balu-lab/cabs-PETFAB-Hammer-Joshua/CAD/README.md

# CAD

The full arm assembly is in [`Main ASM.step`](Main%20ASM.step), a STEP file that opens in most CAD programs (such as SolidWorks, Fusion and FreeCAD).
