balu-lab/cabs-PETFAB-Hammer-Joshua/Videos/README.md

# Videos

Full-length videos of the PETFAB Armadillo. Each one is also in this folder as a 720p MP4 you can download.

## Arm demo

<!-- VIDEO PLAYER: drag arm-demo.mp4 onto the blank line below, then delete everything from "preview start" to "preview end". -->

https://github.com/user-attachments/assets/7bf4e68b-27bd-4faf-a8a3-bc81803d2f6c

## Range of motion

<!-- VIDEO PLAYER: drag range-of-motion.mp4 onto the blank line below, then delete everything from "preview start" to "preview end". -->

https://github.com/user-attachments/assets/34a5c7e6-6257-4383-8806-d1fb65ef79a6

## Gripper prototype

<!-- VIDEO PLAYER: drag gripper-prototype.mp4 onto the blank line below, then delete everything from "preview start" to "preview end". -->

https://github.com/user-attachments/assets/6db6914c-4f08-4c4b-8c50-9afb5e042890

## Early arm prototype

<!-- VIDEO PLAYER: drag early-arm-prototype.mp4 onto the blank line below, then delete everything from "preview start" to "preview end". -->

https://github.com/user-attachments/assets/643ba2e3-5a8b-48b2-80a3-5e27d1cdb63c
