balu-lab/cabs-PETFAB-Hammer-Joshua/Photos/README.md

# Photos

Pictures of the PETFAB Armadillo: the built arm, its CAD model, early prototypes, and what its camera sees.

## The built arm

<p align="center">
  The Armadillo holding a steel tumbler in its gripper
  Moving the arm by hand to full reach
</p>
<p align="center"><em>Holding a tumbler (left) and reaching out, moved by hand (right)</em></p>

## CAD model

<p align="center">
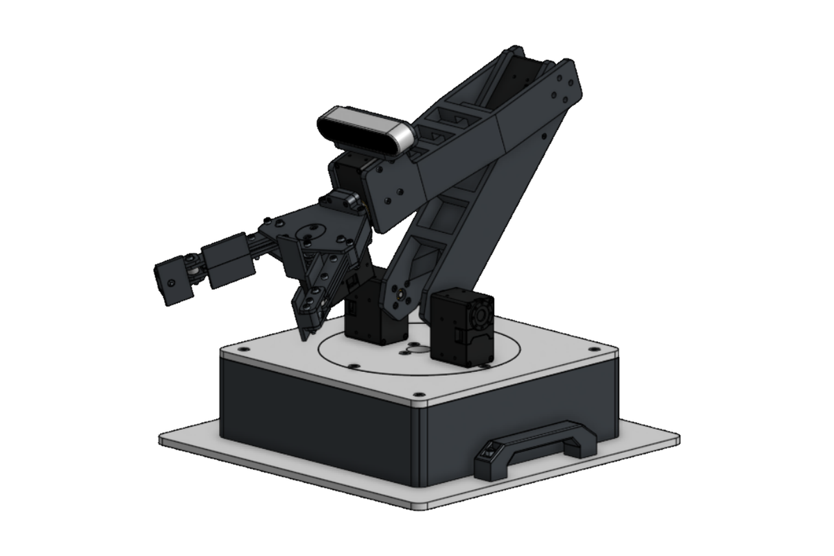
[picture p10: Photos/cad-arm-folded.png]
The complete arm in CAD, folded
  
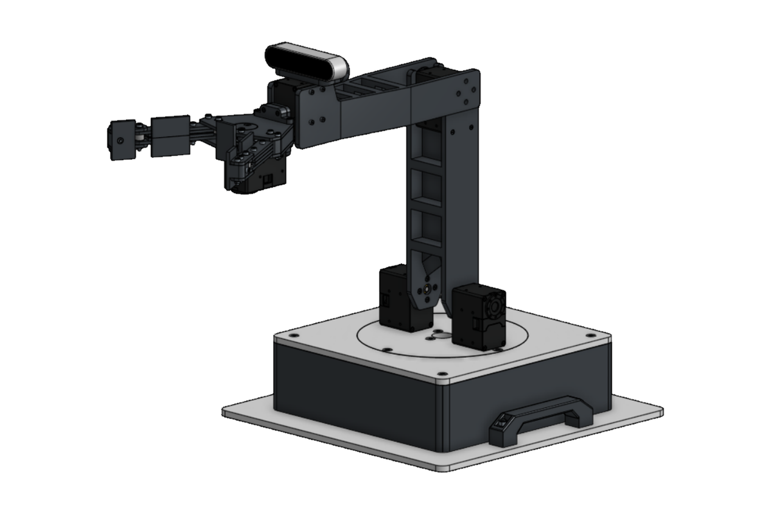
[picture p11: Photos/cad-arm-upright.png]
The complete arm in CAD, upright
  
</p>
<p align="center"><em>The complete arm, folded (left) and upright (right)</em></p>

<p align="center">
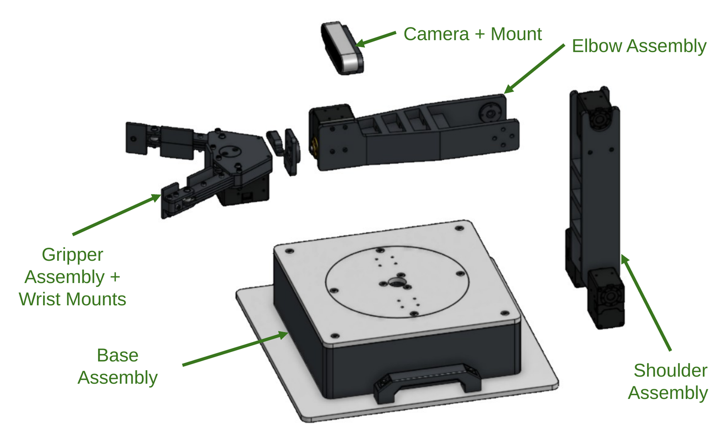
[picture p12: Photos/cad-exploded-view.png]
Exploded view of the arm's main assemblies, labeled
  
</p>
<p align="center"><em>The main assemblies. The <a href="../Assembly%20Instructions/All%20Assembly%20Instructions.pdf">assembly instructions</a> build each one step by step.</em></p>

<p align="center">
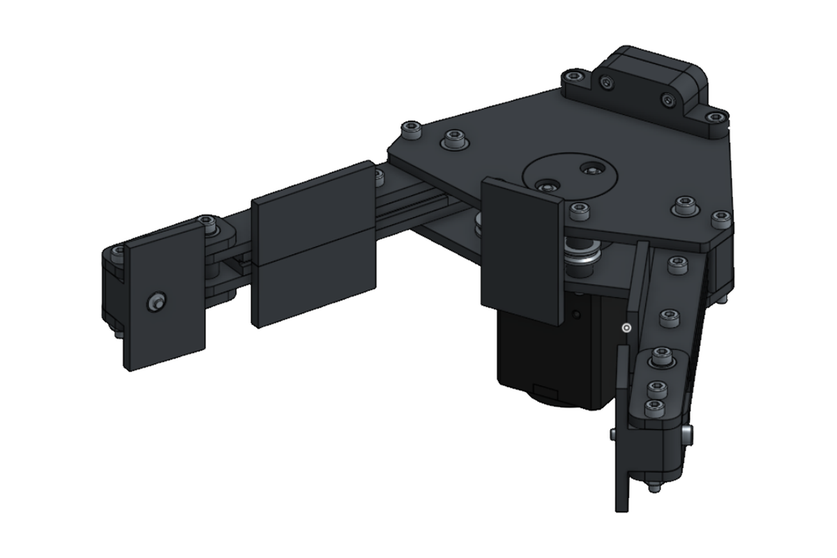
[picture p13: Photos/cad-gripper-view1.png]
The two-finger gripper in CAD, first view
  
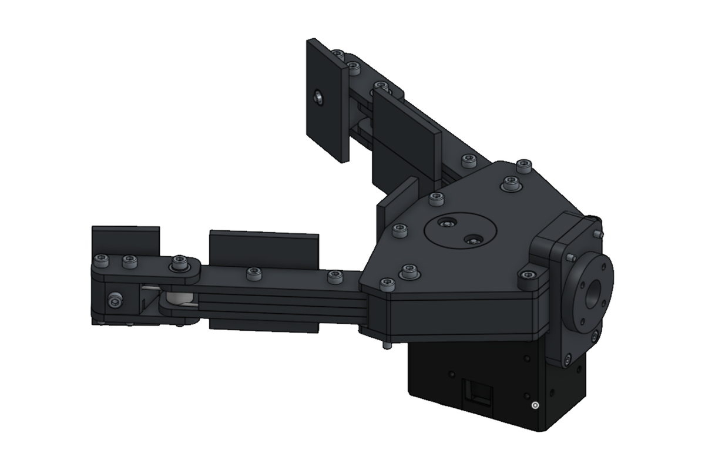
[picture p14: Photos/cad-gripper-view2.png]
The two-finger gripper in CAD, second view
  
</p>
<p align="center"><em>The underactuated two-finger gripper, from two angles</em></p>

## Prototypes

<p align="center">
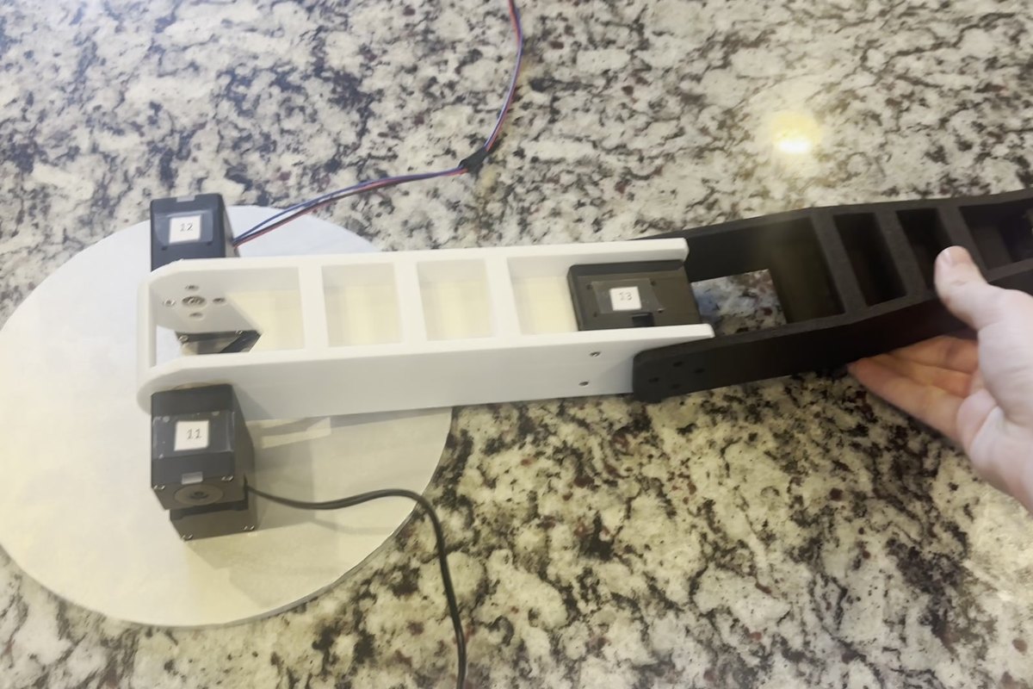
[picture p15: Photos/early-arm-prototype.jpg]
An early version of the arm with white and black printed links
  
  The gripper prototype wrapping around a mug
</p>
<p align="center"><em>An early arm prototype (left) and the gripper prototype grasping a mug (right)</em></p>

## Vision

<p align="center">
  The RealSense camera feed with YOLOv8 detecting a mouse at 0.97 confidence and 0.26 m away
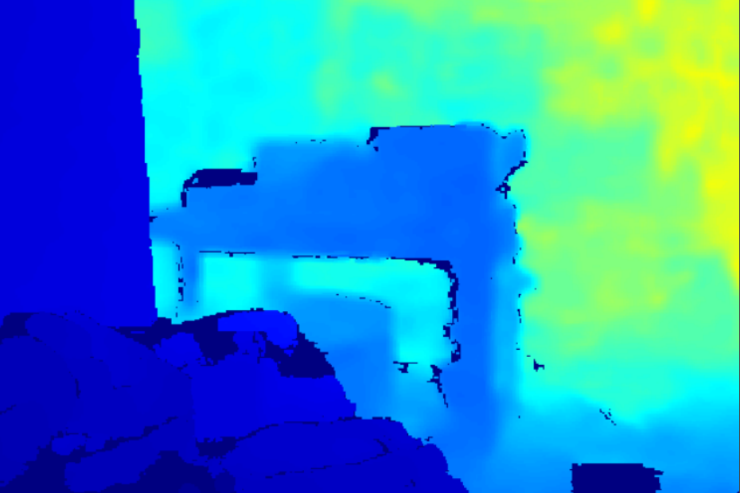
[picture p16: Photos/vision-depth-map.png]
A color-coded depth image from the RealSense camera
  
</p>
<p align="center"><em>YOLOv8 detecting a mouse 0.26 m away (left), from <a href="../Code/vision_object_detection_test.py"><code>vision_object_detection_test.py</code></a>, and a depth image from the same camera, where color shows distance (right)</em></p>
