balu-lab/cabs-PETFAB-Hammer-Joshua/Curriculum/Lesson 1/README.md

# Lesson 1: Introduction to the Robotic Arm

Students learn the parts and vocabulary of a robotic arm, what degrees of freedom are, and how to work safely around the arm. The lesson frames the whole course around three questions: how the arm knows where it is, how it knows where to go, and how it can interact with the world.

**Time:** one class period (about 60 minutes)

## Objectives

By the end of this lesson, students will be able to:

- Identify and describe the core parts of a robotic arm (actuators, links, encoders, grippers, controller, workspace)
- Define degrees of freedom (DOF) and explain why they matter for an arm's range of motion
- Describe the three questions that guide the course
- State the essential safety procedures for operating the arm

## Files

| File | What it is |
|---|---|
| [Lesson Plan 1 - Introduction to the Robotic Arm.docx](Lesson%20Plan%201%20-%20Introduction%20to%20the%20Robotic%20Arm.docx) | Lesson plan with vocabulary, timed procedures and assessment with answers |
| [Intro to Robo Arm.pdf](Intro%20to%20Robo%20Arm.pdf) | Slides (PDF) |
| [Intro to Robo Arm.pptx](Intro%20to%20Robo%20Arm.pptx) | Slides (PowerPoint, editable) |

**Next:** [Lesson 2: Building the Robotic Arm](../Lesson%202/)
