balu-lab/cabs-PETFAB-Hammer-Joshua/Curriculum/Lesson 2/README.md

# Lesson 2: Building the Robotic Arm

Students work in groups to assemble the arm they will use for the rest of the course. They build the links and joints, wire the actuators to the controller, and run a first power-on test to confirm every joint moves. The lesson also covers basic troubleshooting of common assembly mistakes.

**Time:** two class periods (about 60 minutes each)

## Objectives

By the end of this lesson, students will be able to:

- Assemble the arm's mechanical parts (links, joints, mounting hardware) by following a build guide
- Correctly wire the actuators to the controller
- Check that each joint moves correctly with a basic functional test
- Identify and fix common assembly errors (loose connections, reversed wiring, misaligned joints)

## Files

| File | What it is |
|---|---|
| [Lesson Plan 2 - Building the Robotic Arm.pdf](Lesson%20Plan%202%20-%20Building%20the%20Robotic%20Arm.pdf) | Lesson plan with timed procedures for both days and assessment with answers |
| [Lesson Plan 2 - Building the Robotic Arm.docx](Lesson%20Plan%202%20-%20Building%20the%20Robotic%20Arm.docx) | Lesson plan (Word, editable) |
| [All Assembly Instructions.pdf](../../Assembly%20Instructions/All%20Assembly%20Instructions.pdf) | Step-by-step build guide, in the Assembly Instructions folder |
| [Arm BOM.xlsx](../../BOM/Arm%20BOM.xlsx) | Parts each group needs, in the BOM folder |

Before students power on the arm, set up the actuators' IDs and baud rate as described in the main README's [Getting Started](../../README.md#getting-started) section.

**Previous:** [Lesson 1](../Lesson%201/) · **Next:** [Lesson 3: Trigonometric Approach to FK](../Lesson%203/)
