balu-lab/cabs-PETFAB-Hammer-Joshua/PETFAB-Armadillo/CAD/README.md

# CAD

Design source files for the arm will be added here.
