balu-lab/cabs-PETFAB-Hammer-Joshua/PETFAB-Armadillo/Photos/README.md

# Photos

Photos of the assembled arm and demos go here.
