balu-lab/cabs-PETFAB-Hammer-Joshua/Curriculum/Robotic Arm Lessons Overview.docx

# Course Overview: Controlling a 4-Axis Robotic Arm

## Course Description

This course introduces high school students to the mechanical, mathematical, and computational principles behind a 4-DOF robotic arm. Students begin by physically building and understanding the arm, then progress through forward kinematics (FK), inverse kinematics (IK), and computer vision.

The course is structured around three guiding questions, introduced in Lesson 1 and revisited throughout:

1. How does the arm know where it is? (Forward Kinematics)
2. How does the arm know where to go? (Inverse Kinematics)
3. How can the arm interact with the world? (Computer Vision + AI Object Detection)

## Course Structure & Pacing

The course consists of 10 lessons.

| Lesson Title | Short Description
1 | Introduction to the Robotic Arm | Vocabulary, parts, safety, industry context
2 | Building the Robotic Arm | Physical assembly, wiring, functional testing
3 | Trigonometric Approach to FK | Deriving FK for a 4 DOF arm using trig in 2d and 3d
4 | Denavit-Hartenberg Approach to FK | Forward kinematics with vectors: measure joint angles the DH way, write each link as a unit vector, turn arrows to find the forearm, and add the link vectors to find the tip in 2D and 3D.
5 | Code Implementation of FK & Other Methods | Coding forward kinematics in Python one function at a time, checking it against Lesson 3’s method, and mapping the arm’s reach
6 | Trigonometric Approach to IK | Deriving IK using the law of cosines and trigonometry
7 | Gradient Descent Approach to IK | Iterative/numerical IK methods
8 | Code Implementation of IK & Other Methods | Coding IK in Python one function at a time with Lesson 6’s trigonometry and Lesson 7’s gradient descent, checking every answer with FK, and a short preview of the Jacobian
9 | AI Object Detection | Pretrained object detection models, bounding boxes, turning the base toward a target
10 | Stereoscopic Camera | Depth perception via disparity, camera calibration, 3D target points for the arm

## Course-Wide Learning Goals

By the end of the course, students will be able to:

- Explain and apply both trigonometric and systematic (DH) methods for forward kinematics
- Explain and apply both geometric and iterative methods for inverse kinematics
- Implement FK and IK algorithms in code and validate them against hand calculations
- Explain how stereoscopic vision and AI object detection allow a robot to perceive its environment
- Evaluate trade-offs between competing engineering approaches (e.g., DOF, method complexity vs. accessibility, cost vs. precision)

## Standards Alignment (Course-Wide)

This course is primarily an applied engineering/math/CS course. NGSS connections are grouped below by strength Core connections apply clearly across most lessons.

Core NGSS Engineering Design Standards:

- HS-ETS1-1 — Analyze a major global/complex problem by specifying qualitative and quantitative criteria and constraints for successful solutions
- HS-ETS1-2 — Design a solution to a complex real-world problem by breaking it down into smaller, more manageable problems
- HS-ETS1-3 — Evaluate a solution based on prioritized criteria and trade-offs that account for constraints including cost, safety, reliability, and performance
- HS-ETS1-4 — Use a computer simulation/model to model the impact of proposed solutions to a complex real-world problem

Core NGSS Crosscutting Concepts:

- Systems and System Models — the arm treated as an interdependent system throughout (mechanical → mathematical → perceptual)
- Structure and Function — how a component's physical structure (a joint, a link, a gripper's finger geometry) determines what it can do; especially relevant in Lessons 1, 2, and 5
- Patterns — recognizing recurring angle/position relationships in FK/IK (Lessons 3–8) and recurring visual patterns in object detection (Lessons 9–10)

Core NGSS Science & Engineering Practices:

- Developing and Using Models — physical diagrams, mathematical FK/IK models, and code implementations
- Using Mathematics and Computational Thinking — the throughline connecting the trig, DH, and coding lessons
- Constructing Explanations and Designing Solutions — especially prominent in the coding lessons
- Planning and Carrying Out Investigations — the build lesson, calibration steps, and testing/debugging labs throughout
- Analyzing and Interpreting Data — object detection confidence scores, disparity maps, and testing measured vs. predicted arm positions
- Asking Questions and Defining Problems — Lesson 1's framing of the course around three guiding questions
- Engaging in Argument from Evidence — the recurring "compare methods and their trade-offs" discussions (Lessons 4, 5, 7, 8)
- Obtaining, Evaluating, and Communicating Information — the industry survey in Lesson 1

See individual lesson plans for lesson-specific standards citations.

## Materials & Equipment Needed

- One 4-DOF robotic arm kit per group (unassembled, for Lesson 2's build)
- Controller board, servos/actuators, and wiring components
- Computers with Python, numpy, and relevant vision/ML libraries installed
- Stereo camera rig (one per group or shared lab stations)
- Basic tools (screwdrivers/hex keys), measuring tools, calculators
- Target objects for practice

## Assessment Approach

Each lesson includes a short formative assessment (multiple choice, short answer, or exit ticket) tied directly to that lesson's objectives. Lessons involving code (5 and 8) are assessed primarily through working implementations validated against known test cases.

## Course Progression Logic

The course is intentionally sequenced so each new concept has an immediate, concrete anchor:

- Lessons 1–2 ground students physically in the hardware and concepts before any math is introduced
- Lessons 3–5 build FK from simple (trig) to systematic (DH) to implemented (code), with each method validated against the previous
- Lessons 6–8 repeat the same progression in forward kinematics for inverse kinematics
- Lessons 9–10 build the perception pipeline in two pieces (detection → depth)

## Course Prerequisites

- Math 3/Geometry at a high school level (honors level completion recommended)
- Completion of a python course at an intermediate level
