balu-lab/cabs-PETFAB-Hammer-Joshua/Curriculum/Lesson 6/Lesson_6_Trigonometric_Approach_to_IK.pptx

The Trigonometric Approach to Inverse Kinematics

Robotic Arm Course · Lesson 6

Day 1: The flat arm with triangles
Day 2: Adding the base turn (3D)

## Slide 2

Where Lesson 5 left off:

Forward kinematics (FK):
angles in, tip position out.
tip_3d(45, 45, -45)
gives [301.78, 301.78, 176.78]
Today we go the other way.
We know where the tip should go.
We find the angles.

z

(301.78, 301.78, 176.78)

y

x

## Slide 3

Forward vs. inverse kinematics:

Forward kinematics (FK)
angles → tip position
Always exactly one answer.
Lessons 3, 4 and 5.

Inverse kinematics (IK)
tip position → angles
There can be no answer, one or two.
Lessons 6, 7 and 8.

A robot is told a target, like “pick up the cup at (x, y, z)”. Its motors need angles, not positions. IK is the step that turns the target into angles.
Lesson 3 used triangles to go forward. Today we use the same triangles backwards.

## Slide 4

The IK problem (flat arm):

We know:
L1 = L2 = 250 mm
the target (X, Y)
We want:
θS and θE
We solve the flat arm first. On Day 2 we add the base turn.

θE = ?

target (X, Y)

θS = ?

## Slide 5

The law of cosines:

For any triangle with sides a, b and c, where C is the angle opposite side c:
c² = a² + b² − 2ab cos C
Solve it for the angle:
cos C = (a² + b² − c²) ÷ (2ab)
Use it when you know all three sides and want an angle.
If C = 90°, then cos C = 0 and it becomes the Pythagorean theorem: c² = a² + b².

a

c

C

b

## Slide 6

Worked example: the law of cosines

A triangle has a = 250, b = 250 and c = 300.
Find the angle C.
cos C = (250² + 250² − 300²) ÷ (2 × 250 × 250)
= (125,000 − 90,000) ÷ 125,000
= 0.28
C = cos⁻¹(0.28) = 73.74°
cos⁻¹ is the inverse cosine key (also called arccos). Set your calculator to degrees.

250

300

C = ?

250

## Slide 7

Try it yourself #1:

Find the angle C opposite side c. In both triangles a = b = 250.

(a) c = 250

(b) c = 400

c

c

C

C

## Slide 8

Try it yourself #1: solution

Find the angle C opposite side c. In both triangles a = b = 250.

(a) c = 250

(b) c = 400

c

c

C

C

cos C = (125,000 − 62,500) ÷ 125,000
= 0.5
C = cos⁻¹(0.5) = 60°

cos C = (125,000 − 160,000) ÷ 125,000
= −0.28
C = cos⁻¹(−0.28) = 106.26°

A negative cosine means the angle is bigger than 90°.

## Slide 9

The arm makes a triangle:

Draw a straight line D from the shoulder to the target.
The two links and D make a triangle. We know all three sides:
L1 = 250 and L2 = 250
D = √(X² + Y²) (Pythagorean theorem)
So the law of cosines can find the angles of this triangle. They give us the joint angles.

L2

target (X, Y)

L1

D

Y

X

## Slide 10

Step 1: the elbow angle θE

The law of cosines gives γ, the angle inside the triangle at the elbow:
cos γ = (L1² + L2² − D²) ÷ (2 L1 L2)
θE is the bend away from a straight arm, so its size is 180° − γ. Because cos(180° − γ) = −cos γ:
cos θE = (D² − L1² − L2²) ÷ (2 L1 L2)
Check: a straight arm has D = 500, so cos θE = 1 and θE = 0°.
Our forearm bends down (elbow up), so θE is negative.

θE

γ

D

## Slide 11

Worked example: the elbow

Target (X, Y) = (426.78, 176.78), the tip from Lesson 4.
D² = 426.78² + 176.78² = 213,392
(so D = 461.94)
cos θE = (213,392 − 62,500 − 62,500) ÷ 125,000
= 0.7071
cos⁻¹(0.7071) = 45°. Elbow up, so θE = −45°

θE = −45°

D = 461.94

## Slide 12

Step 2: the shoulder angle θS

θS is measured from the floor. It is made of two angles.
φ is the tilt of the line D:
φ = tan⁻¹(Y ÷ X)
δ is the angle between D and the upper arm (the law of cosines again):
cos δ = (L1² + D² − L2²) ÷ (2 L1 D)
Our arm has L1 = L2, so this is just cos δ = D ÷ 500.
Elbow up: the upper arm is above D, so θS = φ + δ

δ

D

φ

## Slide 13

Worked example: the shoulder

Same target (426.78, 176.78), with D = 461.94.
φ = tan⁻¹(176.78 ÷ 426.78) = 22.5°
cos δ = (62,500 + 213,392 − 62,500) ÷ (2 × 250 × 461.94)
= 213,392 ÷ 230,970 = 0.9239
(the same as 461.94 ÷ 500)
δ = cos⁻¹(0.9239) = 22.5°
θS = 22.5° + 22.5° = 45°

δ

φ

## Slide 14

The answer:

IK found θS = 45° and θE = −45°.
These are the angles Lesson 4 started with.
Check with FK (Lesson 5):

Step | Value
D | 461.94
cos θE | 0.7071
θE | −45°
φ | 22.5°
δ | 22.5°
θS | 45°

show(flat_tip(45, -45))

[426.78, 176.78]

FK lands back on the target, so the angles are right.

## Slide 15

Try it yourself #2:

Find θS and θE (elbow up) for the target (341.51, 341.51). L1 = L2 = 250 mm.

## Slide 16

Try it yourself #2: solution

Find θS and θE (elbow up) for the target (341.51, 341.51). L1 = L2 = 250 mm.

D² = 341.51² + 341.51² = 233,258 (D = 482.97)
cos θE = (233,258 − 125,000) ÷ 125,000 = 0.8661
→ θE = −30°
φ = tan⁻¹(341.51 ÷ 341.51) = 45°
cos δ = 482.97 ÷ 500 = 0.9659 → δ = 15°
→ θS = 45° + 15° = 60°

This is Lesson 4’s Try it yourself #2 run backwards. Check: flat_tip(60, -30) gives [341.51, 341.51].

## Slide 17

Try it yourself #3:

Find θS and θE (elbow up) for the target (250, 250). L1 = L2 = 250 mm.

## Slide 18

Try it yourself #3: solution

Find θS and θE (elbow up) for the target (250, 250). L1 = L2 = 250 mm.

D² = 250² + 250² = 125,000 (D = 353.55)
cos θE = (125,000 − 125,000) ÷ 125,000 = 0
→ θE = −90°
φ = tan⁻¹(250 ÷ 250) = 45°
cos δ = 353.55 ÷ 500 = 0.7071 → δ = 45°
→ θS = 45° + 45° = 90°

The upper arm points straight up and the forearm points straight across. Check: flat_tip(90, -90) gives [250.0, 250.0].

## Slide 19

Elbow up or elbow down:

cos⁻¹ only gives a positive angle (here 45°). We choose the sign of θE.
Elbow up: θE = −45° and θS = φ + δ = 45°
Elbow down: θE = +45° and θS = φ − δ = 0°
Both put the tip on (426.78, 176.78).
In this course we use elbow up. Check the real arm’s joint limits before you use elbow down.

elbow up

elbow down

## Slide 20

Can the arm reach it?

A triangle can only close if D ≤ L1 + L2 = 500 mm.
If D is bigger, cos θE comes out bigger than 1, and cos⁻¹ gives an error. No angle has a cosine bigger than 1.
So always check cos θE first:
between −1 and 1: the target is reachable.
anything else: the target is out of reach, and the robot must not move.

500 mm

too far

reachable

## Slide 21

Day 1 recap:

1. Triangle: the two links and the line D, with D = √(X² + Y²).
2. Elbow: cos θE = (D² − L1² − L2²) ÷ (2 L1 L2). Elbow up, so θE is negative.
3. Shoulder: θS = φ + δ, with φ = tan⁻¹(Y ÷ X) and cos δ = (L1² + D² − L2²) ÷ (2 L1 D).
4. Checks: cos θE must be between −1 and 1. Then check the answer with FK.
Tomorrow the base turns too, so we need 3D.

## Slide 22

Day 2: where Day 1 left off

1. What is θE for a straight arm?
2. What is the largest D the arm can reach?
3. What is the sign of θE for elbow up?

D

## Slide 23

Step 1: the base aims the arm

Look from above. The base turns until the arm points at the target’s (x, y) spot.
In Lesson 4: x = R cos θB and y = R sin θB.
Divide: y ÷ x = tan θB, so
θB = tan⁻¹(y ÷ x)
Target (301.78, 301.78, 176.78):
θB = tan⁻¹(301.78 ÷ 301.78) = tan⁻¹(1) = 45°
Careful: plain tan⁻¹ can point the wrong way. See “Why atan2?”.

y

top view

y

R

θB

x

x

## Slide 24

Step 2: flatten 3D into 2D

The arm always stays in one upright plane: the plane the base points at.
Measure the target inside that plane:
how far out: R = √(x² + y²)
how high: z
Then (R, z) plays the role of (X, Y) from Day 1. The elbow and shoulder steps do not change.

z

z

y

x

R

## Slide 25

Why atan2?

Try the spot (x, y) = (−125, 216.51).
tan⁻¹(216.51 ÷ −125) = tan⁻¹(−1.732) = −60°.
That points the wrong way!
y ÷ x is the same for (−125, 216.51) and (125, −216.51), so tan⁻¹ cannot tell them apart.
atan2(y, x) looks at the signs of both y and x, so it picks the right one:
atan2(216.51, −125) = 120°
In Python: math.degrees(math.atan2(y, x))

(−125, 216.51)

y

120°

x

−60° (wrong)

## Slide 26

The full recipe:

1. Aim the base: θB = atan2(y, x)
2. Flatten: R = √(x² + y²), then D² = R² + z²
3. Elbow: cos θE = (D² − L1² − L2²) ÷ (2 L1 L2)
Check that cos θE is between −1 and 1. Elbow up, so θE is negative.
4. Shoulder: φ = tan⁻¹(z ÷ R) and cos δ = (L1² + D² − L2²) ÷ (2 L1 D)
θS = φ + δ
Four steps, a few formulas, and an exact answer. No guessing.

## Slide 27

Worked example:

Find θB, θS and θE for the target (301.78, 301.78, 176.78), the tip from Lesson 4.
1. θB = atan2(301.78, 301.78) = 45°
2. R = √(301.78² + 301.78²) = 426.78
z = 176.78
Now it is the flat arm with target (426.78, 176.78): Day 1’s worked example!
3. θE = −45°
4. θS = 45°

z

θB

z

y

x

R

## Slide 28

Check it with FK:

target
(301.78, 301.78, 176.78)

IK
θB, θS, θE = 45°, 45°, −45°

FK
(301.78, 301.78, 176.78)

Put the IK angles back into FK. If the tip lands on the target, the angles are right.
Three ways to do FK:
1. Lesson 4’s link table, by hand.
2. The Desmos graph from Lesson 4: u = 45, v = 45, w = −45 gives d = (3.0178, 3.0178, 1.7678), so (301.78, 301.78, 176.78) mm.
3. Lesson 5’s code: show(tip_3d(45, 45, -45)) prints [301.78, 301.78, 176.78].
Make it a habit: always check IK with FK.

## Slide 29

Try it yourself #4:

Find θB, θS and θE (elbow up) for the target (295.75, 170.75, 91.51).

Use the four-step recipe. Hint: this tip came from Lesson 4’s Try it yourself #5.

## Slide 30

Try it yourself #4: solution

Find θB, θS and θE (elbow up) for the target (295.75, 170.75, 91.51).

1. θB = atan2(170.75, 295.75) = 30°
2. R = √(295.75² + 170.75²) = 341.50 and z = 91.51
D² = 341.50² + 91.51² ≈ 125,000 (D = 353.55)
3. cos θE = (125,000 − 125,000) ÷ 125,000 = 0 → θE = −90°
4. φ = tan⁻¹(91.51 ÷ 341.50) = 15°, cos δ = 353.55 ÷ 500 = 0.7071 → δ = 45°
→ θS = 15° + 45° = 60°

Lesson 4’s Try it yourself #5 run backwards: (30°, 60°, −90°). Check: show(tip_3d(30, 60, -90)) gives [295.75, 170.75, 91.51].

## Slide 31

Try it yourself #5:

Find θB, θS and θE (elbow up) for the target (−324.76, 187.50, 216.51).

Careful with θB: x is negative.

## Slide 32

Try it yourself #5: solution

Find θB, θS and θE (elbow up) for the target (−324.76, 187.50, 216.51).

1. θB = atan2(187.50, −324.76) = 150° (plain tan⁻¹ says −30°)
2. R = √(324.76² + 187.50²) = 375.00 and z = 216.51
D² = 375.00² + 216.51² = 187,502 (D = 433.01)
3. cos θE = (187,502 − 125,000) ÷ 125,000 = 0.5 → θE = −60°
4. φ = tan⁻¹(216.51 ÷ 375.00) = 30°, cos δ = 433.01 ÷ 500 = 0.8660 → δ = 30°
→ θS = 30° + 30° = 60°

Check: show(tip_3d(150, 60, -60)) gives [-324.76, 187.5, 216.51].

## Slide 33

Try it yourself #6: can the arm reach it?

Find D = √(x² + y² + z²) for each target and compare it with 500 mm.
(a) (200, 200, 200) (b) (400, 300, 200)

## Slide 34

Try it yourself #6: solution

Find D = √(x² + y² + z²) for each target and compare it with 500 mm.
(a) (200, 200, 200) (b) (400, 300, 200)

(a) D = √(40,000 + 40,000 + 40,000) = 346.41 mm. Less than 500: reachable.
(cos θE = −0.04)
(b) D = √(160,000 + 90,000 + 40,000) = 538.52 mm. More than 500: out of reach.
cos θE = 1.32, which is impossible.
For (b) the robot should report an error instead of moving.

## Slide 35

When IK gets tricky:

Case | Answers | Why
D > 500 mm | none | the triangle cannot close
D = 500 mm | one | the arm is fully straight, θE = 0°
D < 500 mm | two | elbow up or elbow down
x = y = 0 | infinitely many | the target is right above the base, so any θB works

FK always gives exactly one answer. IK can give none, one, two or infinitely many.
Near full reach, rounding matters: (433.01, 250.00) is really a straight arm, but the rounded numbers give θE = −0.35°, not 0°. If rounding pushes the cosine just above 1 (like 1.001), treat it as 1. The arm is straight, not out of reach.

## Slide 36

Trigonometry for IK: pros and cons

Pros
+ An exact answer from a few formulas
+ Fast: nothing repeats
+ Easy to check with FK

Cons
− New triangles for every new joint
− Special cases: quadrants, reach, two answers
− Only works if the arm can be drawn as triangles

If the arm had six joints, which method would you use for IK? Why?
Trigonometry is a great fit for our arm. Bigger arms need a method that does not depend on drawing triangles.

## Slide 37

What we learned:

1. IK goes from a target to the joint angles. It can have no answer, one or two.
2. The arm makes a triangle, so the law of cosines gives θE and δ.
3. θB = atan2(y, x), and R = √(x² + y²) flattens 3D into 2D.
4. θS = φ + δ (elbow up). Always check the answer with FK.
Next time (Lesson 7): gradient descent, a method that works for any arm. It guesses, measures the error and improves.
