balu-lab/cabs-PETFAB-Hammer-Joshua/Curriculum/Lesson 4/Updated_Lesson_4_Vector_Approach_to_FK.pptx

The DH Approach to Forward Kinematics

Robotic Arm Course · Lesson 4 of 10

Day 1: The flat arm with vectors
Day 2: Adding the base turn (3D)

## Slide 2

Where Lesson 3 left off:

L1=250mm
L2=250mm
θ1=45°
θ2=45°

In Lesson 3 we used triangles to find the tip of the arm: (X, Y) = (426.78, 176.78).
Today we get the same answer with vectors. We also measure the angles the way engineers do. This is called the DH convention.

tip (X, Y)

(0, 0)

## Slide 3

What is a vector?

A vector is an arrow.
It has a length and a direction.
We write a vector as numbers.
(3, 4) means 3 across and 4 up.

length = √(3² + 4²) = 5

3 across

(3, 4)

4 up

## Slide 4

Adding vectors:

Walk (3, 4).
Then walk (2, −1).
You end up at the sum:
(3, 4) + (2, −1) = (5, 3)
Add the first numbers. Then add the second numbers.
Multiply by a number:
2 × (3, 4) = (6, 8)
Same direction, twice as long.

(2, −1)

(3, 4)

(5, 3)

## Slide 5

Measuring angles the DH way:

Each angle is measured from the link before it.
Up (counterclockwise) is +.
Down (clockwise) is −.
θS: the upper arm, measured from the floor.
θE: the forearm, measured from the line of the upper arm (dashed).
Our arm: θS = 45° and θE = −45°

θE = −45°

θS = 45°

From Lesson 3: θS = 90° − θ1, θE = −θ2, θB = θ3

## Slide 6

An arrow for each link:

A unit vector is an arrow with length 1.
At angle θ from the floor, it is
(cos θ, sin θ)
Multiply it by the link length L to get the link vector.
Upper arm, θS = 45°:
250 × (0.7071, 0.7071)
= (176.78, 176.78)

(cos θ, sin θ)

1

θ

sin θ

cos θ

## Slide 7

Try it yourself #1: find the link vector.

1. L=250mm
θ=30°

2. L=250mm
θ=90°

θ is measured from the floor.

(?, ?)

(?, ?)

θ=90°

θ=30°

1

2

## Slide 8

Try it yourself #1: solution

1. L=250mm
θ=30°

2. L=250mm
θ=90°

(0.00, 250.00)

(216.51, 125.00)

Solution:

1. 250 × (cos 30°, sin 30°)
2. 250 × (cos 90°, sin 90°)

θ=90°

θ=30°

1

2

## Slide 9

Turning an arrow 90°:

To turn an arrow 90° counterclockwise, swap the two numbers. Then change the sign of the first one.
(x, y) → (−y, x)
Example: (3, 4) → (−4, 3)
The upper arm: e = (0.7071, 0.7071)
turns into n = (−0.7071, 0.7071)
e and n are at right angles. Together they are the upper arm’s frame.

(3, 4)

(−4, 3)

## Slide 10

Finding the forearm’s arrow:

y

On the unit circle, an arrow at angle θ is:
cos θ along x, then sin θ along y.
The forearm’s angle θE is measured from the upper arm, not from the floor. So at the elbow, tilt the axes:
e (along the upper arm) is the new x
n (e turned 90°) is the new y
Use the same rule on the tilted axes:
f = cos θE · e + sin θE · n
cos θE along e, then sin θE along n.

The unit circle

cos θ

sin θ

θ

x

n

f

e

θE

At the elbow: tilted with the upper arm

## Slide 11

The forearm turns from the upper arm:

f is the forearm’s arrow.
It is e turned by θE:
f = cos θE · e + sin θE · n
θE = 0°: f = e (no turn)
θE = 90°: f = n (a quarter turn up)
θE = −90°: f = −n (a quarter turn down)
The forearm only needs the upper arm’s frame. That is the DH idea.

n

e

θE = −45°

f

## Slide 12

Worked example: the forearm’s arrow

θS = 45° and θE = −45°
e = (cos 45°, sin 45°) = (0.7071, 0.7071)
n = (−0.7071, 0.7071)
cos(−45°) = 0.7071 and sin(−45°) = −0.7071
f = 0.7071 × (0.7071, 0.7071) + (−0.7071) × (−0.7071, 0.7071)
= (0.5000, 0.5000) + (0.5000, −0.5000)
= (1.0000, 0.0000)
The forearm is flat. Check: 45° + (−45°) = 0° from the floor.

n

e

f

0.7071 along e, then 0.7071 away from n

## Slide 13

Two vectors, one tip:

Upper arm:
a = 250 × e = (176.78, 176.78)
Forearm:
b = 250 × f = (250.00, 0.00)
Put the arrows end to end:
a + b = (426.78, 176.78)
The same answer as Lesson 3.

b

a

a + b

## Slide 14

The link table:

Link | L (mm) | angle | arrow | vector = L × arrow
Upper arm (e) | 250 | θS = 45° | (0.7071, 0.7071) | (176.78, 176.78)
Turned 90° (n) | | | (−0.7071, 0.7071) | —
Forearm (f) | 250 | θE = −45° | (1.0000, 0.0000) | (250.00, 0.00)
Tip (add) | | | | (426.78, 176.78)

e = (cos θS, sin θS) n = (−sin θS, cos θS) f = cos θE · e + sin θE · n
Keep all the digits in your calculator. Round only at the end.

## Slide 15

Try it yourself #2:

L1 = L2 = 250mm θS = 60° θE = −30°

Link | L (mm) | angle | arrow | vector = L × arrow
Upper arm (e) | 250
Turned 90° (n) | | | | —
Forearm (f) | 250
Tip (add)

(X, Y) = (?, ?)

Fill in the table, one row at a time.

In Lesson 3 this arm was θ1 = 30° and θ2 = 30°.

## Slide 16

Try it yourself #2: solution

L1 = L2 = 250mm θS = 60° θE = −30°

Link | L (mm) | angle | arrow | vector = L × arrow
Upper arm (e) | 250 | θS = 60° | (0.5000, 0.8660) | (125.00, 216.51)
Turned 90° (n) | | | (−0.8660, 0.5000) | —
Forearm (f) | 250 | θE = −30° | (0.8660, 0.5000) | (216.51, 125.00)
Tip (add) | | | | (341.51, 341.51)

(X, Y) = (341.51, 341.51)

f = cos(−30°) e + sin(−30°) n
= 0.8660 e − 0.5000 n

In Lesson 3 this arm was θ1 = 30° and θ2 = 30°.

## Slide 17

Try it yourself #3:

L1 = L2 = 250mm θS = 30° θE = 0°

Link | L (mm) | angle | arrow | vector = L × arrow
Upper arm (e) | 250
Turned 90° (n) | | | | —
Forearm (f) | 250
Tip (add)

(X, Y) = (?, ?)

Fill in the table, one row at a time.
Use the rules on the link table slide.

In Lesson 3 this arm was θ1 = 60° and θ2 = 0°.

## Slide 18

Try it yourself #3: solution

L1 = L2 = 250mm θS = 30° θE = 0°

Link | L (mm) | angle | arrow | vector = L × arrow
Upper arm (e) | 250 | θS = 30° | (0.8660, 0.5000) | (216.51, 125.00)
Turned 90° (n) | | | (−0.5000, 0.8660) | —
Forearm (f) | 250 | θE = 0° | (0.8660, 0.5000) | (216.51, 125.00)
Tip (add) | | | | (433.01, 250.00)

(X, Y) = (433.01, 250.00)

θE = 0°, so f = e.
The arm is straight.

In Lesson 3 this arm was θ1 = 60° and θ2 = 0°.

## Slide 19

Day 1 recap:

Each angle is measured from the link before it. Up is +. Down is −.
A link’s arrow: (cos θ, sin θ)
Turn 90°: (x, y) → (−y, x)
The forearm’s arrow: f = cos θE · e + sin θE · n
The tip is the sum of the link vectors.

b

a

## Slide 20

Day 2

On Day 1 the tip was (across, up). For our arm it was (426.78, 176.78).
Today the base turns, so “across” can point any way on the floor. We give the two numbers new names:
the reach, R = 426.78 (along the floor)
the height, z = 176.78 (up)
From now on, up is z, like in Desmos. (Lesson 3 called it Y.)

z

tip

z

R

y

x

## Slide 21

The base turns the whole arm:

The base turns the arm by θB.
The arm’s shadow on the floor is the reach, R.
Split the shadow along x and y:
x = R cos θB
y = R sin θB
The height z does not change.

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
## Slide 22

The upper arm’s arrow in 3D:

Step 1. From the side, e looks like Day 1: length 1, at angle θS.
along the floor: cos θS
up: sin θS
Step 2. From above, the floor part points at angle θB. Split it like R on the last slide:
x = cos θS cos θB
y = cos θS sin θB
Step 3. Turning the base does not change the height:
z = sin θS

So e = (cos θS cos θB, cos θS sin θB, sin θS)
In the Desmos graph, e is (a, b, c).

z

θS

cos θS

e

sin θS

θB

y

x

## Slide 23

The turned arrow in 3D:

Step 1. From the side, turn e by 90° with the Day 1 rule (x, y) → (−y, x):
(cos θS, sin θS) → (−sin θS, cos θS)
So n goes −sin θS along the floor (back toward the base) and cos θS up.
Step 2. From above, split the floor part with θB, the same as for e:
x = −sin θS cos θB
y = −sin θS sin θB
Step 3. The up part stays:
z = cos θS

So n = (−sin θS cos θB, −sin θS sin θB, cos θS)
Check: it is e with θS + 90° in place of θS.

z

n

e

θS

x

y

e, n and the elbow’s axle make the upper arm’s frame.

## Slide 24

The forearm and the tip in 3D:

The same rules as Day 1:
f = cos θE · e + sin θE · n
tip = L1 e + L2 f
The base angle is already inside e and n. So we do not need a new rule.

z

n

e

tip

f

y

x

## Slide 25

Worked example: set up

L1 = L2 = 250mm θB = 45° θS = 45° θE = −45°

Link | L (mm) | angle | arrow (x, y, z) | vector (x, y, z)
Upper arm (e) | 250 | θS = 45° | (0.5000, 0.5000, 0.7071) | (125.00, 125.00, 176.78)
Turned 90° (n) | | | (−0.5000, −0.5000, 0.7071) | —
Forearm (f) | 250 | θE = −45°
Tip (add)

e = (cos 45° cos 45°, cos 45° sin 45°, sin 45°) = (0.5000, 0.5000, 0.7071)
n = (−sin 45° cos 45°, −sin 45° sin 45°, cos 45°) = (−0.5000, −0.5000, 0.7071)
Upper arm vector = 250 × e = (125.00, 125.00, 176.78)

## Slide 26

Worked example: adding up

L1 = L2 = 250mm θB = 45° θS = 45° θE = −45°

Link | L (mm) | angle | arrow (x, y, z) | vector (x, y, z)
Upper arm (e) | 250 | θS = 45° | (0.5000, 0.5000, 0.7071) | (125.00, 125.00, 176.78)
Turned 90° (n) | | | (−0.5000, −0.5000, 0.7071) | —
Forearm (f) | 250 | θE = −45° | (0.7071, 0.7071, 0.0000) | (176.78, 176.78, 0.00)
Tip (add) | | | | (301.78, 301.78, 176.78)

f = cos(−45°) e + sin(−45°) n = 0.7071 e − 0.7071 n
= (0.3536, 0.3536, 0.5000) + (0.3536, 0.3536, −0.5000) = (0.7071, 0.7071, 0.0000)
Forearm vector = 250 × f = (176.78, 176.78, 0.00)
Tip: add the vector column. (301.78, 301.78, 176.78)

## Slide 27

Try it yourself #4:

L1 = L2 = 250mm θB = 30° θS = 30° θE = 0°

Link | L (mm) | angle | arrow (x, y, z) | vector (x, y, z)
Upper arm (e) | 250
Turned 90° (n) | | | | —
Forearm (f) | 250
Tip (add)

(x, y, z) = (?, ?, ?)

Fill in the table, one row at a time.

In Lesson 3 this arm was θ1 = 60°, θ2 = 0°, θ3 = 30°.

## Slide 28

Try it yourself #4: solution

L1 = L2 = 250mm θB = 30° θS = 30° θE = 0°

Link | L (mm) | angle | arrow (x, y, z) | vector (x, y, z)
Upper arm (e) | 250 | θS = 30° | (0.7500, 0.4330, 0.5000) | (187.50, 108.25, 125.00)
Turned 90° (n) | | | (−0.4330, −0.2500, 0.8660) | —
Forearm (f) | 250 | θE = 0° | (0.7500, 0.4330, 0.5000) | (187.50, 108.25, 125.00)
Tip (add) | | | | (375.00, 216.51, 250.00)

(x, y, z) = (375.00, 216.51, 250.00)

θE = 0°, so f = e. The arm is straight.

In Lesson 3 this arm was θ1 = 60°, θ2 = 0°, θ3 = 30°.

## Slide 29

Try it yourself #5:

L1 = L2 = 250mm θB = 30° θS = 60° θE = −90°

Link | L (mm) | angle | arrow (x, y, z) | vector (x, y, z)
Upper arm (e) | 250
Turned 90° (n) | | | | —
Forearm (f) | 250
Tip (add)

(x, y, z) = (?, ?, ?)

Fill in the table, one row at a time.

This is Practice Problem 2 from Lesson 3: θ1 = 30°, θ2 = 90°, θ3 = 30°.

## Slide 30

Try it yourself #5: solution

L1 = L2 = 250mm θB = 30° θS = 60° θE = −90°

Link | L (mm) | angle | arrow (x, y, z) | vector (x, y, z)
Upper arm (e) | 250 | θS = 60° | (0.4330, 0.2500, 0.8660) | (108.25, 62.50, 216.51)
Turned 90° (n) | | | (−0.7500, −0.4330, 0.5000) | —
Forearm (f) | 250 | θE = −90° | (0.7500, 0.4330, −0.5000) | (187.50, 108.25, −125.00)
Tip (add) | | | | (295.75, 170.75, 91.51)

(x, y, z) = (295.75, 170.75, 91.51)

θE = −90°, so f = −n. The forearm points down: 60° − 90° = −30° from the floor.
Lesson 3 wrote the answer as (X, Y, Z) = (295.75, 91.51, 170.75), with Y up.

This is Practice Problem 2 from Lesson 3: θ1 = 30°, θ2 = 90°, θ3 = 30°.

## Slide 31

Check it in Desmos:

1. Open the Desmos graph (link below).
2. Type the angles into u, v and w.
3. Read d, then multiply it by 100 to get mm.
(The graph uses 2.5 for 250mm.)
4. Worked example: d = (3.0178, 3.0178, 1.7678)
→ (301.78, 301.78, 176.78)
5. Check Try it yourself #4 and #5.
6. To see the frames, click the gray circles
in the Vectors folder.

https://www.desmos.com/3d/qq1w1zrs78

u = θB (base)
v = θS (shoulder)
w = θE (elbow)
All in degrees.
v must be less than 90°.

## Slide 32

What the graph does:

In the graph | In our steps
a = cos(v) cos(u), b = cos(v) sin(u), c = sin(v) | (a, b, c) is e, the upper arm’s arrow
(−ac, −bc, a² + b²) ÷ √(1 − c²) | n, the turned arrow
cos(w) (a, b, c) + sin(w) × that arrow | f, the forearm’s arrow
d = 2.5 × (forearm arrow) + 2.5 (a, b, c) | tip = L1 e + L2 f, in hundreds of mm
(b, −a, 0) ÷ √(1 − c²) (hidden) | the elbow’s axle

Each link is one vector, and each joint is measured from the link before it.

## Slide 33

What we learned:

Each joint angle is measured from the link before it.
A link’s arrow is (cos θ, sin θ). In 3D it is (cos θS cos θB, cos θS sin θB, sin θS).
To turn an arrow by θE: cos θE · e + sin θE · n
The tip is the sum of the link vectors: L1 e + L2 f
The Desmos graph does the same steps.
Next lesson: we write these steps as a Python program.
