balu-lab/cabs-PETFAB-Hammer-Joshua/Curriculum/Lesson 3/Trigonometry FK.pptx

## The Trigonometric Approach to Forward Kinematics

By Joseph Ruhan

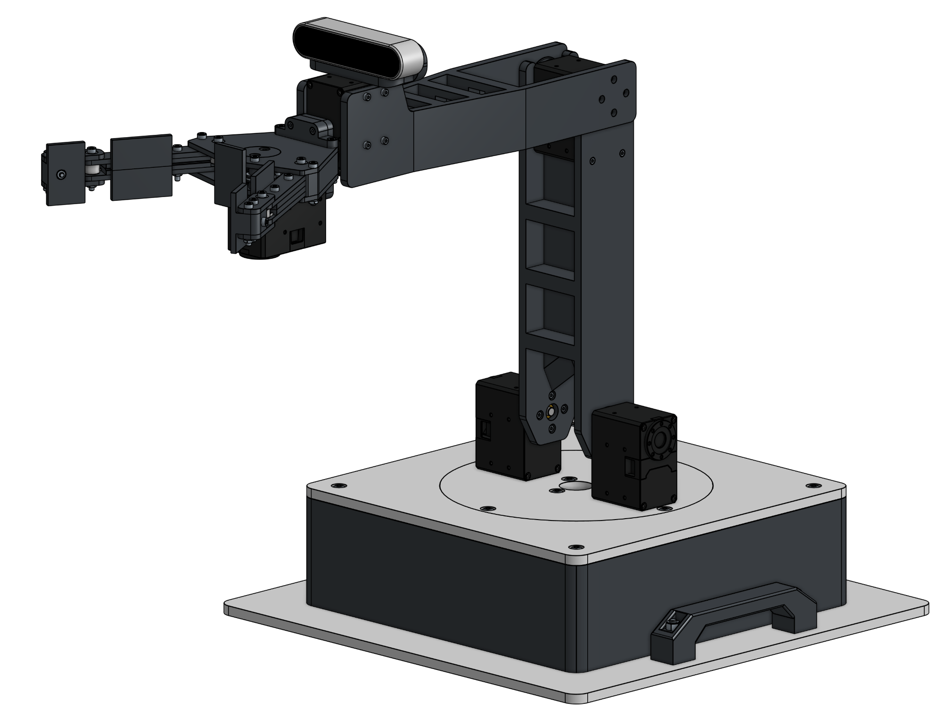
[picture p19: figure]
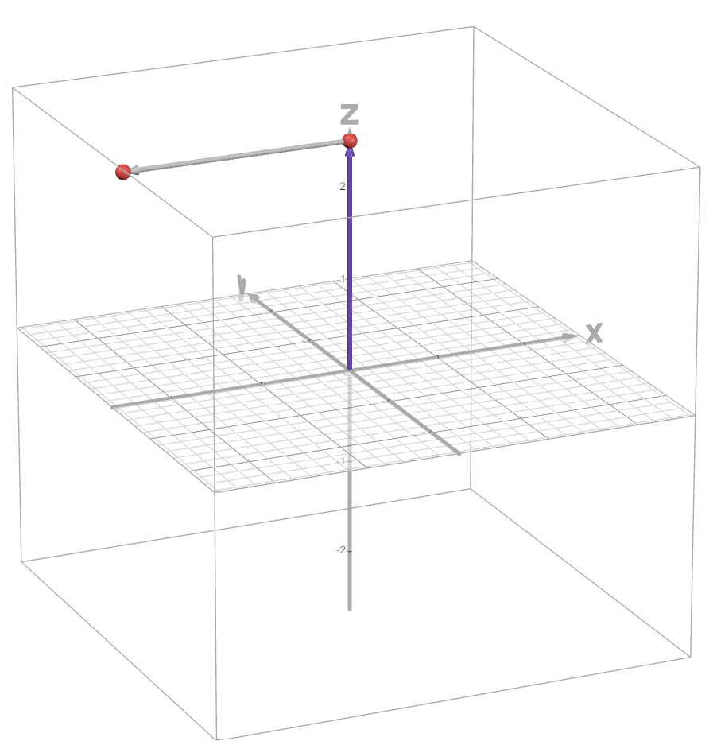
[picture p20: figure]

## Slide 2

The arm can be described mathematically by defining its joints and links

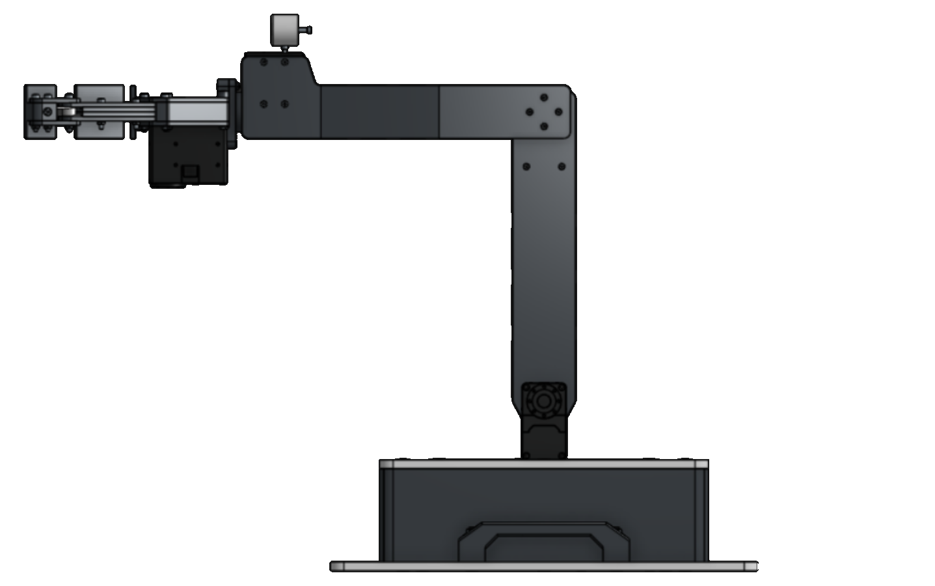
[picture p21: figure]

L2

Where
L1=250mm
L2=250mm

These are always known because they are a constant

L1

## Slide 3

In this example
θ1=45°
θ2=45°
θ1 is measured relative to a vertical projection above the shoulder motors
θ2 is measured relative to the straight-line extension of the upper arm segment

These angles are variable.
However, because the encoder measures the rotation of the actuator, the angles are always known

θ2

θ1

## Slide 4

The arm can therefore be represented as such:

= a joint

θ2

L1=250mm
L2=250mm
θ1=45°
θ2=45°

L2

L1

θ1

## Slide 5

The arm can therefore be represented as such:

= a joint

θ2

L1=250mm
L2=250mm
θ1=45°
θ2=45°

(X, Y)

Y

θ1

The location of the end effector is the unknown variable

(0, 0)

X

## Slide 6

The arm can therefore be represented as such:

= a joint

θ2

L1=250mm
L2=250mm
θ1=45°
θ2=45°

ΔX1

(X, Y)

ΔX2

ΔY1

The position of the end effector will be a sum of the vertical and horizontal displacement of each joint

θ1

## Slide 7

The arm can therefore be represented as such:

= a joint

L1=250mm
L2=250mm
θ1=45°
θ2=45°

θ2

ΔX1

(X, Y)

ΔX2

The displacement can be represented by triangles

θ1

ΔY1

(0, 0)

## Slide 8

Each link has its own triangle

L1 is the hypotenuse of the upper arm triangle (ΔX1, ΔY1)
To use sin and cos, we need the angle between the link and vertical
Upper arm: θ1 is already measured from vertical, so we use θ1

ΔX1

(X, Y)

ΔY1

L1

θ1

## Slide 9

The forearm uses θ1 + θ2

L2 is the hypotenuse of the forearm triangle (ΔX2, ΔY2)
θ2 is measured from the upper arm’s direction, not from vertical
From vertical, the forearm has turned θ1 + θ2
Here: 45° + 45° = 90°, so the forearm is horizontal
Check: if θ2 = 0° the arm is straight, so the angle is just θ1

upper arm’s direction

vertical

θ2

θ1

(X, Y)

L2

θ1

## Slide 10

To calculate the position of the end point:

L1=250mm
L2=250mm
θ1=45°
θ2=45°

In this example, L1 is
the hypotenuse of a
triangle.
Using sin(θ1):
sin(θ1) = ΔX1/L1
L1sin(θ1) = ΔX1
250*(√2/2) = ΔX1
ΔX1 = 176.777mm

θ2

ΔX1

(X, Y)

ΔX2

L1

θ1

ΔY1

(0, 0)

## Slide 11

To calculate the position of the end point:

ΔX1 = 176.777mm

For cos(θ1):
cos(θ1) = ΔY1/L1
L1cos(θ1) = ΔY1
250*(√2/2) = ΔY1
ΔY1 = 176.777mm
The forearm angle is θ1+θ2 = 90°
ΔX2 = L2sin(θ1+θ2)
250*sin(90°) = ΔX2
ΔX2 = 250mm
ΔY2 = L2cos(θ1+θ2)
250*cos(90°) = ΔY2
ΔY2 = 0mm

θ2

ΔX1

(X, Y)

ΔX2

θ1

ΔY1

(0, 0)

## Slide 12

To calculate the position of the end point:

ΔX1 = 176.777mm
ΔY1 = 176.777mm
ΔX2 = 250mm
ΔY2 = 0mm

θ2

ΔX1

(X, Y)

ΔX2

(X,Y) = (ΔX1+ΔX2,ΔY1+ ΔY2)
(X,Y) = (426.777, 176.777)

θ1

ΔY1

(0, 0)

## Slide 13

Completed Variables

θ2

(426.777, 176.777)

θ1

L1=250mm
L2=250mm
θ1=45°
θ2=45°
(X,Y) = (426.777, 176.777)

## Slide 15

Try It Yourself:

L1=250mm
L2=250mm
θ1=30°
θ2=30°
(X,Y) = (?,?)

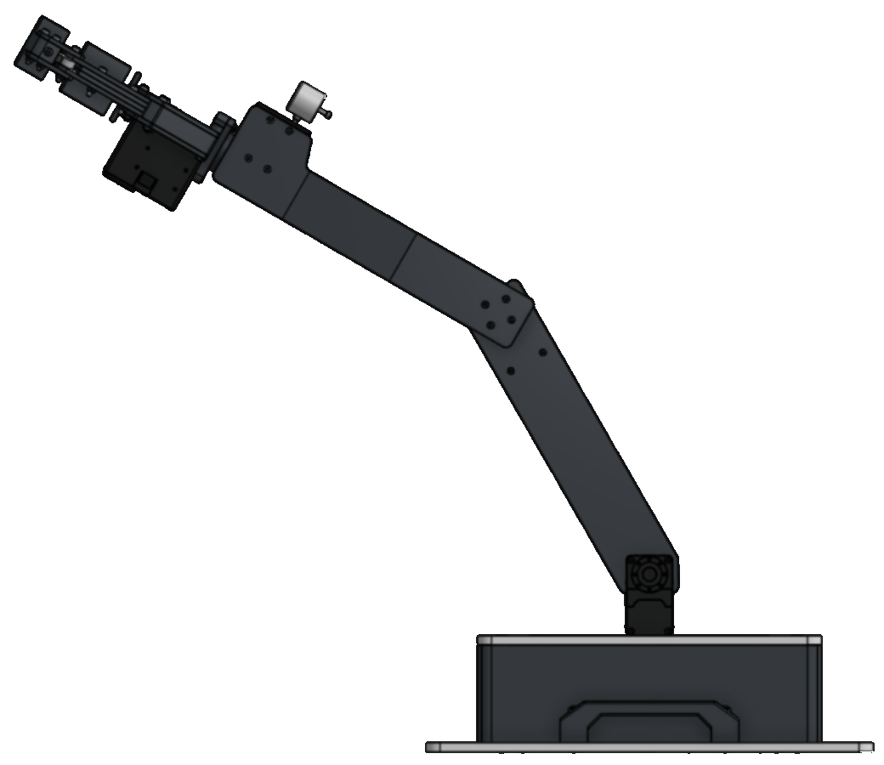
[picture p22: figure]

θ2

(X,Y)

Solution:
(X,Y) = (341.506, 341.506)

θ1

## Slide 17

Try It Yourself 2:

L1=250mm
L2=250mm
θ1=60°
θ2=0°
(X,Y) = (?,?)

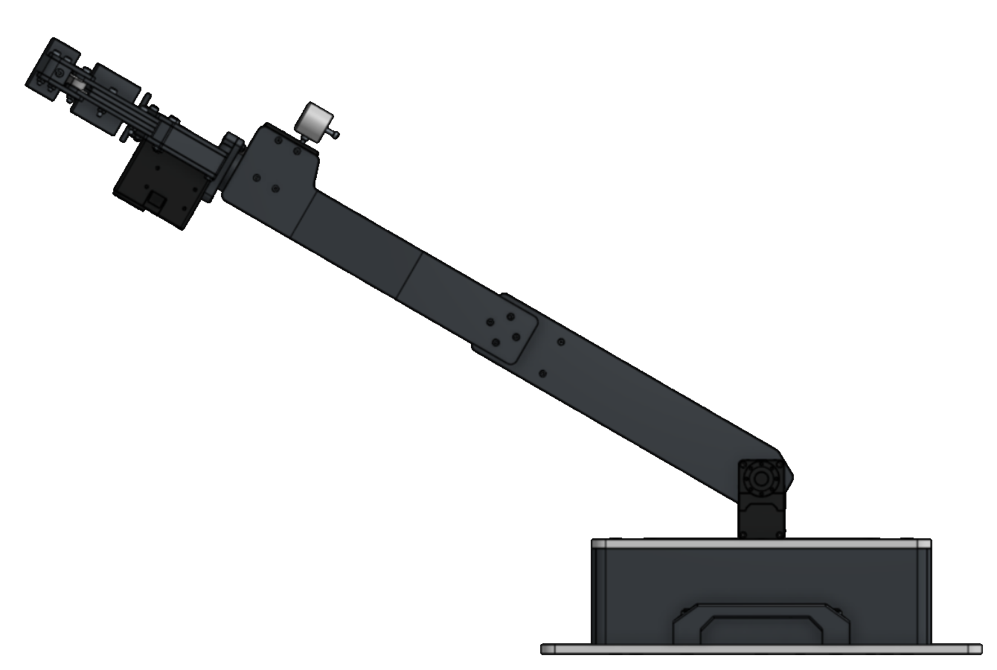
[picture p23: figure]

(X,Y)

Solution:
(X,Y) = (433.013, 250)

θ1

## Slide 18

Forward Kinematics With Base Rotation

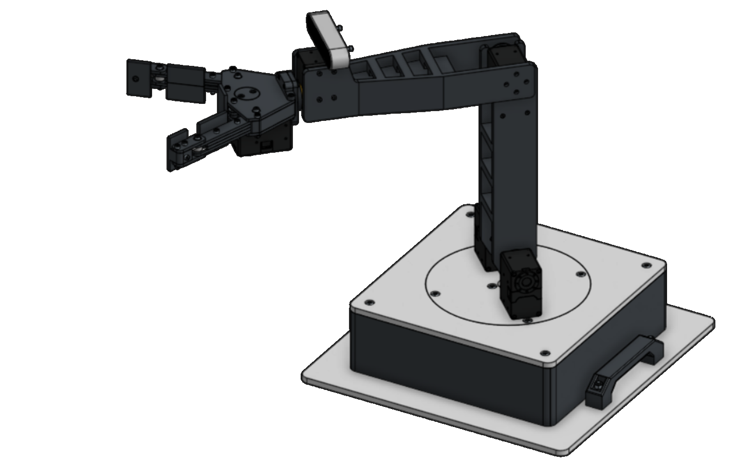
[picture p24: figure]

## Slide 19

The arm’s forward kinematics with base rotation is dependent on rotation around the center point of the base

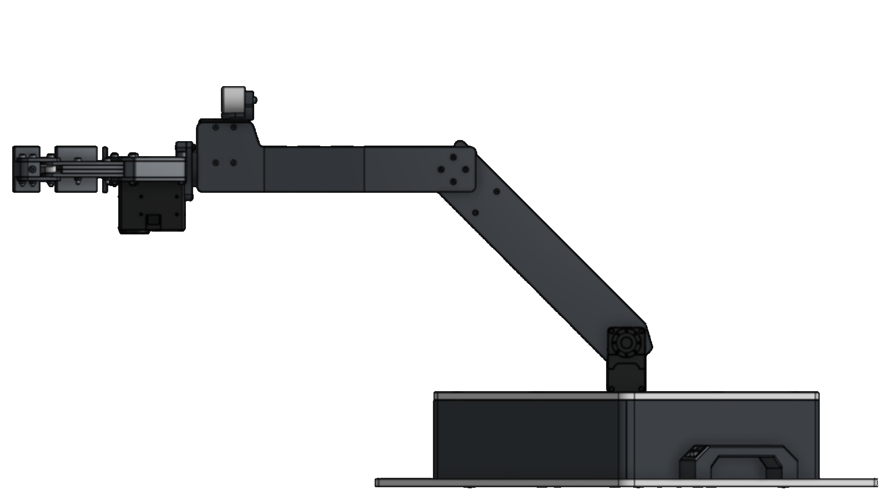
[picture p25: figure]

(X,Y)

R

Where
R = Horizontal distance from end effector to base center point

## Slide 20

R is variable because the end effector can move away or closer to the base center point, horizontally

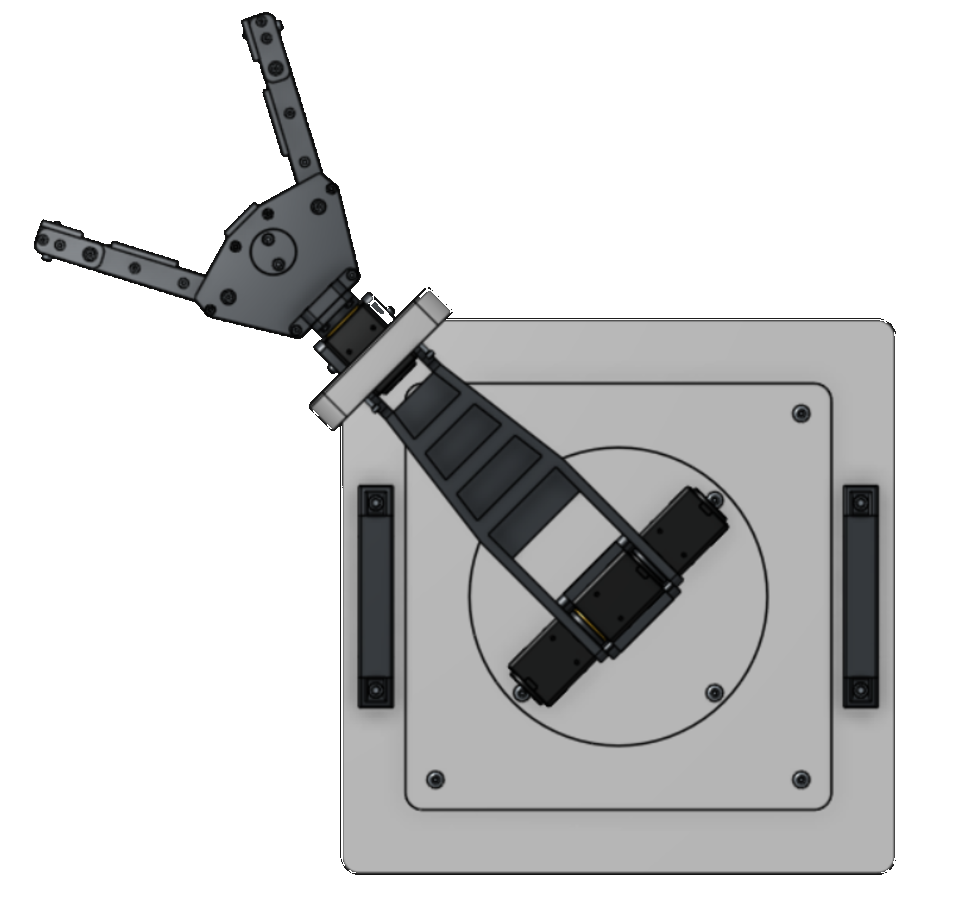
[picture p26: figure]
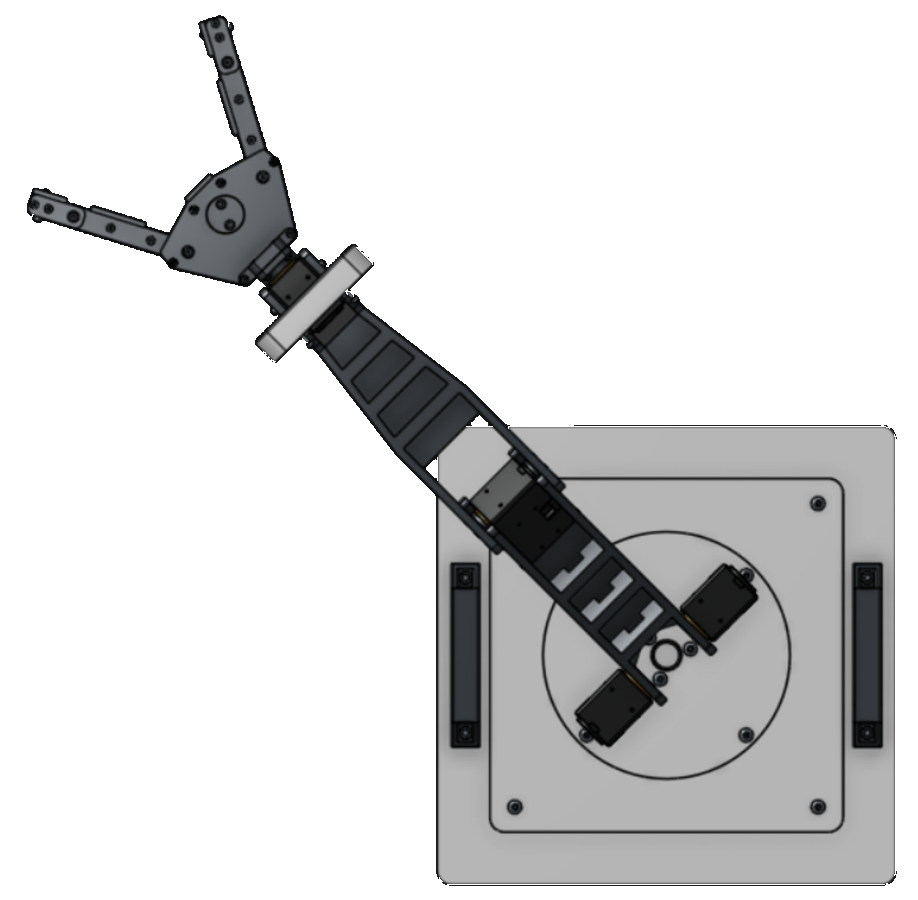
[picture p27: figure]

R2

R1

R1 < R2

## Slide 21

R forms a circle around the center of the base when rotated

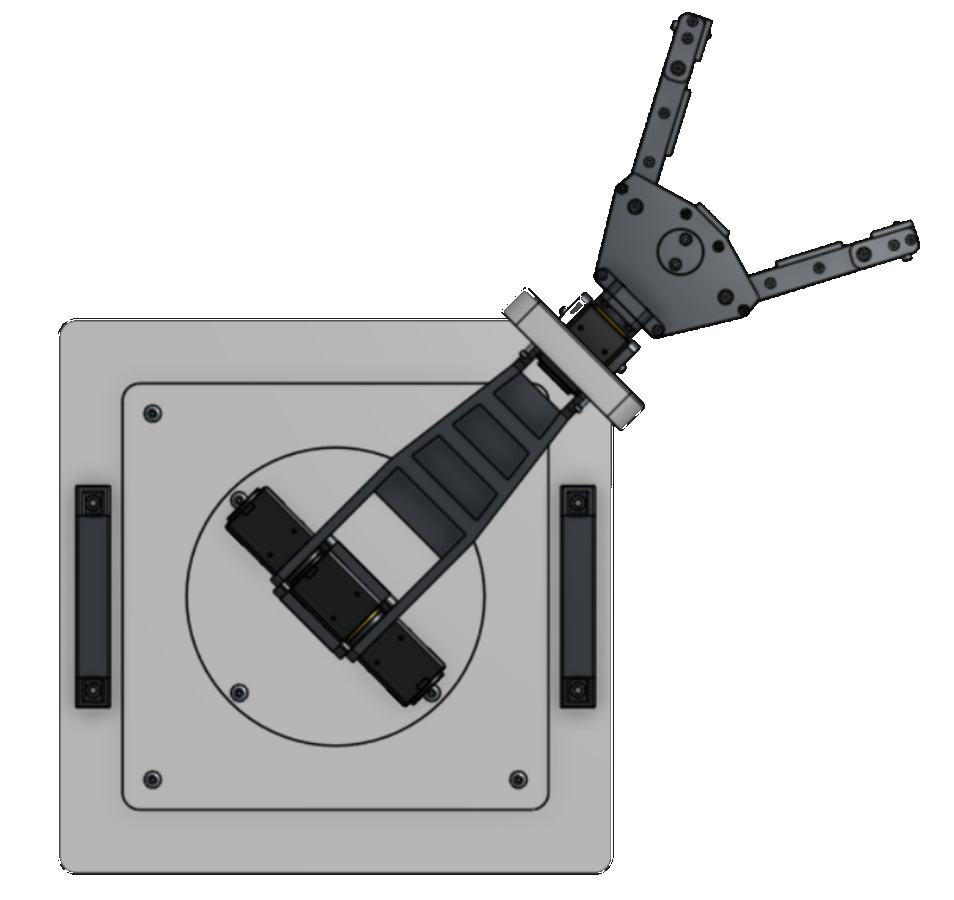
[picture p28: figure]

R

## Slide 22

θ3 is known because we can measure the rotation of the base actuator with its encoder

θ3

R

## Slide 23

So if R is calculated, the position of the end effector in 3D space can be determined

(X,Z)

X

θ3

R

Z

## Slide 24

The problem can be represented as a circle with a radius
To find (X,Z)
1. Find R
2. Calculate the
location of R on the
circle

(X,Z)

X

θ3

R

Z

## Slide 25

Example Problem

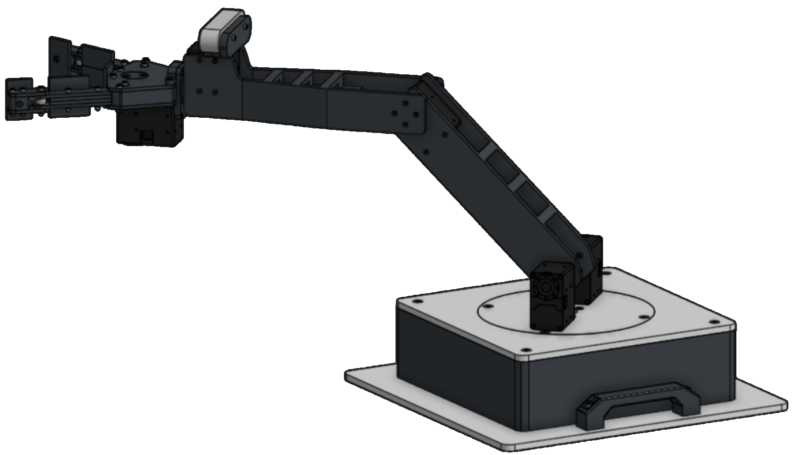
[picture p29: figure]

Y

Z

L1=250mm
L2=250mm
θ1=45°
θ2=45°
θ3=45°
(X,Y,Z) = (?,?,?)

θ3

X

## Slide 26

This problem can be split into two 2D problems
Solving for R:
along the arm's
own XY plane
Solving for X and Z:
Along the XZ plane

## Slide 27

The problem can be solved along these two planes

X

θ2

θ3

R

θ1

Z

R

## Slide 28

R will be equal to the X value we calculated when analyzing this position in 2D

(X, Y)

θ2

For this problem
(L1=250mm, L2=250mm, θ1=45°, θ2=45°)
We solved it already and
determined (X,Y) to equal
(426.777, 176.777)
In this frame, R=x
Therefore, R=426.78mm
and Y=176.78mm

θ1

R

## Slide 29

Along the XZ Plane

R= 426.78mm
θ3= 45°
Z = Rsin(θ3)
X = Rcos(θ3)
Z = 301.78mm
X = 301.78mm

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
## Slide 30

Example Problem: Solution

L1=250mm
L2=250mm
θ1=45°
θ2=45°
θ3=45°

Y

Z

X = 301.78mm
Y=176.78mm
Z = 301.78mm

X

## Slide 31

Practice Problem 1

L1=250mm
L2=250mm
θ1=30°
θ2=30°
θ3=60°
(X,Y,Z) = (?,?,?)

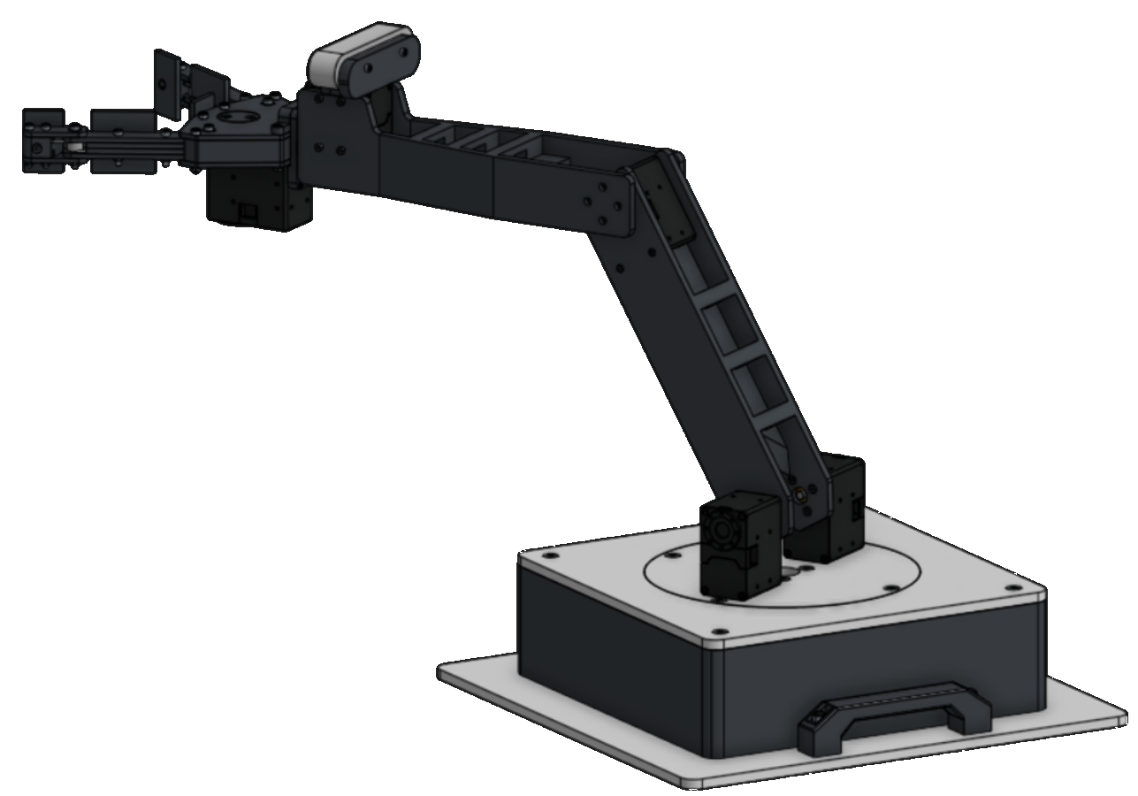
[picture p30: figure]

Y

Z

θ3

X

## Slide 32

Practice Problem 1

L1=250mm
L2=250mm
θ1=30°
θ2=30°
θ3=60°
(X,Y,Z) = (?,?,?)

Solution:
(X,Y,Z) = (170.75,341.51,295.75)

Click To Reveal

Y

Z

θ3

X

## Slide 33

Practice Problem 2

L1=250mm
L2=250mm
θ1=30°
θ2=90°
θ3=30°
(X,Y,Z) = (?,?,?)

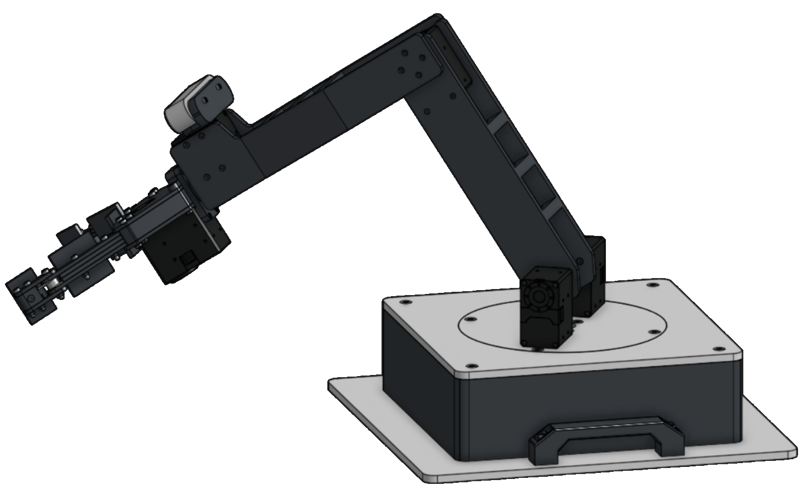
[picture p31: figure]

Y

Z

θ3

X

## Slide 34

Practice Problem 2

L1=250mm
L2=250mm
θ1=30°
θ2=90°
θ3=30°
(X,Y,Z) = (?,?,?)

Y

Z

θ3

Solution:
(X,Y,Z) = (295.75,91.51,170.75)

Click To Reveal

X

## Slide 35

Desmos Calculator

https://www.desmos.com/3d/9bnvqc263x

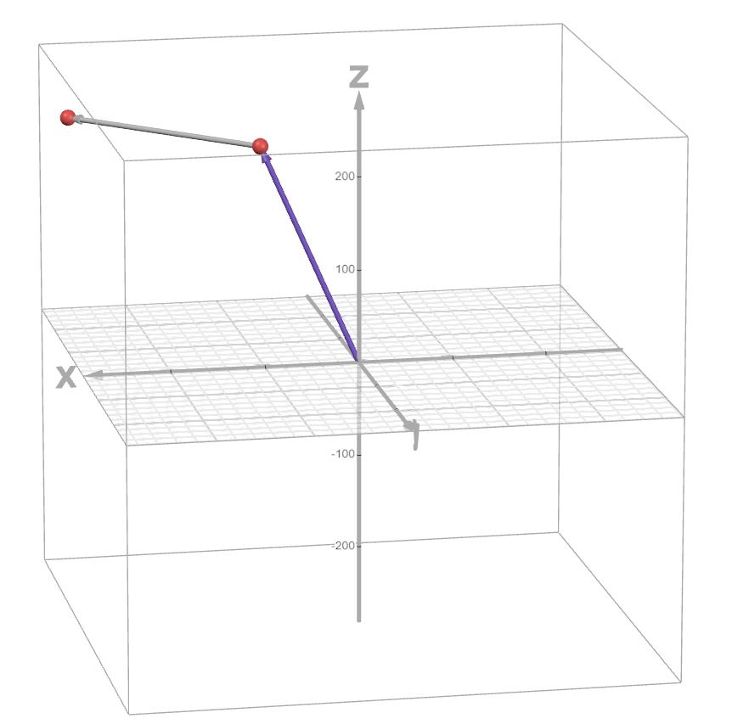
[picture p32: figure]
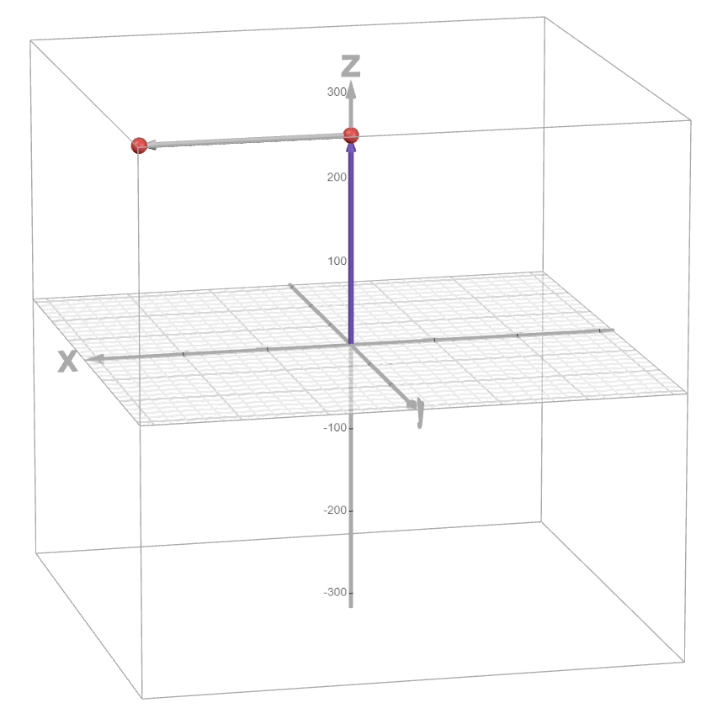
[picture p33: figure]
