balu-lab/cabs-PETFAB-Hammer-Joshua/PETFAB-Armadillo/Curriculum/Lesson 4/Updated_Lesson_4_DH_Approach_to_FK_plain_colours.pptx

## The Denavit-Hartenberg Approach to Forward Kinematics

ROBOTIC ARM COURSE · LESSON 4 OF 12

Turning joint angles into the end effector's position, one matrix per joint

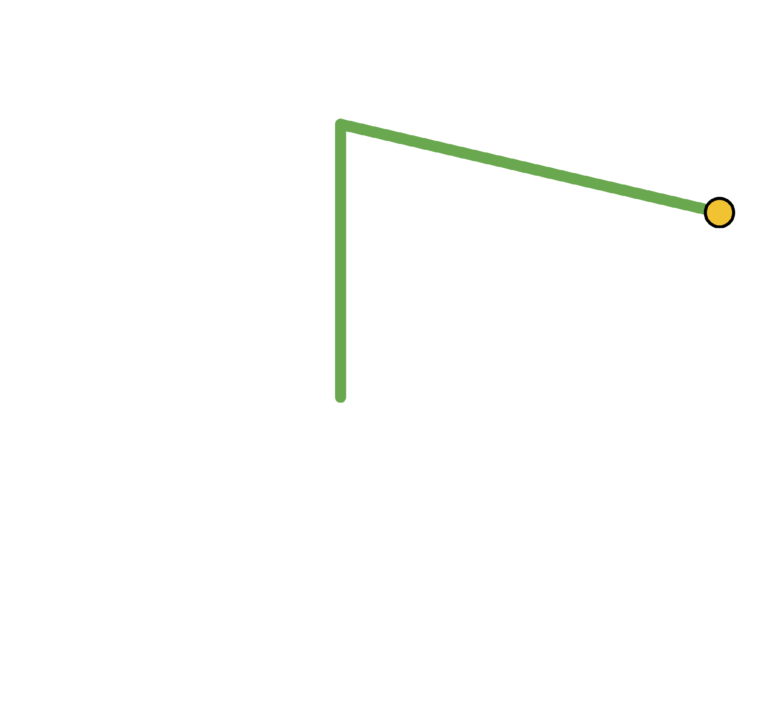
[picture p34: figure]
Three-quarter view of the real arm on its base, with the base, shoulder, elbow and tip marked and the joint angles named
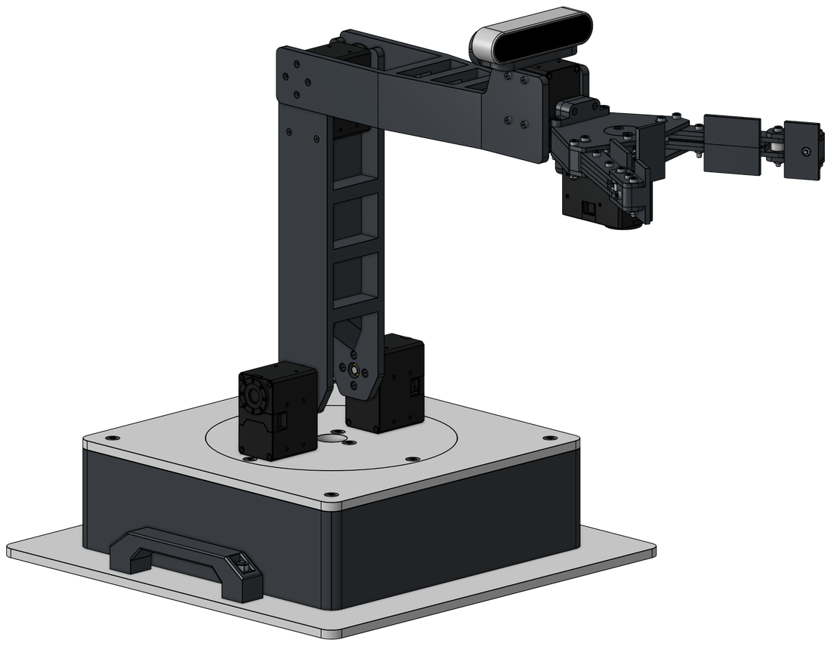
[picture p35: figure]
Three-quarter view of the robotic arm on its base, upper arm vertical and forearm horizontal

θE

3

(X, Y, Z)

1

2

θS

θB

Day 1 · Rotation and movement matrices

Day 2 · Extending to 3D

## Where Lesson 3 Left Off

RECAP · LESSON 3

GIVEN

L₁ = L₂ = 250 mm

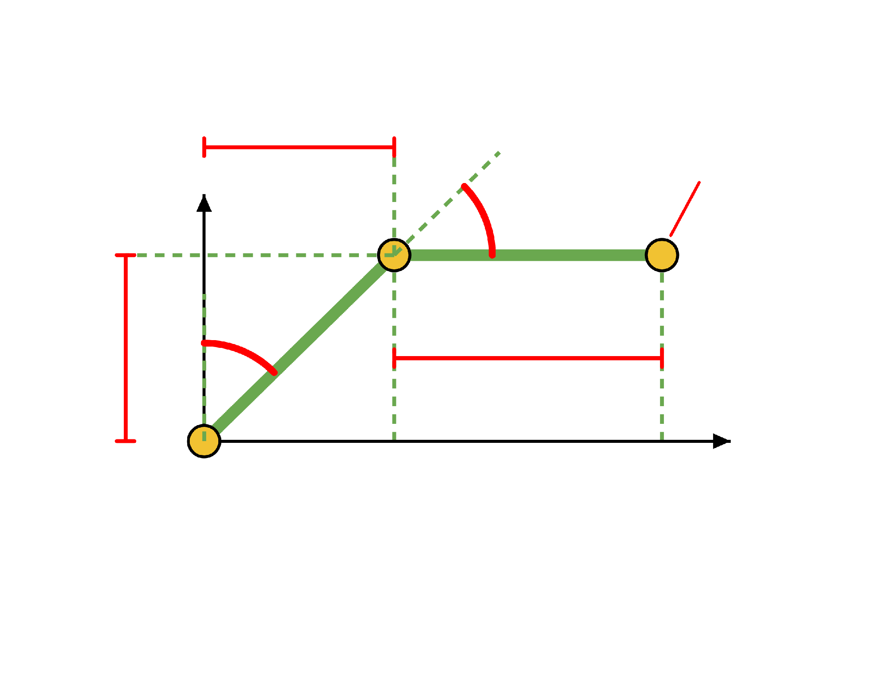
[picture p36: figure]
Side view of the real arm with the shoulder at the origin, the elbow at 176.78, 176.78 and the end effector at 426.78, 176.78, with the shoulder and elbow angles and the horizontal and vertical distances marked

ΔX₁

θS = 45°, θE = 45°

THE TRIANGLES GAVE

ΔX₁ = ΔY₁ = 176.78 mm

Y

θE

(X, Y)

θS

ΔX₂ = 250 mm, ΔY₂ = 0 mm

ΔY₁

ΔX₂

(X, Y) = (426.78, 176.78)

(0, 0)

X

Lesson 3 called the angles θ₁ and θ₂. From
now on: θS for the shoulder, θE for the elbow
and θB for the base.

## One Recipe for Every Joint

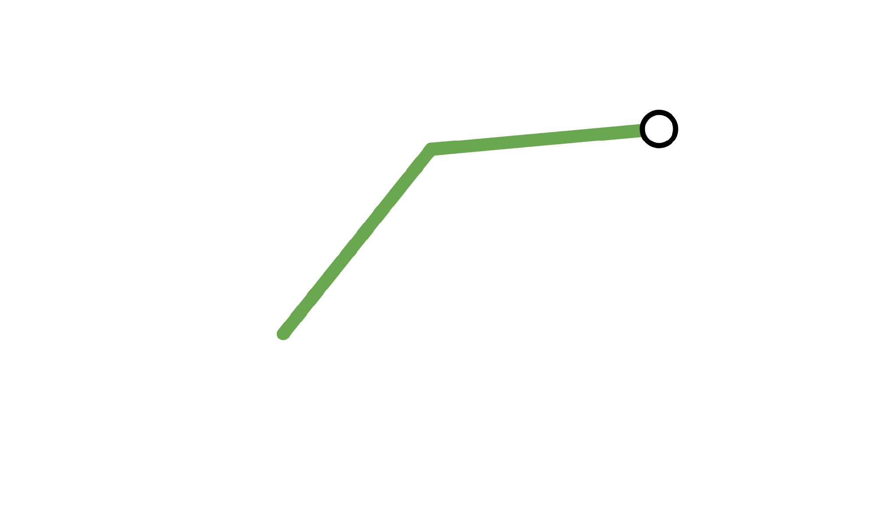
[picture p37: figure]
Three-quarter view of the real arm on its base with the base, shoulder and elbow numbered 1, 2 and 3 and the tip marked T

WHY MATRICES

Lesson 3 used triangles. Every new joint needed new triangles, and the turning base made the problem 3D.

3

T

1

2

1 · BASE

A₁

one matrix

2 · SHOULDER

A₂

one matrix

3 · ELBOW

A₃

one matrix

gives the position

RESULT

T

×

×

=

DAY 1

The flat (2D) arm, using rotation and move matrices

DAY 2

The real (3D) arm, using the Denavit-Hartenberg recipe

## Rotating a Point

DAY 1 · ROTATION

Spin the point P = (250, 0) by 45° around the origin.

Where does it land?

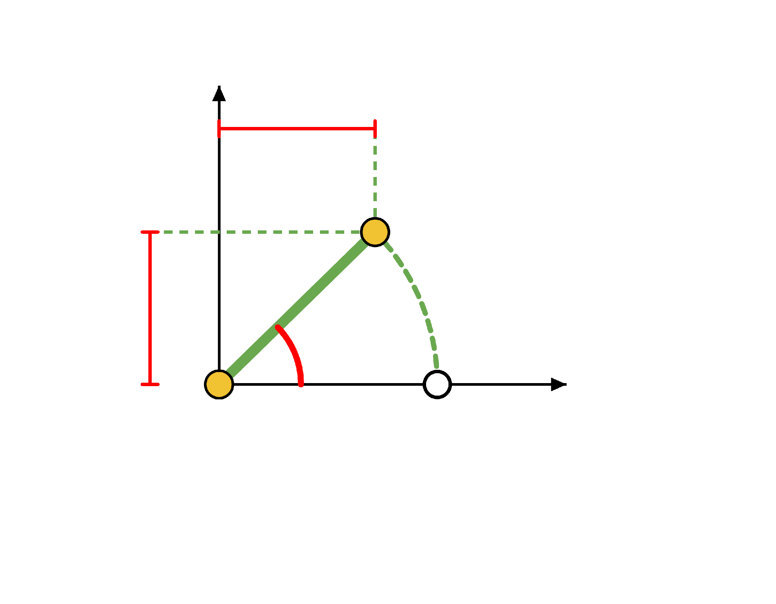
[picture p38: figure]
Side view of the real arm. The shoulder is the origin. The point P at 250, 0 on the x axis turns 45 degrees about the shoulder to P prime at 176.78, 176.78, which is the elbow.

y

x′ = 176.78

x′ = 250 · cos 45° = 176.78

y′ = 250 · sin 45° = 176.78

P′ = (176.78, 176.78)

P′

y′ = 176.78

45°

P = (250, 0)

x

Same numbers as ΔX₁ and ΔY₁ in Lesson 3. The first link is just a point that was rotated.

## The Rotation Matrix

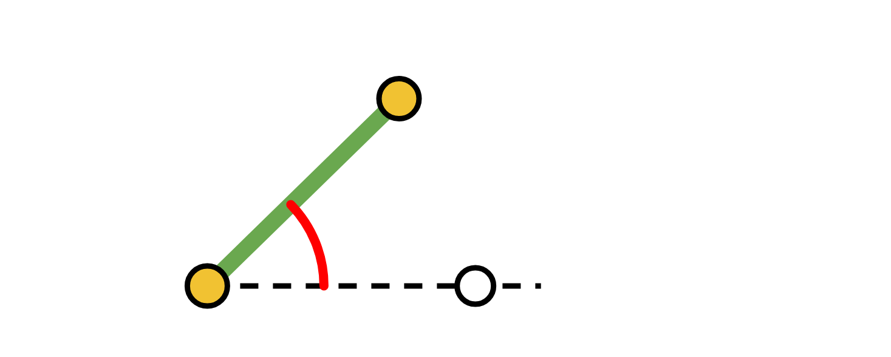
[picture p39: figure]
The real arm with the upper arm turned about the shoulder from the horizontal x axis; the point P turns into P prime at the elbow

P′

DAY 1 · ROTATION

The two formulas for rotating a point (x, y) by θ fit inside one matrix.

θ

P

sin θ

cos θ

cos θ

−sin θ

×

x

y

=

x cos θ − y sin θ

x sin θ + y cos θ

the rotated point P′ = (x′, y′)

rotation matrix R(θ)

the point P

HOW TO MULTIPLY

Take one row of the matrix. Multiply it entry by entry
with the point, then add. Row 1 gives x′. Row 2
gives y′.

WHAT R(θ) DOES

It spins any point by θ, counter-clockwise, around
the origin.

## Worked Example: Rotation

P′

DAY 1 · ROTATION

Rotate P = (250, 0) by 45°. At 45°, cos and sin are both 0.7071.

45°

P

0.7071

0.7071

0.7071

−0.7071

×

0

250

=

176.78

176.78

R(45°)

P

P′

ROW 1 GIVES x′

0.7071 × 250 + (−0.7071) × 0 = 176.78

ROW 2 GIVES y′

0.7071 × 250 + 0.7071 × 0 = 176.78

P′ = (176.78, 176.78), the same answer as the cos and sin formulas.

## Try It Yourself #1

DAY 1 · TRY IT YOURSELF

Rotate P = (250, 0) by each angle. Find P′ = (x′, y′).

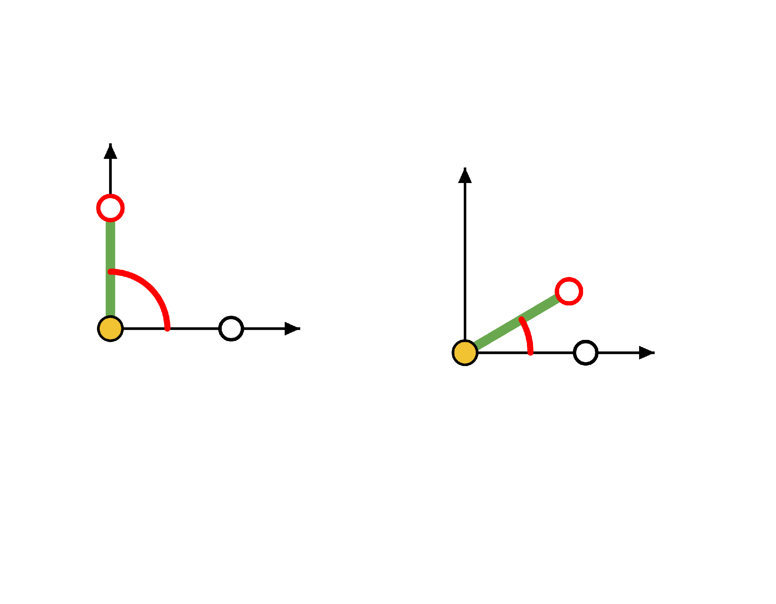
[picture p40: figure]
Two side views of the real arm. In the first the upper arm is rotated 90 degrees from the x axis, in the second 30 degrees. The elbow position of each is the unknown point.

(a) θ = 90°

(b) θ = 30°

(a) θ = 90°

(b) θ = 30°

(?, ?)

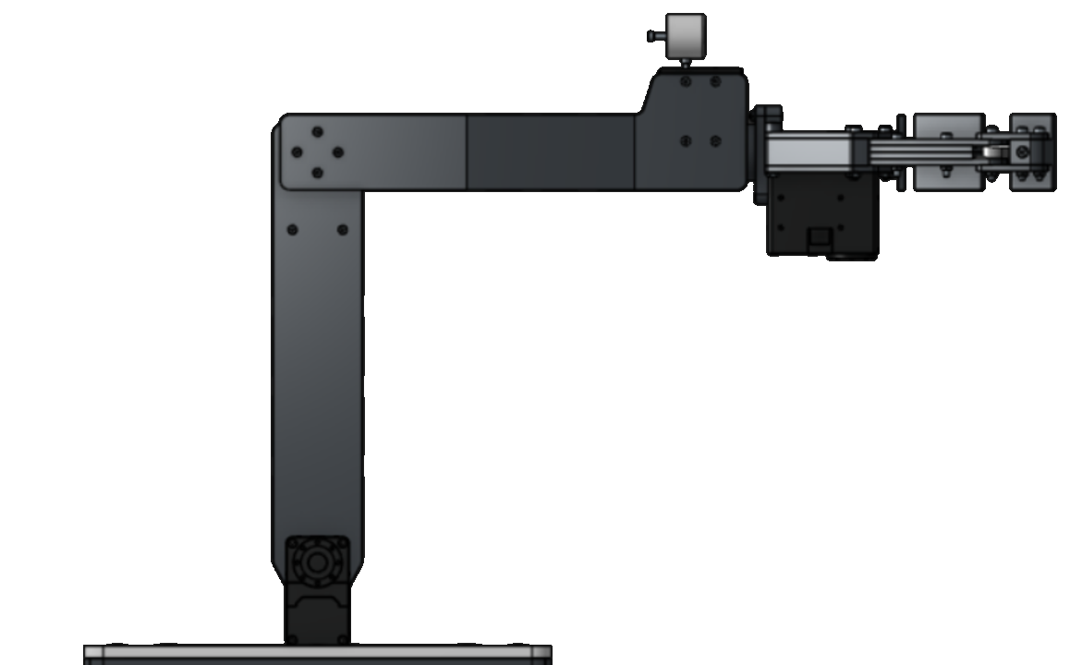
[picture p41: figure]
Side view of the robotic arm: the upper arm is vertical and the forearm is horizontal

SOLUTION

(a) 90°: cos 90° = 0, sin 90° = 1

P′ = (0, 250)

(b) 30°: cos 30° = 0.8660, sin 30° = 0.5

P′ = (216.51, 125.00)

(?, ?)

P

P

## Moving a Point

T(250, 0)

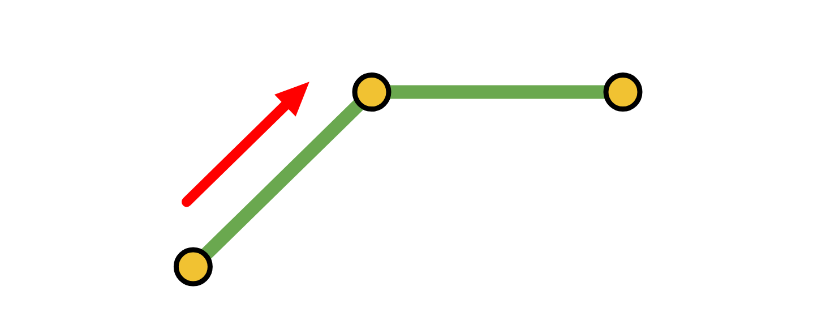
[picture p42: figure]
The real arm with an arrow along a link: travelling along a link is a move by 250 along x

DAY 1 · MOVING A POINT

Slide the point P = (250, 0) to the right by 100.

x′ = x + 100 = 350

y′ = y + 0 = 0

P′ = (350, 0)

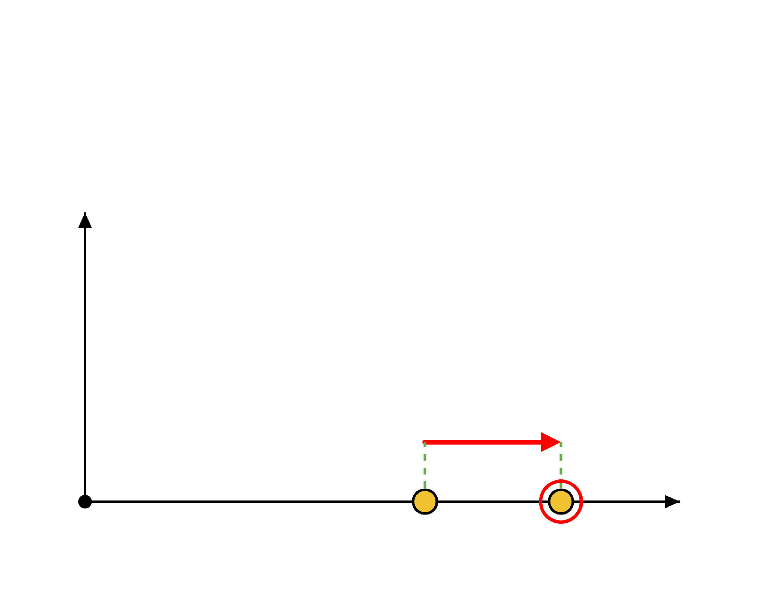
[picture p43: figure]
The point P at 250, 0 moved 100 units to the right to P prime at 350, 0

y

THE PROBLEM

Rotating is multiplying. Moving is adding. Our 2×2 matrix can only multiply, so it cannot move a point.

+100

x

P = (250, 0)

P′ = (350, 0)

## The Extra 1

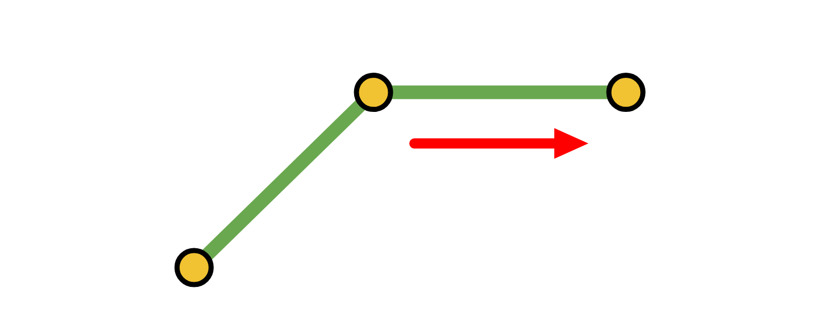
[picture p44: figure]
The real arm with an arrow along a link: travelling along a link is a move by 250 along x

DAY 1 · MOVING A POINT

Write every point with an extra 1: (x, y) becomes (x, y, 1). Now moving is a multiplication too, using a 3×3 matrix.

T(250, 0)

Row 1: 1 · 250 + 0 · 0 + 100 · 1 = 350. The extra 1 is what
picks up the 100.

1

0

100

250

350

sin θ

cos θ

cos θ

−sin θ

0

0

R(θ)

spin by θ

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
T(100, 0)

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
T(dx, dy)

move dx right, dy up

0

0

1

0

dy

1

## The Arm as a Chain of Matrices

DAY 1 · THE 2D ARM

Turn at the shoulder

1

R(θa)

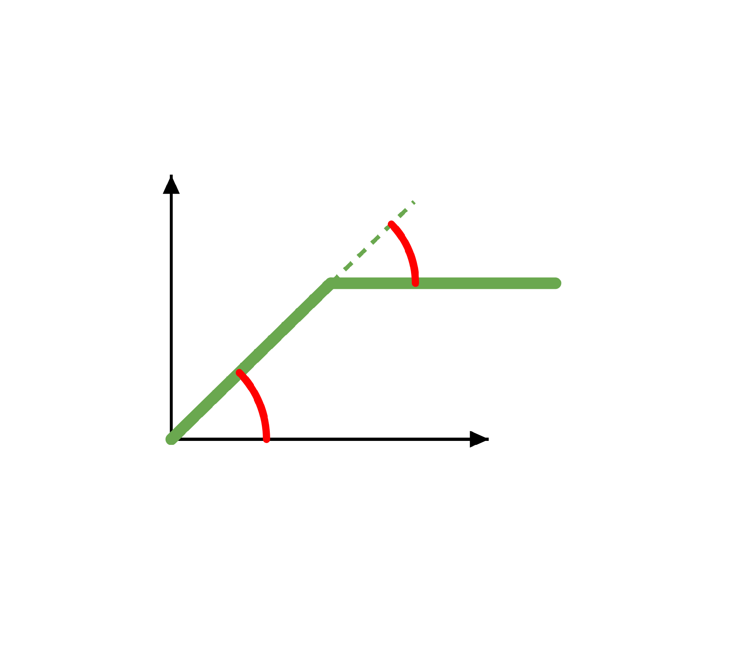
[picture p45: figure]
Side view of the real arm with the four steps of the chain marked: 1 turn at the shoulder, 2 travel along the upper arm, 3 turn at the elbow, 4 travel along the forearm, with the shoulder angle theta a and the elbow angle theta b.

Travel along the upper arm

y

2

T(250, 0)

θb

4

Turn at the elbow

3

R(θb)

3

Travel along the forearm

4

T(250, 0)

2

θa

M = R(θa) · T(250, 0) · R(θb) · T(250, 0)

Read left to right, it is the story of the arm.

1

x

## Converting the Arm's Angles

DAY 1 · THE 2D ARM

SHOULDER

θa = 90° − θS

A matrix counts angles counter-clockwise from the x-axis. θS counts clockwise from the vertical.

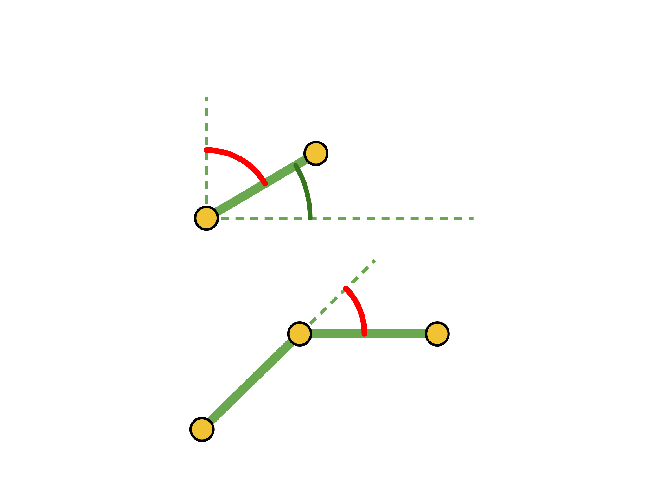
[picture p46: figure]
Two side views of the real arm. Top: the shoulder angle thetaS of 60 degrees from the vertical is thetaA of 30 degrees from the x axis. Bottom: the elbow bends 45 degrees clockwise, so thetaB is minus 45 degrees.

θS = 60°

ELBOW

θb = −θE

The forearm bends clockwise. A matrix counts counter-clockwise, so the sign flips.

θa = 30°

clockwise, so θb = −45°

θE = 45°

θS = 60° gives θa = 30°

θE = 45° gives θb = −45°

## Worked Example: Setup

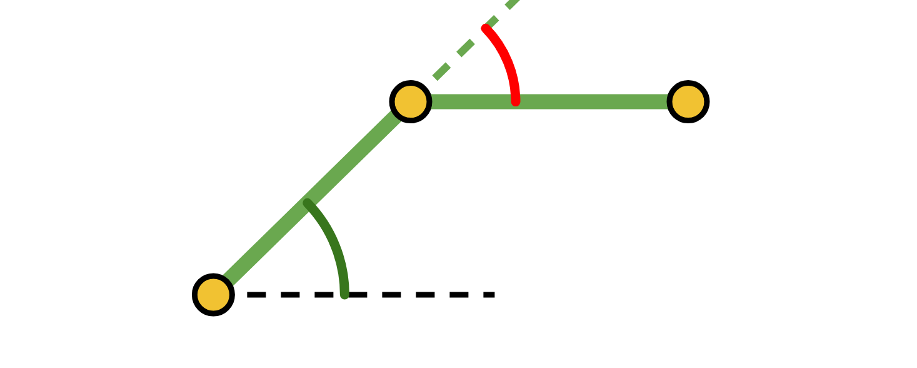
[picture p47: figure]
The real arm with the angle theta a of the upper arm above the x axis and the elbow angle theta b marked

θb = −45°

DAY 1 · THE 2D ARM

Find the end effector for θS = 45° and θE = 45°, with L₁ = L₂ = 250 mm.

θa = 45°

CONVERT THE ANGLES

θa = 90° − 45° = 45°

θb = −45°

THE MOVES

Both links are 250 mm

Both moves are T(250, 0)

THE CHAIN, APPLIED TO THE POINT (0, 0, 1)

The story reads left to right; the arithmetic starts at the right, with the matrix next to the point.

R(45°)

step 4

·

T(250, 0)

·

R(−45°)

·

T(250, 0)

·

(0, 0, 1)

step 3

step 2

step 1

start

## Worked Example: Right to Left

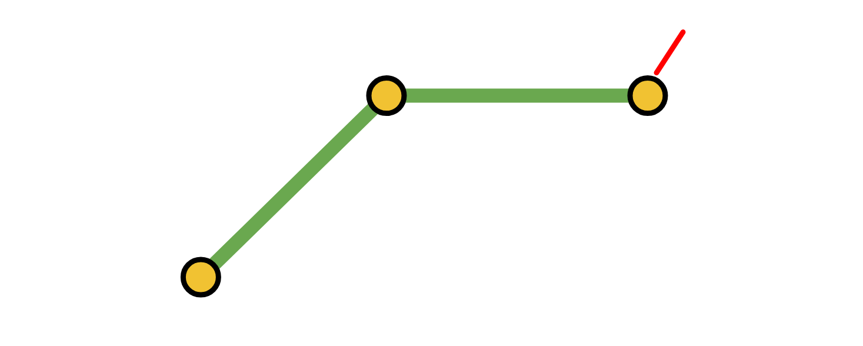
[picture p48: figure]
The real arm in the 45 degree, 45 degree pose with the end effector marked

(X, Y)

DAY 1 · THE 2D ARM

Each step is one matrix times the current point.

STEP 1 · T(250, 0)

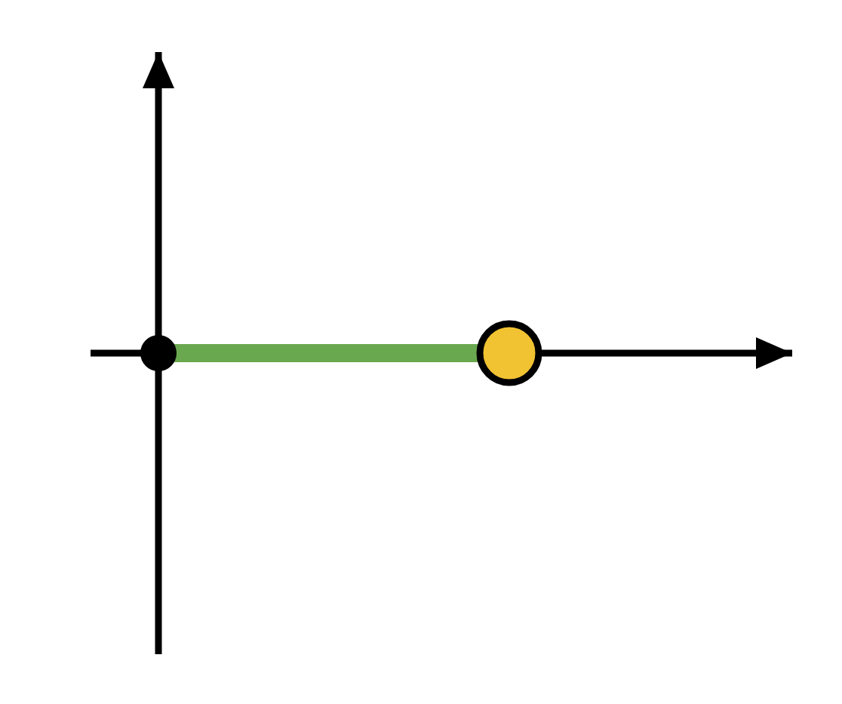
[picture p49: figure]
The start point at the origin moves to 250, 0

Lay the forearm out along x

(250, 0)

STEP 2 · R(−45°)

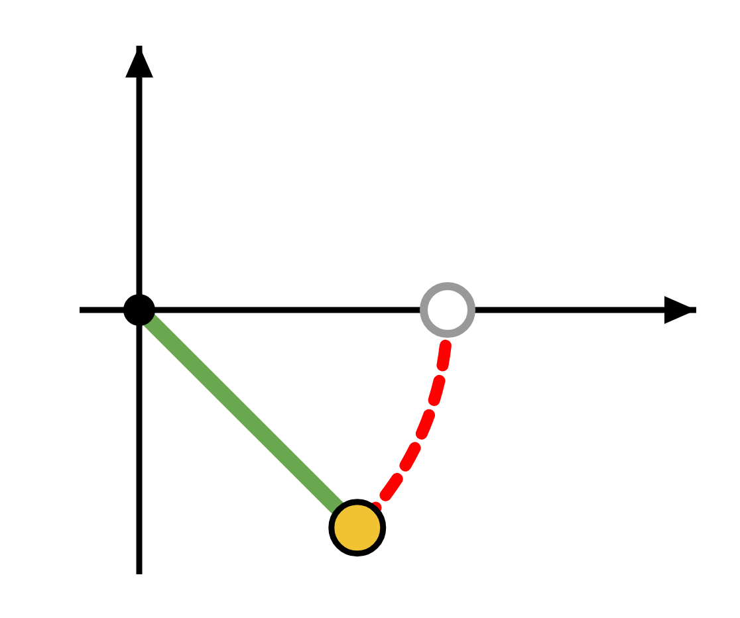
[picture p50: figure]
The point swings clockwise by 45 degrees about the origin to 176.78, minus 176.78

Bend the elbow

(176.78, −176.78)

STEP 3 · T(250, 0)

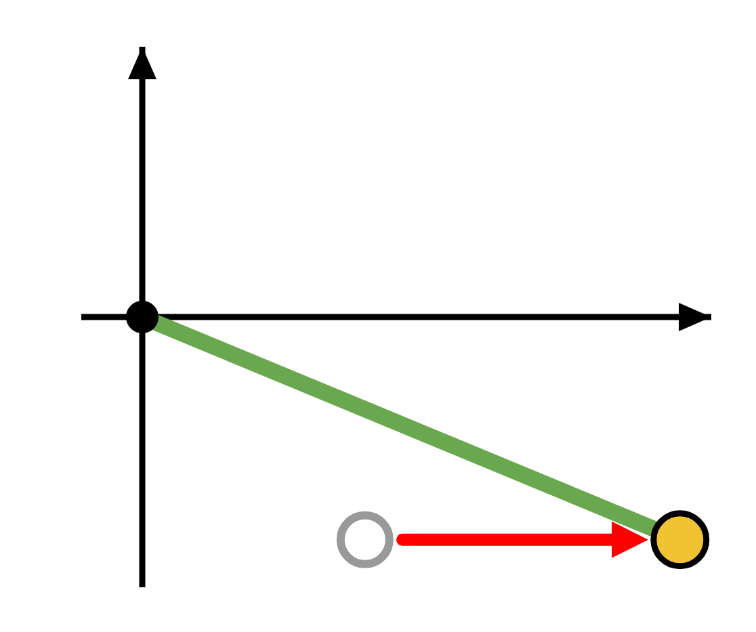
[picture p51: figure]
The point slides 250 to the right to 426.78, minus 176.78

Add the upper arm

(426.78, −176.78)

STEP 4 · R(45°)

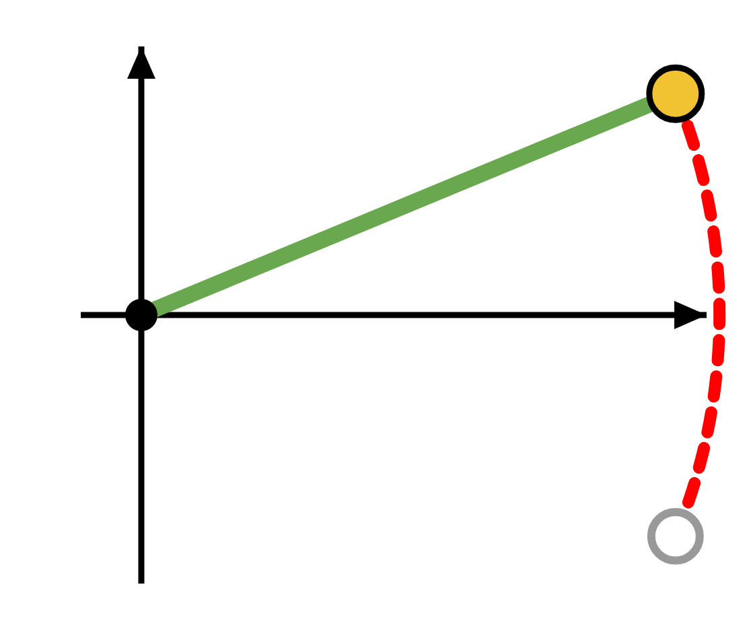
[picture p52: figure]
The whole arm swings counter-clockwise by 45 degrees about the origin, ending at 426.78, 176.78

Swing everything up to the shoulder angle

(426.78, 176.78)

## Completed Variables

DAY 1 · THE 2D ARM

L₁ = 250 mm

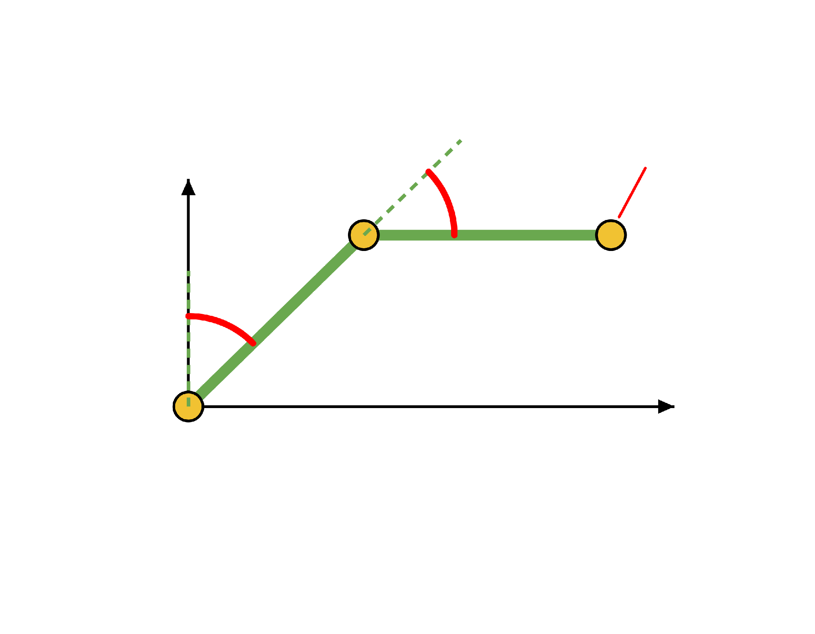
[picture p53: figure]
Side view of the real arm with the shoulder angle 45 degrees, the elbow angle 45 degrees and the end effector at X, Y

L₂ = 250 mm

θS = 45°

θE = 45°

Y

θE

(X, Y)

θa = 45°

θS

θb = −45°

(X, Y) = (426.78, 176.78)

Lesson 3's triangles gave (426.777, 176.777). The matrices agree.

(0, 0)

X

## Try It Yourself #2

DAY 1 · TRY IT YOURSELF

Find the end effector (X, Y).

L₁ = 250 mm

L₂ = 250 mm

θS = 30°

θE = 30°

SOLUTION

θa = 90° − 30° = 60°, θb = −30°

(X, Y) = (341.51, 341.51)

The same answer as Try It Yourself in Lesson 3.

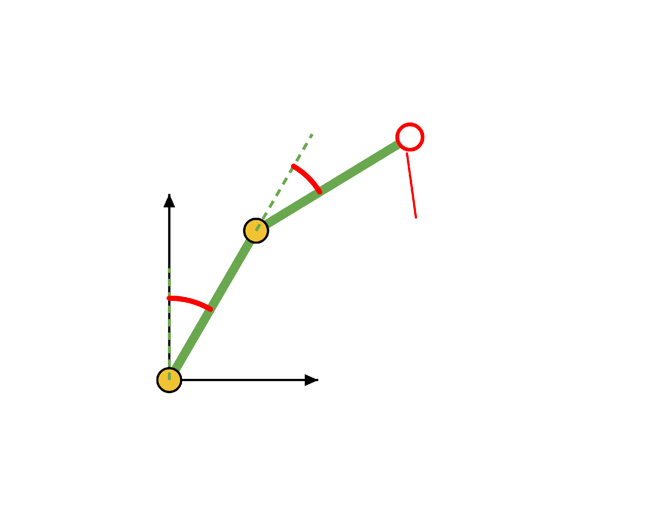
[picture p54: figure]
Side view of the real arm with the shoulder angle 30 degrees from the vertical and the elbow bent 30 degrees; the end effector position is unknown
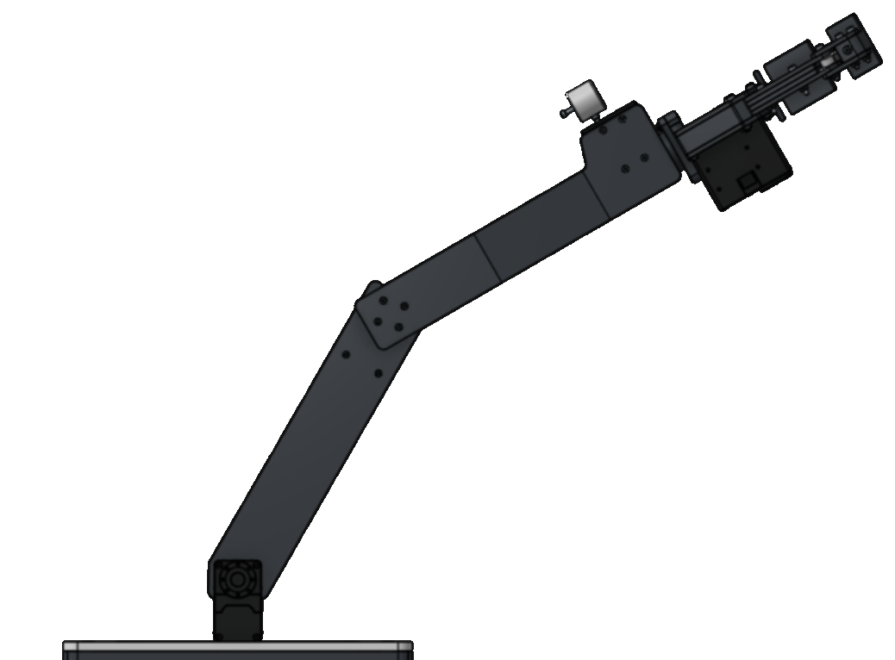
[picture p55: figure]
Side view of the robotic arm: the upper arm leans 30 degrees from vertical and the forearm is bent a further 30 degrees

θE

y

(X, Y) = (?, ?)

θS

x

## Try It Yourself #3

DAY 1 · TRY IT YOURSELF

Find the end effector (X, Y).

L₁ = 250 mm

L₂ = 250 mm

θS = 60°

θE = 0°

SOLUTION

θa = 90° − 60° = 30°, θb = 0°

(X, Y) = (433.01, 250.00)

A 0° turn changes nothing, so the arm is one straight line.

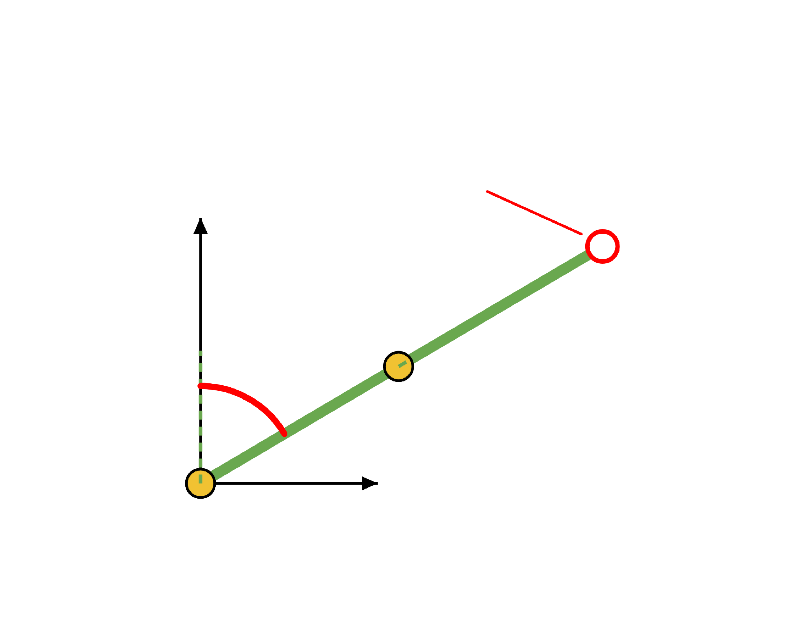
[picture p56: figure]
Side view of the real arm with the shoulder angle 60 degrees from the vertical and the elbow straight; the end effector position is unknown

(X, Y) = (?, ?)

y

θS

x

θE = 0°

## Order Matters

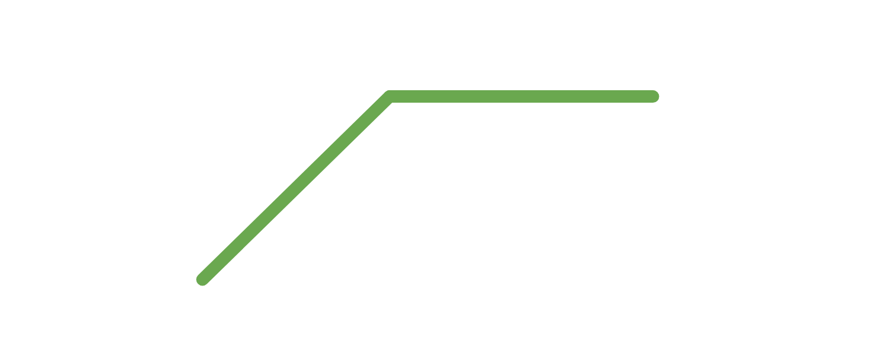
[picture p57: figure]
The real arm with the four steps of the chain marked 1 to 4, from the shoulder to the end of the forearm

3

4

DAY 1 · ORDER MATTERS

1

2

A · ROTATE, THEN MOVE

T(100, 0) · R(90°) · P

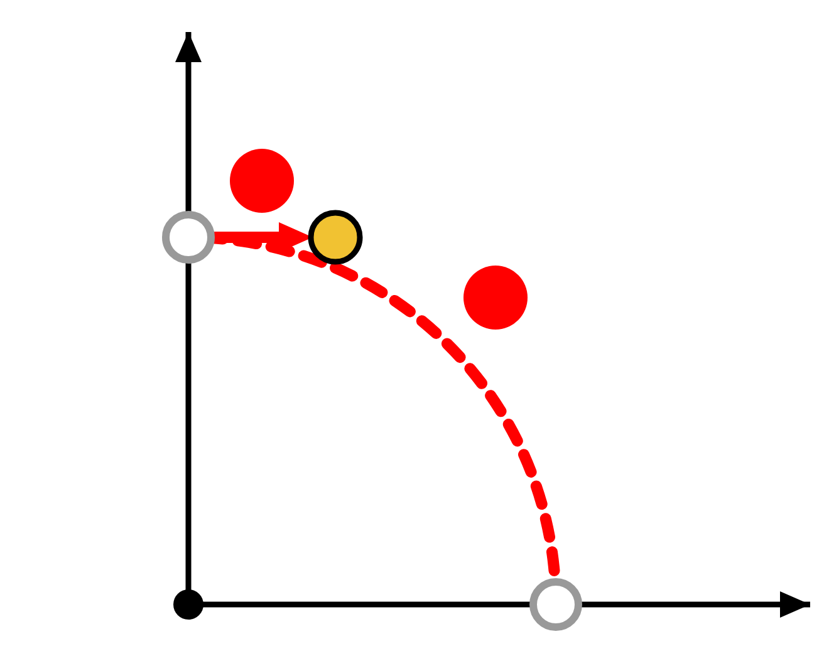
[picture p58: figure]
The point 250, 0 is rotated 90 degrees to 0, 250 and then moved 100 to the right to 100, 250

B · MOVE, THEN ROTATE

R(90°) · T(100, 0) · P

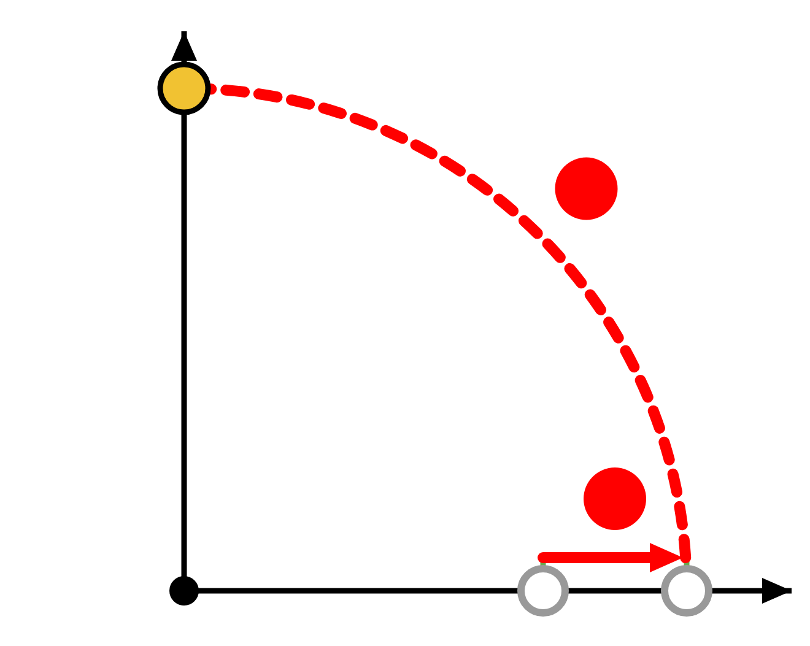
[picture p59: figure]
The point 250, 0 is moved 100 to the right to 350, 0 and then rotated 90 degrees to 0, 350

2

1

1 · Rotate: (0, 250)

2 · Move: (100, 250)

(100, 250)

2

1 · Move: (350, 0)

2 · Rotate: (0, 350)

(0, 350)

1

Same two matrices, different order, different answer. In the arm's chain, the order of the matrices must match the order of the joints.

## Day 1 Recap

(X, Y)

DAY 1 · RECAP

ROTATE

R(θ)

Spins a point by θ around the origin.

MOVE

T(dx, dy)

Moves a point. The extra 1 makes it a matrix.

CHAIN

M = R · T · R · T

One matrix per step. Multiply from the right.

ORDER

R · T is not T · R

Swap two matrices and the answer changes.

Next time: the real arm turns at the base too, so it needs 3D.

## Extending to 3D

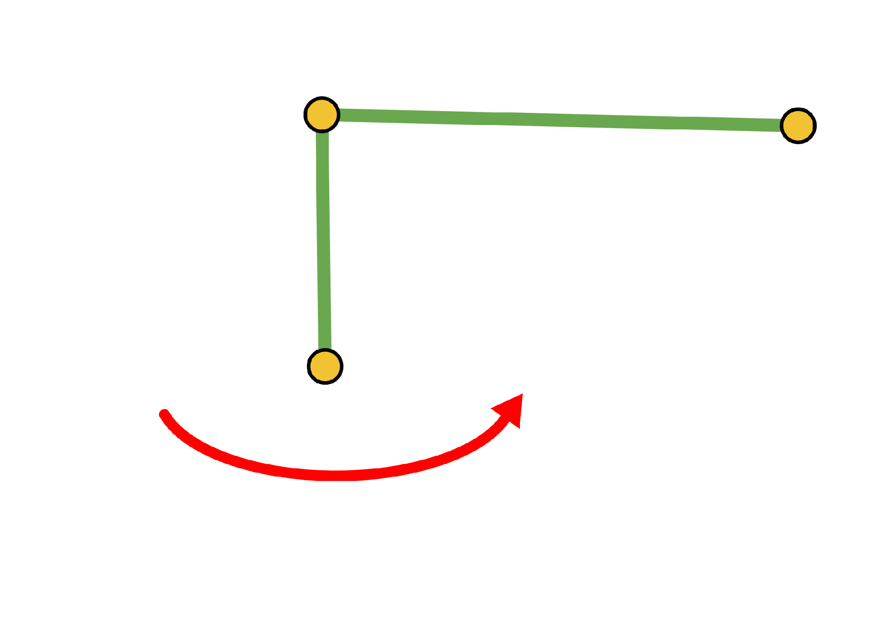
[picture p60: figure]
Three-quarter view of the real arm on its base with an arrow around the base showing that the whole arm turns about the vertical axis
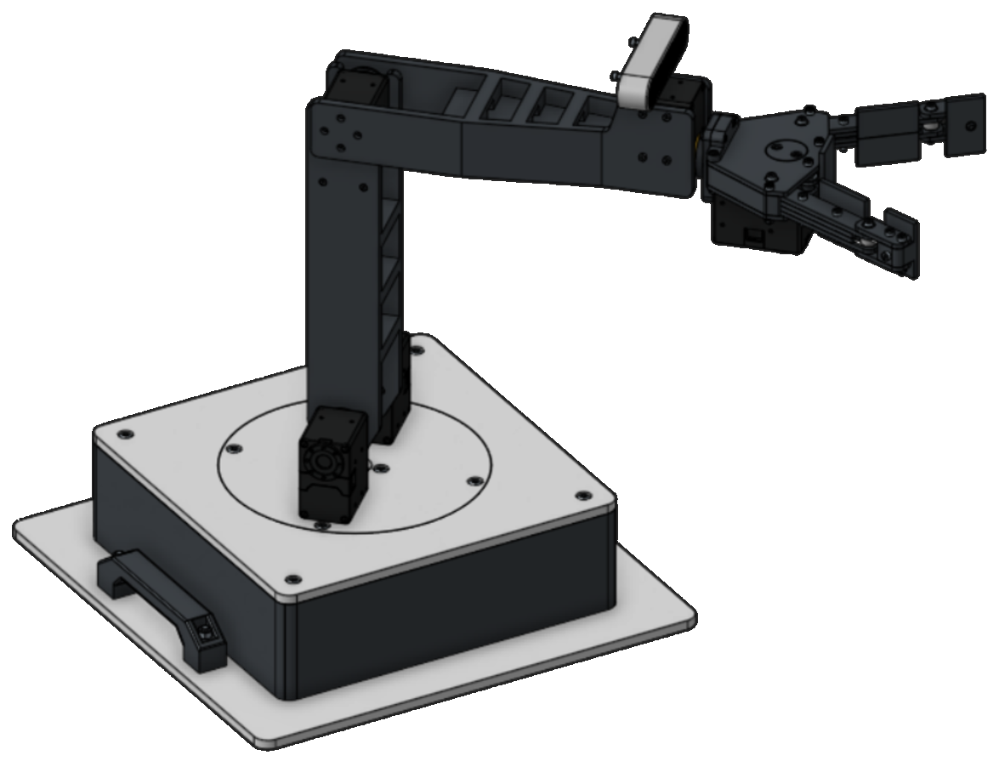
[picture p61: figure]
Three-quarter view of the robotic arm on its base with the gripper open

DAY 2

Day 1 gave us a recipe for a flat arm. Now the base turns, and the same recipe has to work in three dimensions.

θB

DAY 1 IN ONE LINE

M = R(θa) · T(250, 0) · R(θb) · T(250, 0) → (426.78, 176.78)

## The Base Turns the Whole Arm

DAY 2 · THE BASE

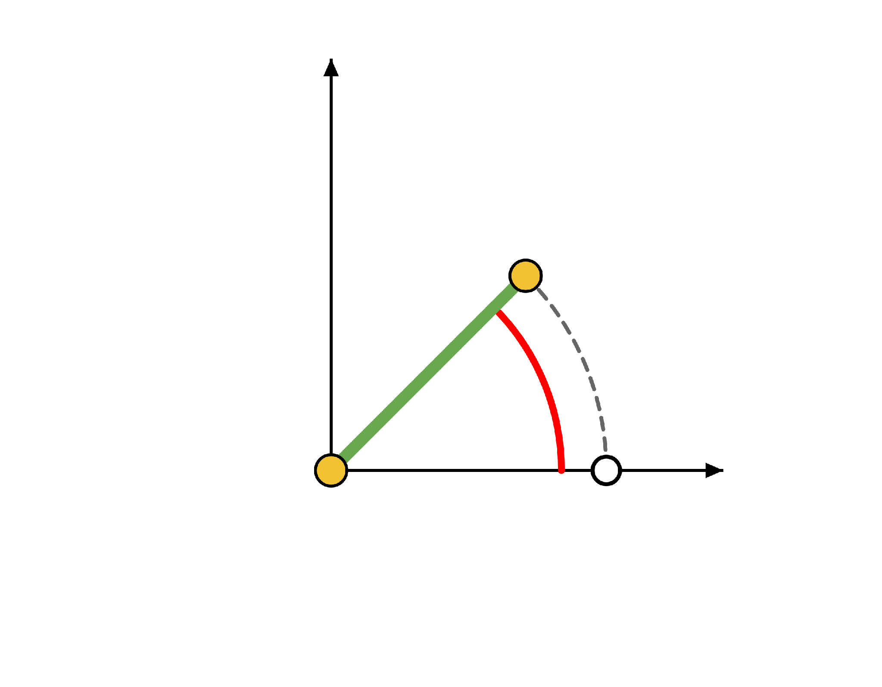
[picture p62: figure]
Top view of the real arm on its base. The base turns the arm's reach line from the x axis to 45 degrees counter-clockwise, and the angle theta B is marked.

y

Day 1's flat arm sits in one vertical plane.

1

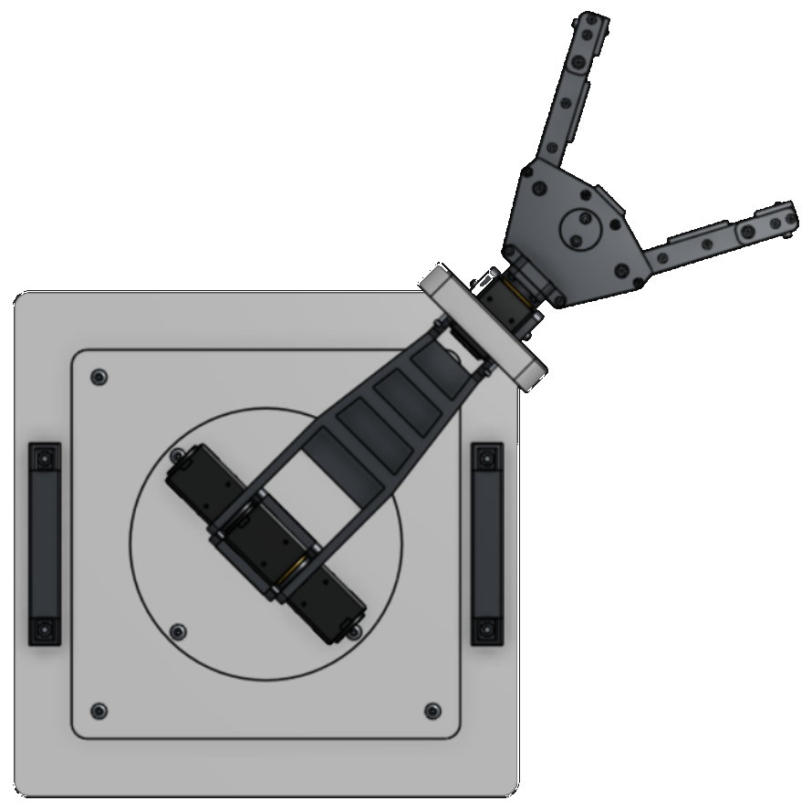
[picture p63: figure]
Top view of the robotic arm on its base, turned 45 degrees from the x axis

The base spins that whole plane around the vertical axis, by θB.

2

So we need 3D: a point is (x, y, z), and each matrix is 4 × 4.

3

θB = 45°

ONE CHANGE OF HABIT

From now on, z points up. Lesson 3 called the
up direction Y.

x

θB = 0°

## Four Numbers Describe Each Joint

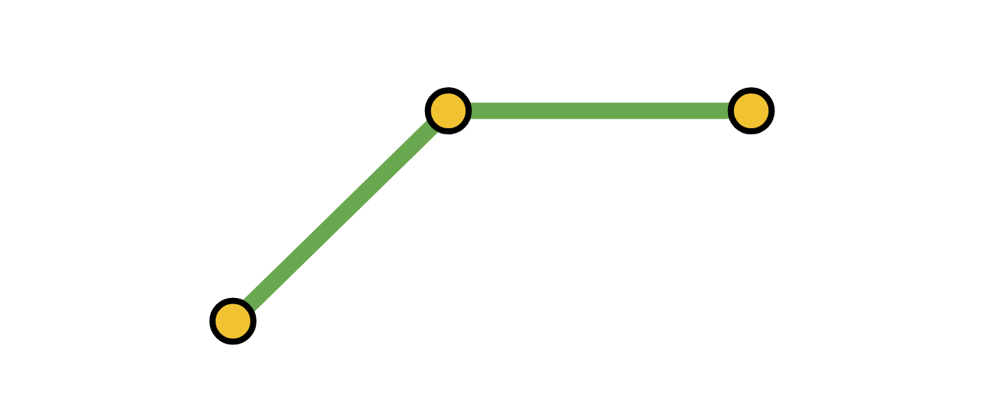
[picture p64: figure]
The real arm with each link marked as 250 millimetres long

DAY 2 · THE FOUR NUMBERS

Each joint is four simple moves, and each move has one number. The values below are for joints 1, 2, 3: base, shoulder, elbow.

a = 250

a = 250

TURN AROUND z

θ

joint angle

How far the joint has turned.

OUR ARM

the only number that changes

SLIDE ALONG z

d

offset

How far the next link is shifted along the joint's axis.

OUR ARM

0 · 0 · 0

SLIDE ALONG x

a

link length

How long the link is.

OUR ARM

0 · 250 · 250 mm

TURN AROUND x

α

link twist

How much the next
joint's axis is tilted.

OUR ARM

90° · 0° · 0°

## One Matrix per Joint

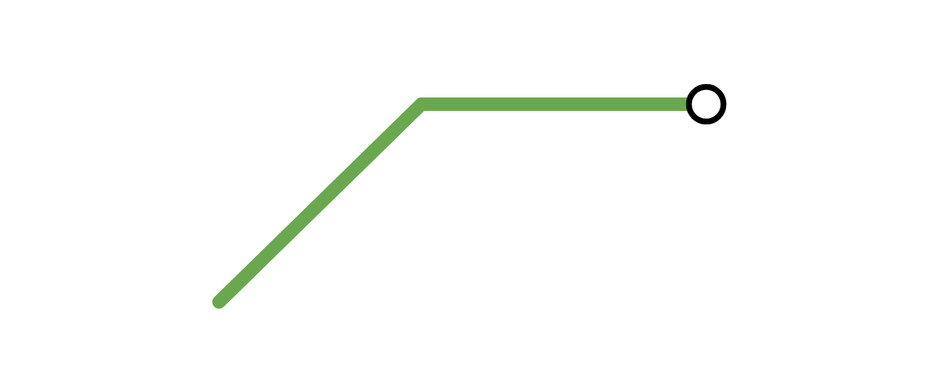
[picture p65: figure]
The real arm with its three joints numbered: 1 base, 2 shoulder, 3 elbow

3

DAY 2 · THE DH MATRIX

2

A = Rz(θ) · Tz(d) · Tx(a) · Rx(α)

turn about z, slide along z, slide along x, turn about x

1

Top-left 3 × 3

how the new frame is turned

sin θ

cos θ

−sin θ cos α

cos θ cos α

sin θ sin α

−cos θ sin α

a sin θ

a cos θ

Last column

where the new frame's origin is

A =

0

sin α

cos α

d

Bottom row

always 0 0 0 1

0

0

0

1

We never expand this by hand.
We plug in one row of the DH
table.

## Placing a Frame on Each Joint

DAY 2 · FRAMES

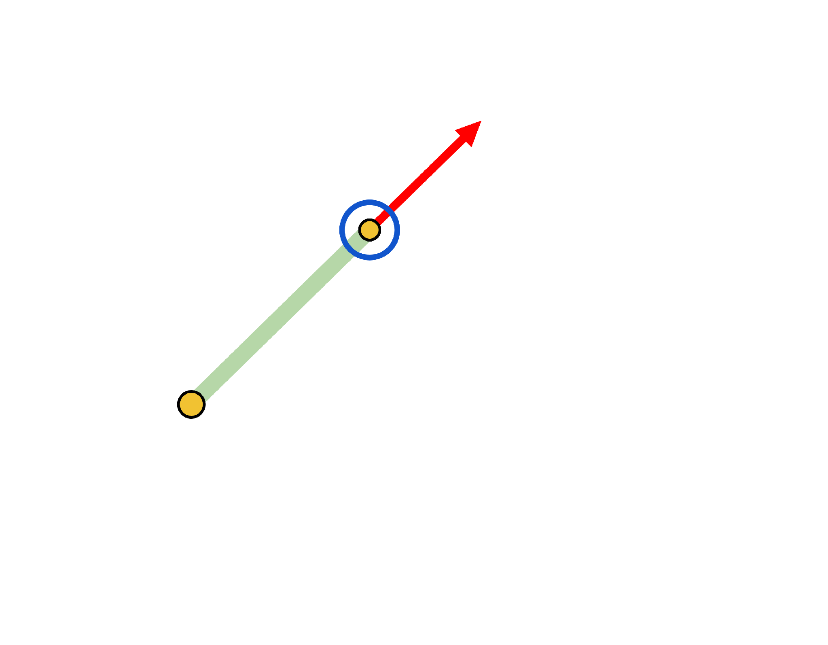
[picture p66: figure]
Side view of the real arm. At the far joint of the upper arm, the elbow, a frame is drawn: the x axis points along the link, away from the previous joint, and the z axis comes out of the page.

z points along the axis the joint turns around.

z

x

x points along the link, away from the previous joint.

z: out of the page

x

link

y is never needed. Once x and z are set, y follows.

previous joint

the frame at this joint

NUMBERING

Frame 0 is fixed on the base. Each later frame sits at the end of a link.

## Frames on Our Arm

DAY 2 · FRAMES

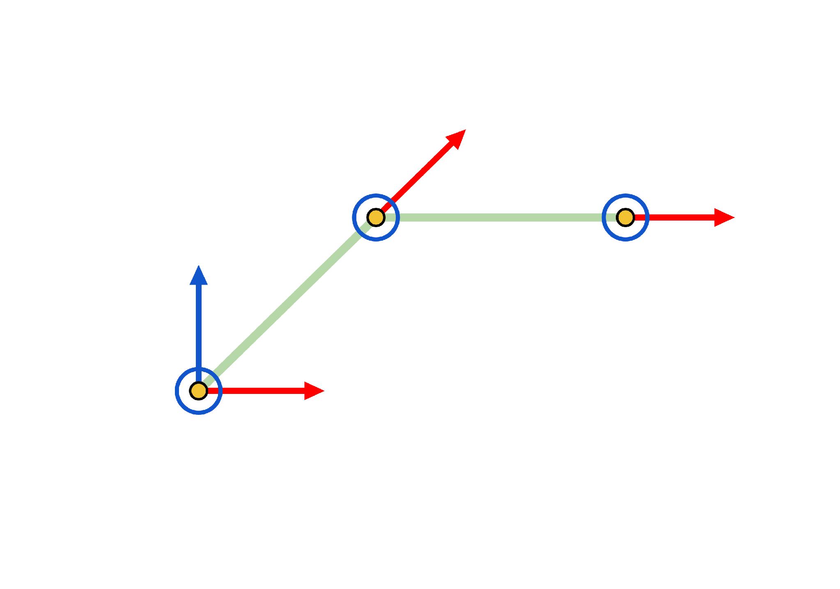
[picture p67: figure]
Side view of the real arm with the shoulder at 45 degrees and the elbow at 45 degrees. Frames 0 and 1 sit at the shoulder, frame 2 at the elbow and frame 3 at the tip. Red arrows are x axes and the blue arrow is the z axis of frame 0; rings with a dot are z axes pointing out of the page.

z₀ points up (the base axis). z₁ comes out of the page (the shoulder axis). Both frames share one origin, since a = 0 and d = 0 for the base.

F₀ F₁

Base and shoulder

x₂

F₂

z₀

x₃

z₂ comes out of the page (the elbow axis).
x₂ runs along the upper arm.

F₂

Elbow

F₃

F₀ F₁

x₀ = x₁

z₃ copies z₂. x₃ runs along the forearm.

F₃

Tip

## Fill In the DH Table

Elbow

3

DAY 2 · THE DH TABLE

Shoulder

Base

2

Joint

θ

d

a

α

ROW i

Row i takes you from frame i − 1 to frame i.

1

1 · Base

?

?

?

?

ASK YOURSELF

θ: what is the joint's angle?

d: does anything slide along z?

a: how long is the link along x?

α: is the next z axis tilted?

2 · Shoulder

?

?

?

?

3 · Elbow

?

?

?

?

## The DH Table for Our Arm

Elbow

3

DAY 2 · THE DH TABLE

Shoulder

Base

2

250

250

Joint

θ

d

a

α

θ column

These change with the pose. The rest are fixed.

1

1 · Base

θB

0

0

90°

Shoulder

θS is measured from vertical, θ from horizontal: θ = 90° − θS.

2 · Shoulder

90° − θS

0

250

0°

Elbow

The elbow bends clockwise, θ counts counter-clockwise: θ = −θE.

3 · Elbow

−θE

0

250

0°

α = 90°

Only the base twists: the shoulder axis
is tilted 90° from the base axis.

## A₁: The Base

DAY 2 · WORKED EXAMPLE

Pose: θB = 45°, θS = 45°, θE = 45°

θ = θB = 45° · d = 0 · a = 0 · α = 90°

HOW TO READ IT

Last column (0, 0, 0): frame 1 sits at the same point as frame 0. Only the direction of its axes changes.

ROW 1

0.7071

0

0.7071

0

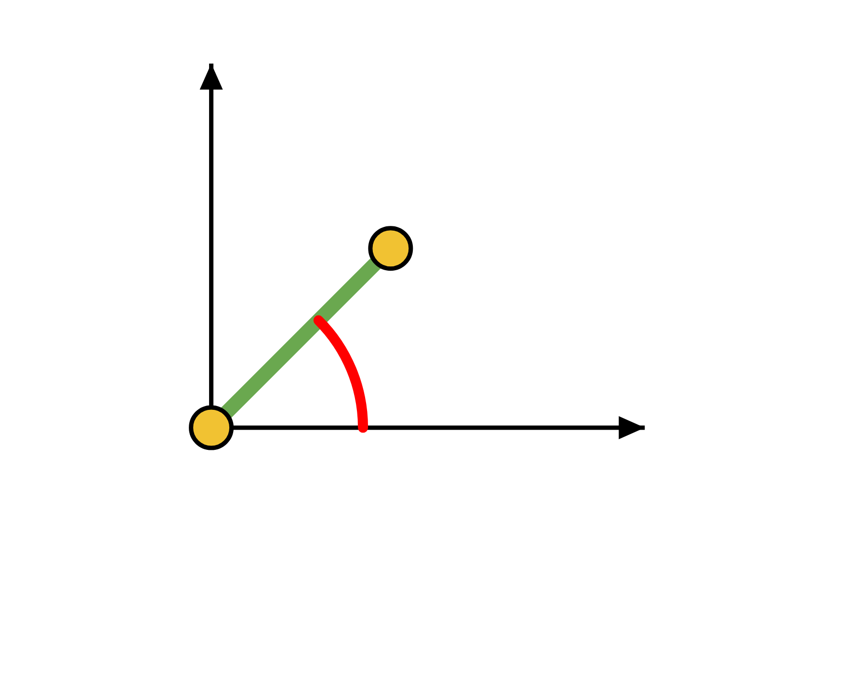
[picture p68: figure]
Top view of the real arm: the base has turned the arm 45 degrees counter-clockwise from the x axis, which is the angle theta in row 1 of the table.

y

A₁ =

0.7071

0

−0.7071

0

0

0

turns the frame

1

0

0

0

where it sits

0

1

θB = 45°

x

F₀ F₁

## A₂: The Shoulder

DAY 2 · WORKED EXAMPLE

Pose: θB = 45°, θS = 45°, θE = 45°

θ = 90° − θS = 45° · d = 0 · a = 250 · α = 0°

HOW TO READ IT

Last column (176.78, 176.78, 0): frame 2 sits 176.78 mm along x₁ and
176.78 mm along y₁, measured in frame 1.

ROW 2

0.7071

−0.7071

0

176.78

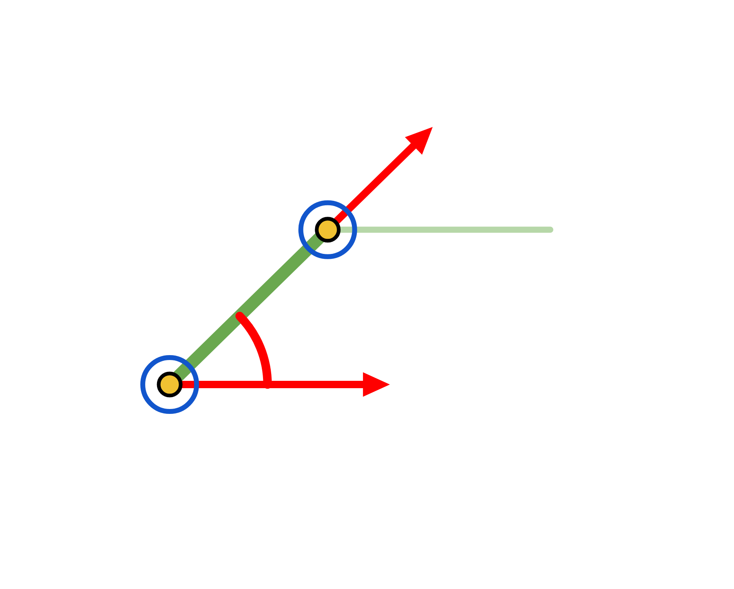
[picture p69: figure]
Side view of the real arm: the upper arm, from frame 1 at the shoulder to frame 2 at the elbow, is 45 degrees above the x axis of frame 1.

A₂ =

0.7071

0.7071

0

176.78

F₂

x₂

0

0

turns the frame

0

0

1

0

0

1

where it sits

F₁

θ = 45°

x₁

## A₃: The Elbow

DAY 2 · WORKED EXAMPLE

Pose: θB = 45°, θS = 45°, θE = 45°

θ = −θE = −45° · d = 0 · a = 250 · α = 0°

HOW TO READ IT

Last column (176.78, −176.78, 0): frame 3 sits 176.78 mm along x₂ and −176.78 mm along y₂, measured in frame 2.

ROW 3

0.7071

0.7071

0

176.78

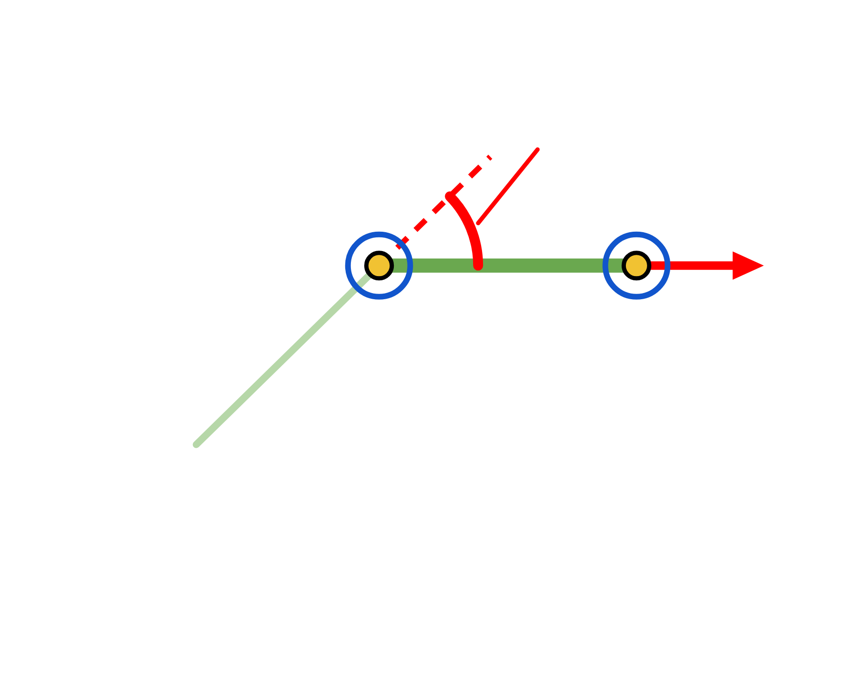
[picture p70: figure]
Side view of the real arm: the forearm, from frame 2 at the elbow to frame 3 at the tip, is bent 45 degrees clockwise from the x axis of frame 2.

A₃ =

−0.7071

0.7071

0

−176.78

F₂

x₂

−45°

0

0

turns the frame

0

0

1

0

0

1

x₃

where it sits

F₃

## Step 1: Multiply A₂ · A₃

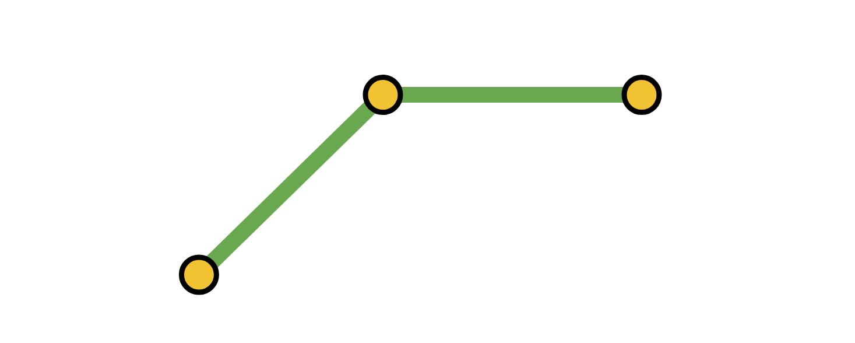
[picture p71: figure]
The real arm with the upper arm marked A2 and the forearm marked A3, together making the flat arm of Day 1

DAY 2 · WORKED EXAMPLE

A₂ and A₃ have parallel z axes, so together they are the flat arm of Day 1.

A₂

A₃

0.7071

−0.7071

0

176.78

0.7071

0.7071

0

176.78

1

0

0

426.78

0

0.7071

0.7071

0

0

1

0

176.78

×

0

−0.7071

0

0.7071

0

1

0

−176.78

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
176.78

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
A₂ · A₃

TOP-LEFT BLOCK

It is the identity matrix. The turns cancel: +45° and −45° make 0°, so frame 3 points the same way as frame 1.

LAST COLUMN

(426.78, 176.78, 0) is Day 1's answer: the tip is
426.78 mm out and 176.78 mm up, in the plane of
the arm.

## Step 2: Multiply A₁ · (A₂ · A₃)

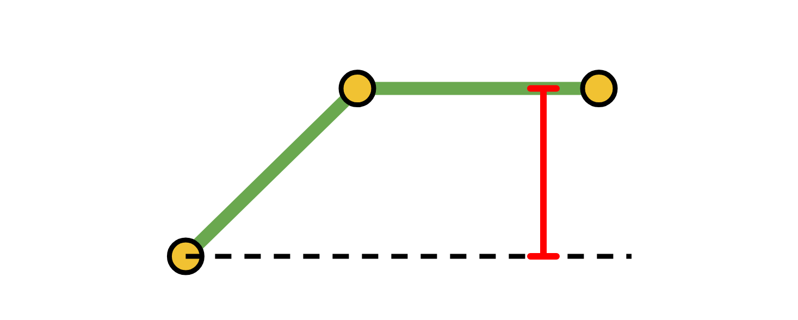
[picture p72: figure]
The real arm with the height of the end effector above the shoulder marked 176.78 millimetres

DAY 2 · WORKED EXAMPLE

Now add the base turn. The last column is the answer.

z = 176.78

THE TIP POSITION

(x, y, z) = (301.78, 301.78, 176.78) mm

Day 1 gave a reach of 426.78 mm. The base turn of 45° splits it: 426.78 × cos 45° = 301.78 for x, and 426.78 × sin 45° = 301.78 for y. The height z = 176.78 does not change.

0.7071

0

0.7071

0

1

0

0

426.78

0.7071

0

0.7071

301.78

0

0.7071

0

1

0

−0.7071

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
176.78

=

0

0.7071

0

1

0

−0.7071

301.78

176.78

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
T = A₁ · A₂ · A₃

1

A₁

A₂ · A₃

y = 301.78

TOP VIEW

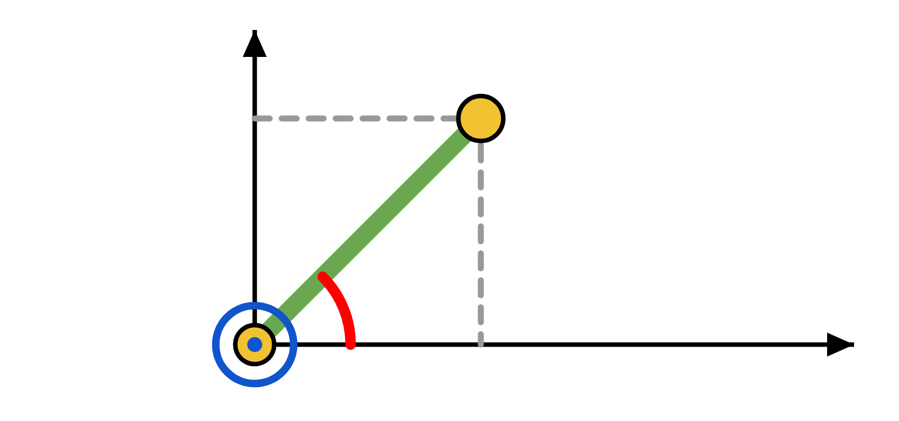
[picture p73: figure]
Top view: the tip is at x equals 301.78 and y equals 301.78, because the 426.78 millimetre reach points 45 degrees from the x axis.

y

426.78

x = 301.78

x

## Same Answer as Lesson 3

DAY 2 · CHECK

z = 176.78

LESSON 3 · TRIGONOMETRY

Triangles give a reach R and a height h.

LESSON 4 · DH MATRICES

The last column of T = A₁ · A₂ · A₃.

X

= 301.78

=

x

= 301.78

Y

Z

= 176.78

= 301.78

up

y

z

= 301.78

= 176.78

up

SAME NUMBERS, DIFFERENT LETTERS

Lesson 3 put up on Y. Lesson 4 puts up on z. So Lesson 3's Y is z here, and its Z is y.

WHY THEY MATCH

Both methods describe the same arm in the same pose, so they land on the same point.

## Try It Yourself #4

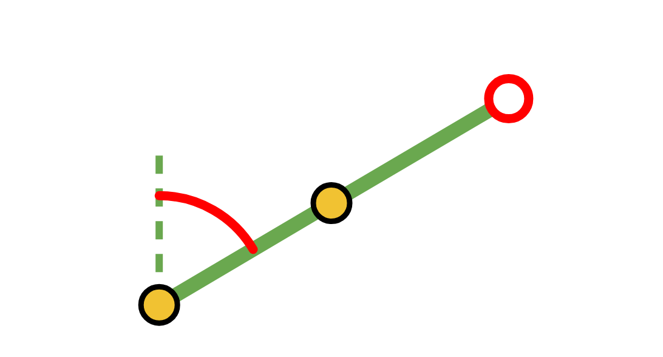
[picture p74: figure]
The real arm in the pose of the practice problem; the tip position is the unknown

DAY 2 · TRY IT YOURSELF

θS = 60°

Find the tip position (x, y, z).

L₁ = L₂ = 250 mm

θB = 30°

θS = 60°

θE = 0°

(x, y, z) = (?, ?, ?)

Joint

θ

d

a

θE = 0°

α

1 · Base

?

0

0

90°

2 · Shoulder

?

0

250

0°

3 · Elbow

?

0

250

0°

TIP POSITION (x, y, z) IN MM

(375.00, 216.51, 250.00)

The same arm shape as Try It Yourself #3, with the base turned 30°.

SOLUTION

θ column: 30°, 90° − 60° = 30°, 0°

θ = 90° − θS for the shoulder and θ = −θE for the elbow.

## Try It Yourself #5

θE = 90°

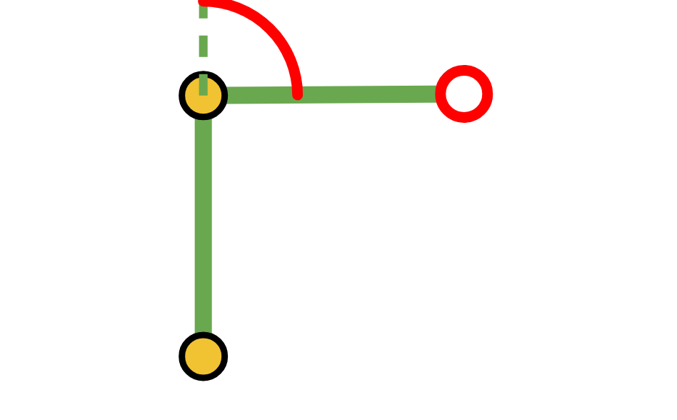
[picture p75: figure]
The real arm in the pose of the practice problem; the tip position is the unknown

DAY 2 · TRY IT YOURSELF

θS = 0°

Find the tip position (x, y, z).

L₁ = L₂ = 250 mm

θB = 120°

θS = 0°

θE = 90°

(x, y, z) = (?, ?, ?)

Joint

θ

d

a

α

1 · Base

?

0

0

90°

2 · Shoulder

?

0

250

0°

3 · Elbow

?

0

250

0°

TIP POSITION (x, y, z) IN MM

(−125.00, 216.51, 250.00)

z = 250: the upper arm stands straight up and the forearm lies flat.

SOLUTION

θ column: 120°, 90° − 0° = 90°, −90°

θB = 120° turns the arm past the y axis, so x is negative.

## Check It with Code

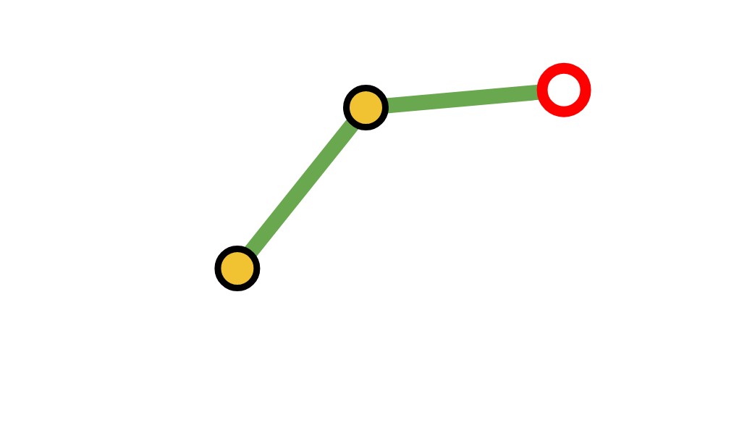
[picture p76: figure]
Three-quarter view of the real arm on its base with its joints marked

(x, y, z)

DAY 2 · CHECK WITH CODE

PYTHON

from dh_helper import dh_matrix, position

thetaB, thetaS, thetaE = 45, 45, 45

A1 = dh_matrix(thetaB, 0, 0, 90)

A2 = dh_matrix(90 - thetaS, 0, 250, 0)

A3 = dh_matrix(-thetaE, 0, 250, 0)

T = A1 @ A2 @ A3

print(position(T))

OUTPUT

[301.78, 301.78, 176.78]

The same as the hand calculation.

CHECK YOUR ANSWERS

Change the three angles in line 2 to the values from Try It Yourself #4 and #5.

WHAT EACH PART DOES

dh_matrix builds one matrix from one row of the table. @ multiplies matrices. position reads the last column.

## Trigonometry vs. DH Matrices

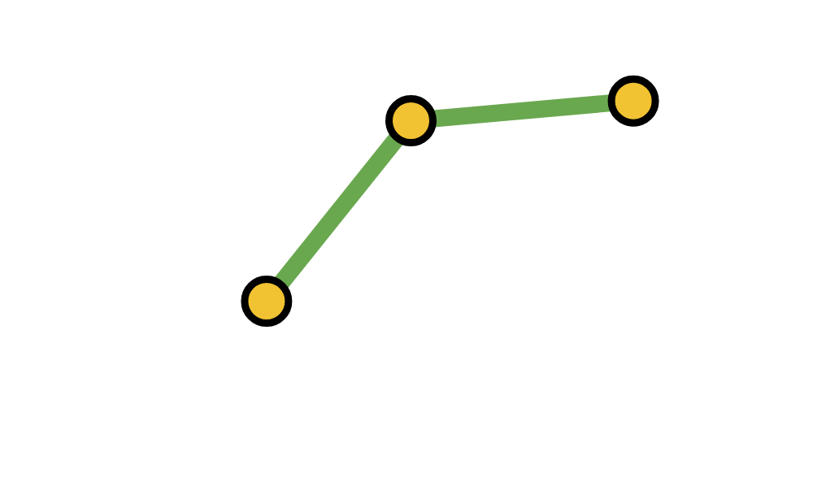
[picture p77: figure]
Three-quarter view of the real arm on its base with its joints marked

DAY 2 · COMPARISON

LESSON 3 · TRIGONOMETRY

Quick for one or two joints

Easy to picture with triangles

New triangles for every new joint

Gets messy when the arm tilts in 3D

LESSON 4 · DH MATRICES

The same recipe for every joint

A computer can do the multiplying

A standard way to describe robot arms

More setup: frames and a table

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
Both methods give the same answer. DH keeps working as the arm gets bigger.

## What We Learned

DAY 2 · WRAP-UP

Every joint becomes one matrix, built from four numbers: θ, d, a, α.

NEXT TIME · LESSON 5

Code Implementation of FK & Other Methods

We turn forward kinematics into code, then take a short look at screw theory, another way to describe the same arm.

1

Frames: z is the joint axis, x is the link.

2

Multiply the matrices in joint order: T = A₁ · A₂ · A₃.

3

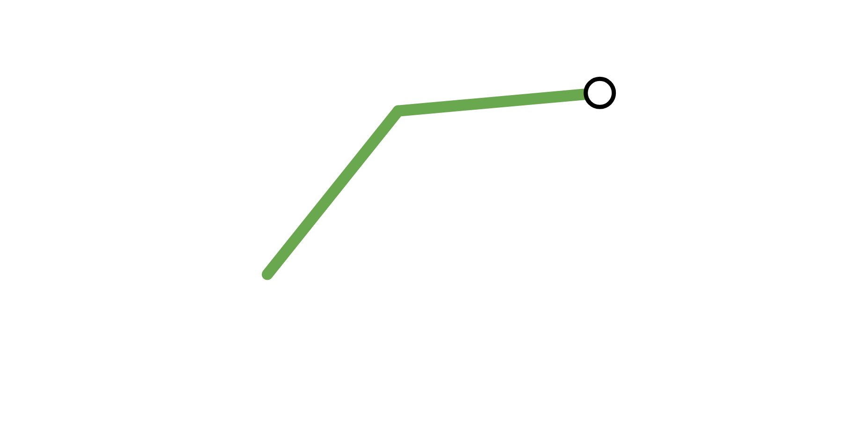
[picture p78: figure]
Three-quarter view of the real arm on its base with the base, shoulder and elbow numbered 1, 2 and 3 and the tip marked T

The last column of T is the tip position (x, y, z).

4

3

T

2

1
