balu-lab/cabs-PETFAB-Hammer-Joshua/PETFAB-Armadillo/Curriculum/Lesson 1/Intro to Robo Arm.pptx

## Introduction to the Robotic Arm

By Joseph Ruhan

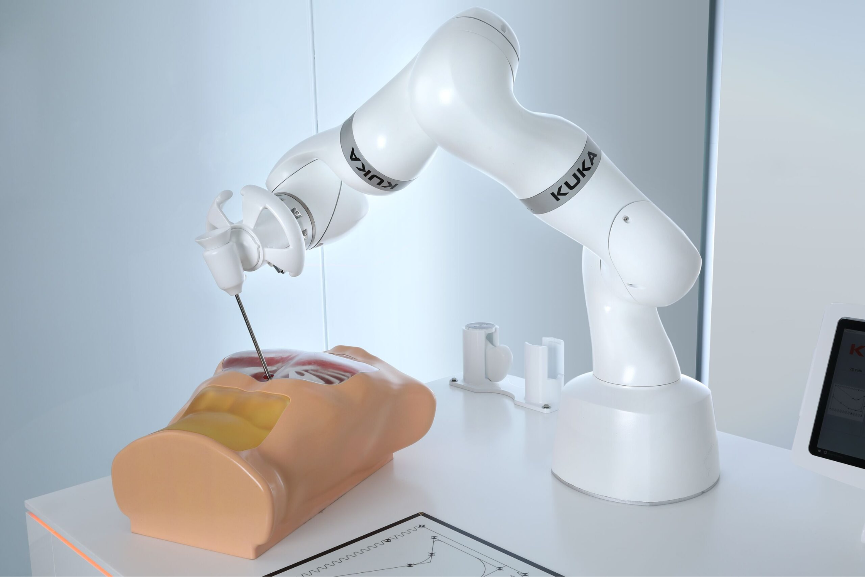
[picture p79: figure]
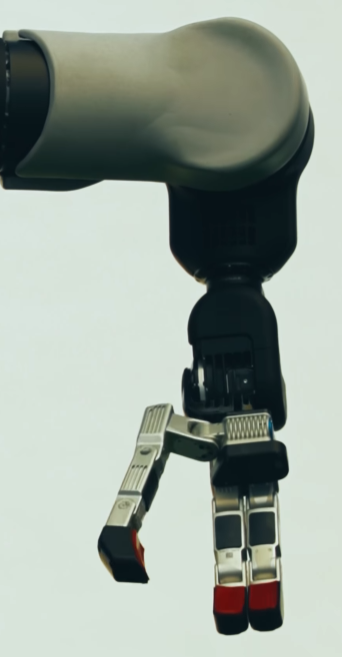
[picture p80: figure]
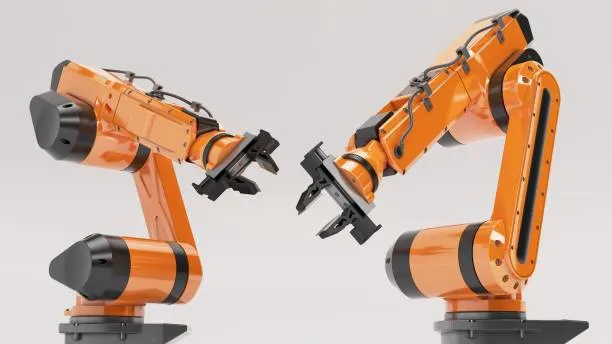
[picture p81: figure]
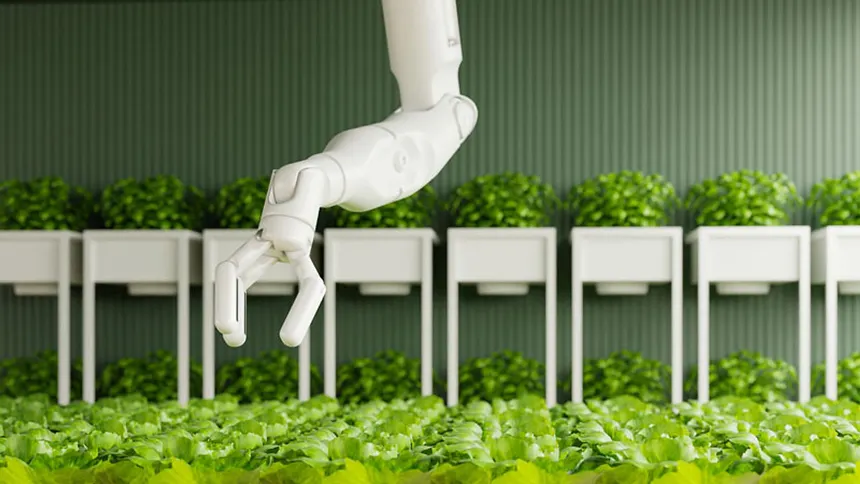
[picture p82: figure]

## What Defines a Robotic Arm?

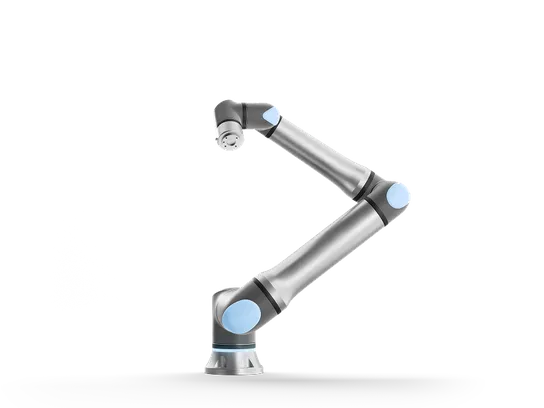
[picture p83: figure]

Image Credit: Universal Robots (https://www.universal-robots.com/products/ur-series/)

End Effector

Rigid Links

Joints

## Joints

Joints are the rotating connections between segments of the arm. Joints are powered by actuators.

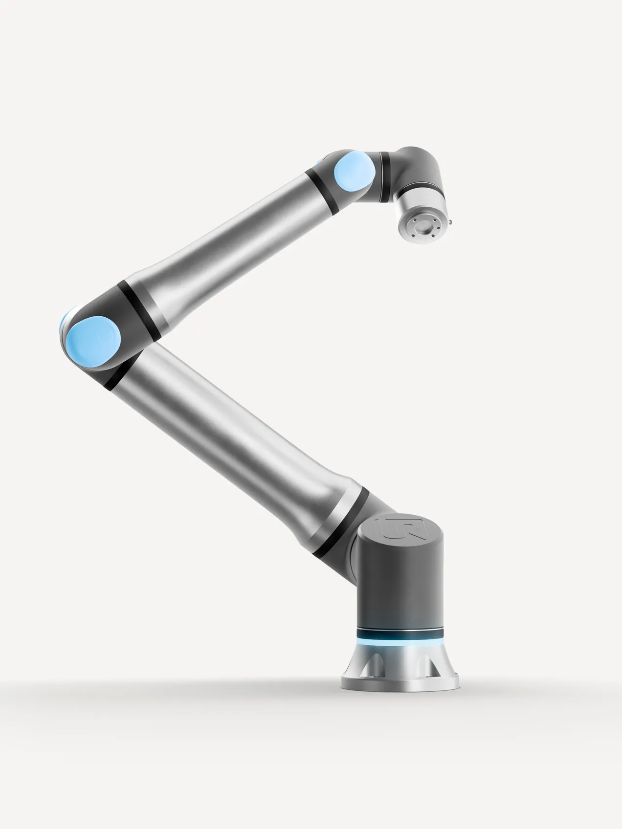
[picture p84: figure]
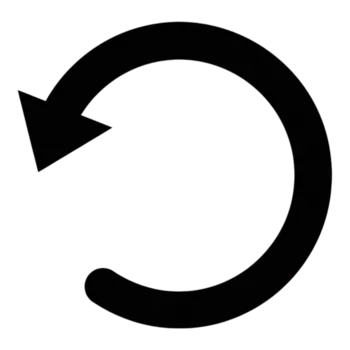
[picture p85: figure]

Joints

Image Credit: Universal Robots (https://www.universal-robots.com/products/ur-series/)

## Actuators

Actuators are the components that drive rotation of joints.
They are most often composed of a motor and a gearbox.

Gearboxes are sets of gears that reduce speed in exchange for increasing torque.

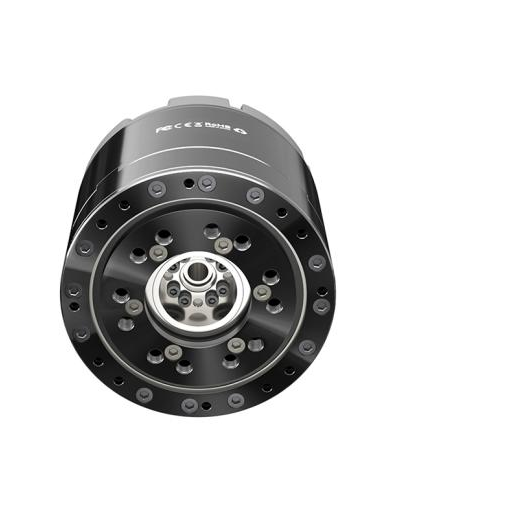
[picture p86: figure]

Image Credit: CubeMars (https://www.cubemars.com/product/akh70-48-v-1-0-kv41-hollow-shaft-planetary-actuator.html)

## Encoders

Encoders measure the rotation of an actuator.

They measure rotation by measuring the strength of a magnetic field of a magnet attached to the actuator’s rotation.

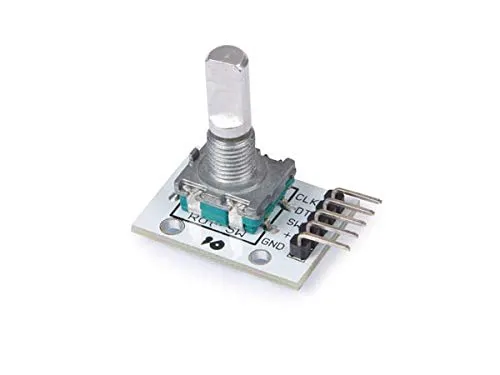
[picture p87: figure]

## Rigid Links

Rigid Links are the solid connections between joints.
They can take many forms, such as solid tubes or flat plates.

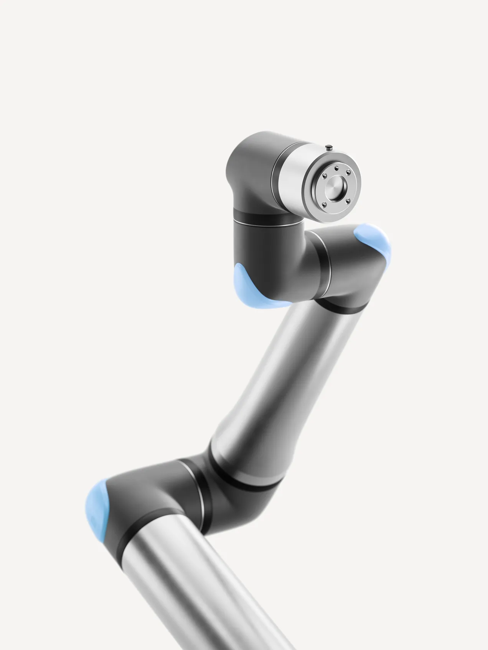
[picture p88: figure]

Rigid Links

Image Credit: Universal Robots (https://www.universal-robots.com/products/ur-series/)

## End Effectors

End effectors are the tool at the end of the robotic arm.
End effectors are the part that allows a robotic arm to achieve a specific task. They have multiple forms as hands, sensors, scissors, and many other tools.

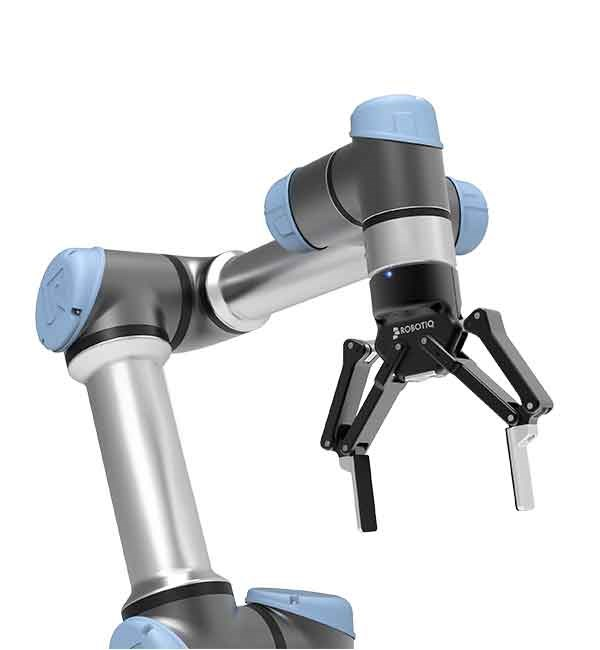
[picture p89: figure]

Image Credit: Universal Robots (https://www.universal-robots.com/products/ur-series/)

End Effector

## Gripper

One of the most common types of end effectors are grippers. They are used to hold or manipulate objects.

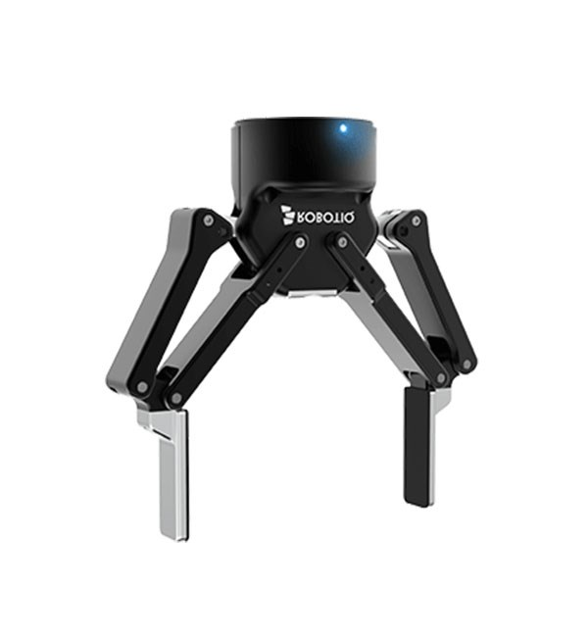
[picture p90: figure]

Gripper

Image Credit: Universal Robots (https://www.universal-robots.com/products/ur-series/)

## Degrees of Freedom

Degrees of Freedom (DOF) refer to the number of axes of rotation that determine the position of the end effector.

More degrees of freedom enables more positions for the robotic arm to use.

Robotic arms typically do not exceed 6 DOF because 6 DOF robotic arms are able to reach most useful positions.

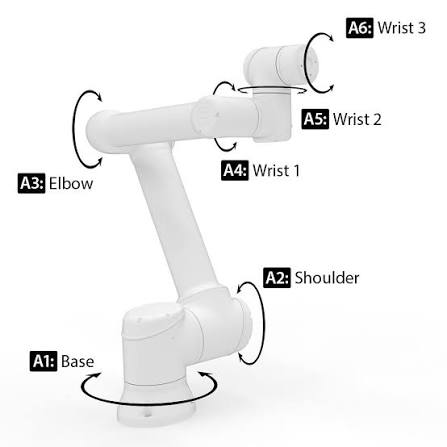
[picture p91: figure]

Image Credit: Universal Robots (https://www.universal-robots.com/products/ur-series/)

## In This Course

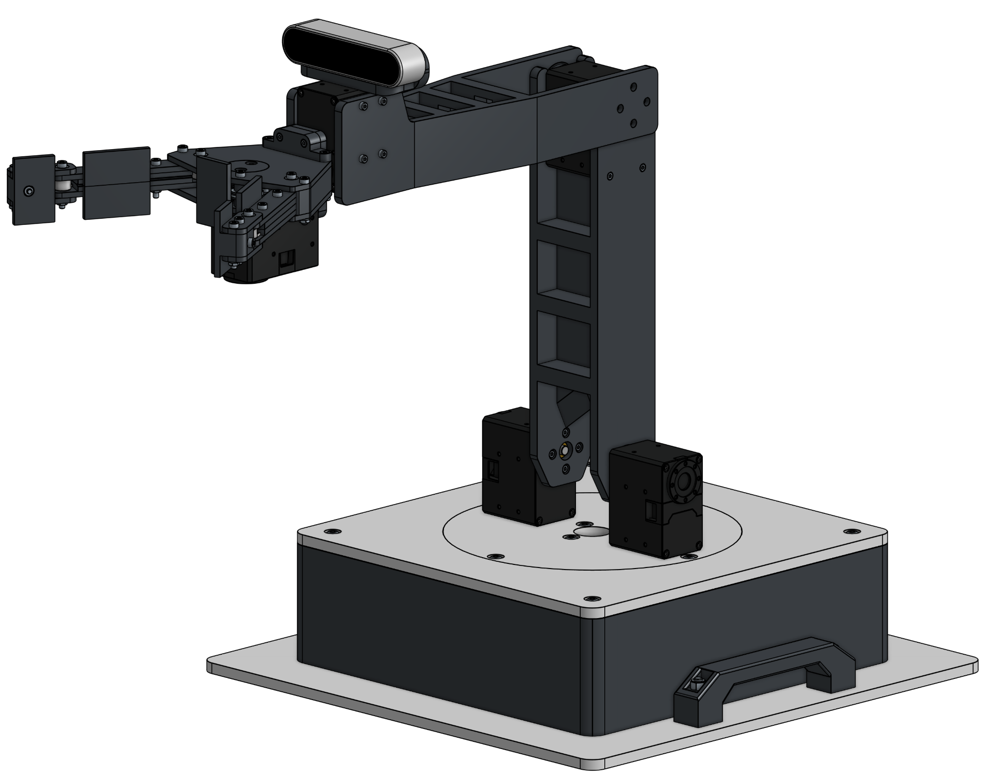
[picture p92: figure]

4 DOF

Rigid Links

Gripper

Joints

## In This Course: Joints & Degrees of Freedom

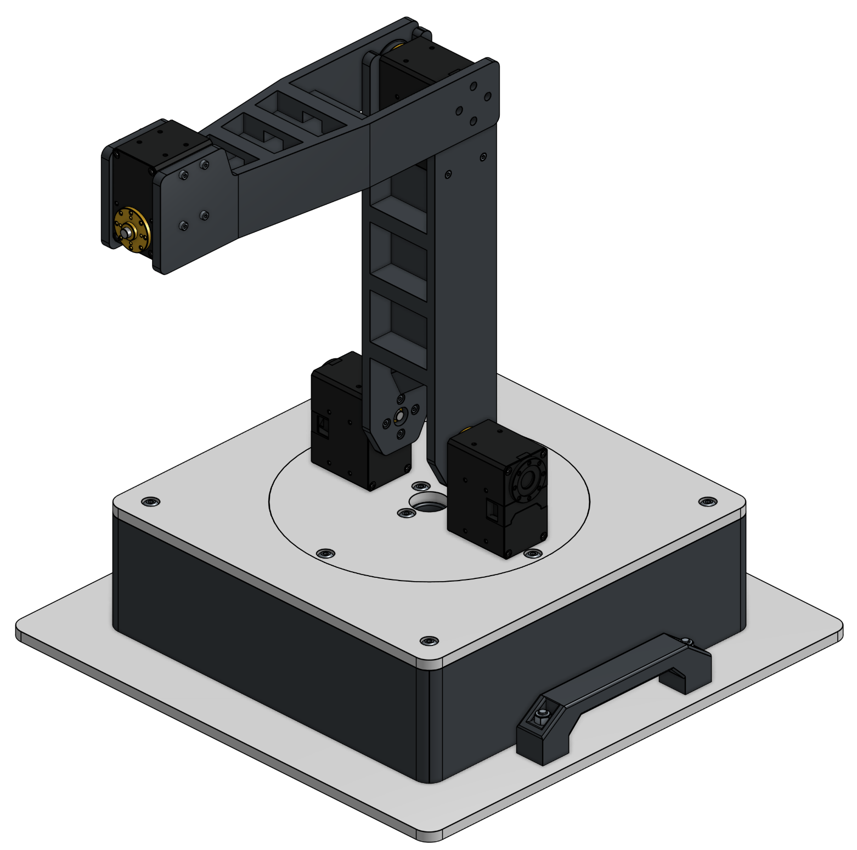
[picture p93: figure]

Each joint in this arm corresponds to a DOF.
This course will use a 4 DOF robotic arm.
A 4 DOF robotic arm is able to provide valuable experience in control while not being as complex as a 6 DOF arm.

3.

4.

2.

1.

1. Base
2. Shoulder
3. Elbow
4. Wrist

## In This Course: Actuators

This arm uses Robotis Dynamixel XM54-W270-T actuators.

They contain a motor, gearbox, encoder, among other components necessary for actuator control.

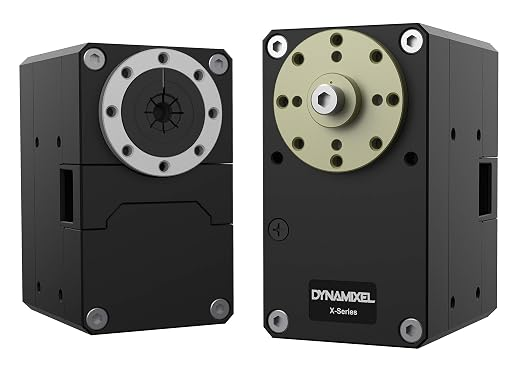
[picture p94: figure]

## In This Course: Rigid Links

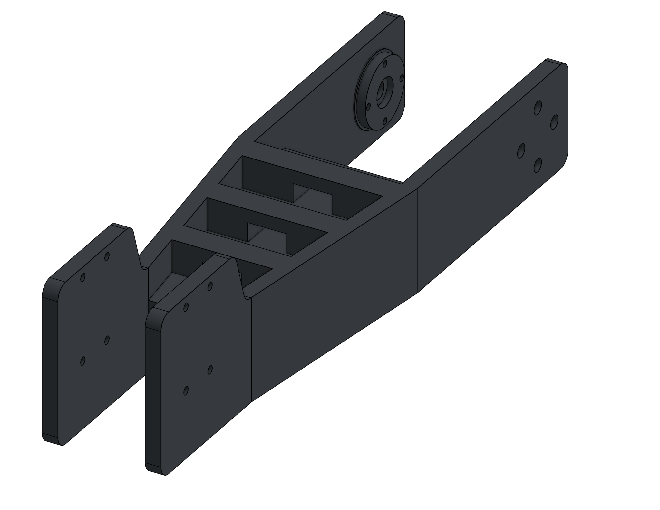
[picture p95: figure]

Lower Arm

This arm uses 3D printed segments to join the actuators together.
These are named corresponding to a portion of a human arm relative to the position of the shoulder (the bottom joint)

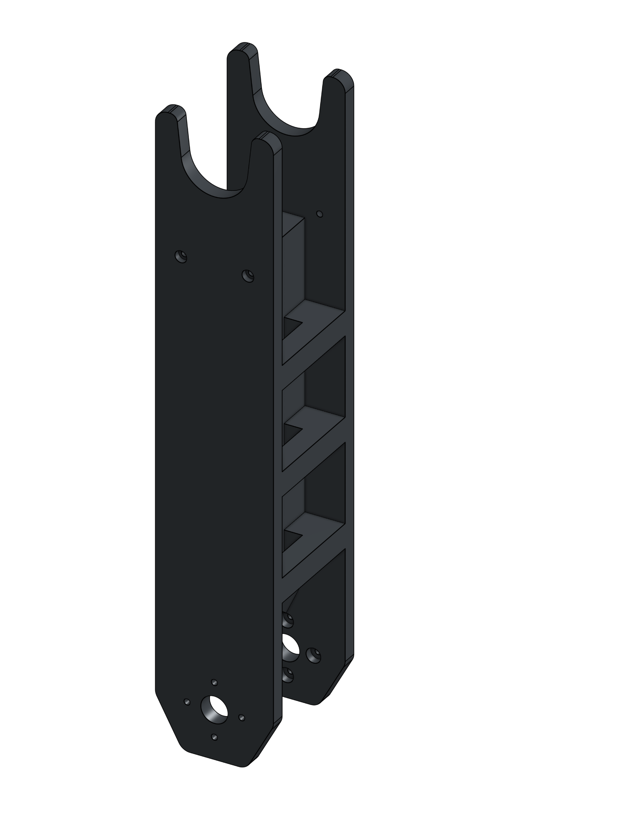
[picture p96: figure]

Upper Arm

## In This Course: End Effectors

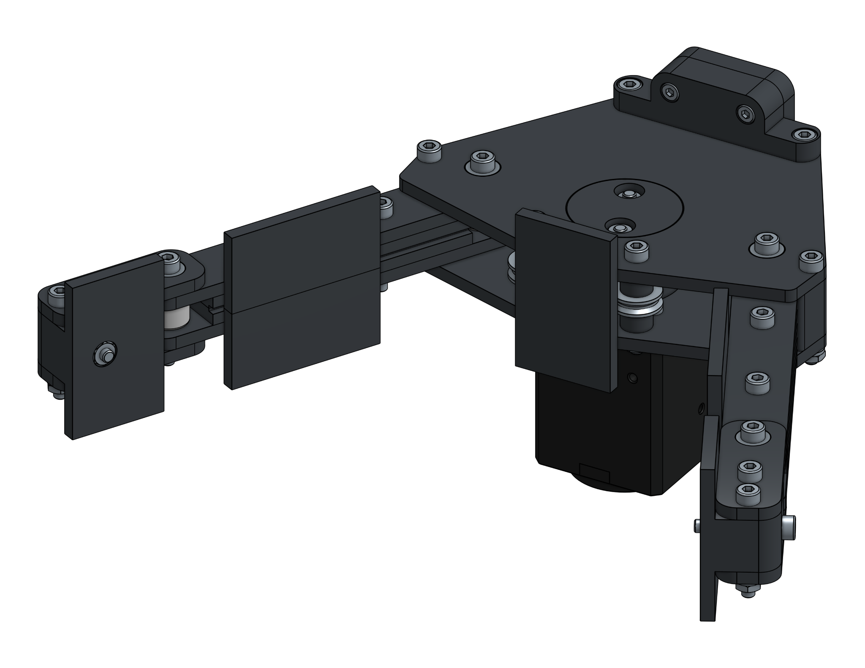
[picture p97: figure]

This arm uses a gripper design.
This arm’s gripper uses two fingers to hold objects.

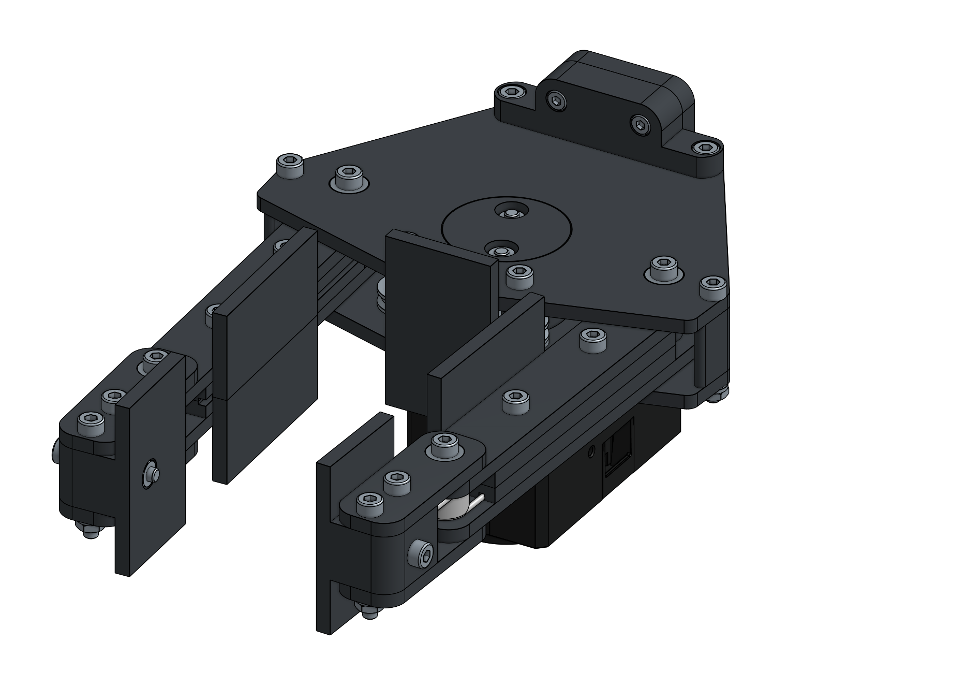
[picture p98: figure]

## In This Course: Workspace

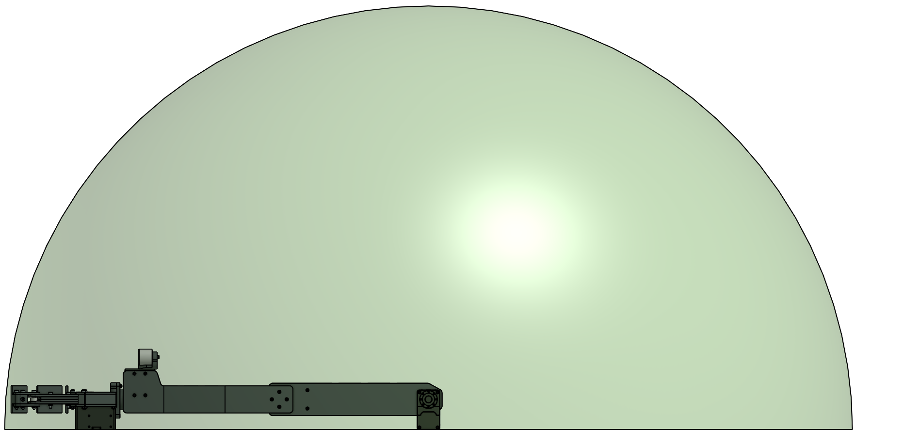
[picture p99: figure]

Workspace refers to the volume in which the arm can reach. It is best represented in this case by a hemisphere with the radius of the reach of the arm.

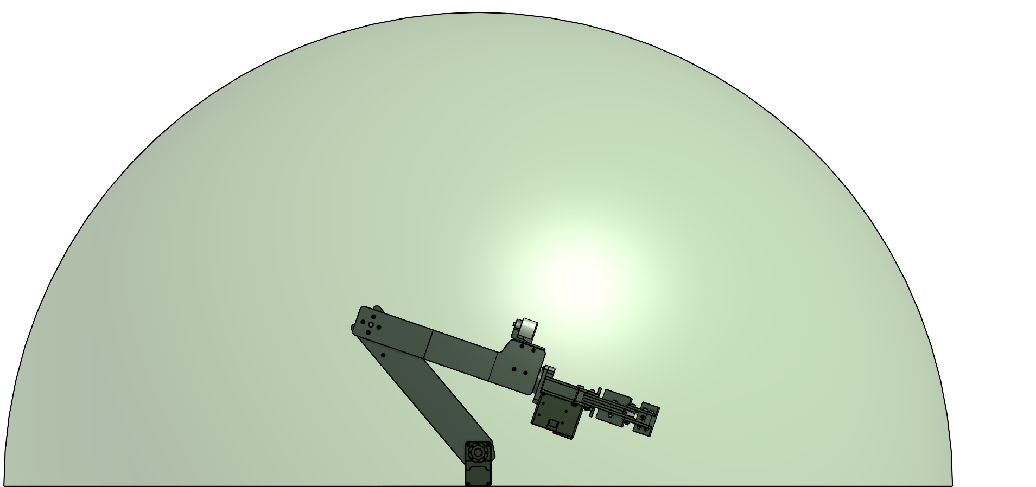
[picture p100: figure]

## In This Course: Forward Kinematics

Workspace refers to the mathematical approaches to determine the position of the arm using known joint angles.

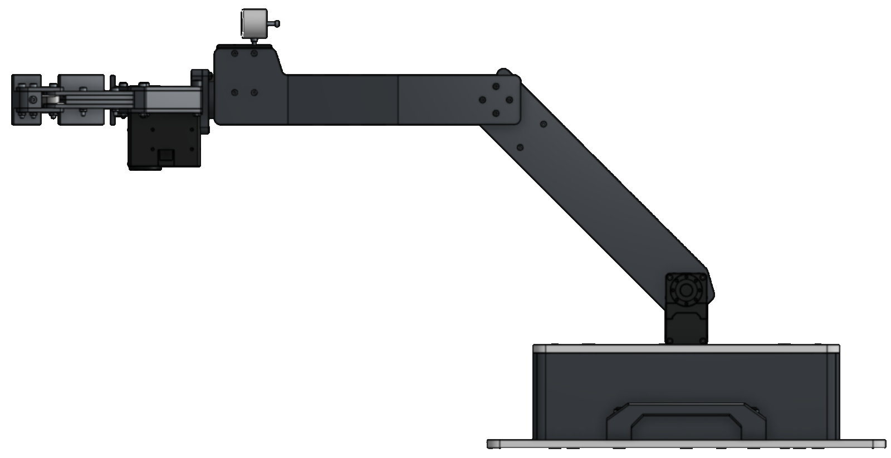
[picture p101: figure]

θ2

θ1

## In This Course: Forward Kinematics

Workspace refers to the mathematical approaches to determine the joint angles of the arm given a desired end position.

(X,Y)

## Why Robotic Arms? - Industry

Robotic arms provide versatility in movement.
This allows them to complete tasks other machines would not be able to accomplish.
Stretch (top video) uses the movement of a robotic arm to reach inside boxes and place them in any location

The welding robot uses the robotic arm to follow complex and varied paths to most effectively weld.

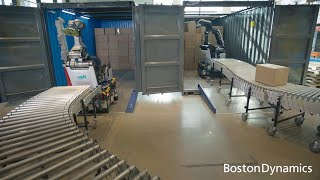
[picture p102: figure]
Meet Stretch, a prototype of our new robot designed to automate box moving tasks in warehouses and distribution centers. Stretch’s mobile base allows it to go to where repetitive box lifting is required - unloading trucks, building pallets of boxes and order building. Stretch makes warehouse opera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
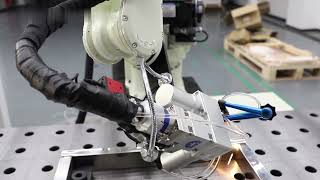
[picture p103: figure]
Automatic robotic welding for precision and efficiency. Experience the power of robotic arm welding automation with XT LASER: ✅ Strong and precise welding seams ✅ High-speed, stable performance ✅ Reduced labor costs & improved efficiency Ideal for automotive manufacturing, aerospace, construction,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

## Why Robotic Arms? - Agriculture & Healthcare

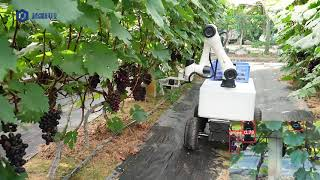
[picture p104: figure]
Dobot CR cobot

The grape picking robot uses the versatility of a robotic arm to adapt to unpredictable locations of grapes. The robotic arm allows the robot to pick grapes at many positions.
The da Vinci Surgical System (bottom image) utilizes four robotic arms to enhance a doctor’s precision. The use of robotic arms enables the system to be versatile and perform complex tasks.

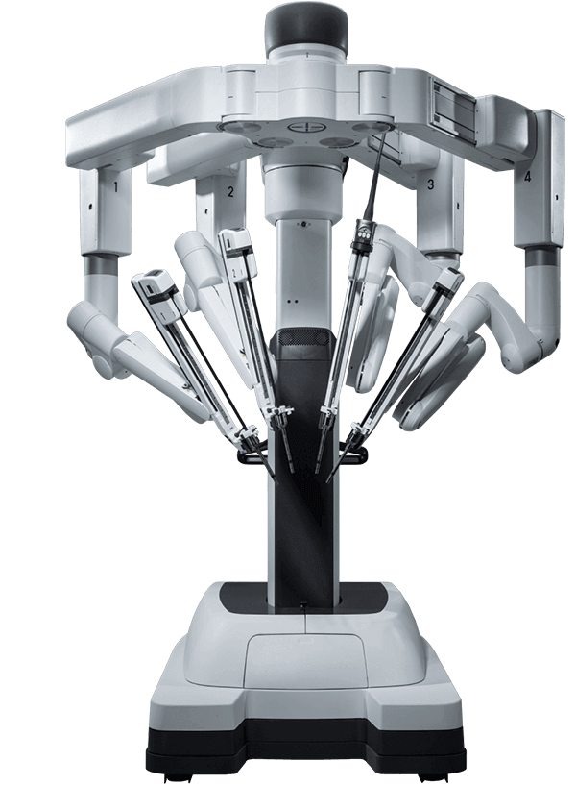
[picture p105: figure]

## Why Robotic Arms? - Service

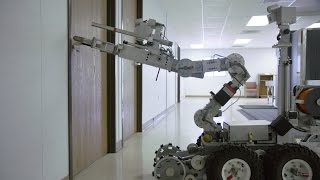
[picture p106: figure]
Northrop Grumman Remotec, a division of one of the largest military contractors in the country, outfits militaries and over 400 US civilian bomb squads with their Andros robot - a machine capable of assessing suspicious packages and diffusing bombs. Video by Ali Withers, David Nicholson ----------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

Bomb defusal robots use robotic arms to interact with dangerous payloads. Robotic arms allow one robot to access many locations and interact with many items.
Humanoid robots use robotic arms as we do. Robotic arms are the most general solution to interaction with the world. Robotic arms allow for the widest variety of movement and greatest versatility.

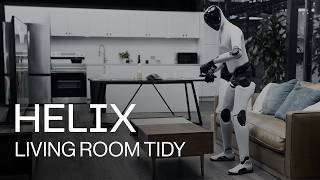
[picture p107: figure]
A little over a month ago we released Helix 02, a single neural system that controls the full body directly from pixels, enabling dexterous, long horizon autonomy across an entire room. After cleaning up a kitchen, Helix 02 is now taking on another everyday task: tidying up a living room.

## Robotic Arm Safety

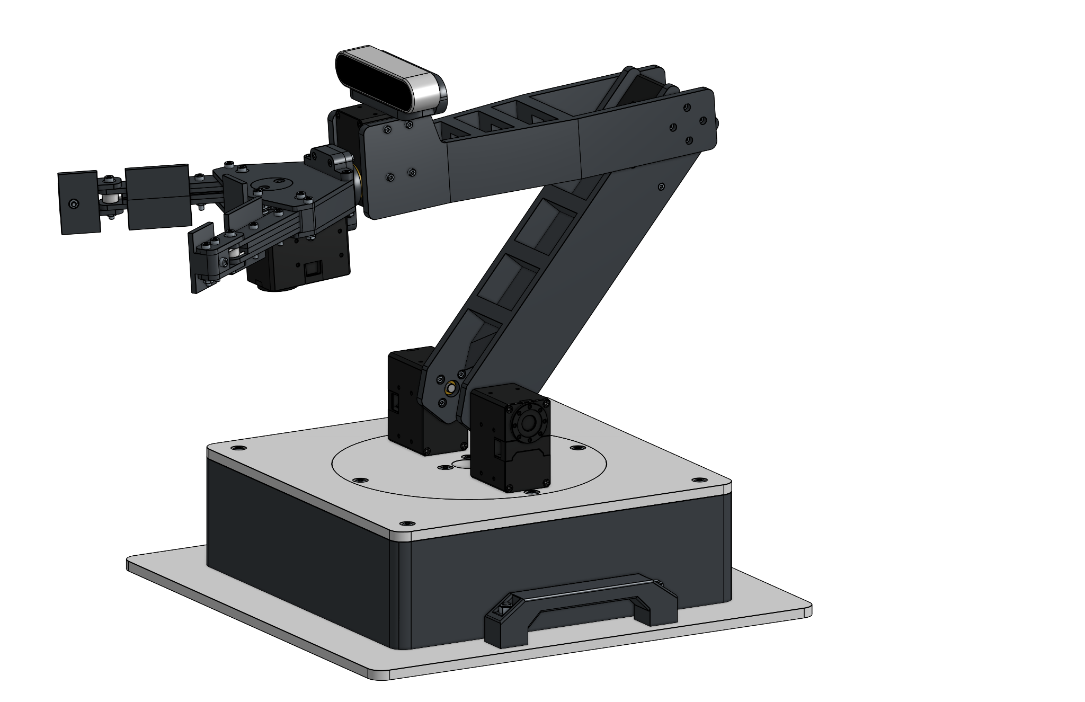
[picture p108: figure]

Do not put your fingers in between the upper and lower arm segments. You can get pinched by the sharp walls.

## Robotic Arm Safety

While the arm is powered on, do not get too close to it.

If the arm acts in an unexpected way, turn the power off immediately.

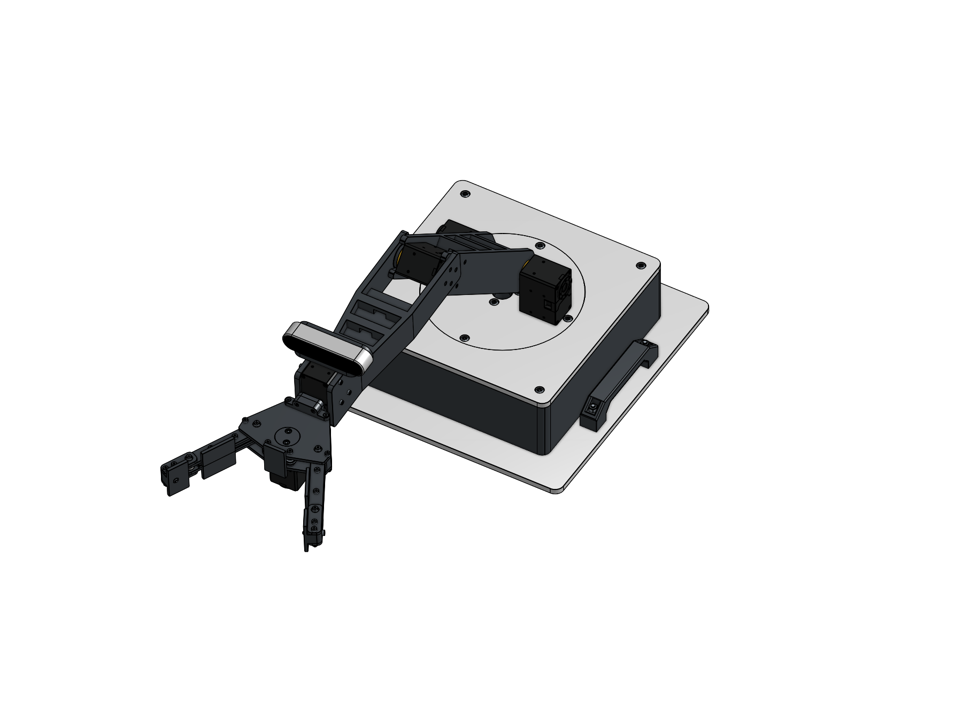
[picture p109: figure]
