balu-lab/cabs-PETFAB-Hammer-Joshua/PETFAB-Armadillo/Curriculum/Lesson 1/Lesson Plan 1 - Introduction to the Robotic Arm.docx

# Introduction to the Robotic Arm

## Summary:

This lesson introduces students to the fundamental structure and vocabulary of a robotic arm, including its core components and the concept of degrees of freedom. It establishes the purpose of the course by framing it around the central questions the arm must answer to operate, and situates the classroom arm within the broader landscape of real-world robotic applications. The lesson also covers essential safety procedures for operating the arm.

## Objective:

By the end of this lesson, students will be able to:

● Identify and describe the core components of a robotic arm (actuators, links, encoders, grippers, controller, workspace)

● Define degrees of freedom (DOF) and explain its significance for an arm's range of motion

● Describe the central questions that guide the course: how the arm knows where it is, how it knows where to go, and how it can interact with the world

● State the essential safety procedures for operating the arm

## Standards:

NGSS

## Vocabulary:

Robotic Arm: A series of rigid links connected by actuated joints.

Rigid Link: A non-deforming structure that connects joints.

Joint: A connection between rigid links that permits controlled motion (rotational or linear).

Degree of Freedom: The number of independent movements a robot can make to position itself. In the case of a robotic arm, the number of independent movements to position the end effector.

Actuator: A device that creates controlled motion within the joints of a robot. Most often a motor with a gearbox to reduce speed. Can be a motor alone.

End Effector: The tool at the end of the arm that allows for the arm to manipulate or interact with its environment.

Gripper: A type of end effector. Used to grab, hold, or manipulate objects.

Forward Kinematics: Calculating the position of the end effector using known joint angles.

Inverse Kinematics: Calculating the angle of joints using a known position of the end effector

## Resources & Materials:

Video of a waypoint demo

Video of a pick & place demo

Computer/projector for running demo programs and displaying industry example images/videos

Slide deck covering: definition of a robotic arm, DOF, parts list, industry examples, safety rules (https://docs.google.com/presentation/d/1tk0CLdnR20ETJf8j_mfatMoN6TqX8hh1UDz98cCuoDI/edit?usp=sharing)

## Procedures:

Opening demo (5 min) — Run the demo video of a waypoint program running the arm.

Ask students questions about the video shown.

You may choose questions from the following suggestions:

- How do you think the location they arm goes to is chosen?

- How do you think the arm knows what location it is at?

- How does the arm figure out where it is going?

- Why does the arm need to go to specific locations?

What is a robotic arm? (8 min) — Define a robotic arm as a series of rigid links connected by actuated joints, providing motion similar to a human arm, typically ending in an end effector.

The arm this course uses (10 min) — Introduce the classroom arm's 4 DOF (define degrees of freedom) and its underactuated gripper; run live demo of the arm grabbing a cup.

Course purpose (7 min) — Frame the course around the three guiding questions: how does the arm know where it is, how does it know where to go, and how can it interact with the world.

Parts of a robotic arm (15 min) — Cover actuators, links, encoders, grippers (underactuated vs. fully actuated), controller, and workspace; students label the blank arm diagram handout.

Why? (Examples of other arms) (7 min) — Survey industrial and specialized arms (Mars rover, car factories, bomb disposal, surgery robots, agriculture, logistics, film, humanoids), discussing how DOF and design vary by purpose.

Safety (5 min) — Review core safety procedures (e-stop location/use, pinch points, workspace boundaries)

Closing demo (3 min) — Play the demo video where the arm moves and picks up a red cube, reinforcing what students just learned.

## Assessment:

1. What does DOF stand for?

(Degree of Freedom)

2. Match the term to the definition
a. Actuator ___ ( h )
b. Link ___ ( f )
c. Joint ___ ( g )
d. End Effector ___ ( i )
e. Gripper ___ ( j )
f. The rigid segment connecting two joints on the arm
g. The point where two links meet, allowing rotation
h. The motor or device that creates rotational motion at a joint
i. The tool attached at the tip of the arm that interacts with objects
j. A type of end effector specifically designed to grasp objects
3. True or False: A robotic arm with more degrees of freedom can always reach more positions and orientations than one with fewer degrees of freedom.

(True)

4. Name an industry (other than education) where robotic arms could be used. State at least one difference it would have compared to the one in the classroom.

(States an industry other than education and states a plausible difference)

5. What safety precaution should you take if the arm acts unexpectedly?

(Press the E-Stop)
