balu-lab/cabs-PETFAB-Hammer-Joshua/PETFAB-Armadillo/Curriculum/Lesson_4_DH_Approach_to_FK_plain_colours.pdf

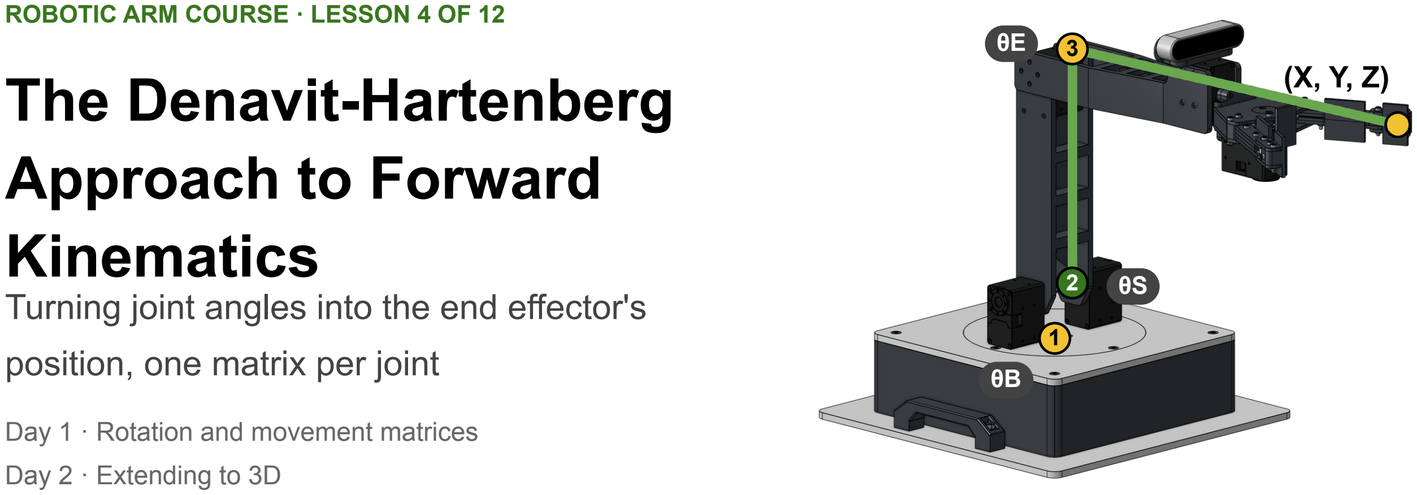
[picture p110: figure]
ROBOTIC ARM COURSE · LESSON 4 OF 12 The Denavit-Hartenberg Approach to Forward Kinematics; position, one matrix per joint; Day 1 · Rotation and movement matrices; Day 2 · Extending to 3D

## Turning joint angles into the end effector's

# Where Lesson 3 Left Off

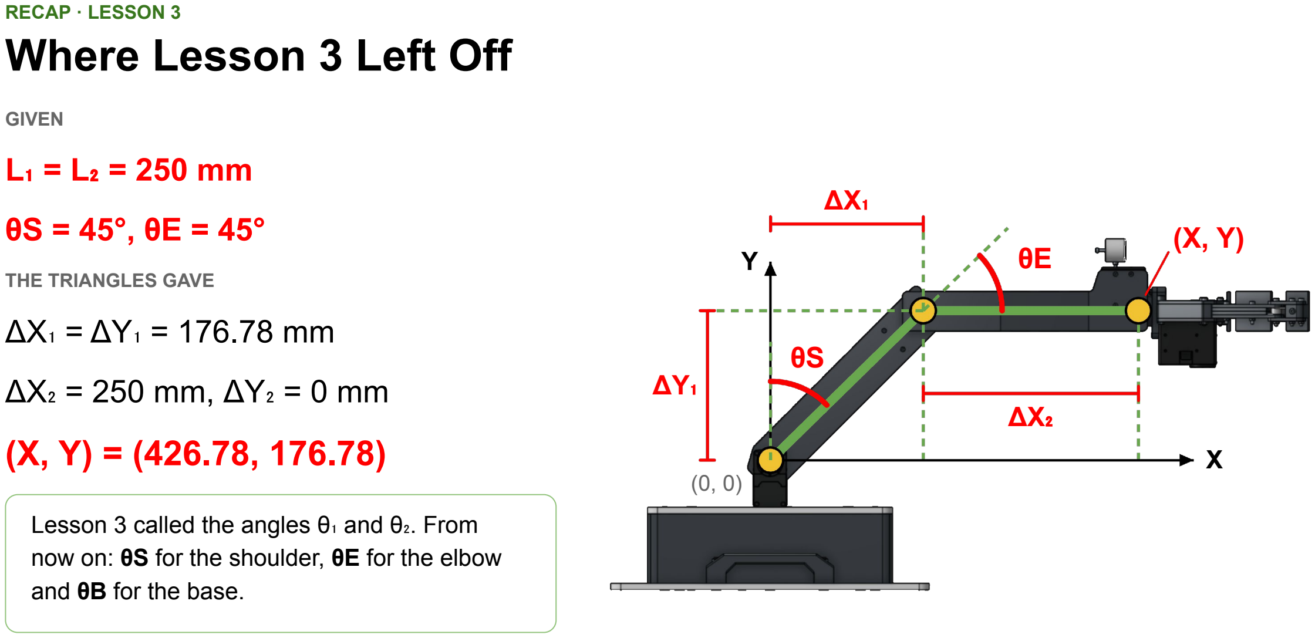
[picture p111: page 2]

RECAP · LESSON 3

GIVEN

## L₁ = L₂ = 250 mm

## θS = 45°, θE = 45°

THE TRIANGLES GAVE

## ΔX₁ = ΔY₁ = 176.78 mm

## ΔX₂ = 250 mm, ΔY₂ = 0 mm

(X, Y) = (426.78, 176.78)

Lesson 3 called the angles θ₁ and θ₂. From now on: θS for the shoulder, θE for the elbow and θB for the base.

θS

θE

### ΔX₁

### ΔX₂

### ΔY₁

(X, Y)

X

Y

(0, 0)

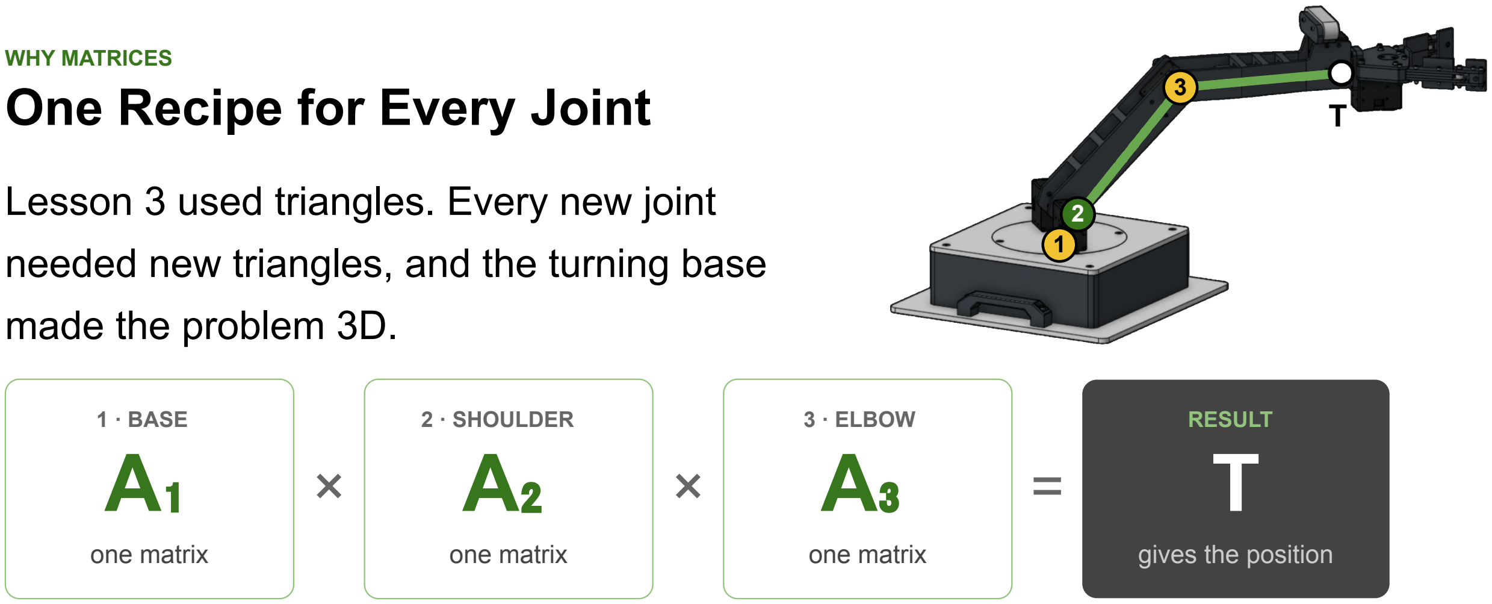
[picture p112: figure]
WHY MATRICES; One Recipe for Every Joint; made the problem 3D.; 1 · BASE A₁; one matrix; 2 · SHOULDER A₂; 3 · ELBOW A₃; RESULT T; gives the position

## Lesson 3 used triangles. Every new joint

## needed new triangles, and the turning base

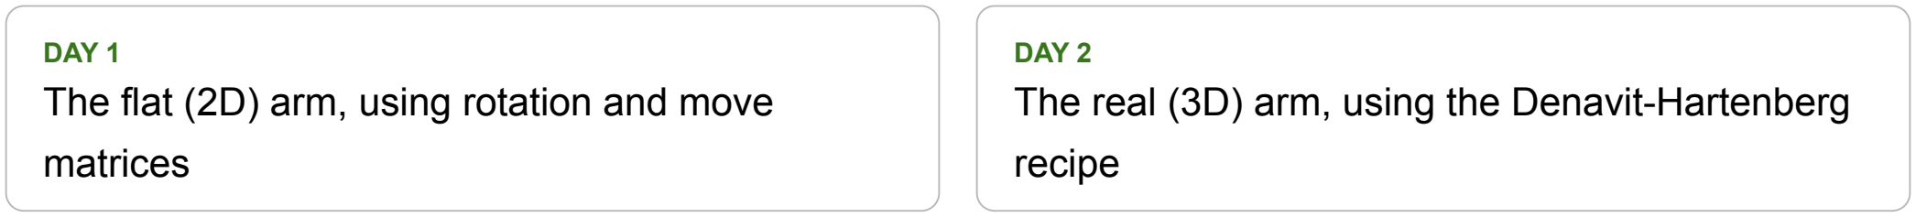
[picture p113: figure]
DAY 1; matrices; DAY 2; recipe

### The flat (2D) arm, using rotation and move

### The real (3D) arm, using the Denavit-Hartenberg

# Rotating a Point

## Spin the point P = (250, 0) by 45°

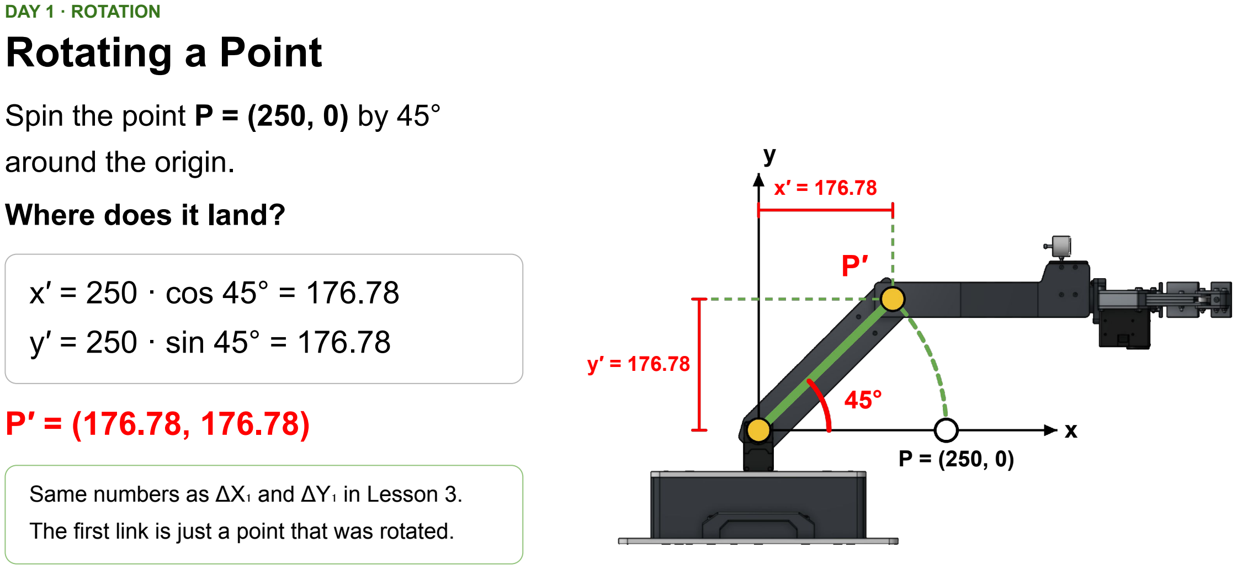
[picture p114: page 4]

DAY 1 · ROTATION

around the origin.

## Where does it land?

## x′ = 250 · cos 45° = 176.78

## y′ = 250 · sin 45° = 176.78

P′ = (176.78, 176.78)

Same numbers as ΔX₁ and ΔY₁ in Lesson 3.

The first link is just a point that was rotated.

45°

x′ = 176.78

y′ = 176.78

P′

P = (250, 0)

y

x

DAY 1 · ROTATION

# The Rotation Matrix

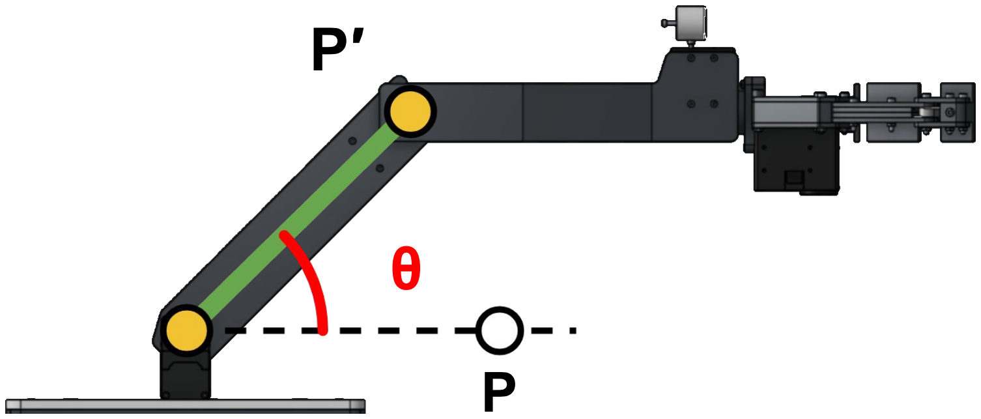
[picture p115: figure]

The two formulas for rotating a point (x, y) by θ fit inside one matrix.

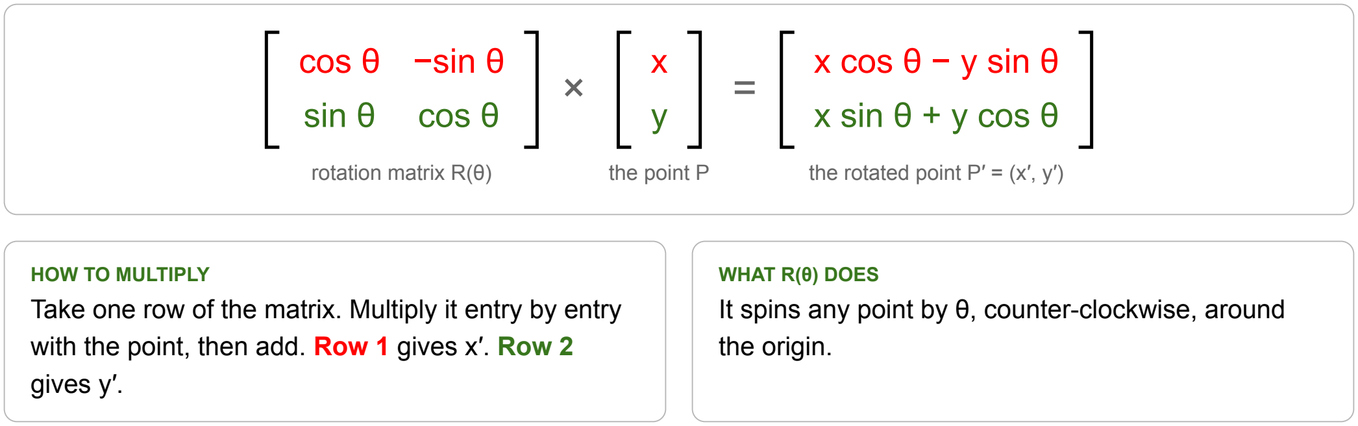
[picture p116: figure]
cos θ −sin θ; sin θ; cos θ; rotation matrix R(θ); the point P; x cos θ − y sin θ; x sin θ + y cos θ; the rotated point P′ = (x′, y′); HOW TO MULTIPLY; gives y′.; WHAT R(θ) DOES; the origin.

Take one row of the matrix. Multiply it entry by entry with the point, then add. Row 1 gives x′. Row 2

It spins any point by θ, counter-clockwise, around

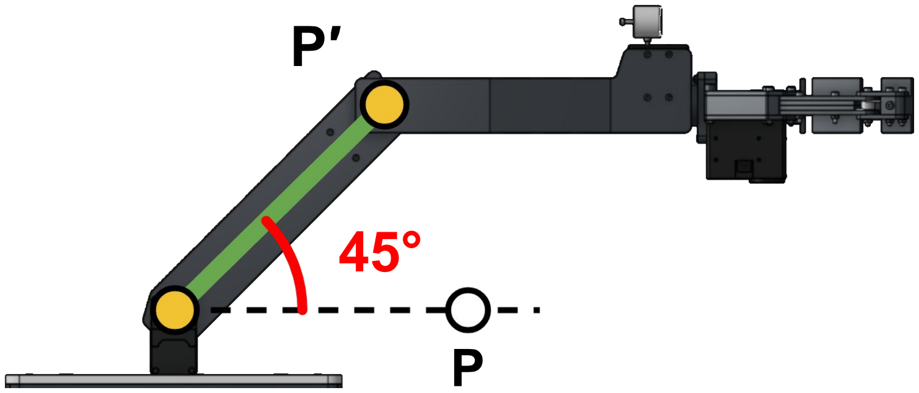
[picture p117: figure]

DAY 1 · ROTATION

# Worked Example: Rotation

Rotate P = (250, 0) by 45°. At 45°, cos and sin are both 0.7071.

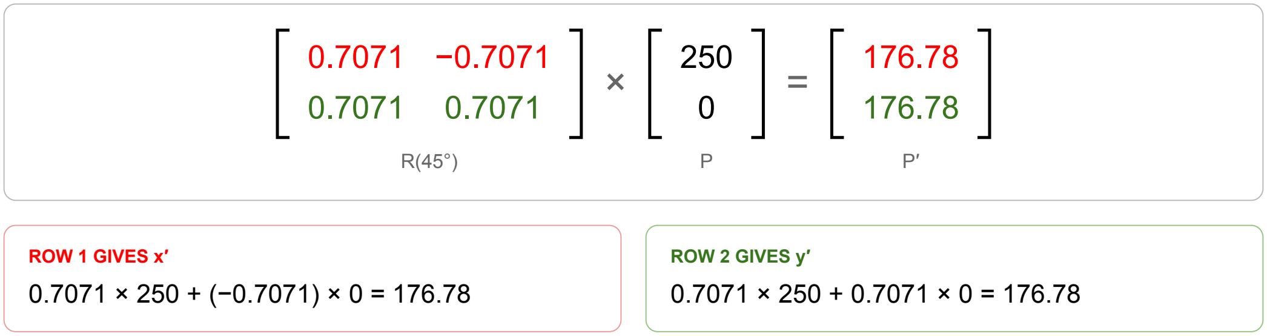
[picture p118: figure]
ROW 1 GIVES x′ 0.7071 × 250 + (−0.7071) × 0 = 176.78; ROW 2 GIVES y′ 0.7071 × 250 + 0.7071 × 0 = 176.78

P′ = (176.78, 176.78), the same answer as the cos and sin formulas.

# Try It Yourself #1

## Rotate P = (250, 0) by each angle. Find

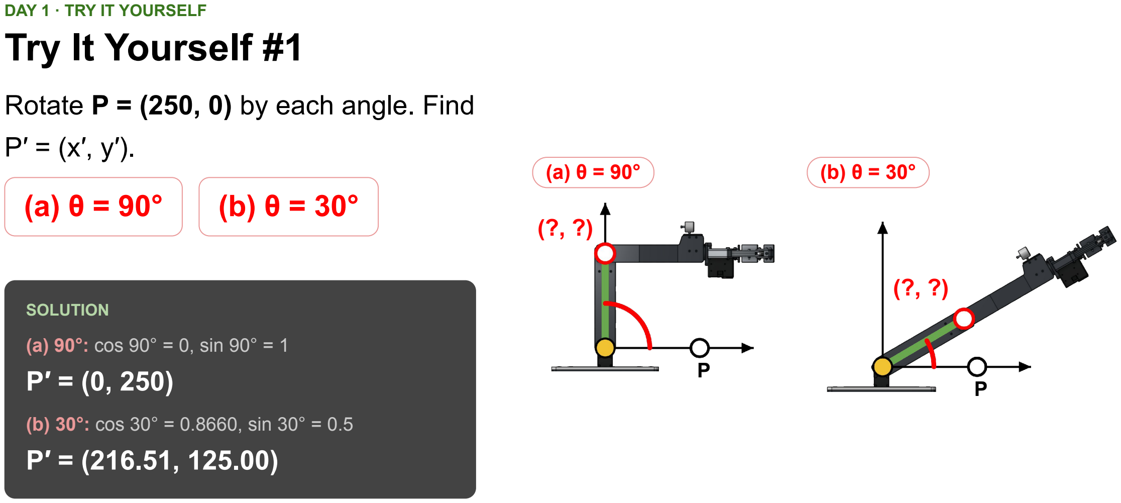
[picture p119: page 7]

DAY 1 · TRY IT YOURSELF

P′ = (x′, y′).

## (a) θ = 90° (b) θ = 30°

P

(?, ?)

(a) θ = 90°

P

(?, ?)

(b) θ = 30°

SOLUTION

(a) 90°: cos 90° = 0, sin 90° = 1
P′ = (0, 250)
(b) 30°: cos 30° = 0.8660, sin 30° = 0.5
P′ = (216.51, 125.00)

# Moving a Point

## Slide the point P = (250, 0) to the right

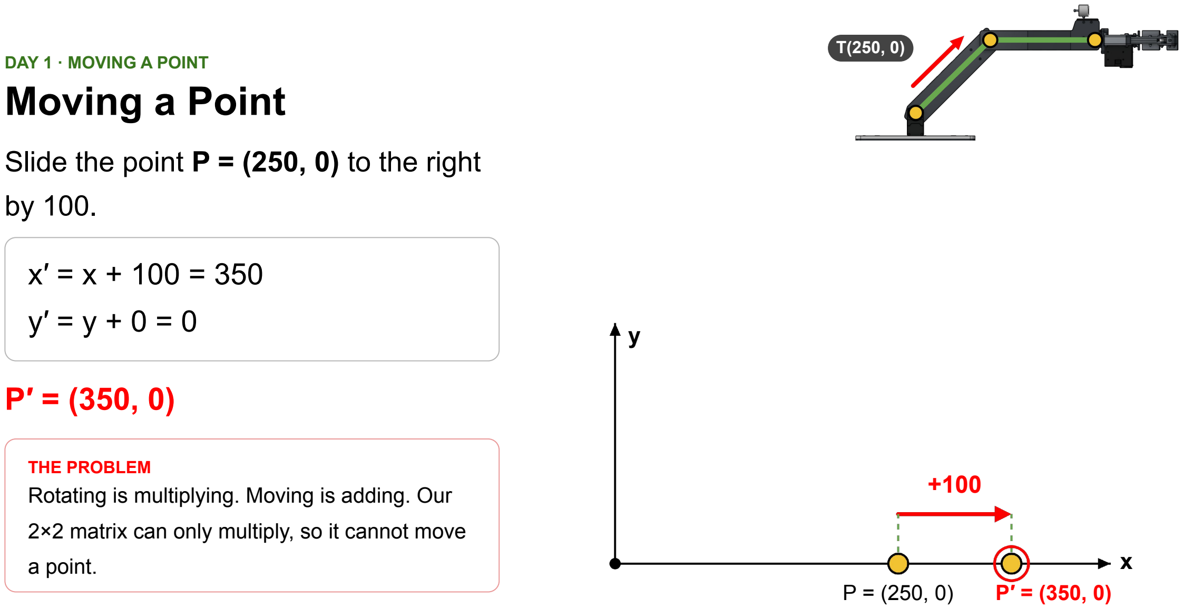
[picture p120: page 8]

DAY 1 · MOVING A POINT

by 100.

x′ = x + 100 = 350
y′ = y + 0 = 0

P′ = (350, 0)

THE PROBLEM
Rotating is multiplying. Moving is adding. Our

2×2 matrix can only multiply, so it cannot move
a point. | x

y

+100

P = (250, 0) P′ = (350, 0)

T(250, 0)

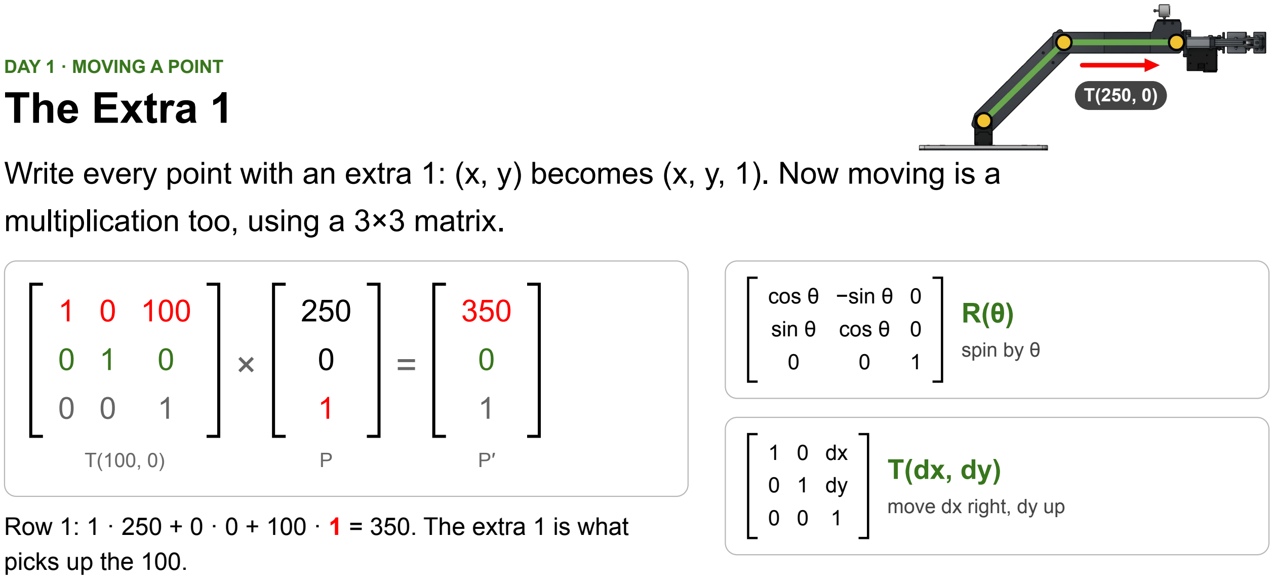
[picture p121: figure]
DAY 1 · MOVING A POINT The Extra 1; multiplication too, using a 3×3 matrix.; picks up the 100.; cos θ −sin θ 0; sin θ cos θ 0; spin by θ; move dx right, dy up

## Write every point with an extra 1: (x, y) becomes (x, y, 1). Now moving is a

Row 1: 1 · 250 + 0 · 0 + 100 · 1 = 350. The extra 1 is what

# The Arm as a Chain of Matrices

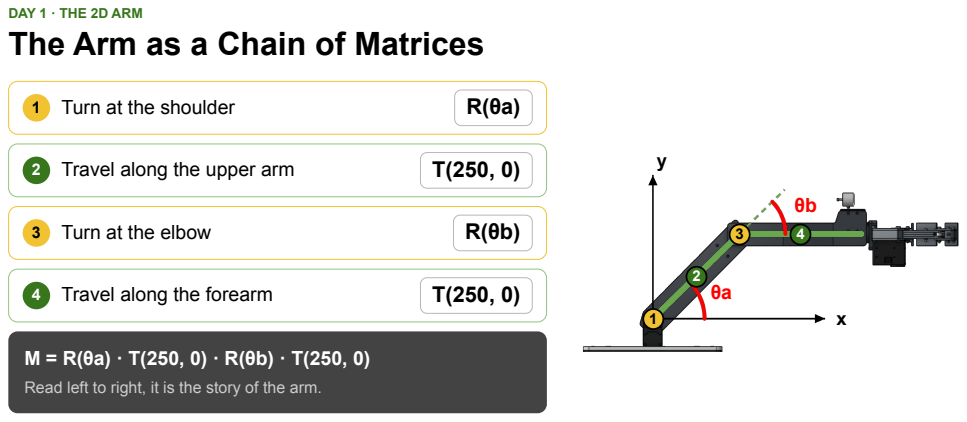
[picture p122: page 10]
Turn at the shoulder; Travel along the upper arm; Turn at the elbow; Travel along the forearm

DAY 1 · THE 2D ARM

Read left to right, it is the story of the arm.

DAY 1 · THE 2D ARM

# Converting the Arm's Angles

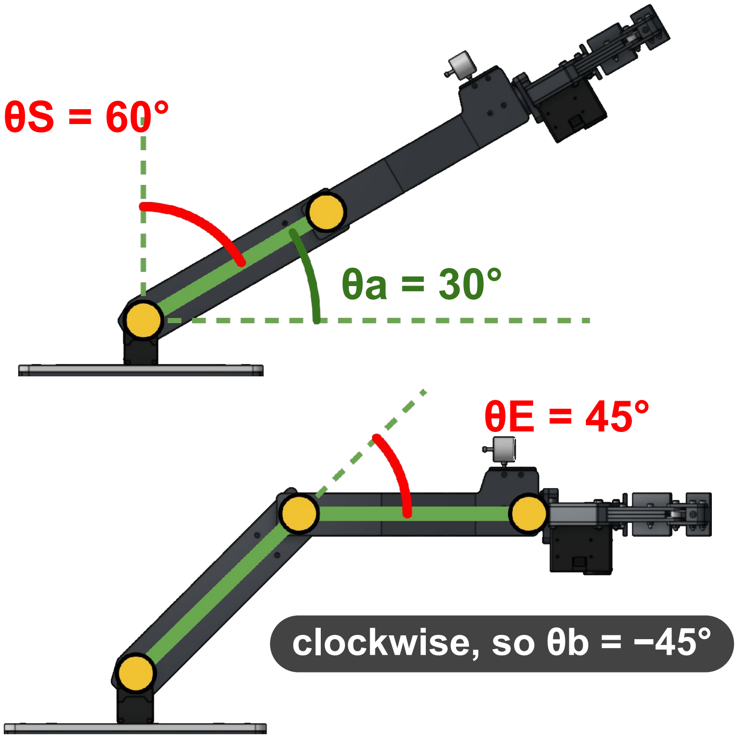
[picture p123: figure]
clockwise, so θb = −45°

SHOULDER

# θa = 90° − θS

A matrix counts angles counter-clockwise from the x-axis.

θS counts clockwise from the vertical.

ELBOW

# θb = −θE

The forearm bends clockwise. A matrix counts

counter-clockwise, so the sign flips.

θS = 60° gives θa = 30°
θE = 45° gives θb = −45°

DAY 1 · THE 2D ARM

# Worked Example: Setup

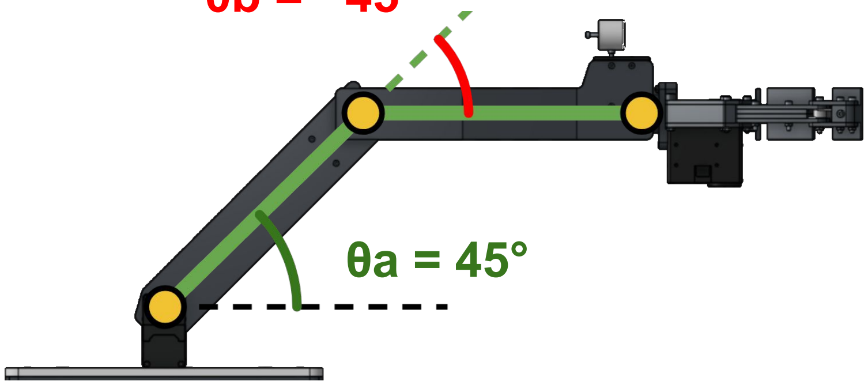
[picture p124: figure]

Find the end effector for θS = 45° and θE = 45°, with L₁ = L₂ = 250 mm.

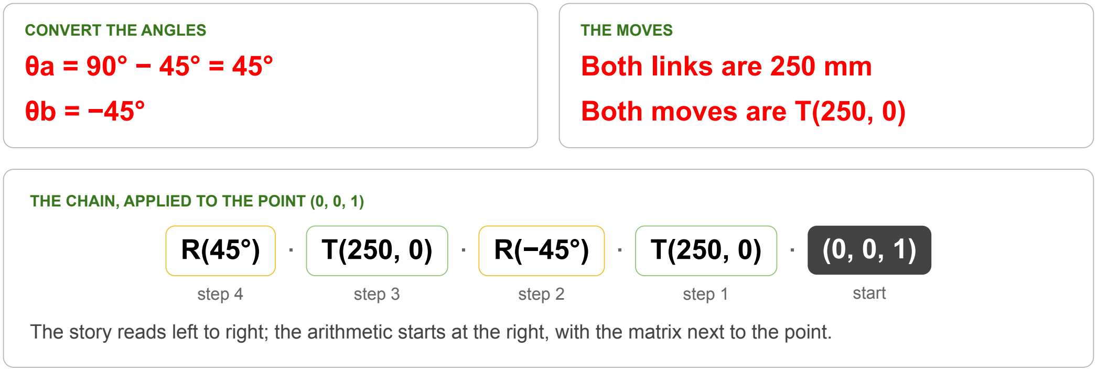
[picture p125: figure]
CONVERT THE ANGLES θa = 90° − 45° = 45°; THE MOVES Both links are 250 mm; Both moves are T(250, 0); step 4; step 3; step 2; step 1; start

THE CHAIN, APPLIED TO THE POINT (0, 0, 1)

The story reads left to right; the arithmetic starts at the right, with the matrix next to the point.

θb = −45°

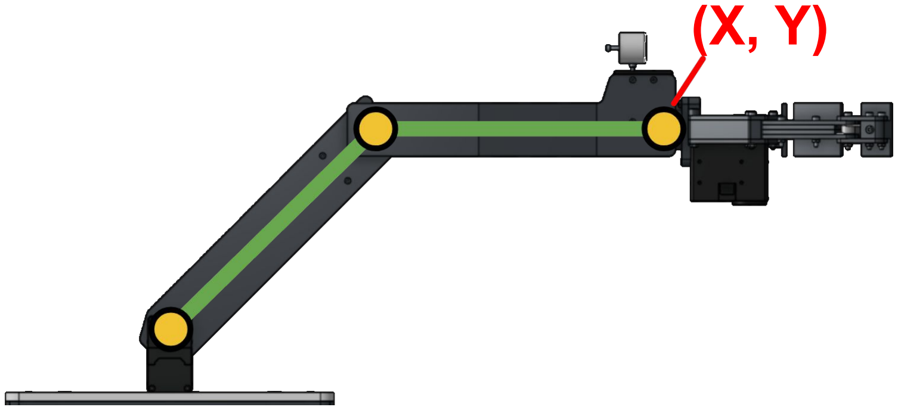
[picture p126: figure]

DAY 1 · THE 2D ARM

# Worked Example: Right to Left

Each step is one matrix times the current point.

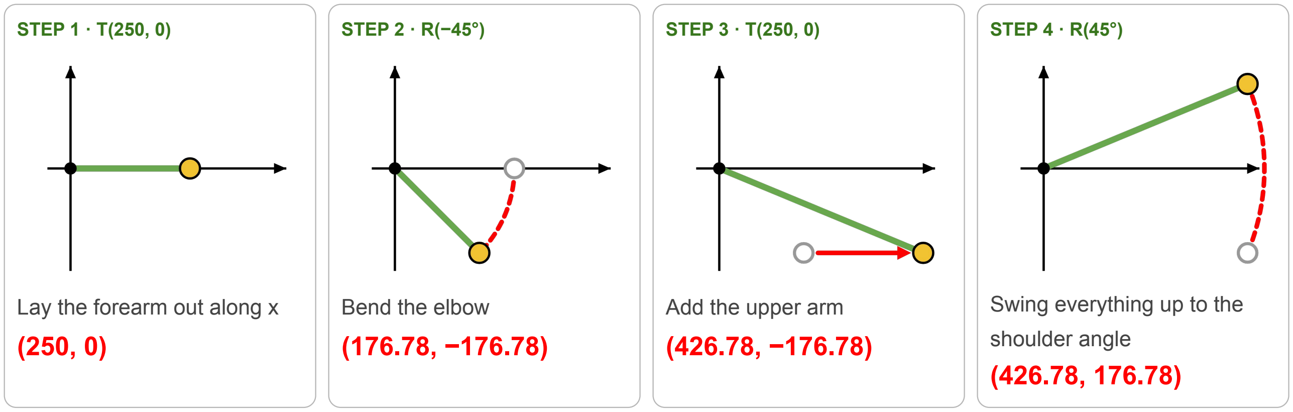
[picture p127: figure]
STEP 1 · T(250, 0); Lay the forearm out along x; STEP 2 · R(−45°); Bend the elbow (176.78, −176.78); STEP 3 · T(250, 0); Add the upper arm (426.78, −176.78); STEP 4 · R(45°); Swing everything up to the; shoulder angle (426.78, 176.78)

# Completed Variables L₁ = 250 mm L₂ = 250 mm

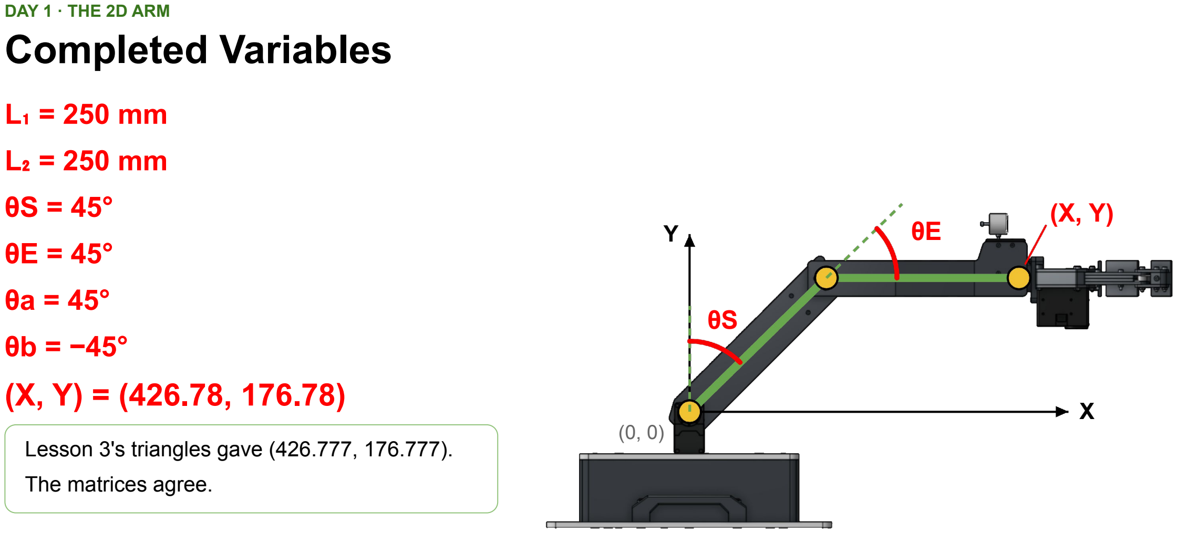
[picture p128: page 14]

DAY 1 · THE 2D ARM

θS = 45°
θE = 45°
θa = 45°
θb = −45°
(X, Y) = (426.78, 176.78)

Lesson 3's triangles gave (426.777, 176.777).

The matrices agree.

θS

θE

# (X, Y) X

Y

(0, 0)

# Try It Yourself #2

Find the end effector (X, Y).

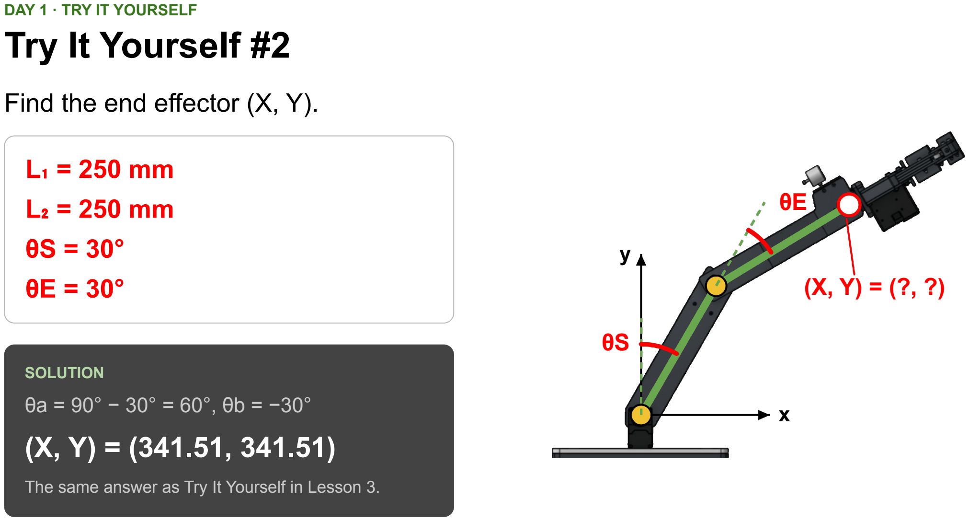
[picture p129: page 15]

DAY 1 · TRY IT YOURSELF

## L₁ = 250 mm

## L₂ = 250 mm

θS = 30°
θE = 30°

θS

θE

(X, Y) = (?, ?)

x

y

SOLUTION
θa = 90° − 30° = 60°, θb = −30°
(X, Y) = (341.51, 341.51)

The same answer as Try It Yourself in Lesson 3.

# Try It Yourself #3

Find the end effector (X, Y).

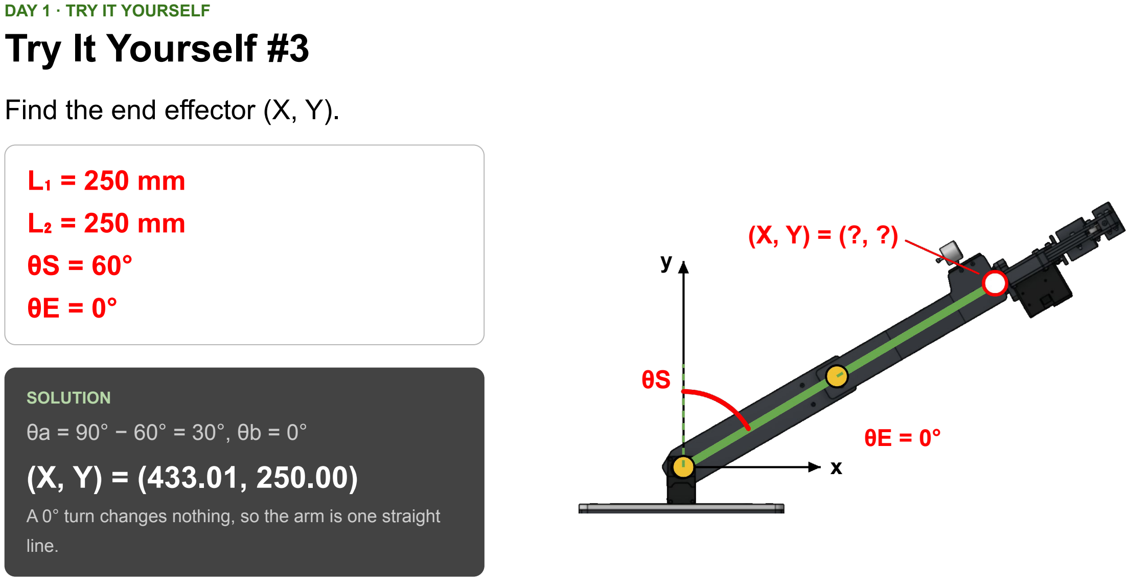
[picture p130: page 16]

DAY 1 · TRY IT YOURSELF

## L₁ = 250 mm

## L₂ = 250 mm

θS = 60°
θE = 0°

θS

(X, Y) = (?, ?)

θE = 0°
x

y

SOLUTION
θa = 90° − 60° = 30°, θb = 0°
(X, Y) = (433.01, 250.00)

A 0° turn changes nothing, so the arm is one straight

line.

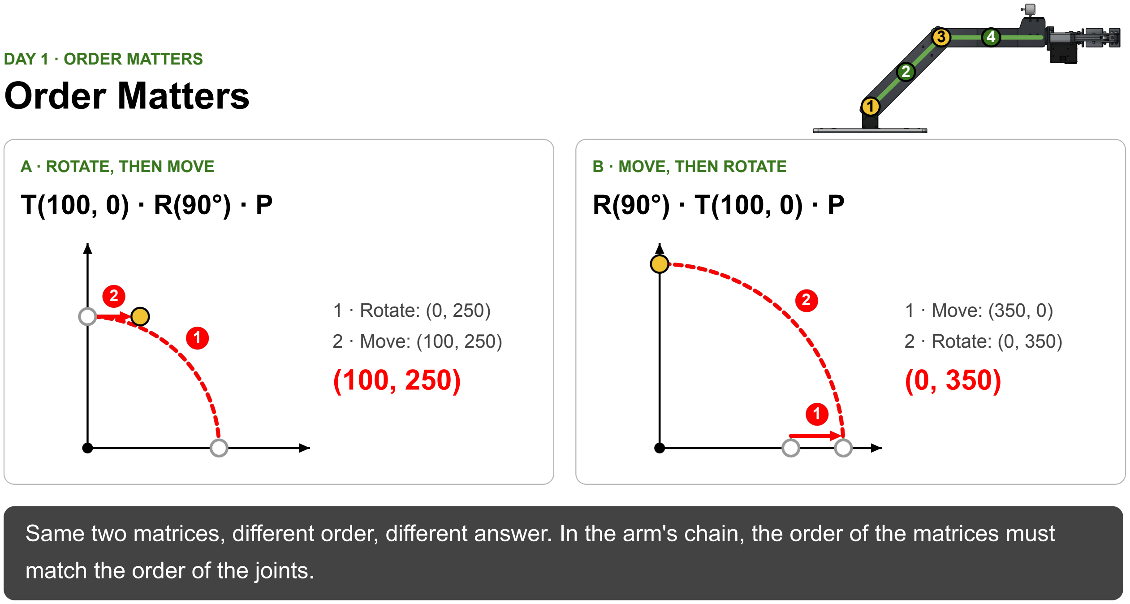
[picture p131: figure]
DAY 1 · ORDER MATTERS; Order Matters; A · ROTATE, THEN MOVE T(100, 0) · R(90°) · P; 1 · Rotate: (0, 250); 2 · Move: (100, 250) (100, 250); B · MOVE, THEN ROTATE R(90°) · T(100, 0) · P; 1 · Move: (350, 0); 2 · Rotate: (0, 350) (0, 350); match the order of the joints.

Same two matrices, different order, different answer. In the arm's chain, the order of the matrices must

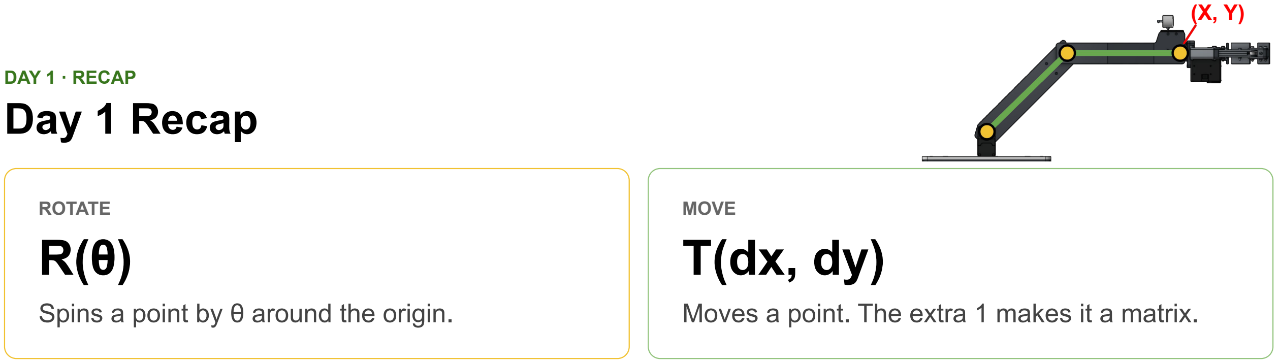
[picture p132: figure]
DAY 1 · RECAP Day 1 Recap; ROTATE R(θ); Spins a point by θ around the origin.; MOVE T(dx, dy)

Moves a point. The extra 1 makes it a matrix.

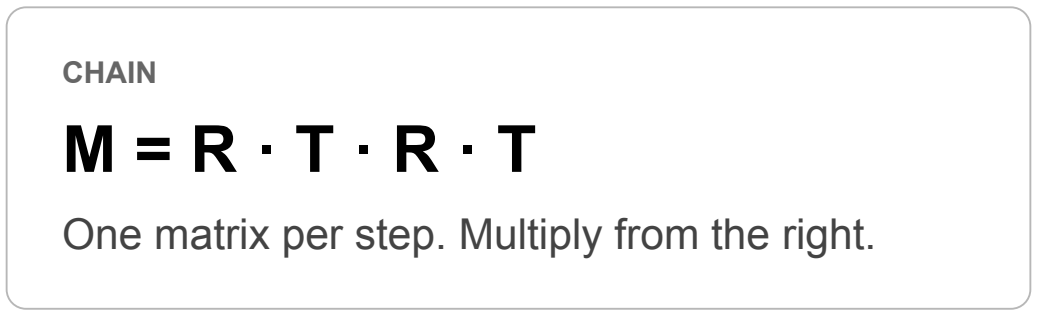
[picture p133: figure]
CHAIN M = R · T · R · T

One matrix per step. Multiply from the right.

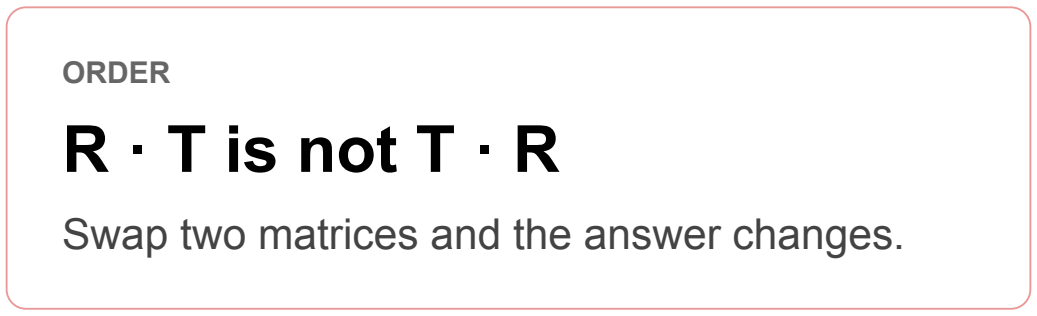
[picture p134: figure]
ORDER R · T is not T · R

Swap two matrices and the answer changes.

Next time: the real arm turns at the base too, so it needs 3D.

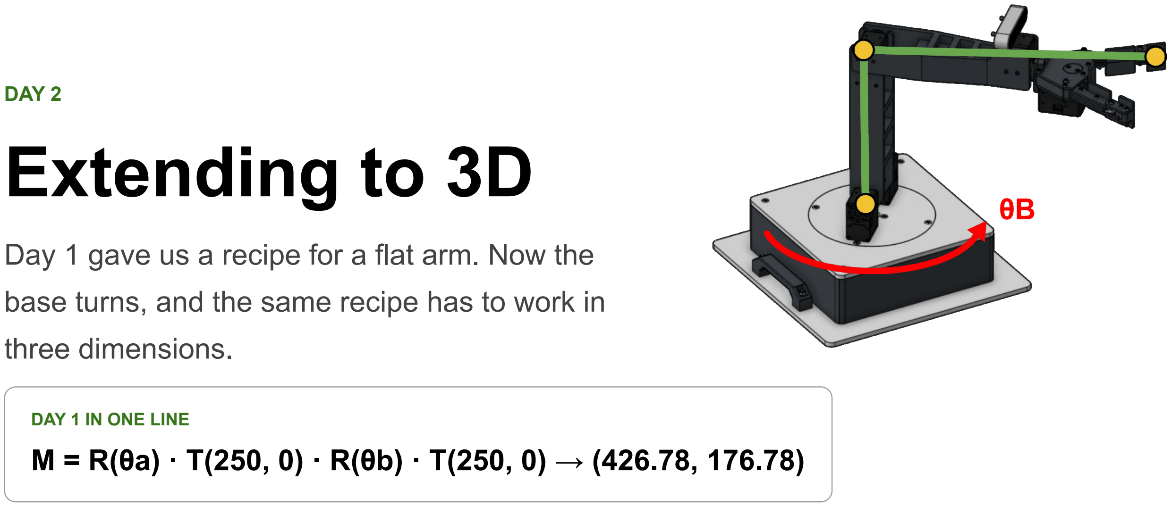
[picture p135: figure]
DAY 2 Extending to 3D; three dimensions.; DAY 1 IN ONE LINE

## Day 1 gave us a recipe for a flat arm. Now the

## base turns, and the same recipe has to work in

## M = R(θa) · T(250, 0) · R(θb) · T(250, 0) → (426.78, 176.78)

# The Base Turns the Whole Arm

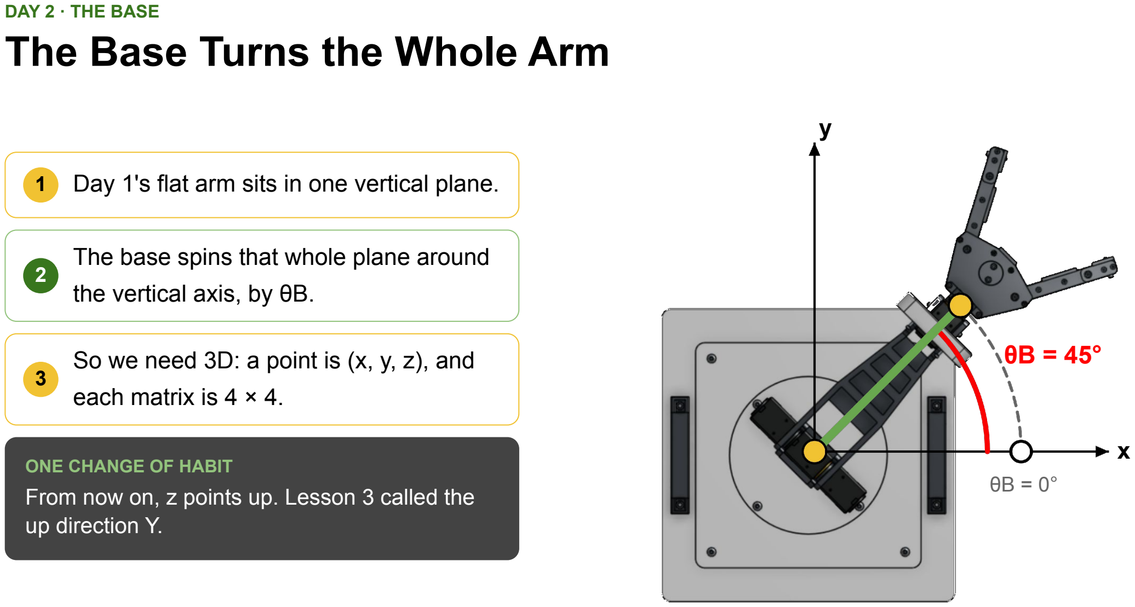
[picture p136: page 20]

DAY 2 · THE BASE

1 Day 1's flat arm sits in one vertical plane.

2

The base spins that whole plane around the vertical axis, by θB.

3

So we need 3D: a point is (x, y, z), and each matrix is 4 × 4.

ONE CHANGE OF HABIT
From now on, z points up. Lesson 3 called the up direction Y.

θB = 45°

θB = 0°

x

y

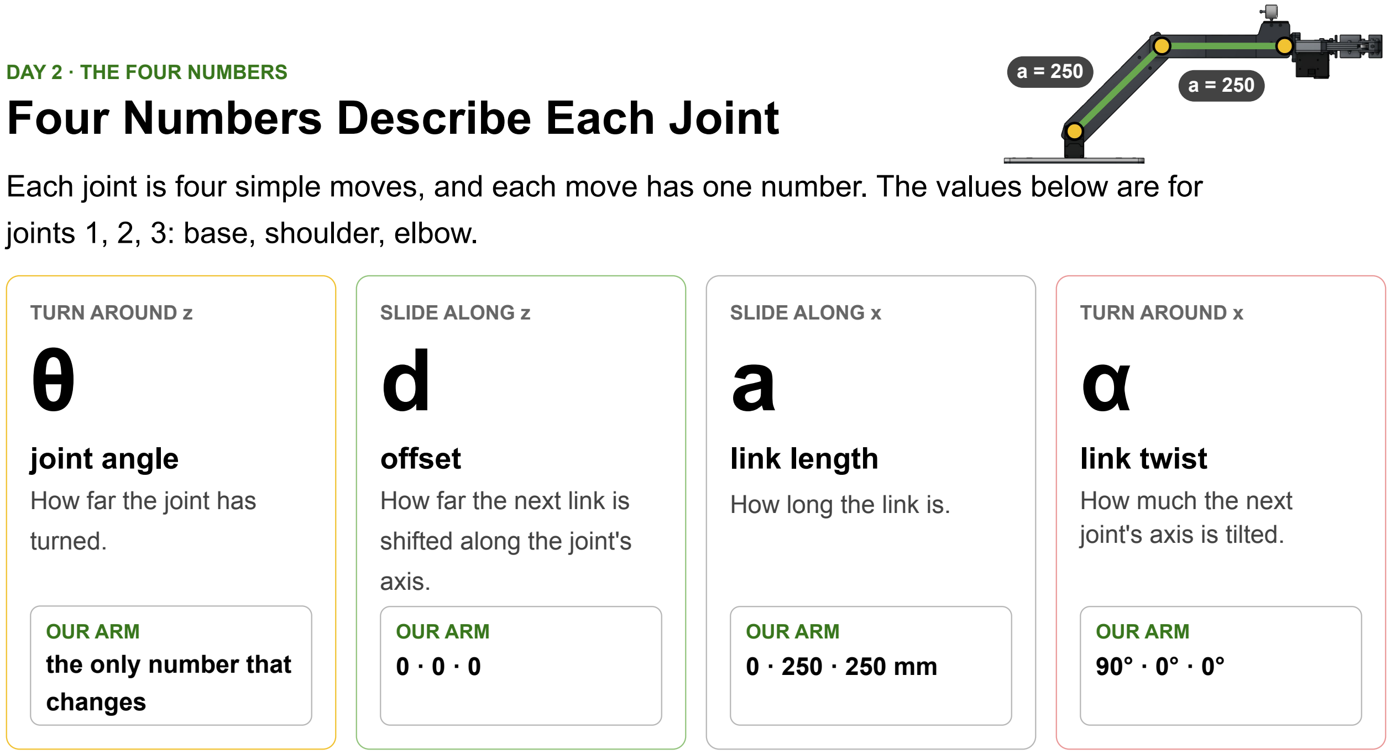
[picture p137: figure]
DAY 2 · THE FOUR NUMBERS Four Numbers Describe Each Joint; joints 1, 2, 3: base, shoulder, elbow.; TURN AROUND z θ; joint angle; How far the joint has; turned.; OUR ARM the only number that; changes; SLIDE ALONG z d; offset; How far the next link is; shifted along the joint's; axis.; OUR ARM 0 · 0 · 0; SLIDE ALONG x a; link length; How long the link is.; OUR ARM 0 · 250 · 250 mm; TURN AROUND x α; link twist; How much the next joint's axis is tilted.; OUR ARM 90° · 0° · 0°

## Each joint is four simple moves, and each move has one number. The values below are for

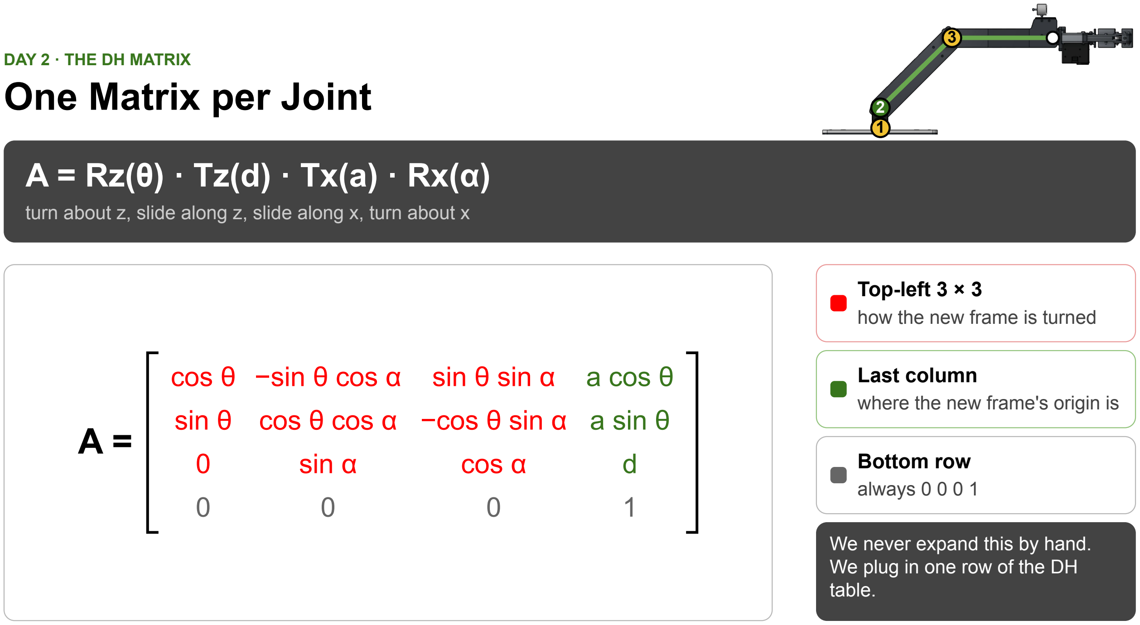
[picture p138: figure]
DAY 2 · THE DH MATRIX One Matrix per Joint; cos θ; −sin θ cos α; sin θ sin α; a cos θ; sin θ; cos θ cos α; −cos θ sin α; a sin θ; sin α; cos α; Top-left 3 × 3; how the new frame is turned; Last column; where the new frame's origin is; Bottom row; always 0 0 0 1; We never expand this by hand. We plug in one row of the DH table.

turn about z, slide along z, slide along x, turn about x

# Placing a Frame on Each Joint

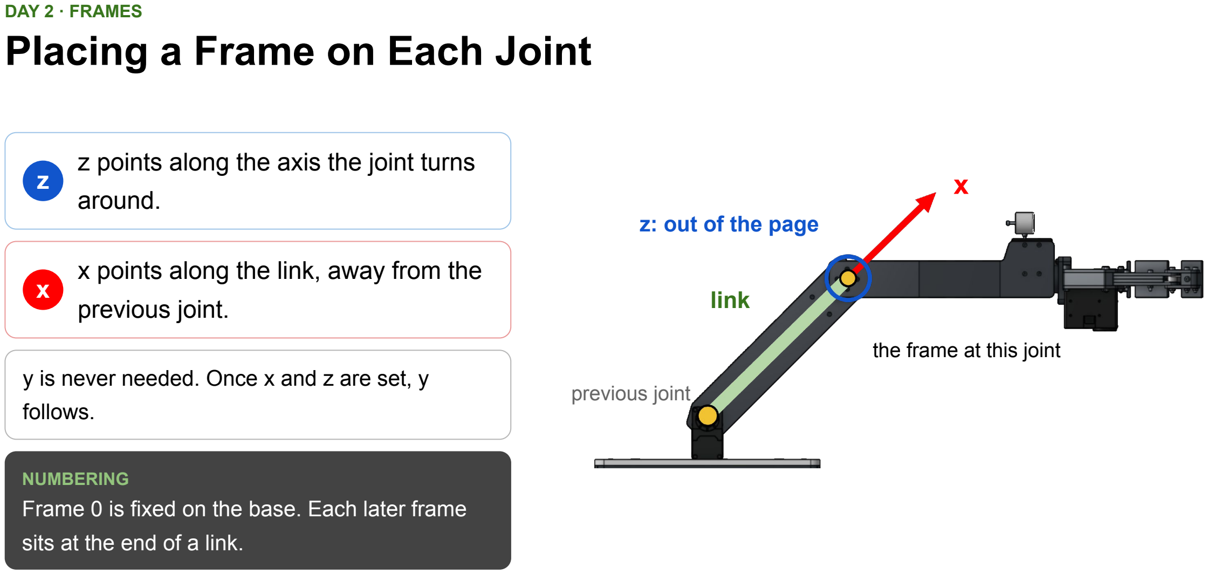
[picture p139: page 23]

DAY 2 · FRAMES

z

### z points along the axis the joint turns

around.

x

### x points along the link, away from the

previous joint.

y is never needed. Once x and z are set, y follows.

NUMBERING
Frame 0 is fixed on the base. Each later frame sits at the end of a link.

x

z: out of the page

link

previous joint

the frame at this joint

# Frames on Our Arm

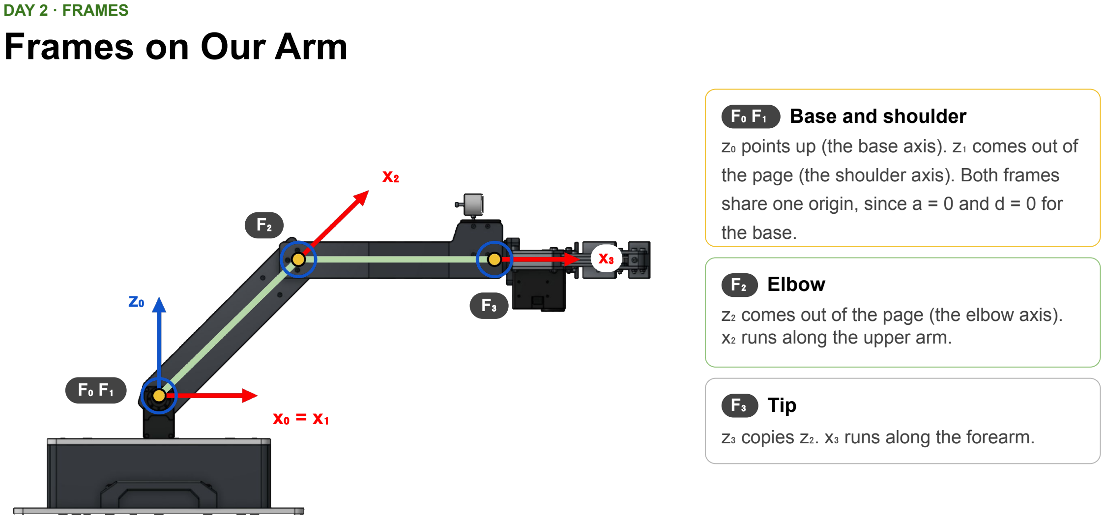
[picture p140: page 24]

DAY 2 · FRAMES

F₀ F₁ Base and shoulder
z₀ points up (the base axis). z₁ comes out of

the page (the shoulder axis). Both frames share one origin, since a = 0 and d = 0 for the base.

F₂ Elbow
z₂ comes out of the page (the elbow axis). x₂ runs along the upper arm.

F₃ Tip

z₃ copies z₂. x₃ runs along the forearm.

x₀ = x₁

z₀

x₂

x₃

F₀ F₁

F₂

F₃

Fill In the DH Table | Shoulder
Joint | θ | d | a | α

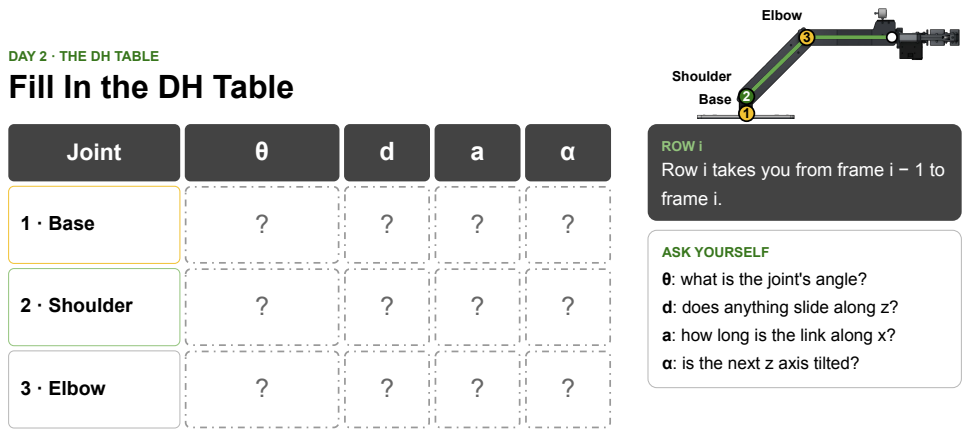
[picture p141: page 25]
1 · Base; 2 · Shoulder; 3 · Elbow; Base; Elbow

DAY 2 · THE DH TABLE

ROW i
Row i takes you from frame i − 1 to
frame i.

ASK YOURSELF
θ: what is the joint's angle?
d: does anything slide along z?
a: how long is the link along x?
α: is the next z axis tilted?

The DH Table for Our Arm | Shoulder | 250
Joint | θ | d | a | α

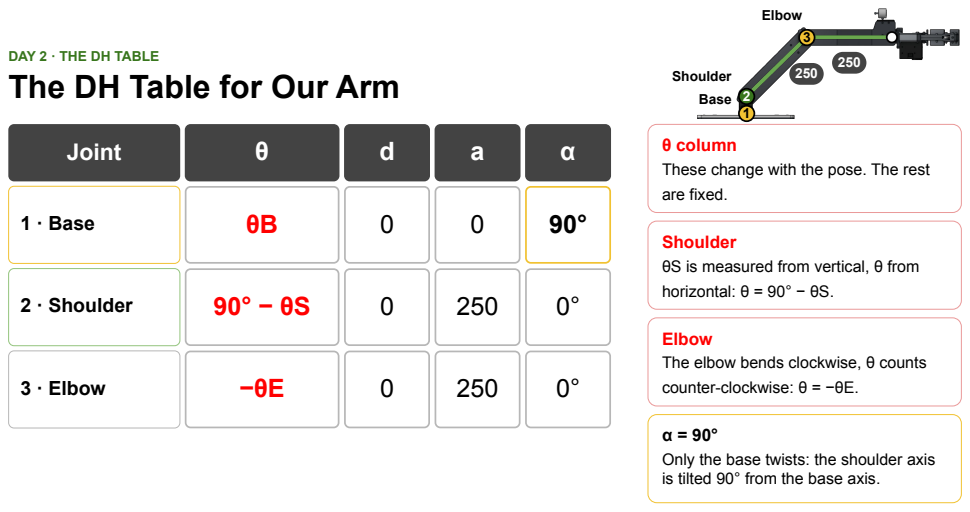
[picture p142: page 26]
1 · Base; 2 · Shoulder; 3 · Elbow; Base; Elbow

DAY 2 · THE DH TABLE

θ column
These change with the pose. The rest
are fixed.

Shoulder
θS is measured from vertical, θ from
horizontal: θ = 90° − θS.

Elbow
The elbow bends clockwise, θ counts
counter-clockwise: θ = −θE.

Only the base twists: the shoulder axis
is tilted 90° from the base axis.

DAY 2 · WORKED EXAMPLE

# A₁: The Base

Pose: θB = 45°, θS = 45°, θE = 45°

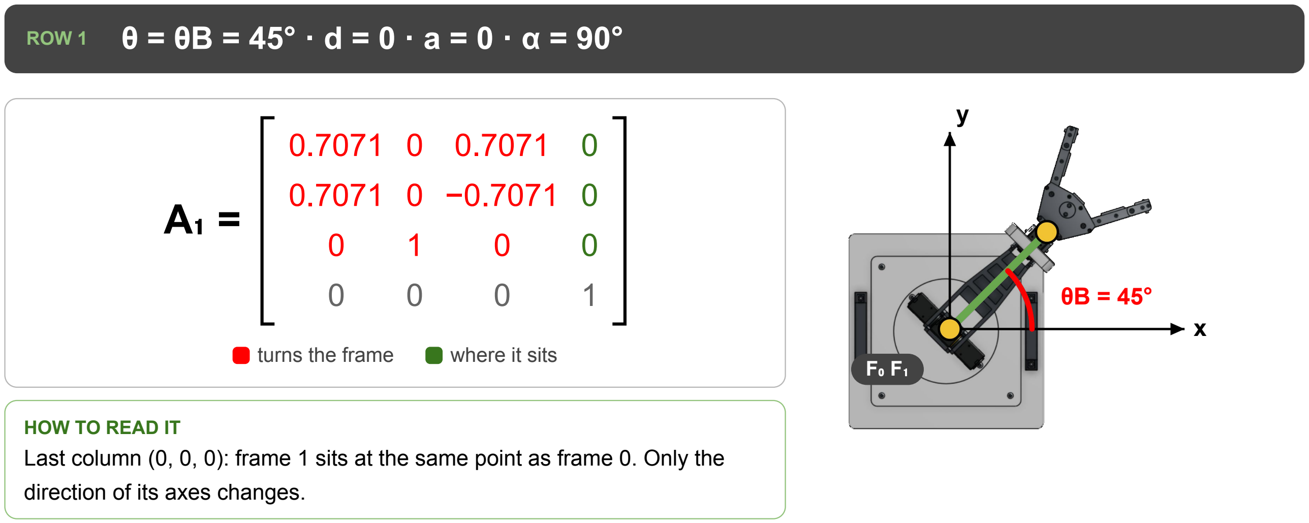
[picture p143: figure]
turns the frame; where it sits; HOW TO READ IT; direction of its axes changes.

## ROW 1 θ = θB = 45° · d = 0 · a = 0 · α = 90°

Last column (0, 0, 0): frame 1 sits at the same point as frame 0. Only the

DAY 2 · WORKED EXAMPLE

# A₂: The Shoulder

Pose: θB = 45°, θS = 45°, θE = 45°

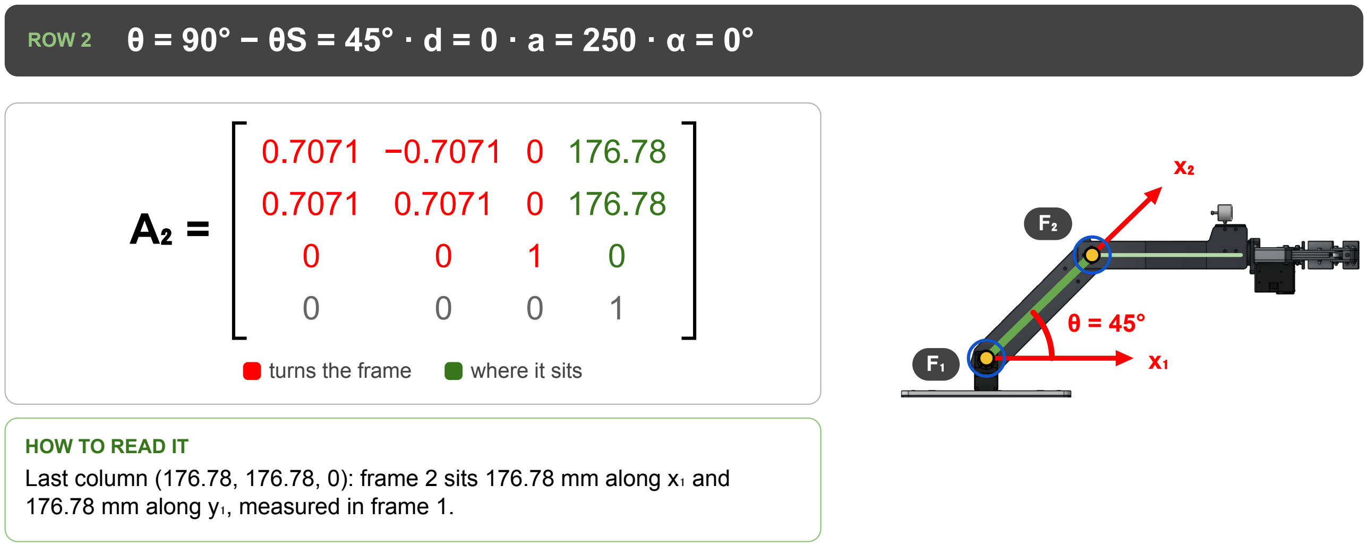
[picture p144: figure]
turns the frame; where it sits; HOW TO READ IT

## ROW 2 θ = 90° − θS = 45° · d = 0 · a = 250 · α = 0°

Last column (176.78, 176.78, 0): frame 2 sits 176.78 mm along x₁ and 176.78 mm along y₁, measured in frame 1.

DAY 2 · WORKED EXAMPLE

# A₃: The Elbow

Pose: θB = 45°, θS = 45°, θE = 45°

## ROW 3 θ = −θE = −45° · d = 0 · a = 250 · α = 0°

A₃ =

0.7071 | 0.7071 | 0 | 176.78
−0.7071 | 0.7071 | 0 | −176.78
0 | 0 | 1 | 0
0 | 0 | 0 | 1
turns the frame | where it sits

HOW TO READ IT
Last column (176.78, −176.78, 0): frame 3 sits 176.78 mm along x₂ and −176.78 mm along y₂, measured in frame 2.

x₂ −45°

x₃

F₂

F₃

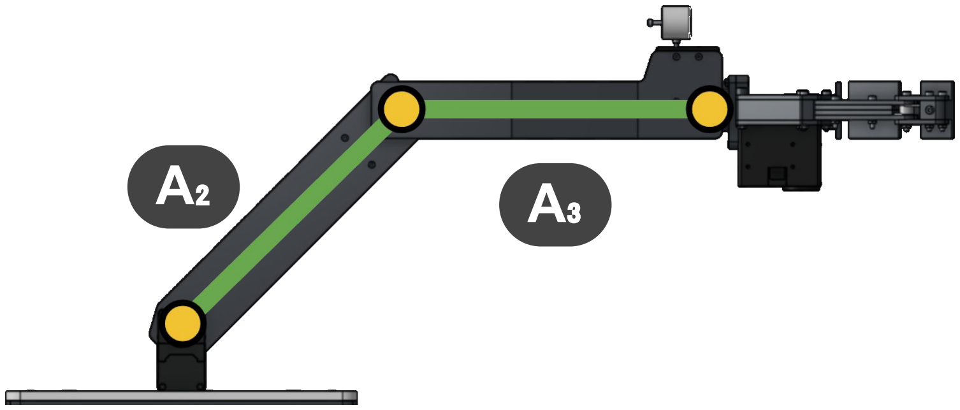
[picture p145: figure]

DAY 2 · WORKED EXAMPLE

# Step 1: Multiply A₂ · A₃

A₂ and A₃ have parallel z axes, so together they are the flat arm of Day 1.

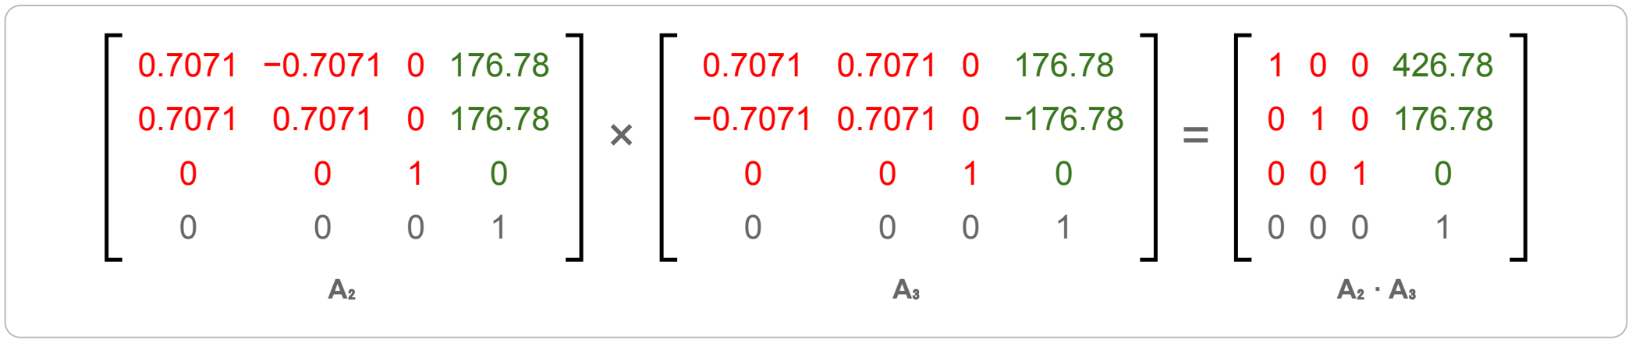
[picture p146: figure]
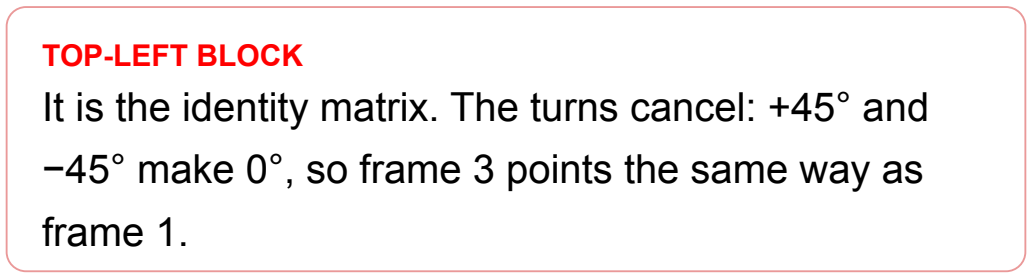
[picture p147: figure]
TOP-LEFT BLOCK; frame 1.

It is the identity matrix. The turns cancel: +45° and −45° make 0°, so frame 3 points the same way as

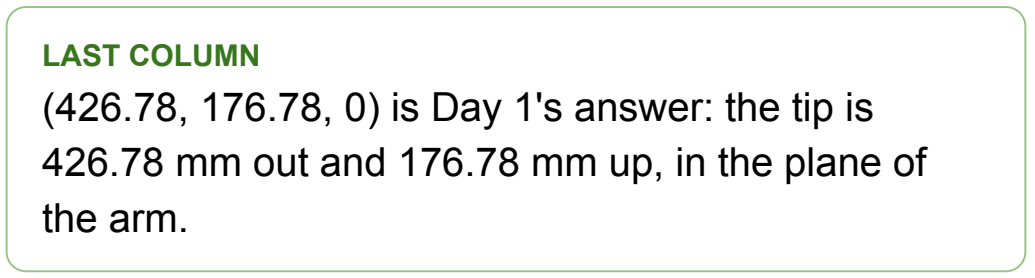
[picture p148: figure]
LAST COLUMN; the arm.

(426.78, 176.78, 0) is Day 1's answer: the tip is 426.78 mm out and 176.78 mm up, in the plane of

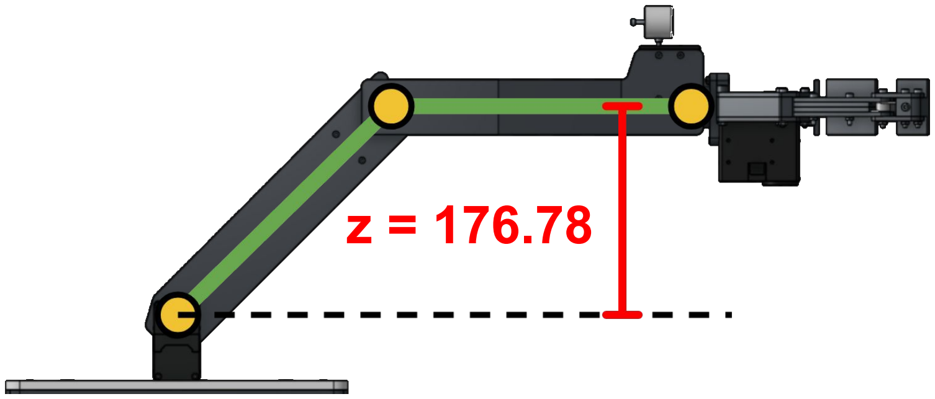
[picture p149: figure]

DAY 2 · WORKED EXAMPLE

# Step 2: Multiply A₁ · (A₂ · A₃)

Now add the base turn. The last column is the answer.

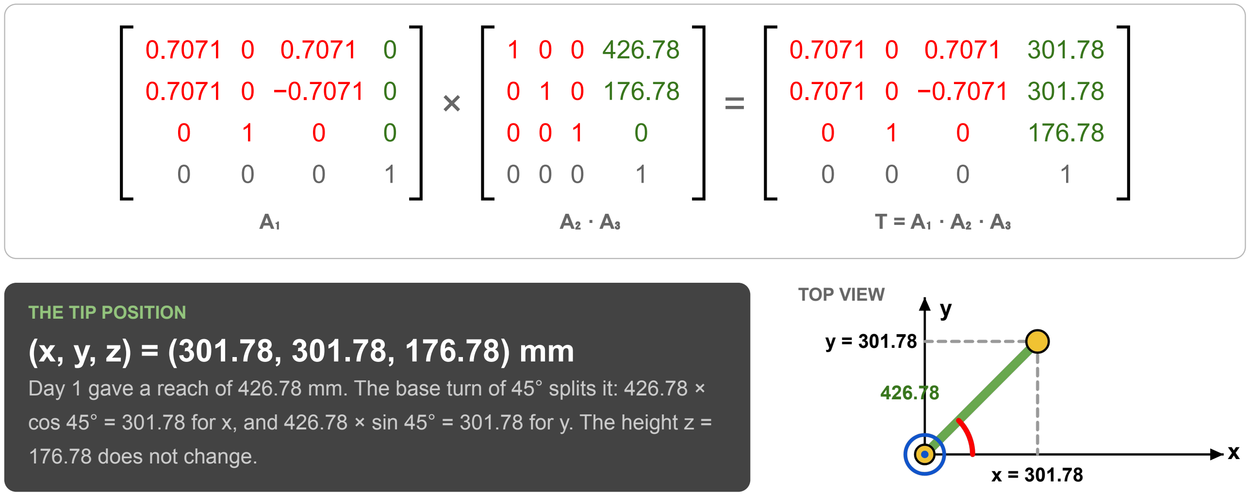
[picture p150: figure]
THE TIP POSITION (x, y, z) = (301.78, 301.78, 176.78) mm; 176.78 does not change.; TOP VIEW

Day 1 gave a reach of 426.78 mm. The base turn of 45° splits it: 426.78 × cos 45° = 301.78 for x, and 426.78 × sin 45° = 301.78 for y. The height z =

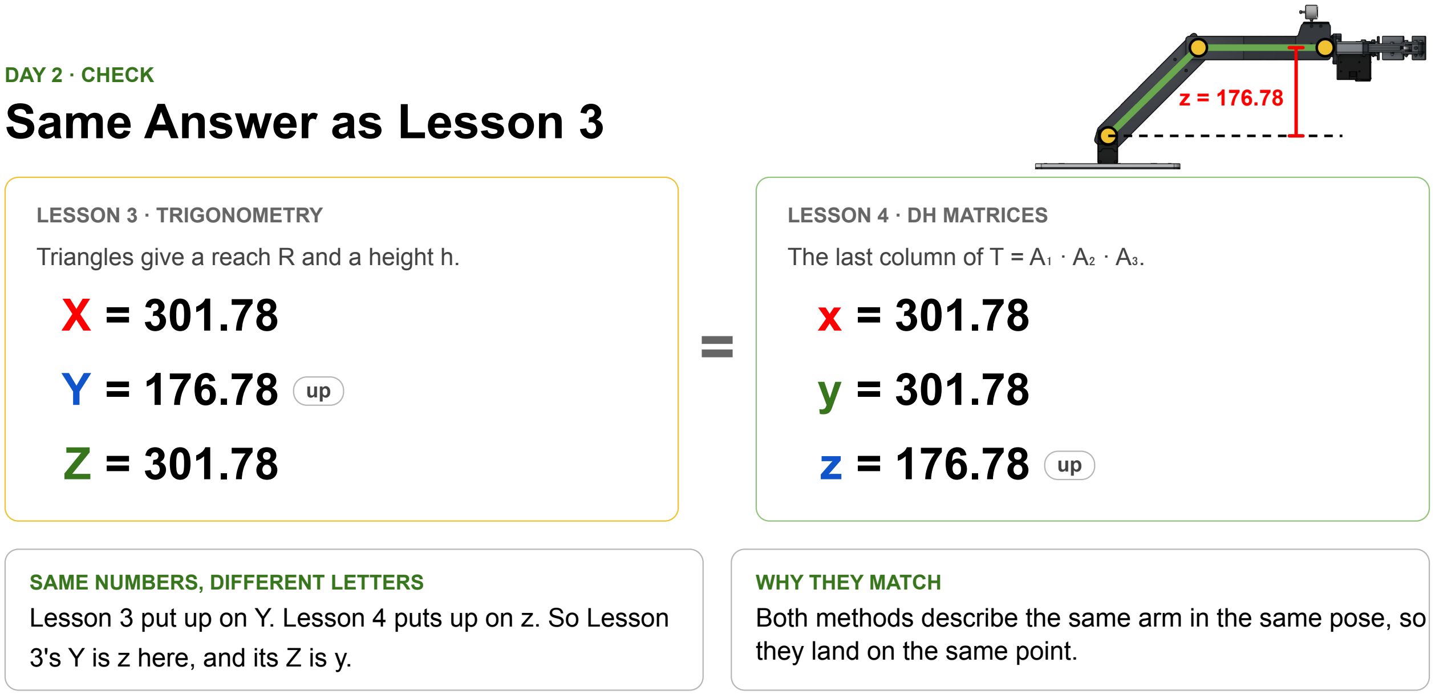
[picture p151: figure]
DAY 2 · CHECK; Same Answer as Lesson 3; LESSON 3 · TRIGONOMETRY; LESSON 4 · DH MATRICES; The last column of T = A₁ · A₂ · A₃.; SAME NUMBERS, DIFFERENT LETTERS; 3's Y is z here, and its Z is y.; WHY THEY MATCH; they land on the same point.

Triangles give a reach R and a height h.

Lesson 3 put up on Y. Lesson 4 puts up on z. So Lesson Both methods describe the same arm in the same pose, so

# Try It Yourself #4

Find the tip position (x, y, z).

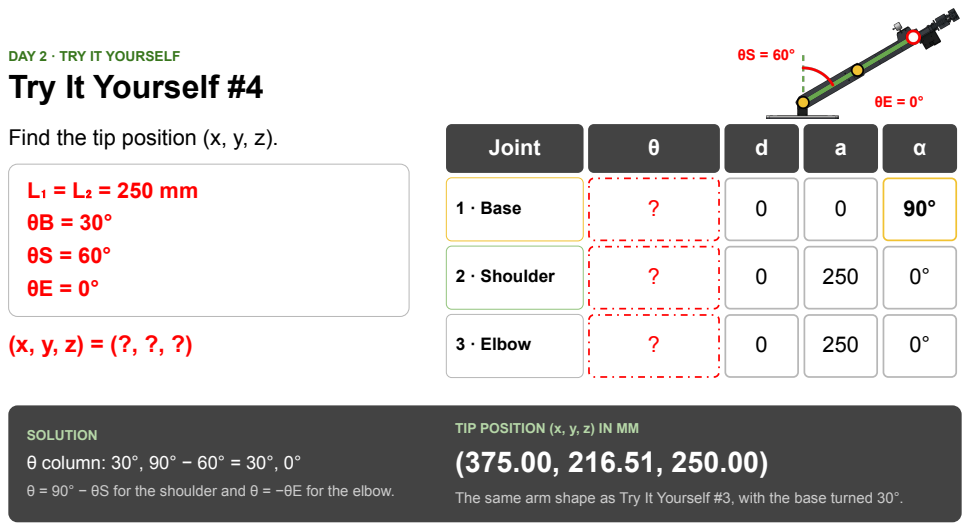
[picture p152: page 33]
Joint; 1 · Base; 2 · Shoulder; 3 · Elbow; SOLUTION; θ column: 30°, 90° − 60° = 30°, 0°

DAY 2 · TRY IT YOURSELF | θS = 60°

TIP POSITION (x, y, z) IN MM

θ = 90° − θS for the shoulder and θ = −θE for the elbow.

The same arm shape as Try It Yourself #3, with the base turned 30°.

# Try It Yourself #5

Find the tip position (x, y, z).

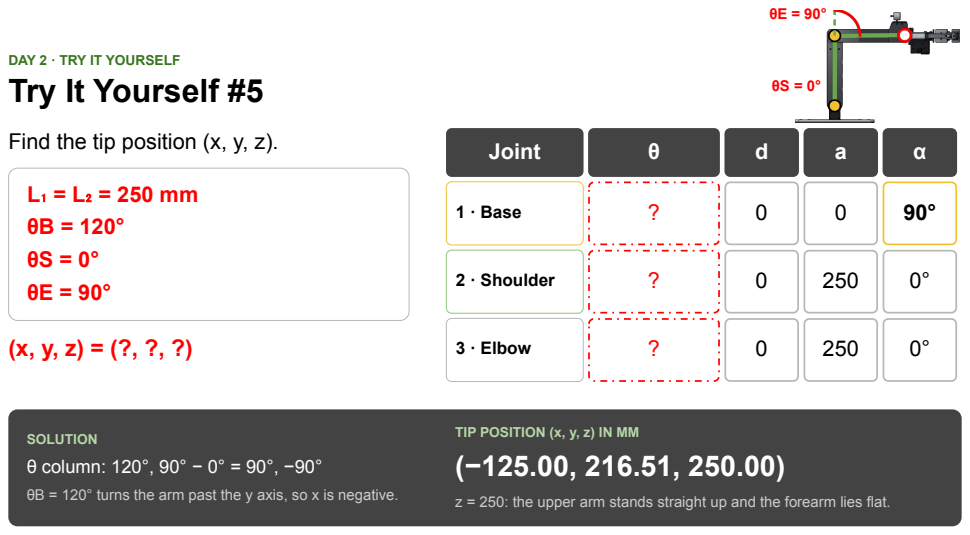
[picture p153: page 34]
Joint; 1 · Base; 2 · Shoulder; 3 · Elbow; SOLUTION; θ column: 120°, 90° − 0° = 90°, −90°

DAY 2 · TRY IT YOURSELF

TIP POSITION (x, y, z) IN MM

θB = 120° turns the arm past the y axis, so x is negative.

z = 250: the upper arm stands straight up and the forearm lies flat.

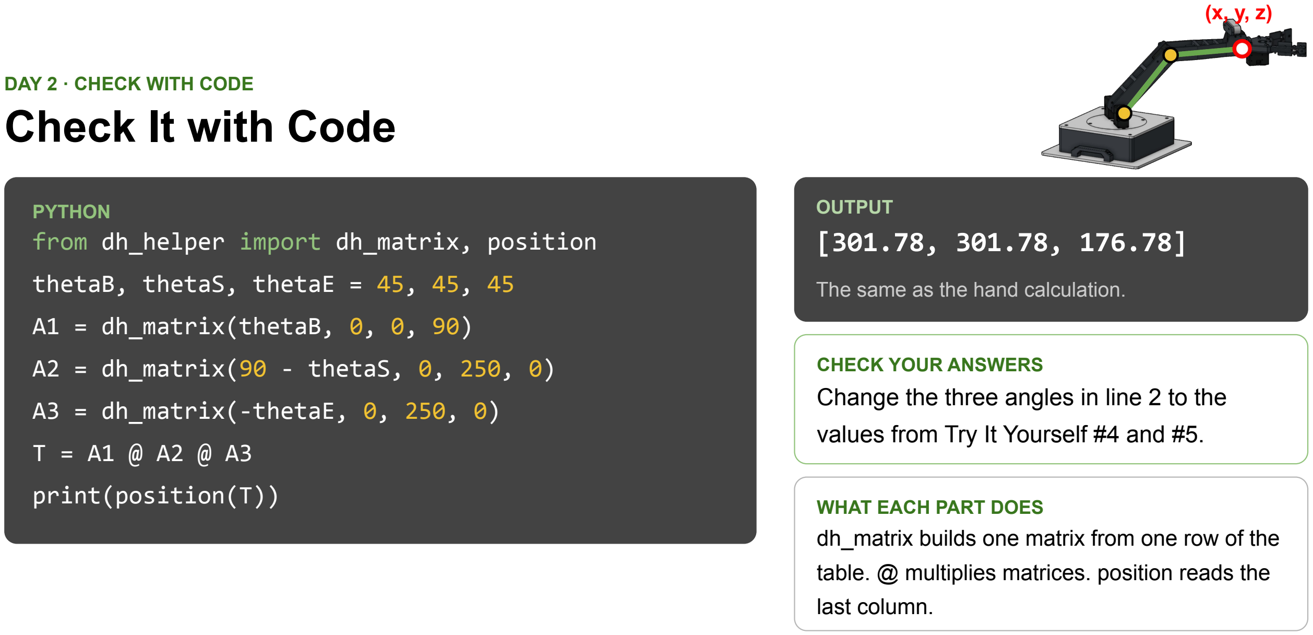
[picture p154: figure]
DAY 2 · CHECK WITH CODE Check It with Code; PYTHON from dh_helper import dh_matrix, position; thetaB, thetaS, thetaE = 45, 45, 45; A1 = dh_matrix(thetaB, 0, 0, 90); A2 = dh_matrix(90 - thetaS, 0, 250, 0); A3 = dh_matrix(-thetaE, 0, 250, 0); print(position(T)); OUTPUT [301.78, 301.78, 176.78]; The same as the hand calculation.; CHECK YOUR ANSWERS; values from Try It Yourself #4 and #5.; WHAT EACH PART DOES; last column.

Change the three angles in line 2 to the

dh_matrix builds one matrix from one row of the table. @ multiplies matrices. position reads the

DAY 2 · COMPARISON

# Trigonometry vs. DH Matrices

LESSON 3 · TRIGONOMETRY

+ | Quick for one or two joints
+ | Easy to picture with triangles
− | New triangles for every new joint
− | Gets messy when the arm tilts in 3D

LESSON 4 · DH MATRICES

+ | The same recipe for every joint
+ | A computer can do the multiplying
+ | A standard way to describe robot arms
− | More setup: frames and a table

Both methods give the same answer. DH keeps working as the arm gets bigger.

DAY 2 · WRAP-UP

# What We Learned

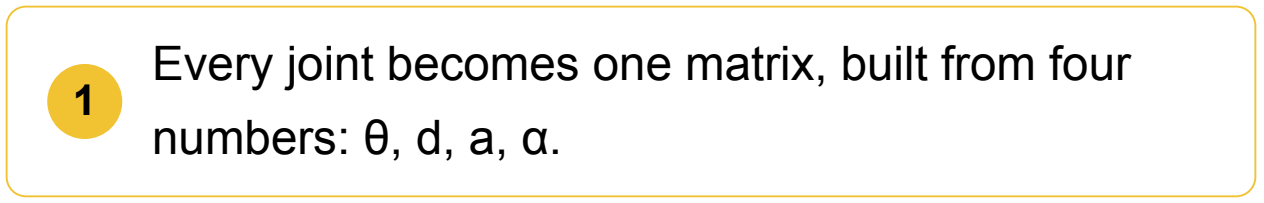
[picture p155: figure]
numbers: θ, d, a, α.
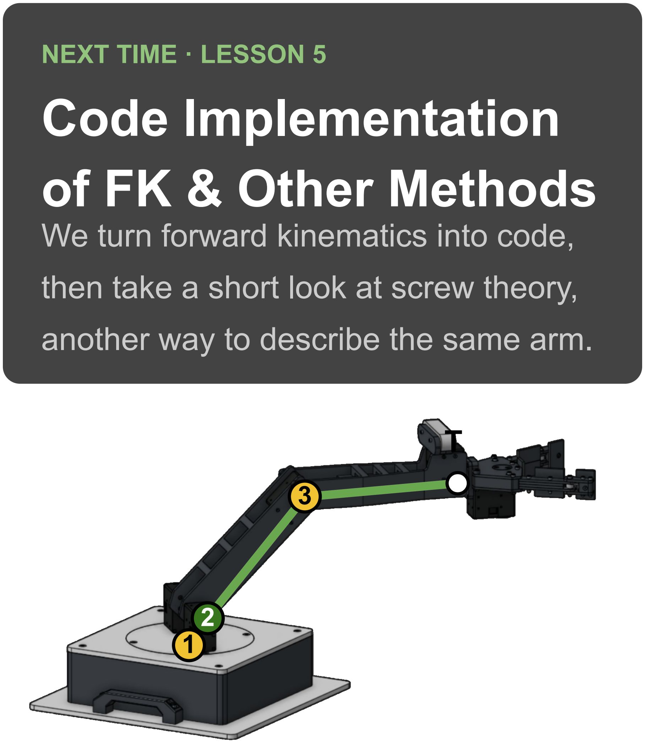
[picture p156: figure]
NEXT TIME · LESSON 5 Code Implementation of FK & Other Methods; We turn forward kinematics into code,; then take a short look at screw theory,; another way to describe the same arm.

## Every joint becomes one matrix, built from four

2 Frames: z is the joint axis, x is the link.

3 Multiply the matrices in joint order: T = A₁ · A₂ · A₃.

4 The last column of T is the tip position (x, y, z).
