balu-lab/cabs-PETFAB-Hammer-Joshua/PETFAB-Armadillo/Curriculum/Lesson 3/Updated_Trigonometry FK.pdf

## The Trigonometric Approach to Forward Kinematics

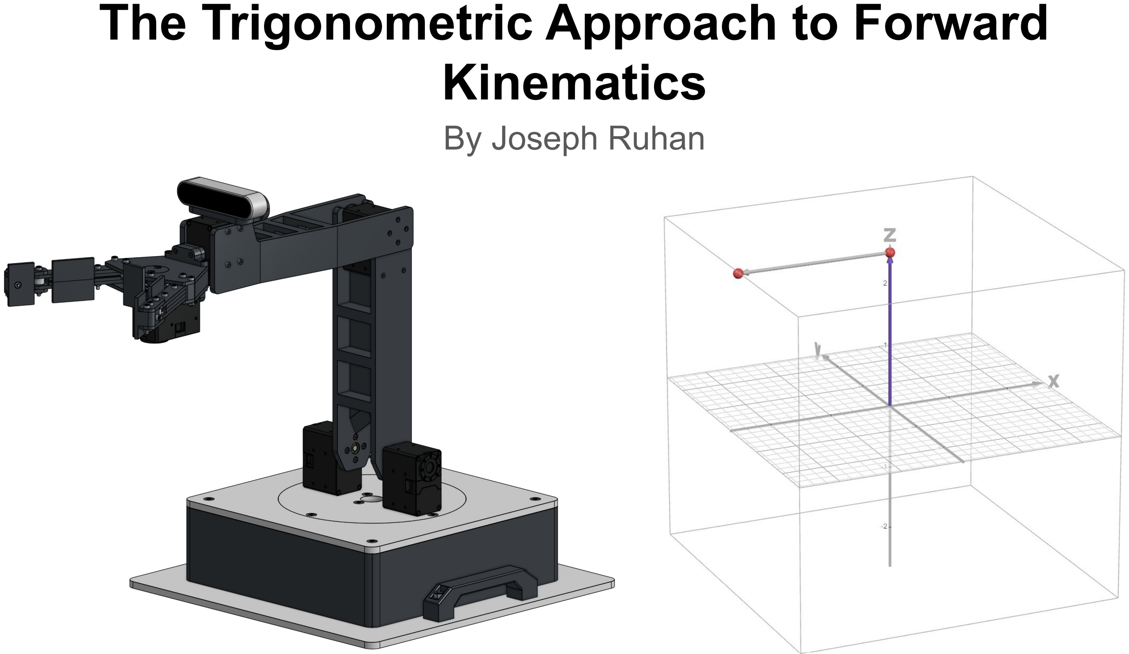
[picture p157: page 1]

By Joseph Ruhan

## Where

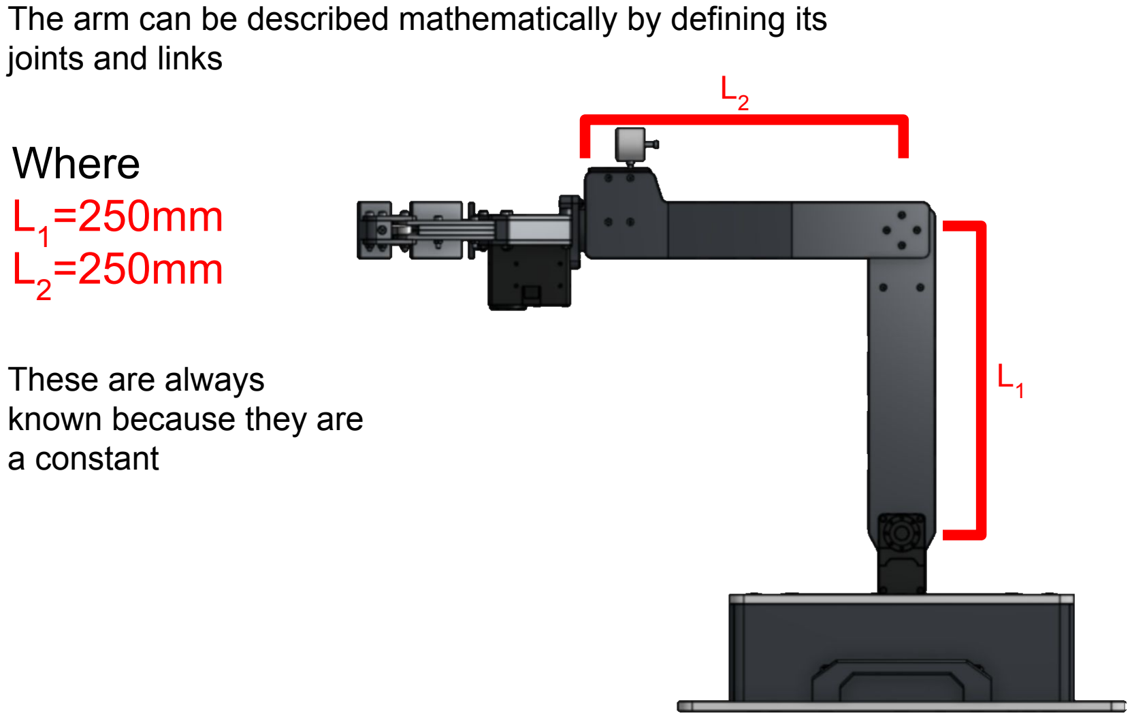
[picture p158: page 2]

The arm can be described mathematically by defining its joints and links
L2

L1

## L1=250mm L2=250mm

These are always
known because they are
a constant

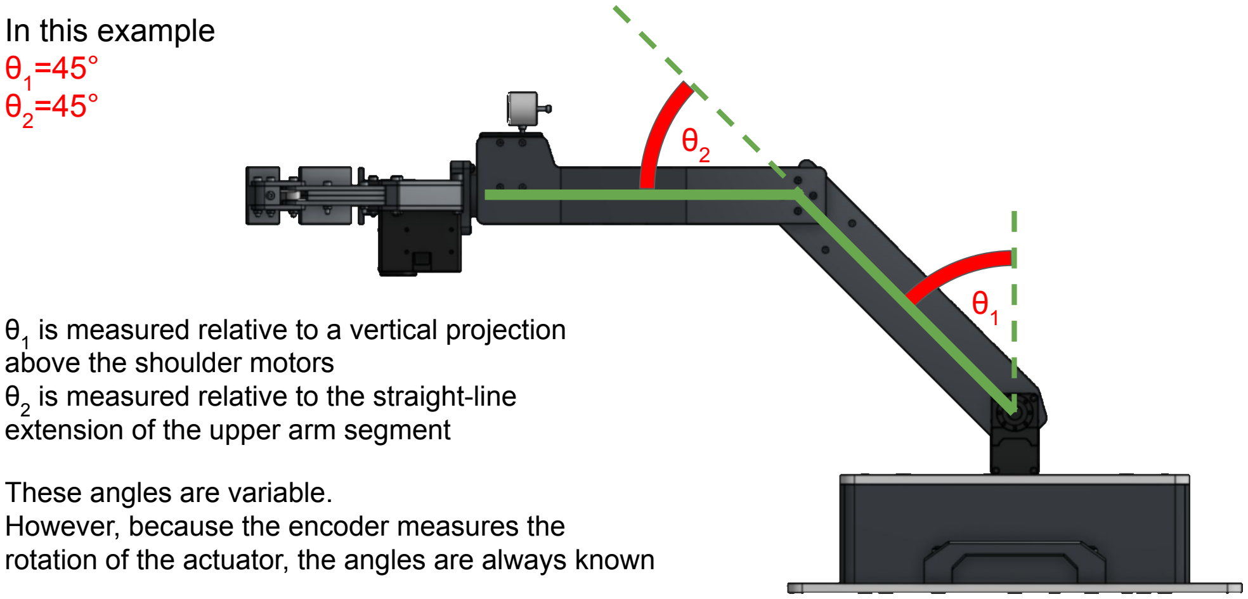
[picture p159: page 3]

In this example
θ1=45°
θ2=45°

θ1
is measured relative to a vertical projection above the shoulder motors
θ2
is measured relative to the straight-line extension of the upper arm segment

These angles are variable.
However, because the encoder measures the rotation of the actuator, the angles are always known

θ1

θ2

The arm can therefore be represented as such:

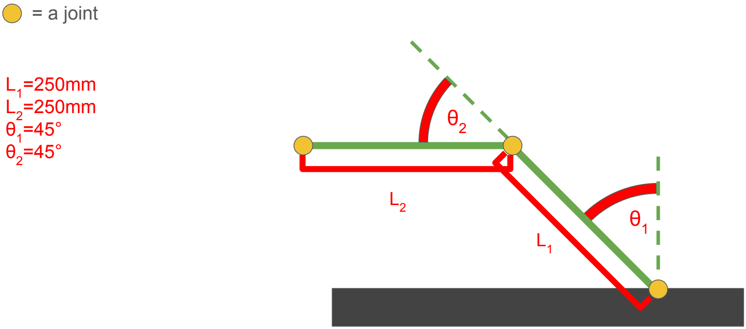
[picture p160: figure]
= a joint
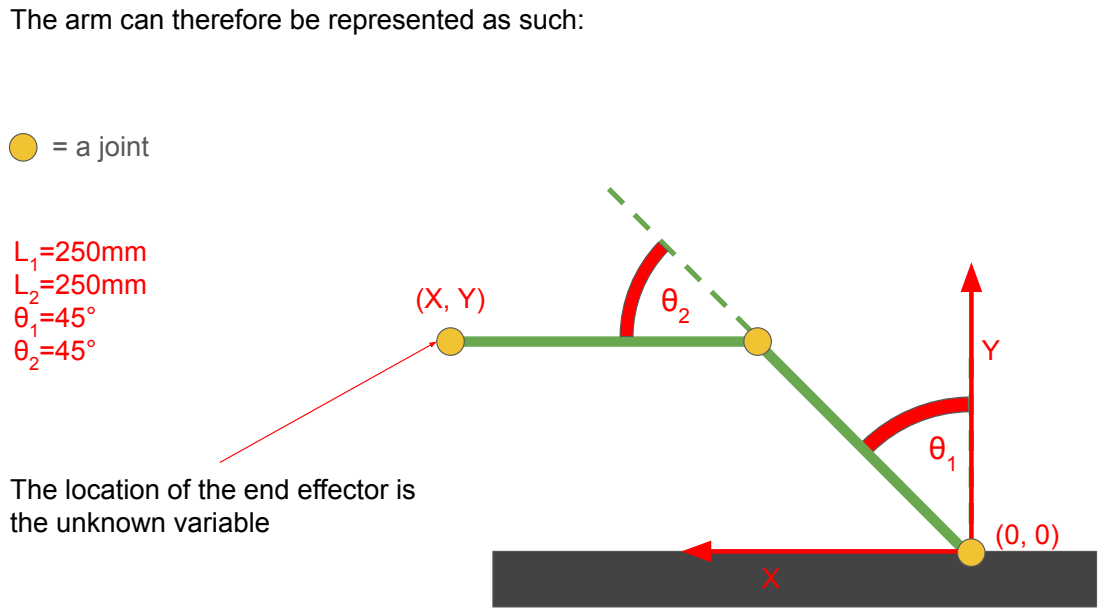
[picture p161: page 5]
= a joint

The arm can therefore be represented as such:

The location of the end effector is
the unknown variable

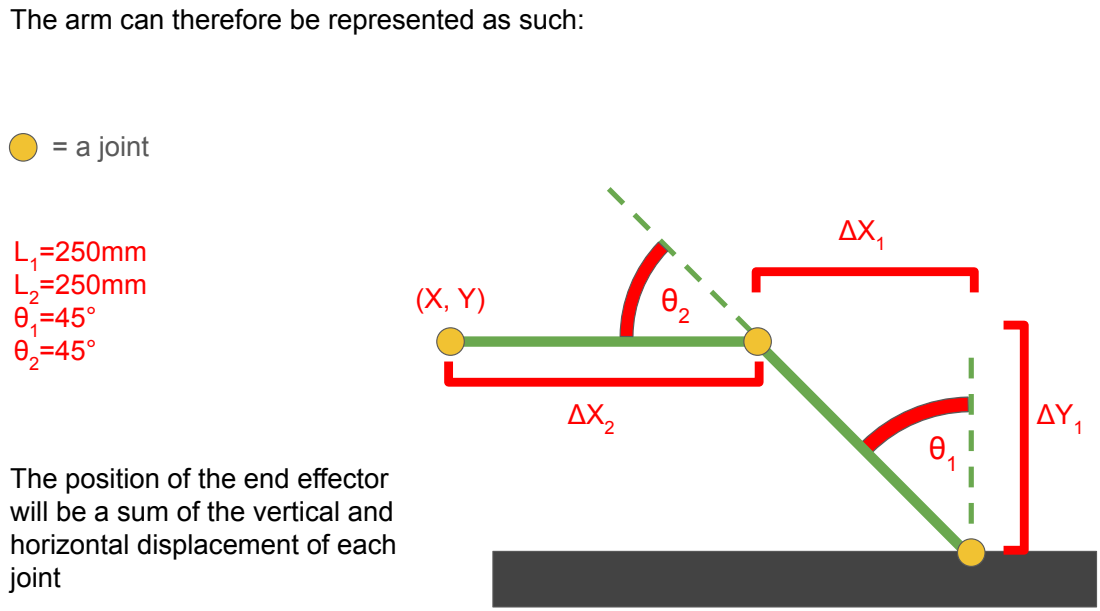
[picture p162: page 6]
= a joint

The arm can therefore be represented as such:

The position of the end effector
will be a sum of the vertical and
horizontal displacement of each
joint

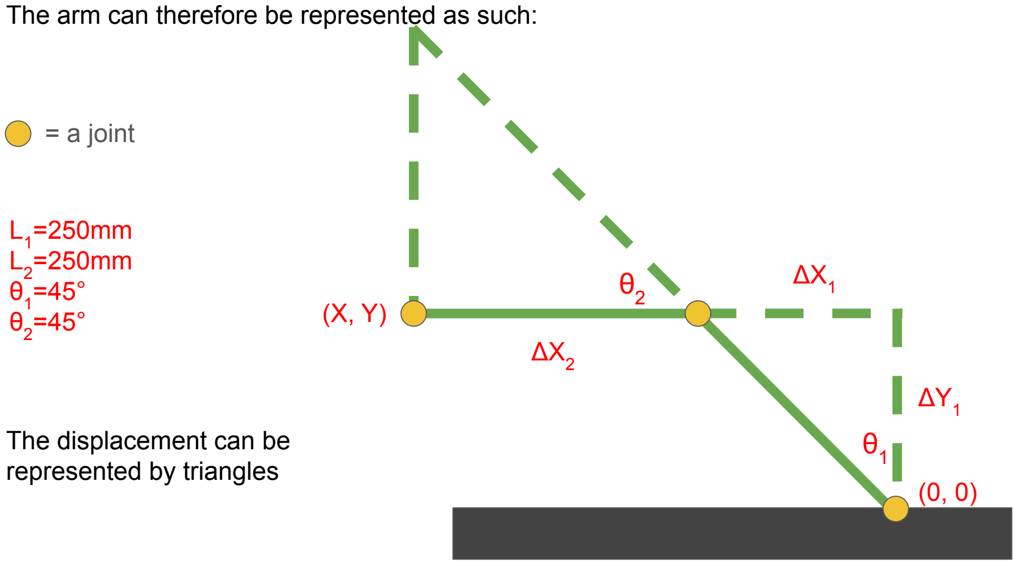
[picture p163: figure]
= a joint; The displacement can be represented by triangles

The arm can therefore be represented as such:

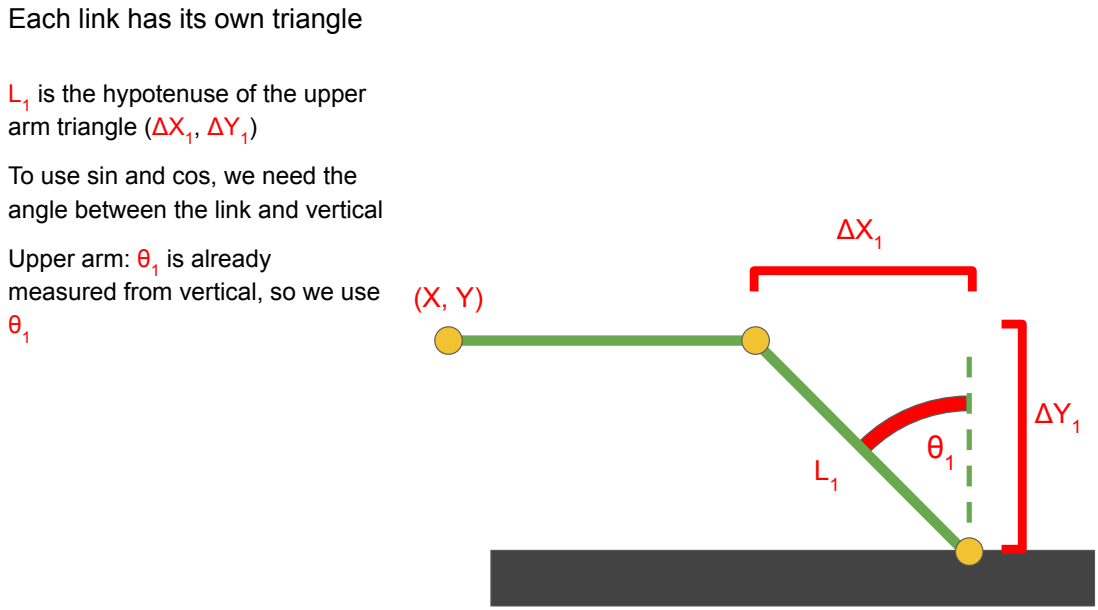
[picture p164: page 8]
is already

Each link has its own triangle

is the hypotenuse of the upper
arm triangle (ΔX

To use sin and cos, we need the
angle between the link and vertical

Upper arm:
measured from vertical, so we use θ1

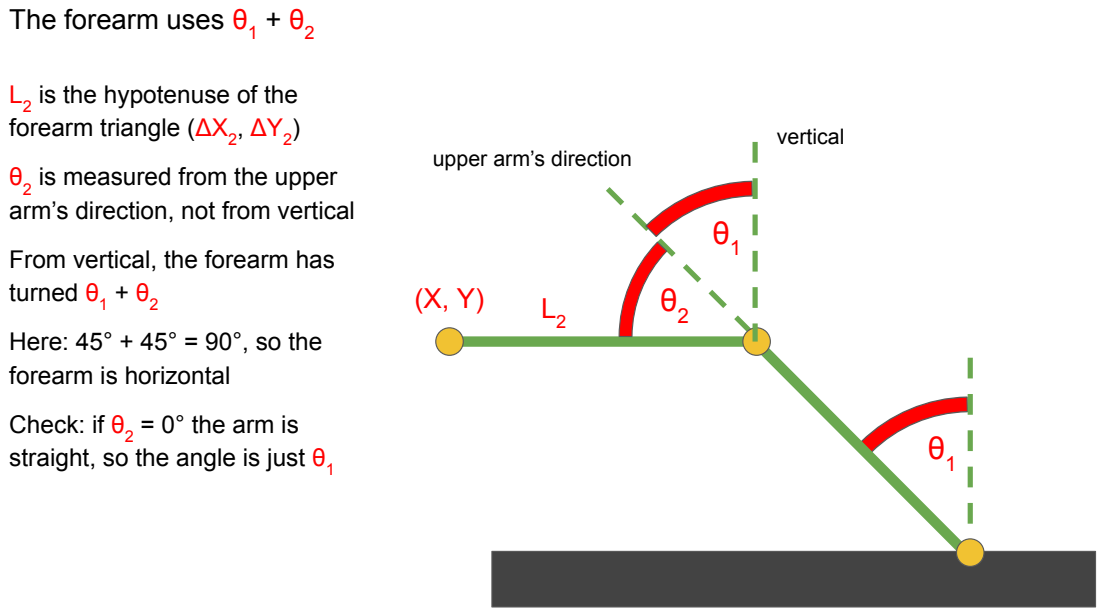
[picture p165: page 9]
vertical

The forearm uses

is the hypotenuse of the
forearm triangle (ΔX

upper arm’s direction

arm’s direction, not from vertical

is measured from the upper

From vertical, the forearm has
turned

Here: 45° + 45° = 90°, so the
forearm is horizontal

Check: if
straight, so the angle is just

= 0° the arm is

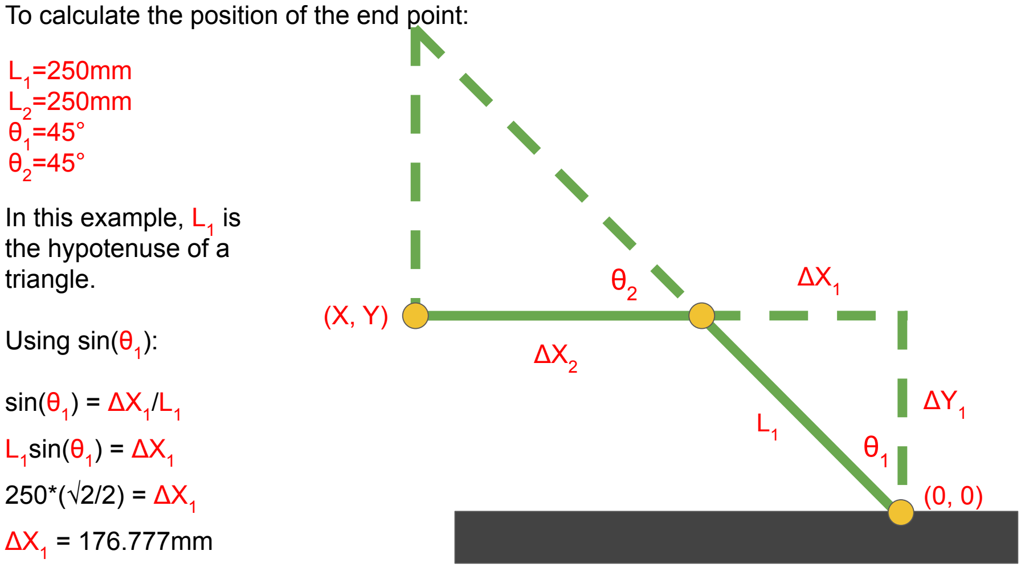
[picture p166: figure]
In this example,; is the hypotenuse of a triangle.; Using sin(; sin(

To calculate the position of the end point:

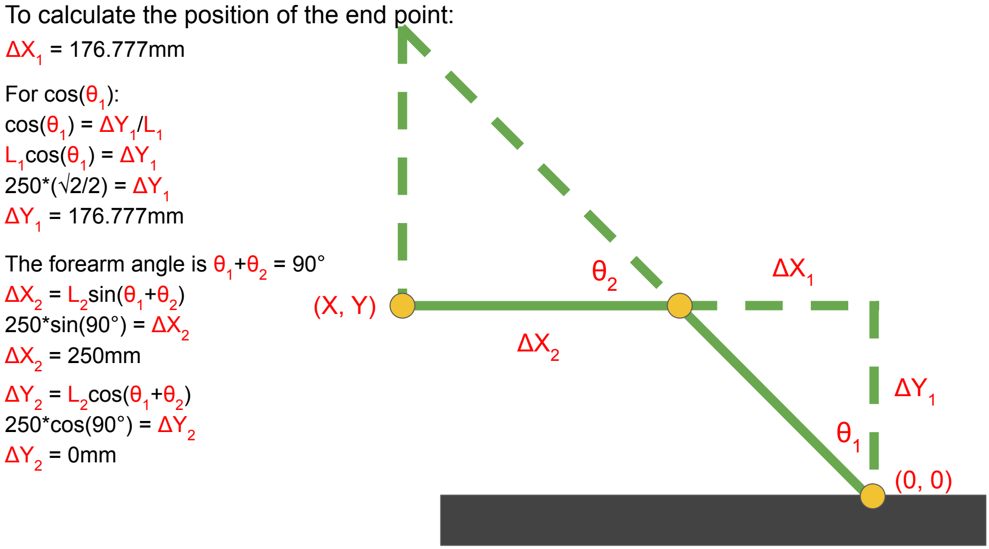
[picture p167: figure]
For cos(; cos(; The forearm angle is; sin(; ) 250*sin(90°) = ΔX; ) 250*cos(90°) = ΔY

To calculate the position of the end point:

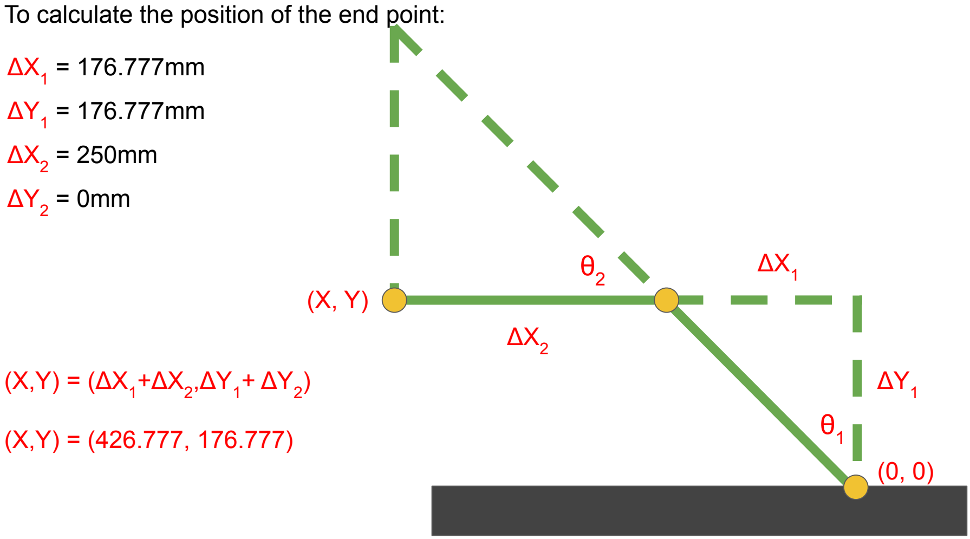
[picture p168: figure]

To calculate the position of the end point:

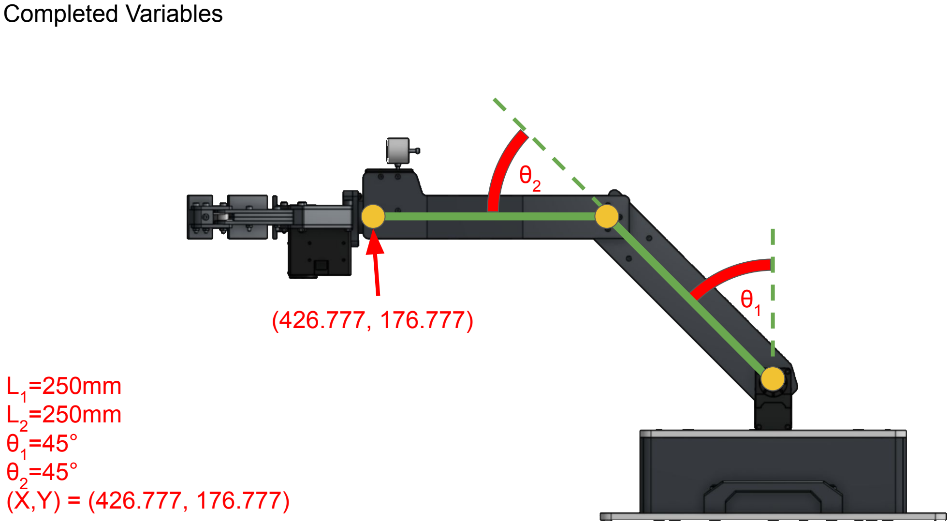
[picture p169: page 13]

Completed Variables

L1=250mm
L2=250mm
θ1=45°
θ2=45°
(X,Y) = (426.777, 176.777)

(426.777, 176.777)

θ1

θ2

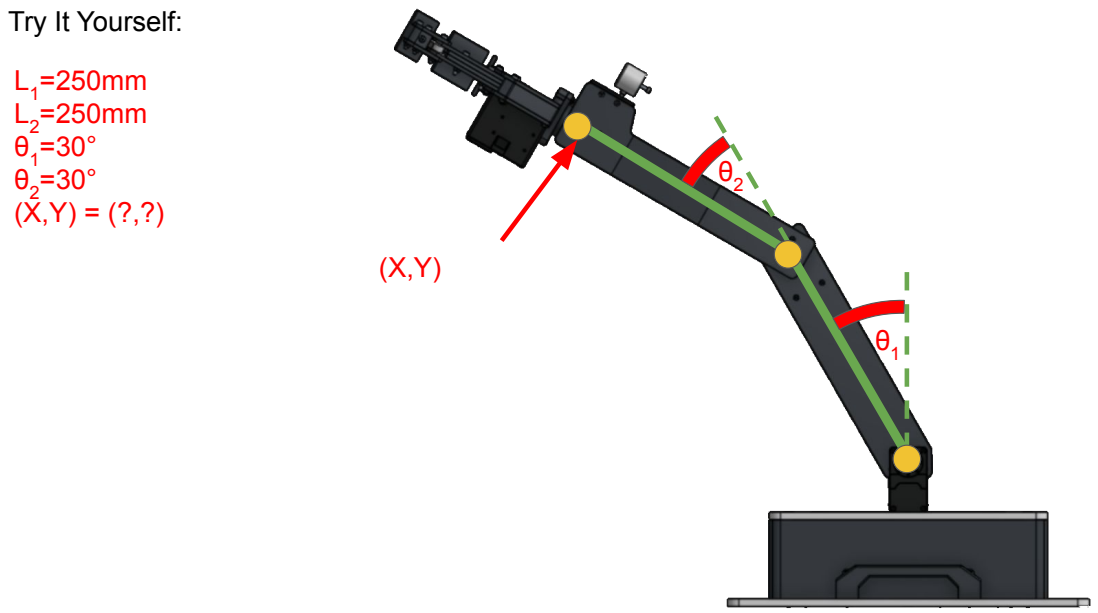
[picture p170: page 14]

Try It Yourself: L1=250mm L2=250mm θ1=30° θ2=30°

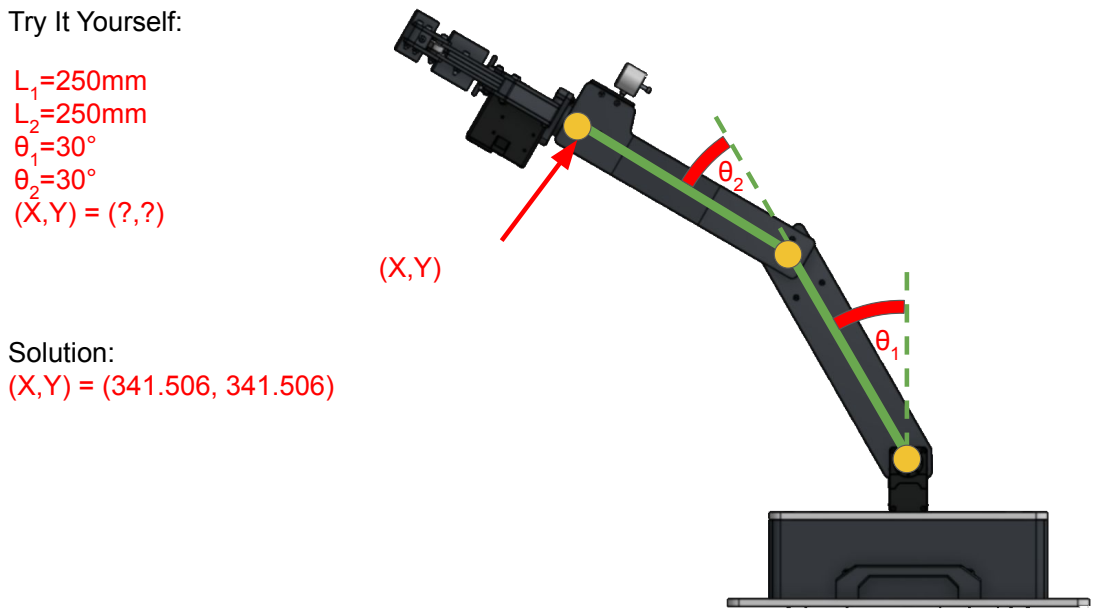
[picture p171: page 15]
Solution: (X,Y) = (341.506, 341.506)

Try It Yourself: L1=250mm L2=250mm θ1=30° θ2=30°

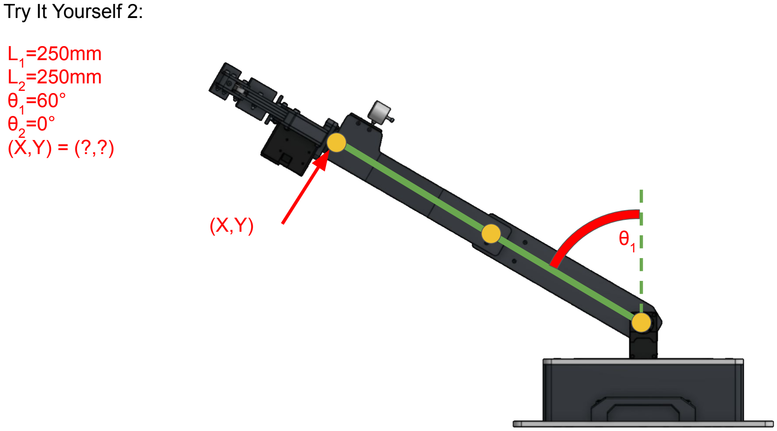
[picture p172: page 16]

Try It Yourself 2: L1=250mm L2=250mm θ1=60° θ2=0°

(X,Y) = (?,?)

(X,Y)
θ
1

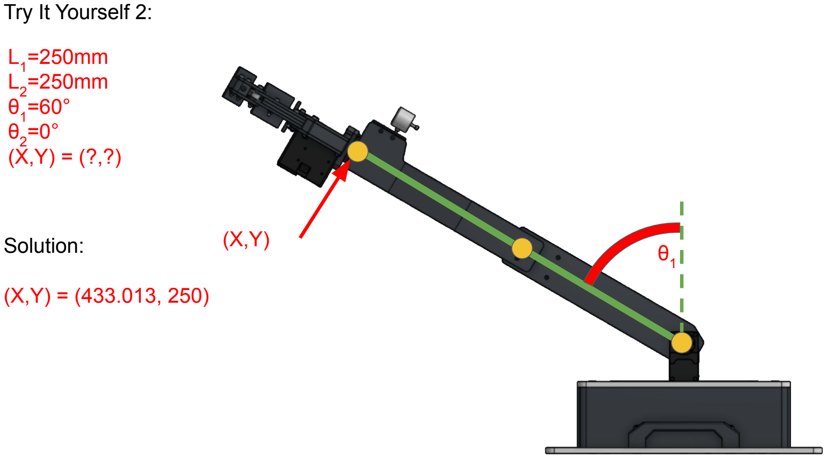
[picture p173: page 17]

Try It Yourself 2: L1=250mm L2=250mm θ1=60° θ2=0°

(X,Y) = (?,?)

(X,Y)
θ
1

Solution:

(X,Y) = (433.013, 250)

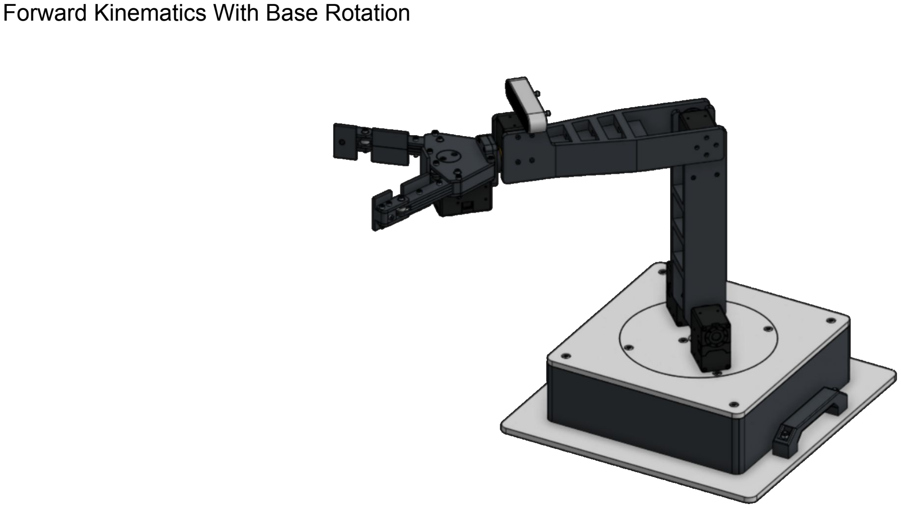
[picture p174: page 18]

Forward Kinematics With Base Rotation

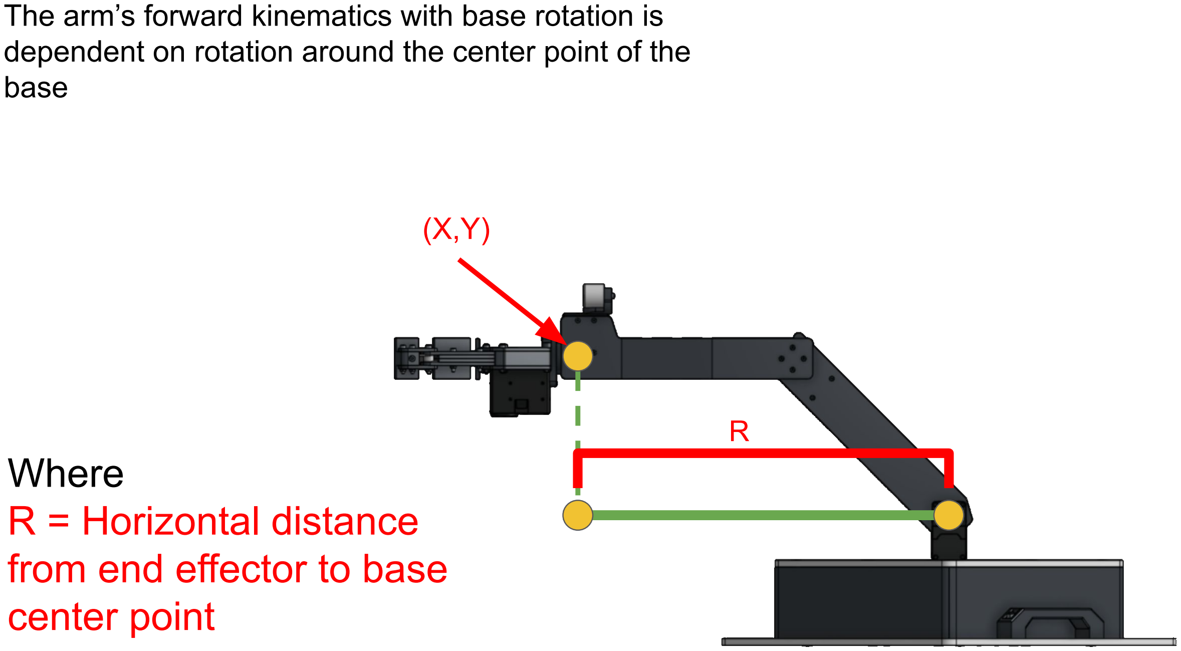
[picture p175: page 19]

The arm’s forward kinematics with base rotation is dependent on rotation around the center point of the base

## Where R = Horizontal distance from end effector to base center point

(X,Y)

R

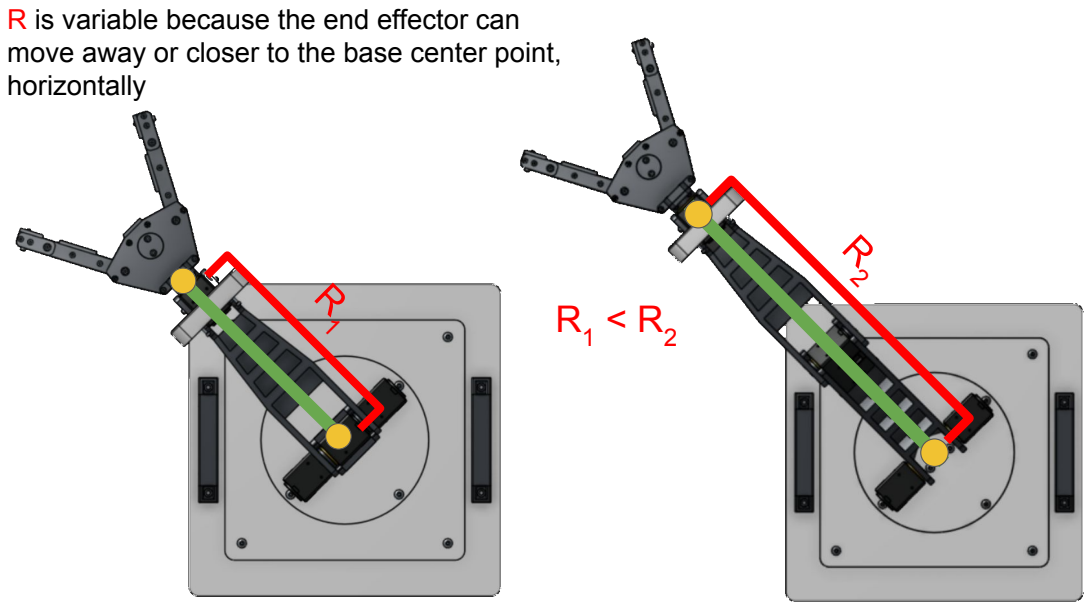
[picture p176: page 20]

R is variable because the end effector can
move away or closer to the base center point,
horizontally

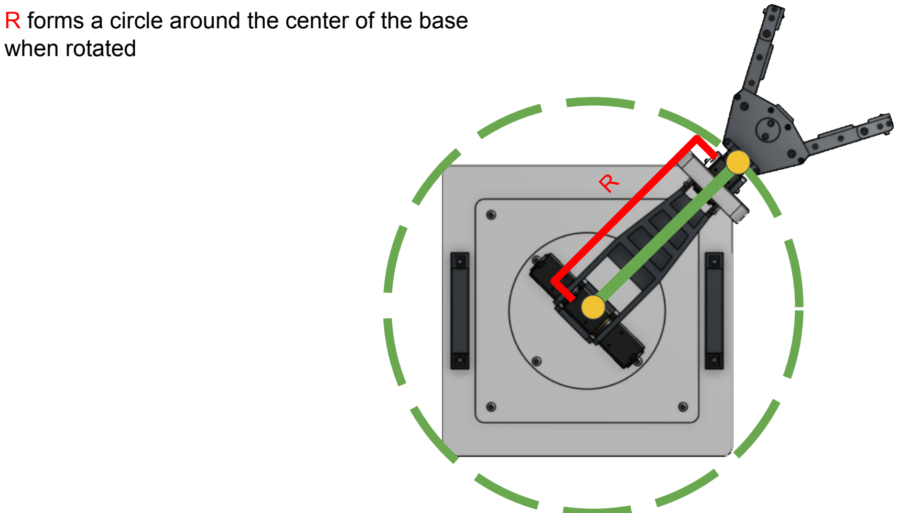
[picture p177: page 21]

R forms a circle around the center of the base when rotated

R

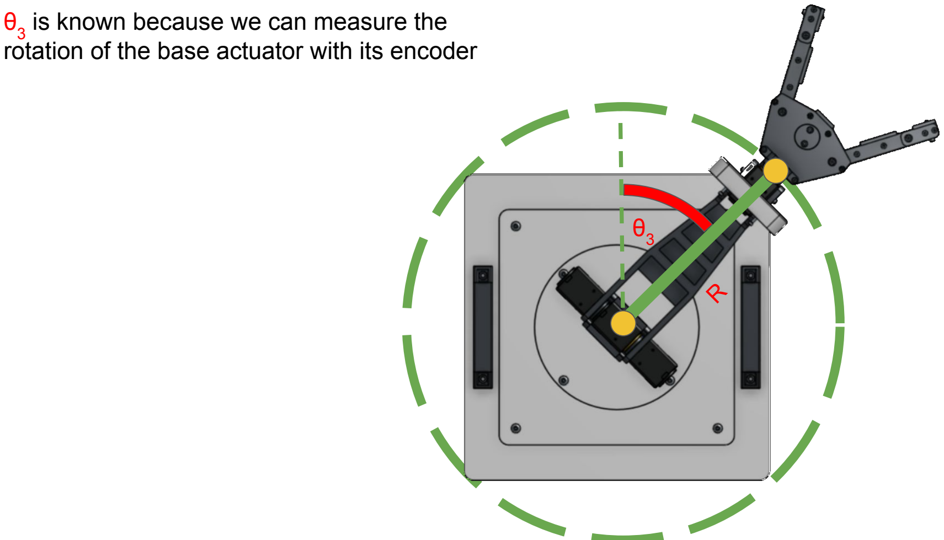
[picture p178: page 22]

θ3
is known because we can measure the rotation of the base actuator with its encoder

θ3

R

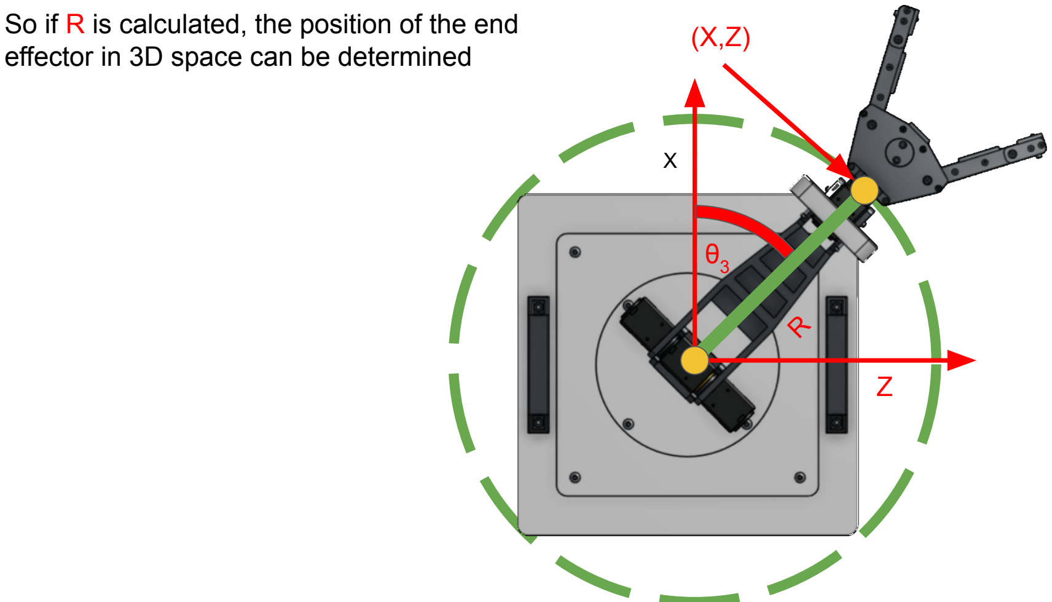
[picture p179: page 23]

So if R is calculated, the position of the end effector in 3D space can be determined

θ3

R

(X,Z)

X

Z

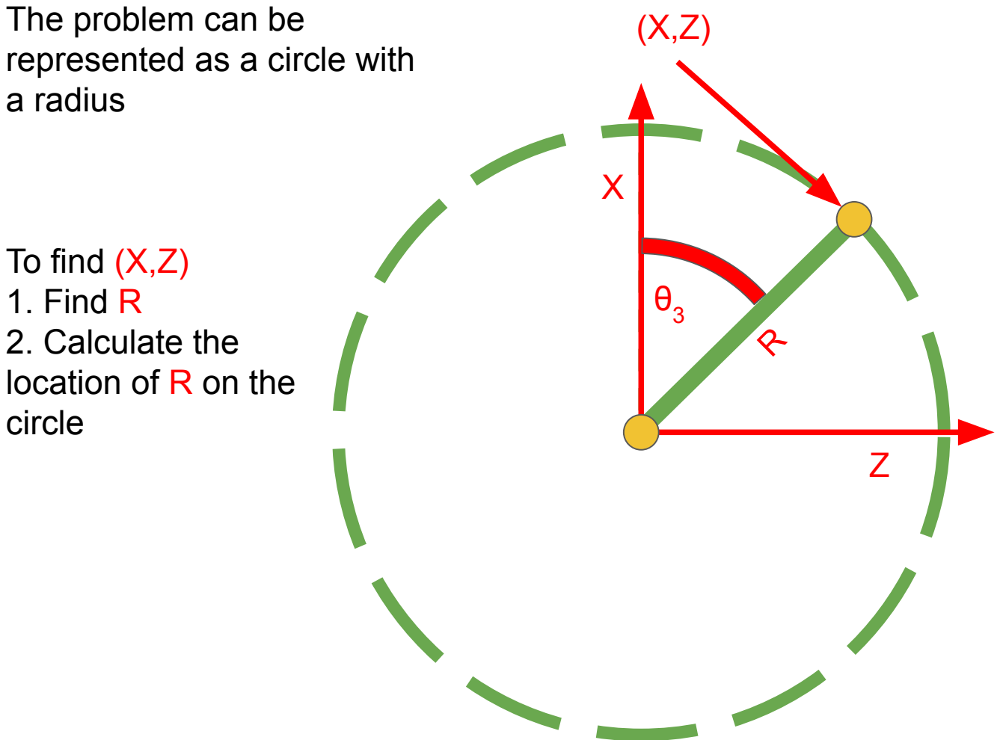
[picture p180: figure]
The problem can be represented as a circle with a radius; To find (X,Z) 1. Find; R 2. Calculate the location of; R on the; circle
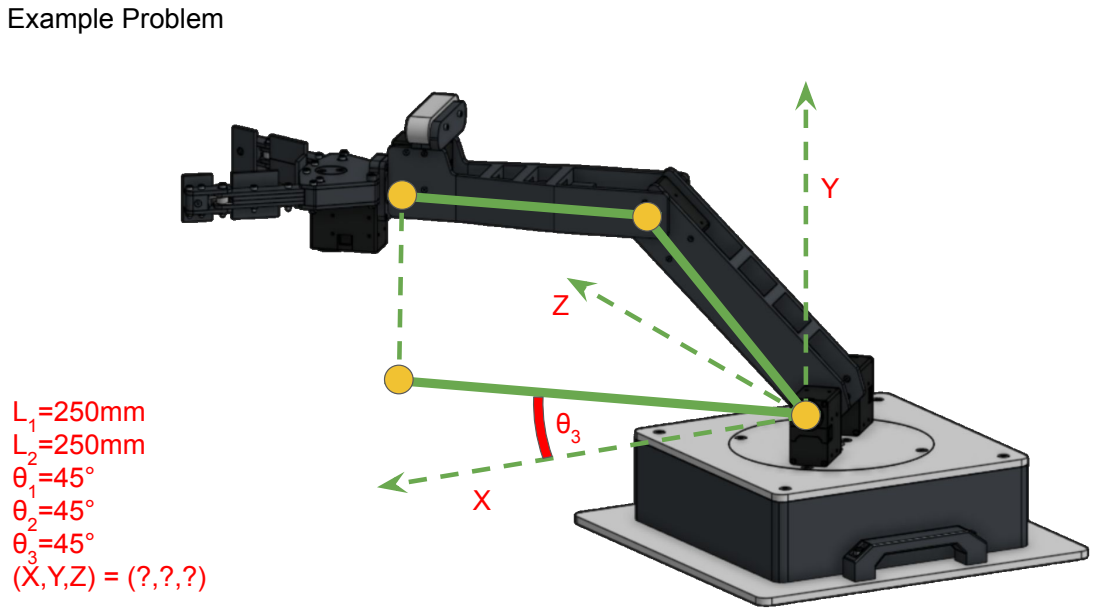
[picture p181: page 25]
Example Problem

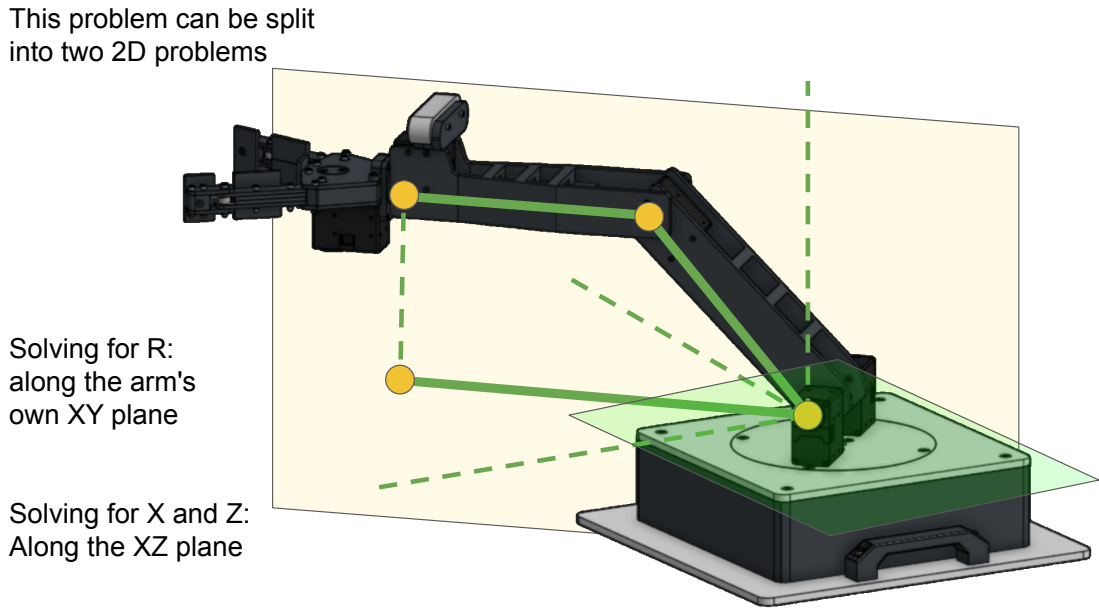
[picture p182: page 26]

This problem can be split
into two 2D problems

Solving for R:
along the arm's
own XY plane

Solving for X and Z:
Along the XZ plane

The problem can be solved
along these two planes

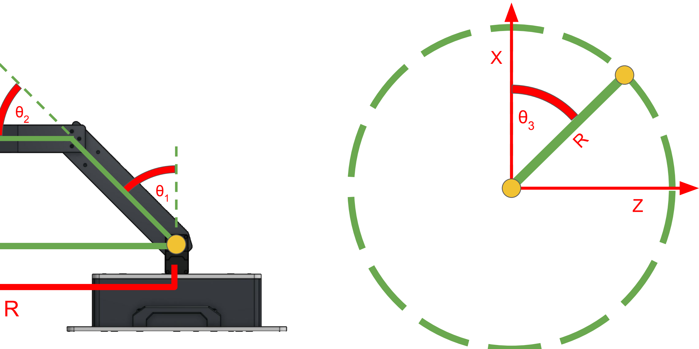
[picture p183: figure]
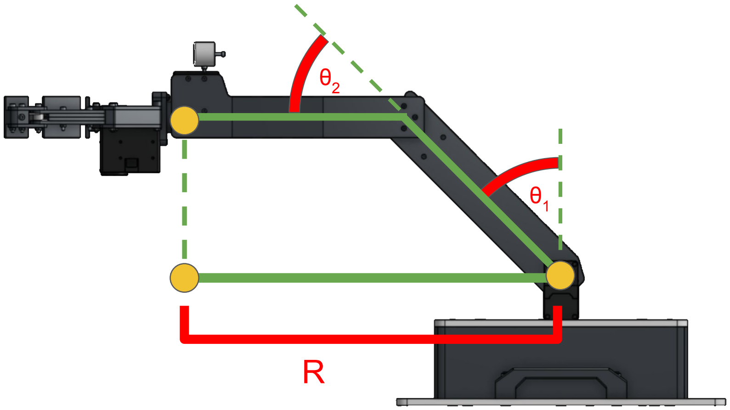
[picture p184: figure]
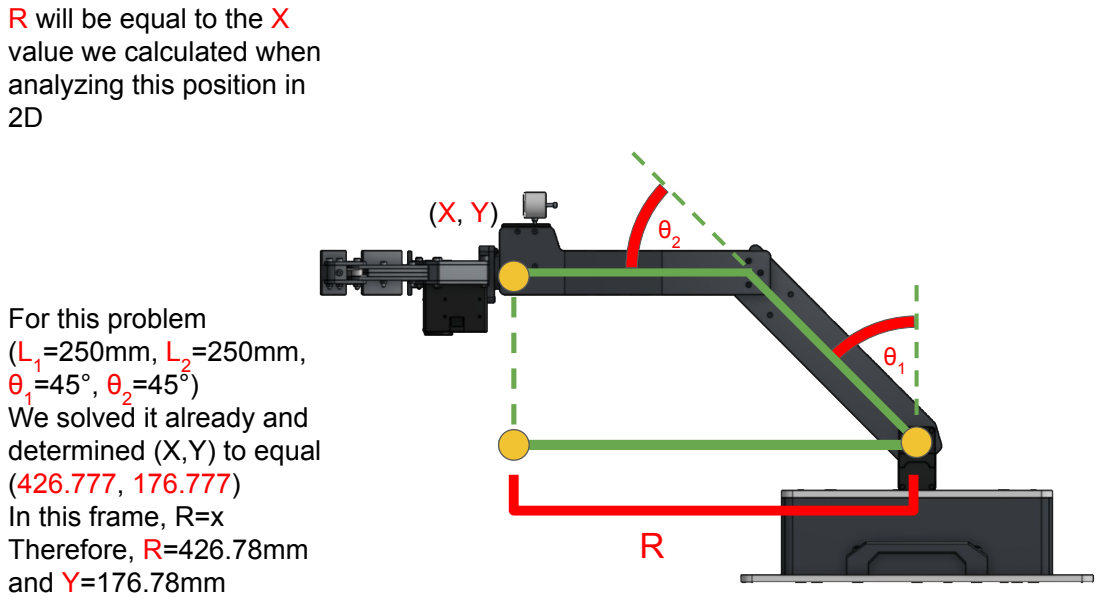
[picture p185: page 28]
In this frame, R=x Therefore,; and

R will be equal to the
value we calculated when
analyzing this position in

For this problem (L1=250mm, L2=250mm, θ1=45°, θ2=45°)

We solved it already and
determined (X,Y) to equal (426.777, 176.777)

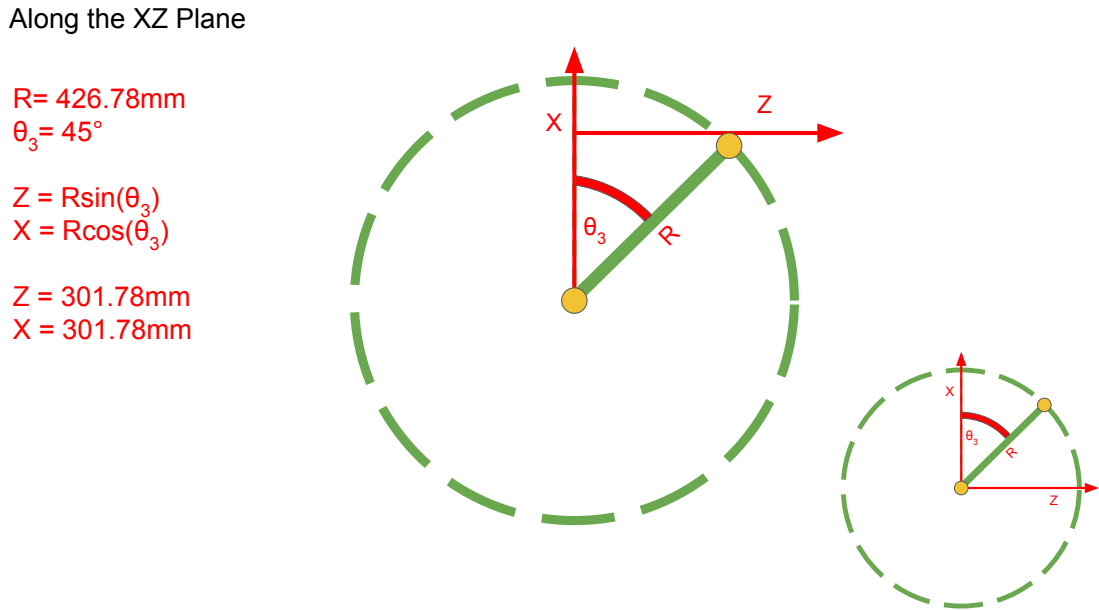
[picture p186: page 29]
Z = Rsin(θ; X = Rcos(θ

Along the XZ Plane

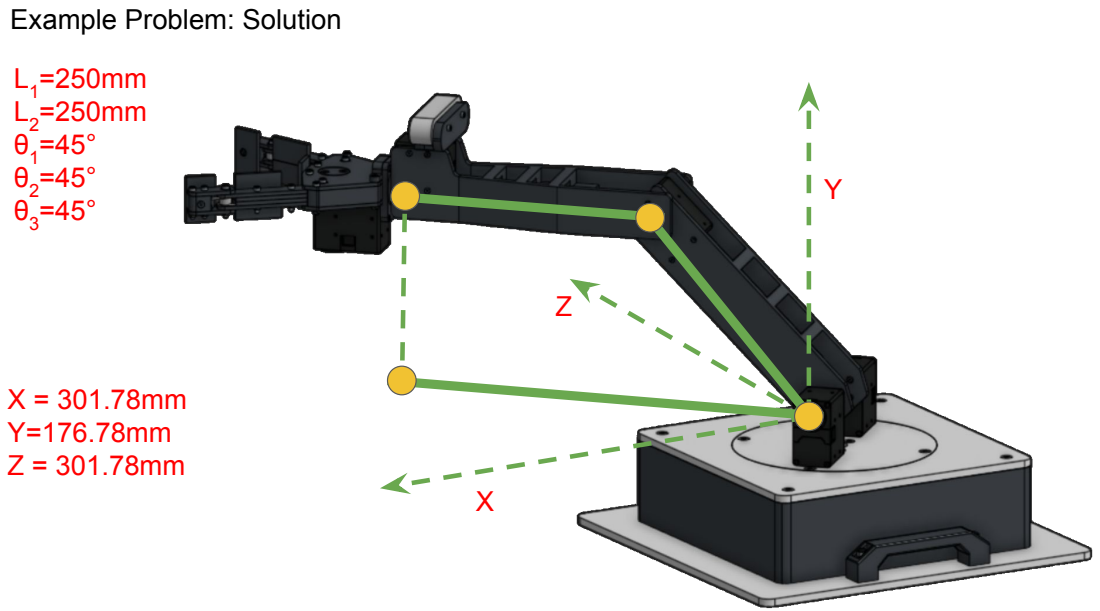
[picture p187: page 30]

Example Problem: Solution L1=250mm L2=250mm θ1=45° θ2=45° θ3=45°

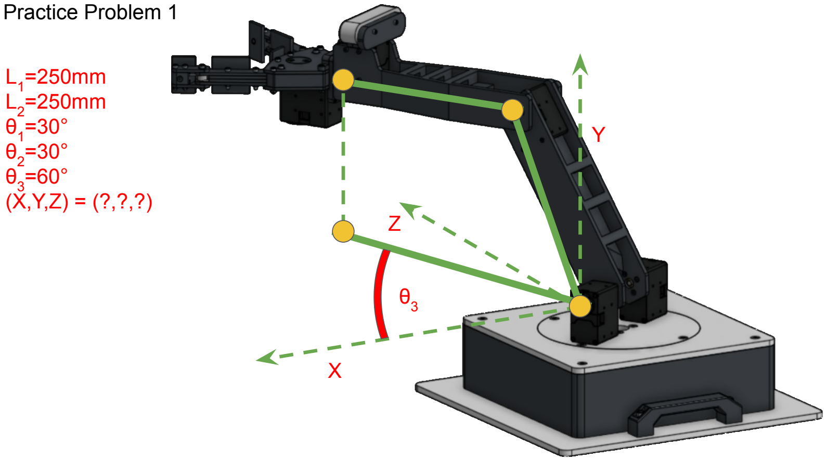
[picture p188: page 31]

Practice Problem 1

θ
3

L

1=250mm
L

2=250mm
θ

1=30°
θ

2=30°
θ

3=60°
(X,Y,Z) = (?,?,?)

X

Y

Z

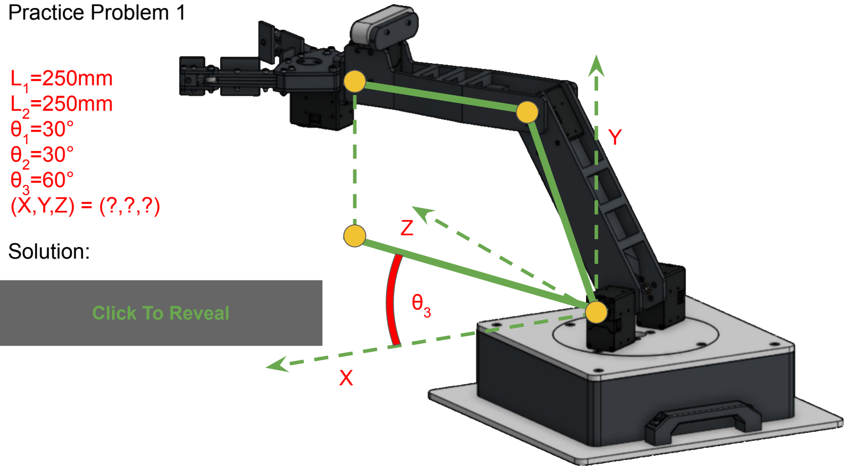
[picture p189: page 32]

Practice Problem 1

θ3

L1=250mm
L2=250mm
θ1=30°
θ2=30°
θ3=60°
(X,Y,Z) = (?,?,?)

X

Y

Z
Solution:

(X,Y,Z) = (170.75,341.51,295.75) Click To Reveal

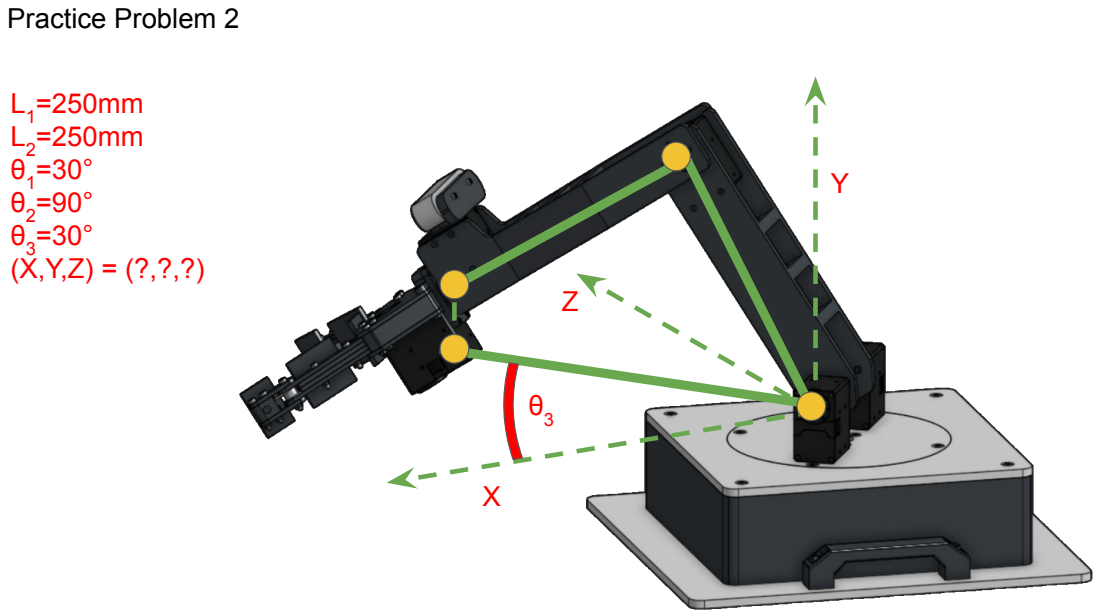
[picture p190: page 33]
Practice Problem 2

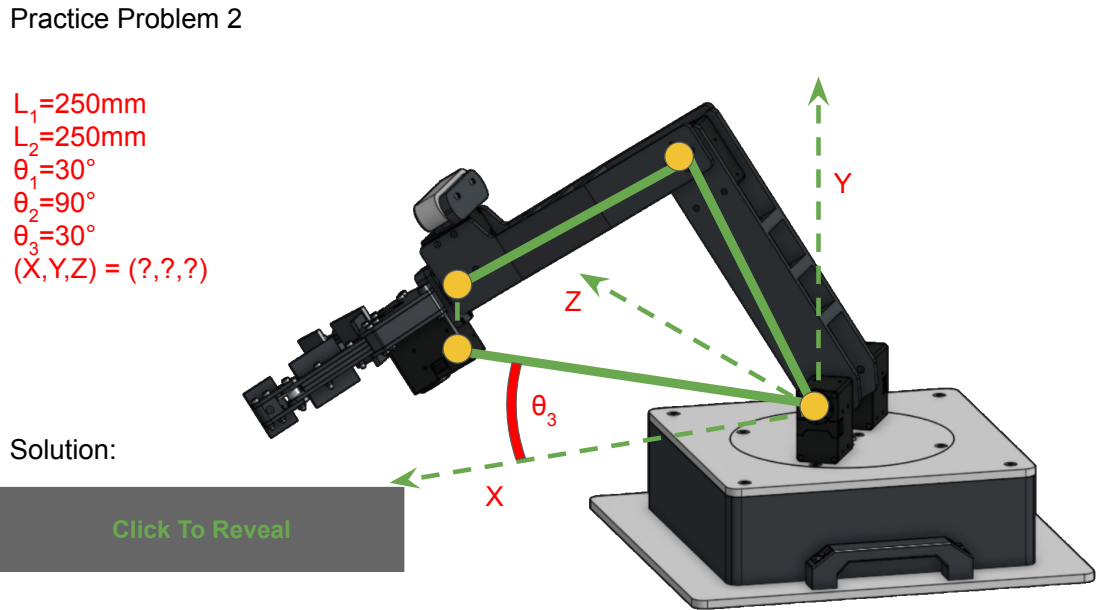
[picture p191: page 34]
Practice Problem 2 L1=250mm L2=250mm θ1=30° θ2=90° θ3=30°

Solution:

(X,Y,Z) = (295.75,91.51,170.75) Click To Reveal

Desmos Calculator

https://www.desmos.com/3d/9bnvqc263x

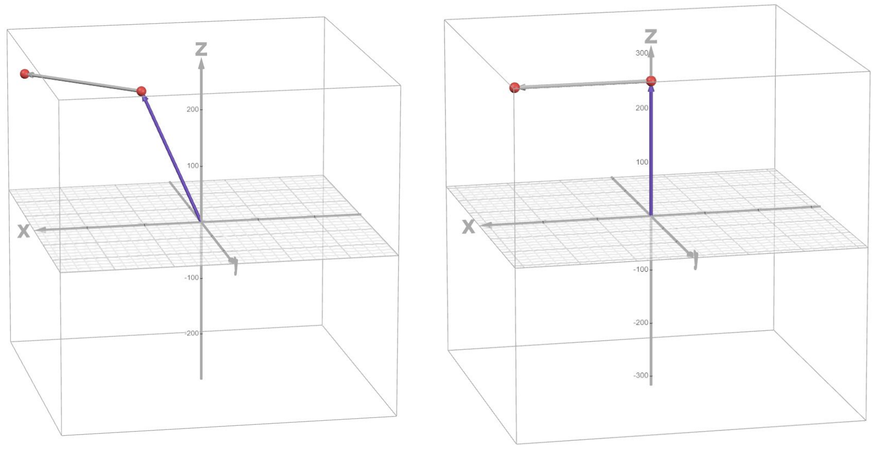
[picture p192: figure]
