balu-lab/cabs-PETFAB-Hammer-Joshua/Photos/armadillo-cad.png

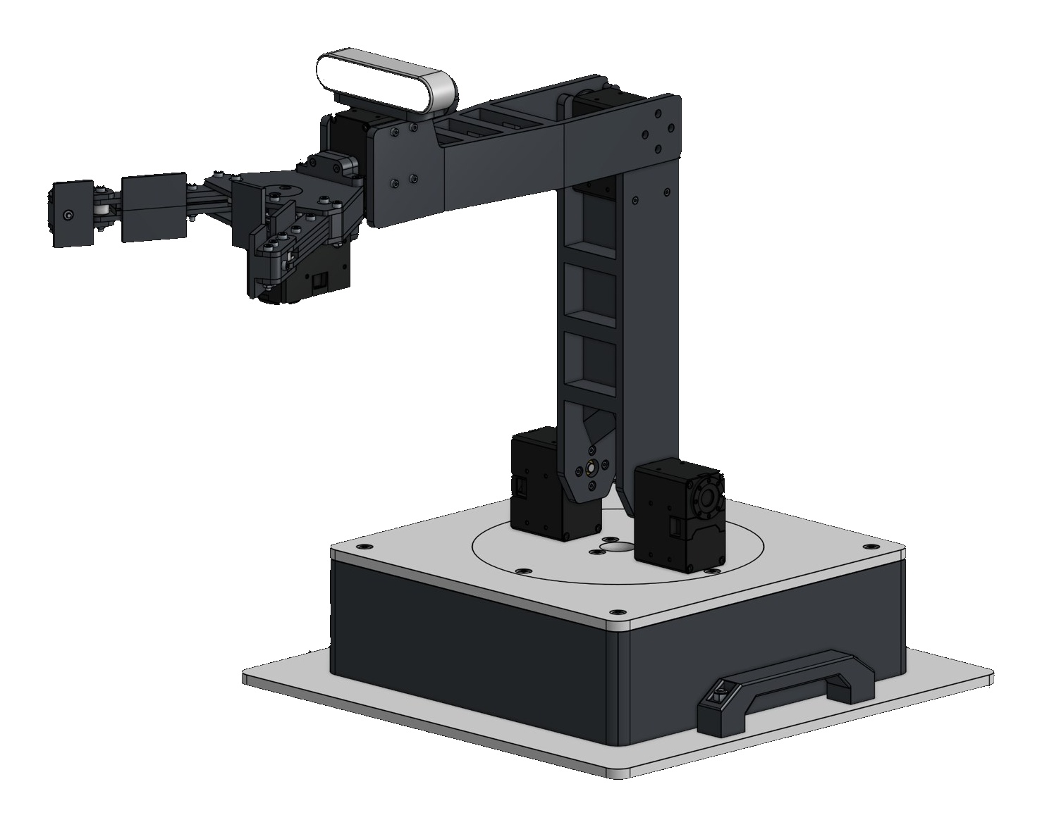
Photos/armadillo-cad.png
