balu-lab/cabs-PETFAB-Hammer-Joshua/Photos/cad-full-arm.png

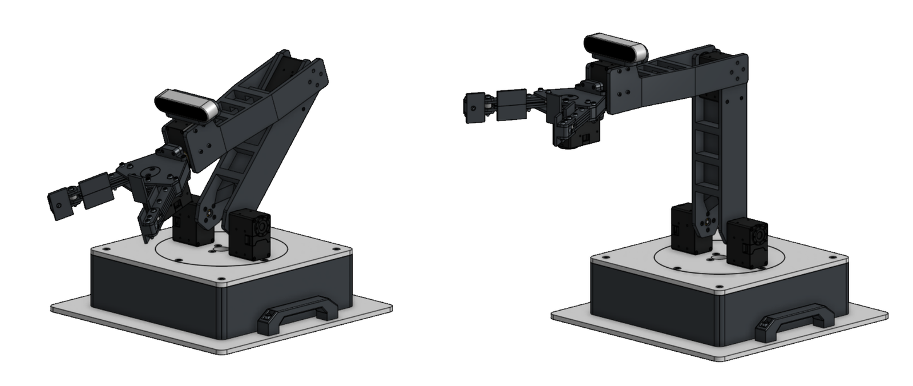
Photos/cad-full-arm.png
