balu-lab/cabs-PETFAB-Hammer-Joshua/Photos/cad-gripper.png

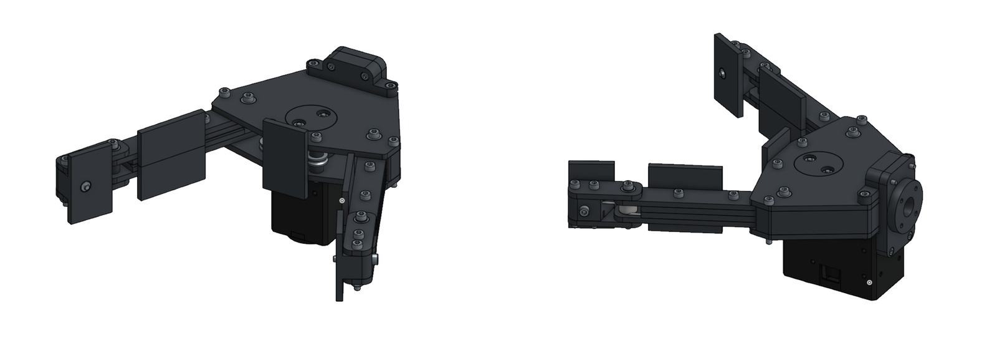
Photos/cad-gripper.png
