balu-lab/cabs-PETFAB-Hammer-Joshua/BOM/README.md

# Bill of Materials

Everything needed to build one PETFAB Armadillo.

| File | What it is |
|---|---|
| [Arm BOM.xlsx](Arm%20BOM.xlsx) | Full parts list (Excel) |
| [Arm BOM - Sheet1.pdf](Arm%20BOM%20-%20Sheet1.pdf) | The same list as a PDF, for viewing in the browser |

Each row gives the quantity, the part name, where to get it, and any notes.

- **Custom parts** are marked "Custom" in the Source column. Most are 3D printed in PETG, the shoulder and elbow pieces are printed in PLA, and the base plates are machined from 6061 aluminum on a CNC mill. The full arm assembly is in the [CAD folder](../CAD/) as a STEP file.
- **Purchased parts**, such as the actuators, camera, bearings, springs, fasteners and wiring, include a purchase link in the Source column. Several fasteners come from one bolt assortment, as noted in the Notes column.
