balu-lab/cabs-PETFAB-Hammer-Joshua/PETFAB-Armadillo/BOM/Arm BOM - Sheet1.pdf

Quantity of Part Name | Source | Note(s)
1 | Wire Holder | Custom | 3D Printed using Elegoo PETG
1 | Top Wrist Mount | Custom | 3D Printed using Elegoo PETG
1 | Spur Gear 3.25M 36T | Custom | 3D Printed using Elegoo PETG
1 | Spur Gear 3.25M 12T | Custom | 3D Printed using Elegoo PETG
4 | Spring Spacer | Custom | 3D Printed using Elegoo PETG
8 | Socket button head screw M5x0.8 x 60 | https://www.amazon.com/dp/B0FY5XGQ6R
16 | Socket button head screw M5x0.8 x 30 | https://www.amazon.com/dp/B07VNRMM7J
11 | Socket button head screw M5x0.8 x 14 | https://www.amazon.com/dp/B0FPG1KXDN
6 | Robotis XM540-T Actuators | https://robotis.us/products/dynamixel-xm540-w270-t?dxl1=XM540-W270-T&dxl2=XM430-W210-R
12 | Robotis XM540 Spacers | https://robotis.us/products/dynamixel-xm540-w270-t?dxl1=XM540-W270-T&dxl2=XM430-W210-R | Included in the purchase of XM540 Actuators
1 | Robotis Idler Horn Kit | https://robotis.us/products/hn13-i101-set
1 | RealSense D435i Camera | https://store.realsenseai.com/buy-realsense-depth-camera-d435i.html
4 | Pulley Spacer | Custom | 3D Printed using Elegoo PETG
1 | NVIDIA Jetson Nano | https://www.amazon.com/dp/B0BZJTQ5YP
4 | Modular Base Wall | Custom | 3D Printed using Elegoo PETG
4 | M5*8*25mm Threaded Aluminum Spacer | https://www.amazon.com/dp/B0CXHH9BRF
8 | M5*10mm*40mm Aluminum Spacer | https://www.amazon.com/dp/B0D2L4WW3F
4 | M5*10*10mm Aluminum Spacer | https://www.amazon.com/dp/B0D2L39PZQ
4 | M5*10*5mm Aluminum Spacer | https://www.amazon.com/dp/B0CQ2NSH2V
27 | M5 Nylock Nut | https://www.amazon.com/dp/B0CPJCTLRP
4 | M3 Washer | https://www.amazon.com/dp/B0D1XJ766V | Part of a bolt assortment
26 | M3 Nut | https://www.amazon.com/dp/B0D1XJ766V | Part of a bolt assortment
22 | M3 Lock Washer | https://www.amazon.com/dp/B0D1XJ766V | Part of a bolt assortment
20 | Hex socket head cap screw M3x0.50 x 25 | https://www.amazon.com/dp/B0D1XJ766V | Part of a bolt assortment
6 | Hex socket head cap screw M3x0.50 x 20 | https://www.amazon.com/dp/B0D1XJ766V | Part of a bolt assortment
2 | Hex socket head cap screw M3x0.50 x 14 | https://www.amazon.com/dp/B0D1XJ766V | Part of a bolt assortment
2 | Hex socket head cap screw M3x0.50 x 10 | https://www.amazon.com/dp/B0D1XJ766V | Part of a bolt assortment
10 | Hex socket head cap screw M2.5x0.45 x 8 | https://www.amazon.com/dp/B0C7ZRTH3Q | Part of a bolt assortment
16 | Hex socket head cap screw M2.5x0.45 x 6 | https://www.amazon.com/dp/B0C7ZRTH3Q | Part of a bolt assortment
8 | Hex socket head cap screw M2.5x0.45 x 5 | https://www.amazon.com/dp/B0C7ZRTH3Q | Part of a bolt assortment
8 | Hex socket head cap screw M2.5x0.45 x 25 | https://www.amazon.com/dp/B0C7ZRTH3Q | Part of a bolt assortment
4 | Hex socket head cap screw M2.5x0.45 x 16 | https://www.amazon.com/dp/B0D1XJ766V | Part of a bolt assortment
2 | Hex socket head cap screw M2.5x0.45 x 14 | https://www.amazon.com/dp/B0C7ZRTH3Q | Part of a bolt assortment
4 | Hex socket head cap screw M2.5x0.45 x 12 | https://www.amazon.com/dp/B0C7ZRTH3Q | Part of a bolt assortment
1 | Gripper Hand Base Top | Custom | 3D Printed using Elegoo PETG
1 | Gripper Hand Base Plate | Custom | 3D Printed using Elegoo PETG
2 | Gripper Base Side Wall | Custom | 3D Printed using Elegoo PETG
1 | Gripper Base Front | Custom | 3D Printed using Elegoo PETG
1 | Gear Spacer | Custom | 3D Printed using Elegoo PETG
4 | Front Finger Plate | Custom | 3D Printed using Elegoo PETG
2 | Front Finger Pad | Custom | 3D Printed using Elegoo PETG
4 | Finger Center Plate | Custom | 3D Printed using Elegoo PETG
2 | Finger Center Pad Top | Custom | 3D Printed using Elegoo PETG
2 | Finger Center Pad Bottom | Custom | 3D Printed using Elegoo PETG
1 | Coiler Top | Custom | 3D Printed using Elegoo PETG
1 | Coiler Bottom | Custom | 3D Printed using Elegoo PETG
1 | Center Wrist Mount | Custom | 3D Printed using Elegoo PETG
1 | Camera Mount | Custom | 3D Printed using Elegoo PETG
1 | Base Top Plate | Custom | Made of 6061 aluminum machined with a CNC mill
1 | Base Structure Plate | Custom | Made of 6061 aluminum machined with a CNC mill
1 | Base Plate | Custom | Made of 6061 aluminum machined with a CNC mill
2 | Base Handles | Custom | 3D Printed using Elegoo PETG
1 | Arm Shoulder Piece | Custom | 3D Printed using Elegoo PLA
1 | Arm Elbow Piece | Custom | 3D Printed using Elegoo PLA
1 | Arm Base Plate | Custom | Made of 6061 aluminum machined with a CNC mill
16 | 5*16*5mm Bearing | https://www.amazon.com/dp/B0CJFRSK7D
8 | 5*11*5mm Bearing | https://www.amazon.com/dp/B07FW26QBV
4 | 3x12x4mm Groove Pulley | https://www.amazon.com/dp/B0D4LVJMPZ
8 | 3*8*4 MM Bearing | https://www.amazon.com/693ZZ-Double-Shielded-Groove-Bearings/dp/B0DY12SPC4
4 | 180 degree 35mm Length 1.2mm Wire Diameter Torsion Spring | https://www.amazon.com/dp/B0F9PLNYYF | Part of a spring assortment

Quantity of Part | Name | Source | Note(s) 1 | Silicone Non Slip Padding | https://www.amazon.com/dp/B0FFH43VVY 1 | Steel Cable | https://www.amazon.com/dp/B0DGTBH3JT 1 | DYNAMIXEL Starter Set | https://robotis.us/products/dynamixel-starter-set-us 1 | 22 Guage 3P Wire | https://www.amazon.com/BNTECHGO-Silicone-Ribbon-Flexible-Strand/dp/B087RCBF53 5 | JST EHR-3 | https://www.digikey.com/en/products/detail/jst-sales-america-inc/EHR-3/527225 6 | SEH-001T-P0.6 | https://www.digikey.com/en/products/detail/jst-sales-america-inc/SEH-001T-P0-6/26213194
