balu-lab/cabs-PETFAB-Hammer-Joshua/CAD/Main ASM.step

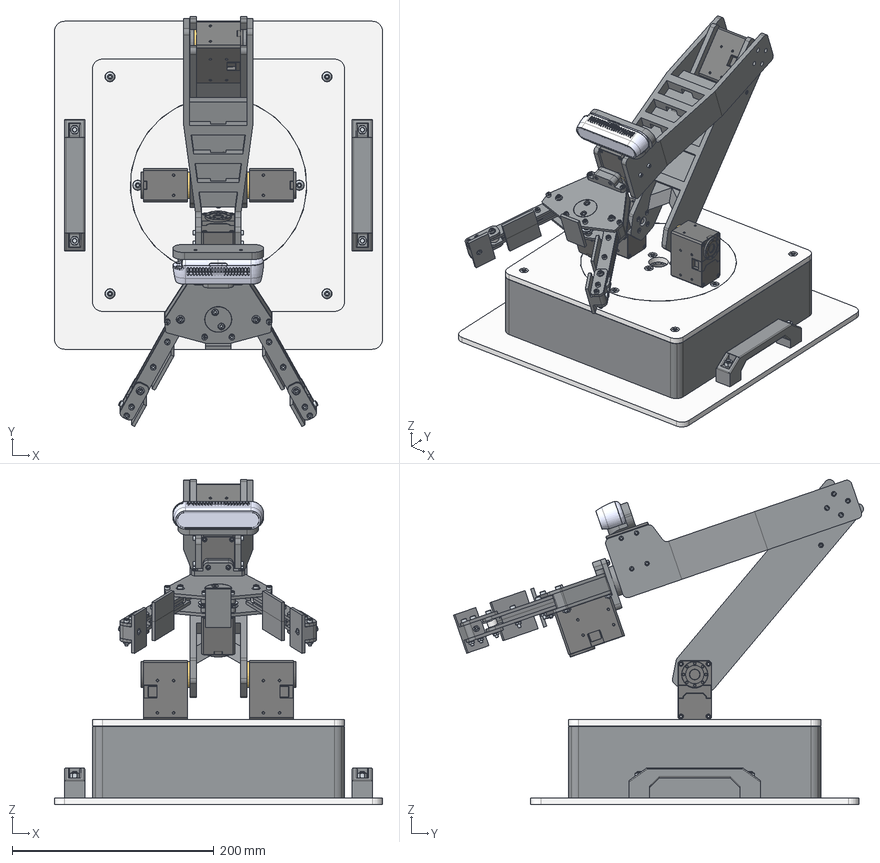
[picture p196: CAD file, 2026-10-29]
CAD/Main ASM.step
325.0 x 406.2 x 322.0 mm
Camera Mount
RealSense D435i Camera
Hex socket head cap screw M2.5x0.45 x 8 x 10
Hex socket head cap screw M2.5x0.45 x 6 x 16
Arm Elbow Piece
DC12_A01_SPACER_RING_1 x 40
WBH_M2_5X17_3 x 48
DC13_X540_DUMMY x 6
DC13_A01_CVR_CABLE_1 x 6
Hex nut grade A & B M5x0.8 x 27
5*16*5mm Bearing x 16
5*11*5mm Bearing x 8
V3 Base Structure Plate
M5*10*15mm Aluminum Spacer x 4
V3 Arm Base Plate
Socket button head screw M5x0.8 x 14 x 11
V3 Base Top Plate
M5*10mm*40mm Aluminum Spacer x 8
Hex socket head cap screw M5x0.80 x 30 x 8
Spur 3.25M 12T
Hex socket head cap screw M2.5x0.45 x 25 x 8
V3 Base Plate
M5*8*25mm Aluminum Spacer Threaded x 4
Hex socket head cap screw M2.5x0.45 x 12 x 4
Socket button head screw M5x0.8 x 30 x 8
Socket button head screw M5x0.8 x 60 x 8
Modular Base Wall x 4
Gear Spacer
Spur 3.25M 36T
Wire Holder
Base Handles x 2
Hex socket head cap screw M2.5x0.45 x 14 x 2
Hex socket head cap screw M3x0.50 x 25 x 20
Clevis pin plain washer M3 x 22
Center Wrist Mount
Hex thin nut grade A & B M3 x 24
Hex thin nut grade A & B M2.5 x 2
Top Wrist Mount
Front Finger Plate x 4
V5 Finger Center Plate x 4
V5 Finger Center Pad Top-Mirrored
Front Finger Pad x 2
3*8*4 MM Bearing x 8
V5 Finger Center Pad Bottom-Mirrored
Spring Spacer x 4
180 degree 35mm Length 1.2mm Wire Diameter Torsion Spring-Mirrored x 2
Chamfered plain washer normal M3 x 4
Hex socket head cap screw M3x0.50 x 20 x 6
180 degree 35mm Length 1.2mm Wire Diameter Torsion Spring x 2
V5 Finger Center Pad Bottom
V5 Finger Center Pad Top
Hex socket head cap screw M2.5x0.45 x 16 x 4
Pulley Spacer x 4
V5 Gripper Hand Base Plate
3x12x4mm Groove Pulley x 4
Gripper Base Side Wall x 2
Hex socket head cap screw M3x0.50 x 10 x 2
Gripper Base Front
V5 Gripper Hand Base Top
Hex socket head cap screw M3x0.50 x 14 x 2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
