balu-lab/cabs-PETFAB-Hammer-Joshua/(list of files, cad)

Other CAD files:
CAD/Main ASM.stl
