balu-lab/cabs-PETFAB-Hammer-Joshua/3D Printing Files/README.md

# 3D Printing Files

STL/STEP files for the printed links, plates, and gripper parts will be added here.
