balu-lab/cabs-PETFAB-Hammer-Joshua/PETFAB-Armadillo/Assembly Instructions/All Assembly Instructions.pptx

Arm Base Plate Assembly Instructions

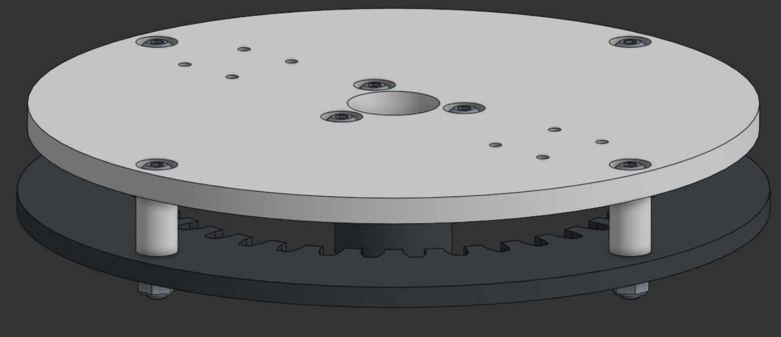
[picture p333: figure]
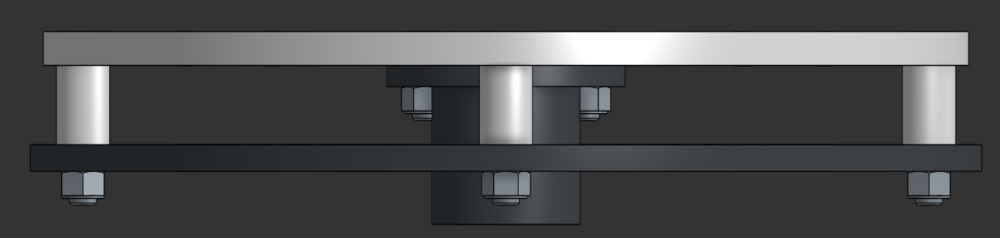
[picture p334: figure]

## Slide 2

Parts

Major Components:
Arm Base Plate
Wire Holder
36T Ring Gear
4x M5x10x20mm Spacer

Minor Components:
4x M5x30mm Button Head Bolt
3x M5x14mm Button Head Bolt
7x M5 Nylock Nuts

## Slide 3

Major Components

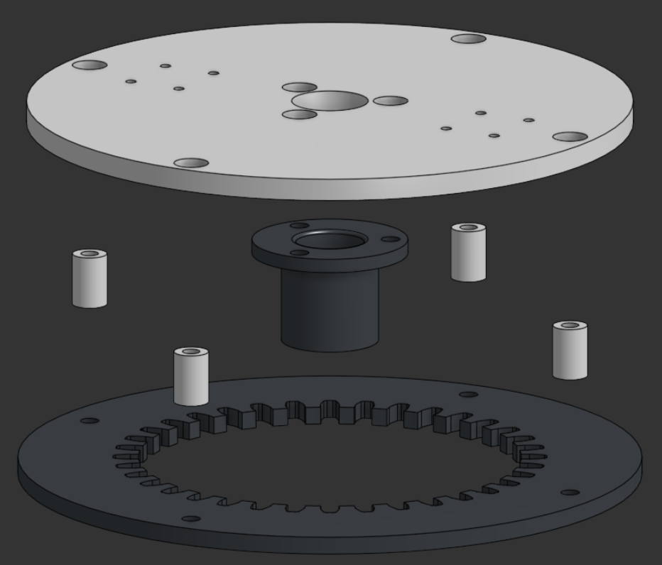
[picture p335: figure]

Arm Base Plate

Wire Holder

14mm Spacers

36 Tooth Ring Gear

## Slide 4

Step 1

Bolt the Wire Holder through the center of the Arm Base Plate

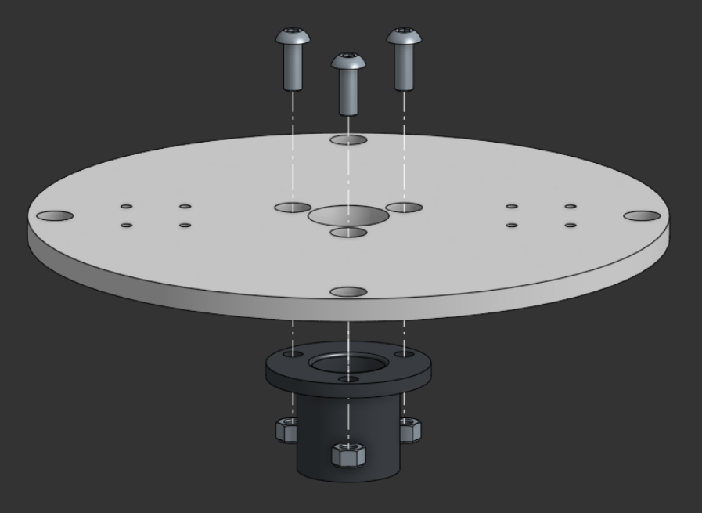
[picture p336: figure]

Parts
-Arm Base Plate
-Wire Holder
-3x M5x14mm Button Head Bolts

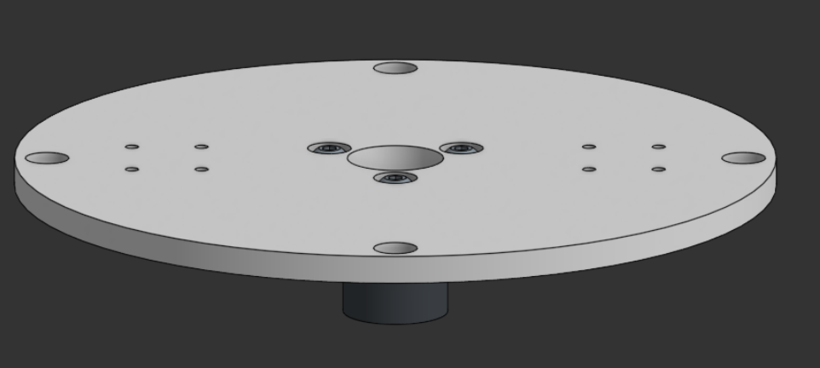
[picture p337: figure]

-3x M5 Nylock Nuts

## Slide 5

Step 2

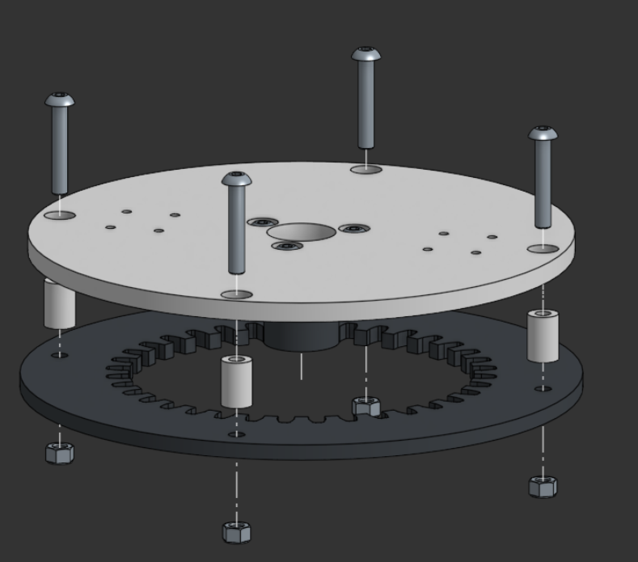
[picture p338: figure]

Parts
-Previous step
-4x M5x10x20mm Spacer
-4x M5x30mm Button Head Bolts

Bolt the Arm Base Plate to the 36T Ring Gear with 20mm spacers in between

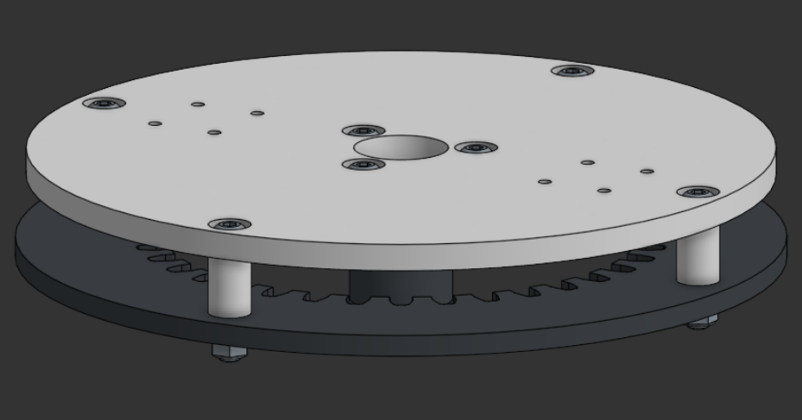
[picture p339: figure]

-4x M5 Nylock Nuts
-36T Ring Gear

## Slide 6

Arm Base Assembly Instructions

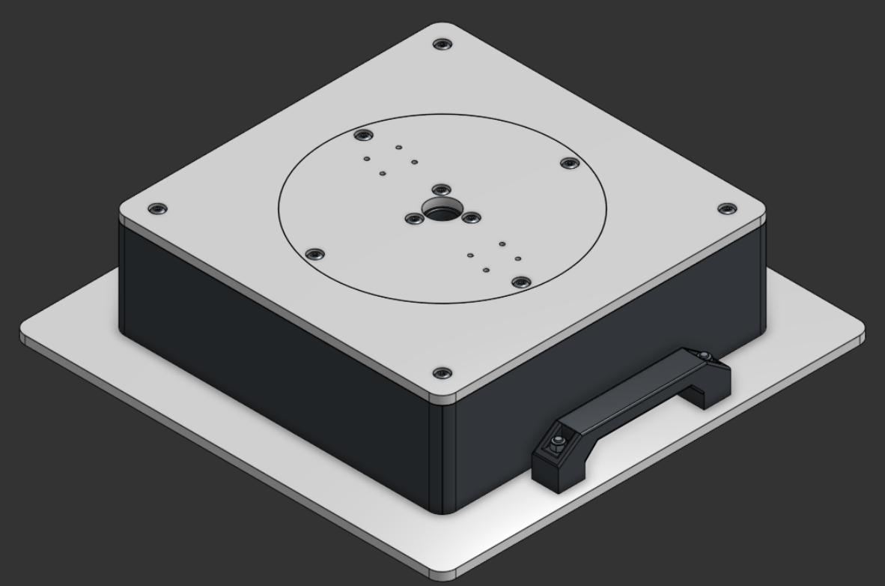
[picture p340: figure]

## Slide 7

Parts

Major Components:
Arm Base Plate Assembly
Base Plate
Structure Plate
Base Top Plate
4x Base Wall
2x Base Handle
12T Ring Gear
Robotis XM540-W270-T Actuator

## Slide 8

Parts Continued

Minor Components:
20x Nylock Nut
8x M5x14mm Button Head Bolt
4x M5x30mm Button Head Bolt
8x M5x30mm Socket Head Bolt
8x M5x60mm Button Head Bolt
4x M2.5x12mm Socket Head Bolt
4x M2.5x25mm Socket Head Bolt
8x 5x11x5mm Bearing
16x 5x16x5mm Bearing
4x 5x8x25mm M5 Threaded Spacers

8x 5x10x40mm M5 Threaded Spacers
4x Robotis Spacers

## Slide 9

Major Components

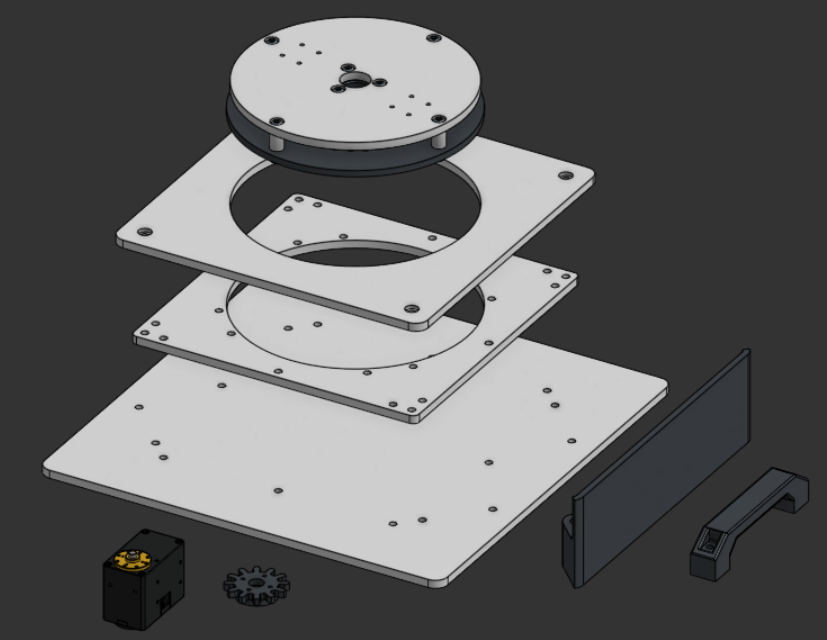
[picture p341: figure]

Base Top Plate

Arm Base Plate
Assembly

Base Structure Plate

Base Wall

Base Plate

Base Handle

Robotis XM540-W270-T Actuator

12T gear + Gear Spacer

## Slide 10

Step 1

Bolt the Base Handle to the edge of the Base Plate

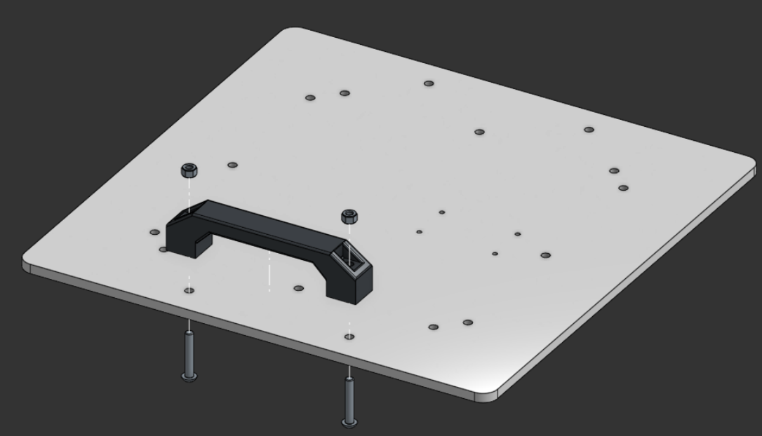
[picture p342: figure]

Parts
-Base Plate
-Base Handle
-2x M5x30mm Button Head Bolt

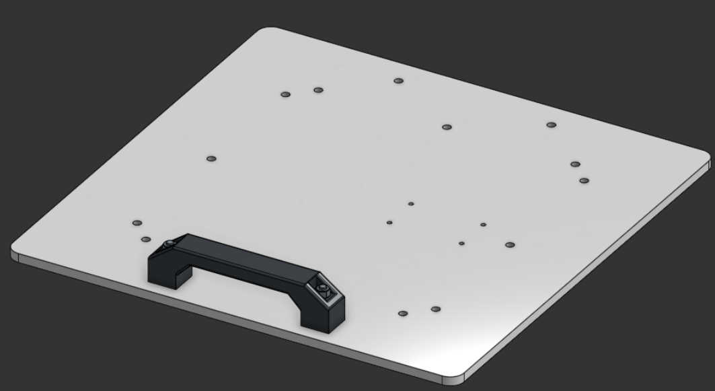
[picture p343: figure]

-2x Nylock Nuts

## Slide 11

Step 2

Repeat for the other side

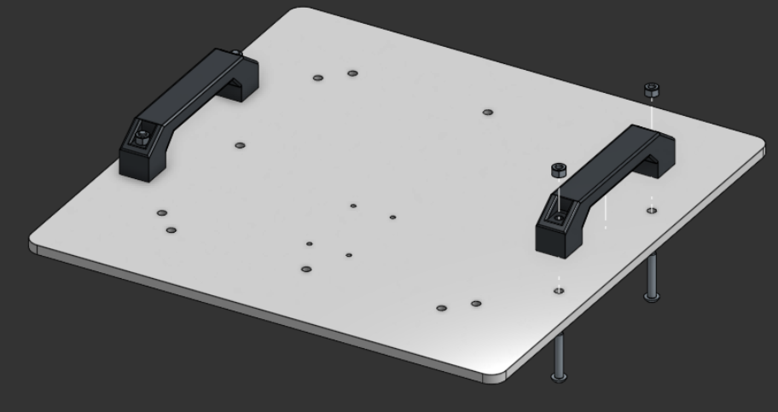
[picture p344: figure]

Parts
-Previous step
-Base Handle
-2x M5x30mm Button Head Bolt

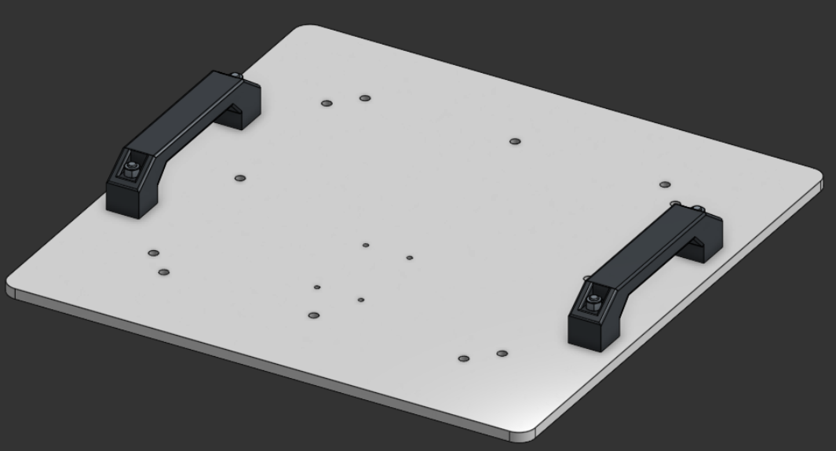
[picture p345: figure]

-2x Nylock Nuts

## Slide 12

Step 3

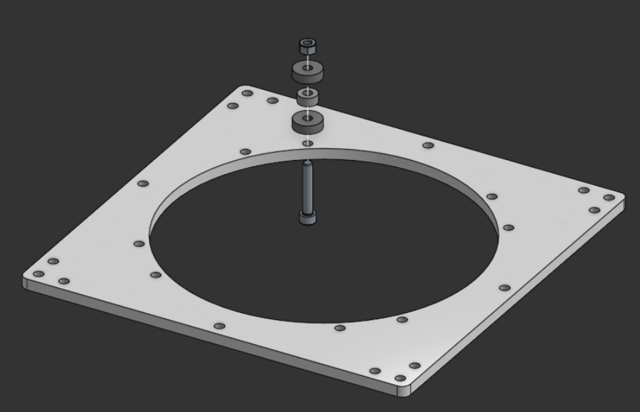
[picture p346: figure]

Parts
-Structure Plate
-2x 5x16x5mm Bearing
-5x11x5mm Bearing

Bolt a bearing stack (in the order of wide, thin, wide) around the center of the structure plate

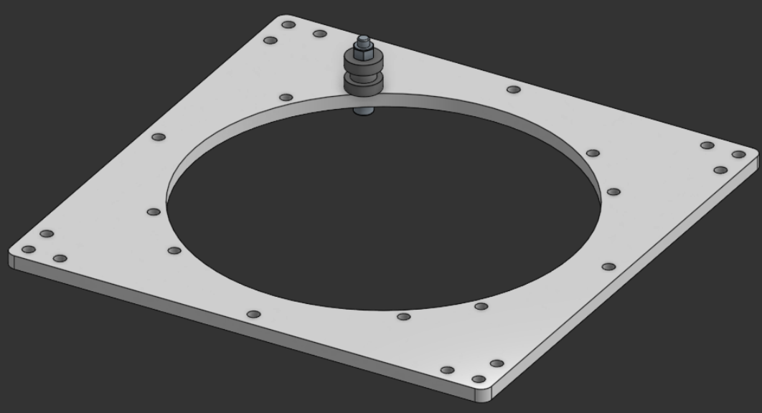
[picture p347: figure]

-M5x30mm Hex Socket Head Bolt
-Nylock Nut

## Slide 13

Step 4

Bolt 3 more bearing stacks around one half of the center of the structure plate

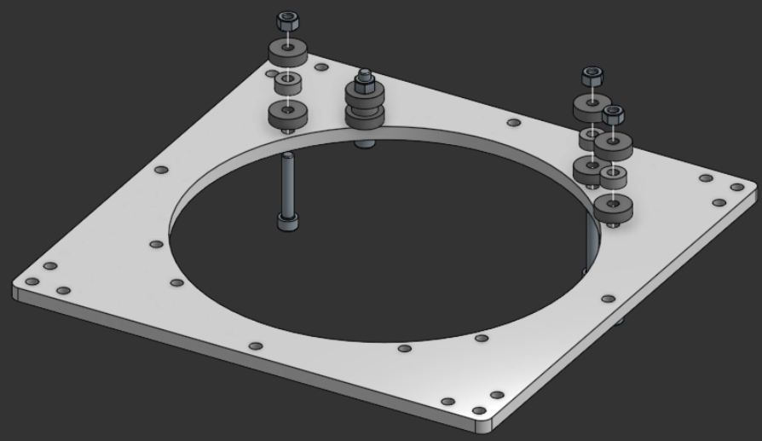
[picture p348: figure]

Parts
-Previous step
-6x 5x16x5mm Bearing
-3x 5x11x5mm Bearing

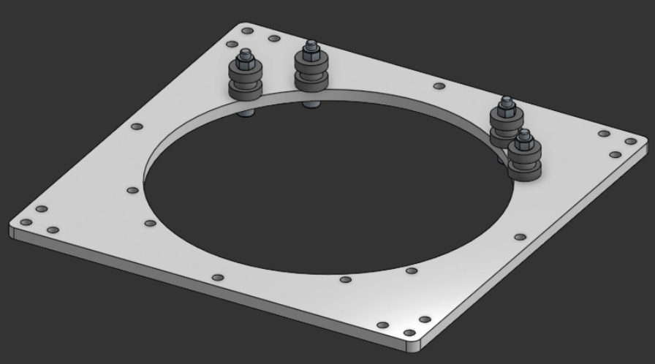
[picture p349: figure]

-3x M5x30mm Hex Socket Head Bolt
-3x Nylock Nut

## Slide 14

Step 5

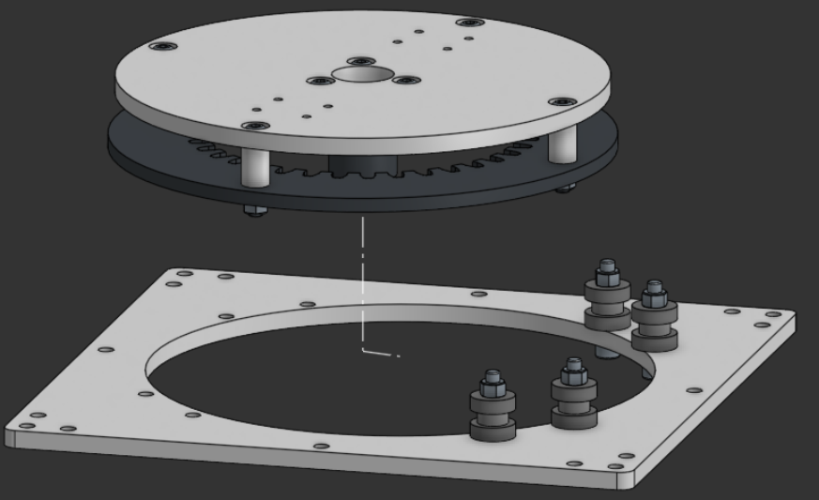
[picture p350: figure]

Insert the Arm Base Assembly between the bearings in the bearing stacks

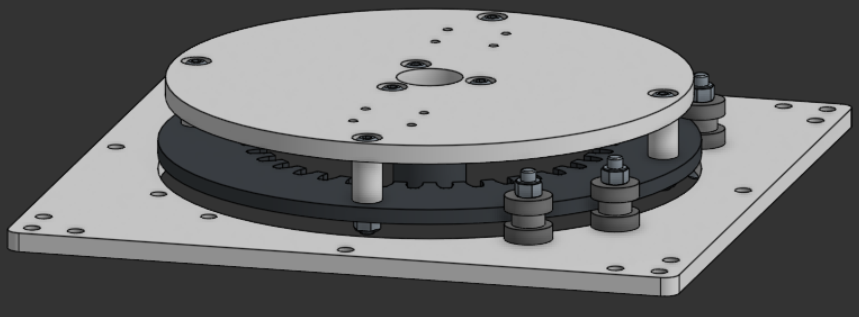
[picture p351: figure]

Parts
-Previous step
-Arm Base Assembly

## Slide 15

Step 6

Bolt four more bearing stacks around the other half of the structure plate

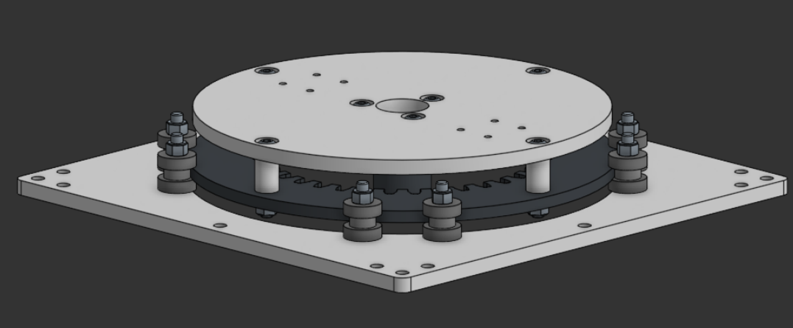
[picture p352: figure]
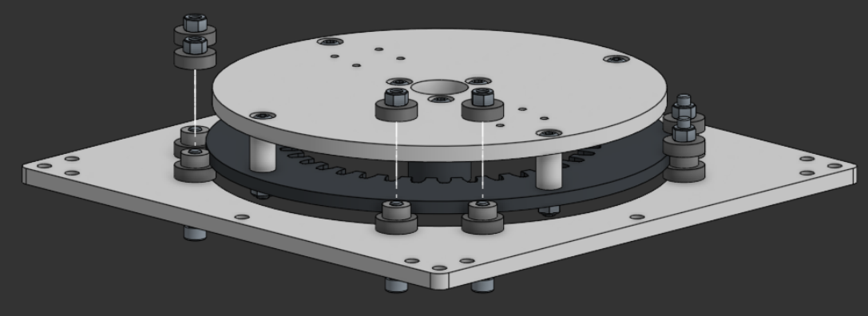
[picture p353: figure]

Parts
-Previous step
-8x 5x16x5mm Bearing
-4x 5x11x5mm Bearing

-4x M5x30mm Hex Socket Head Bolt
-4x Nylock Nut

## Slide 16

Step 7

Bolt a threaded spacer onto one corner of the Structure Plate

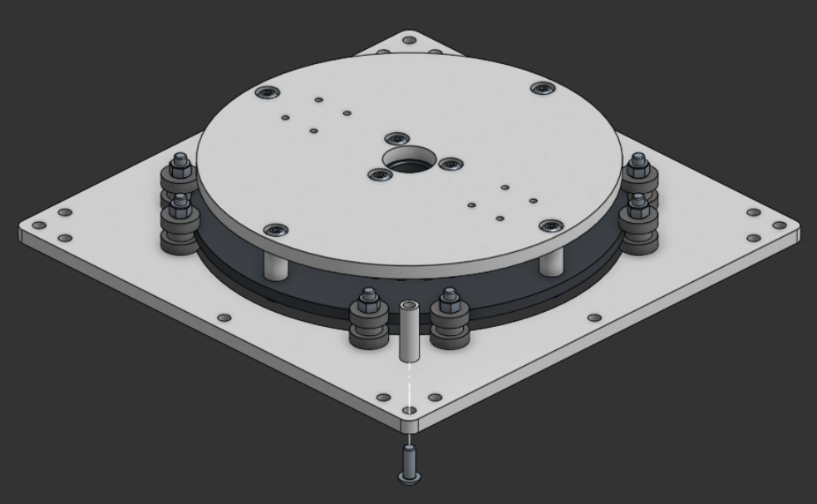
[picture p354: figure]

Parts
-Previous step
-5x8x25mm M5 Threaded Spacers
-M5x14mm Button Head Bolt

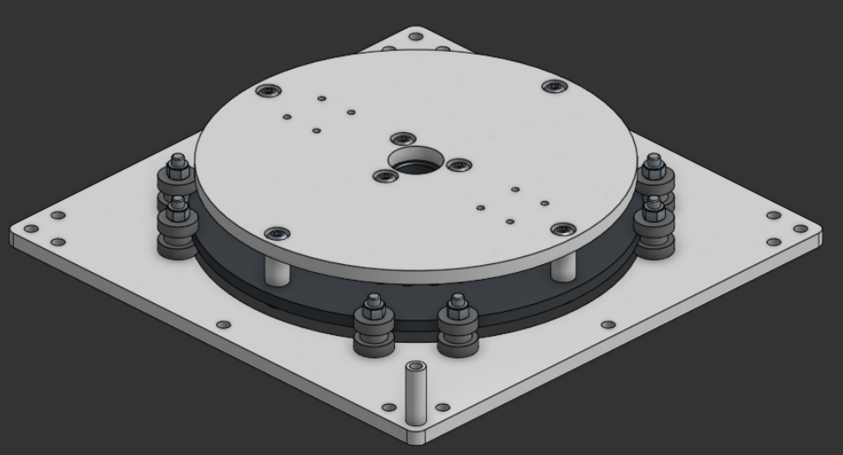
[picture p355: figure]

## Slide 17

Step 8

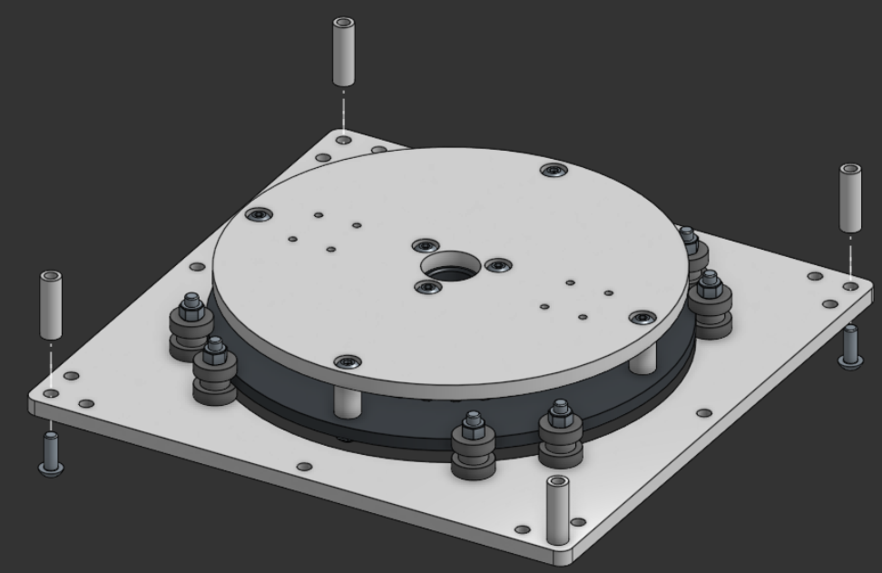
[picture p356: figure]

Parts
-Previous step
-3x 5x8x25mm M5 Threaded Spacers
-3x M5x14mm Button Head Bolt

Bolt threaded spacers on all other corners of the Structure Plate

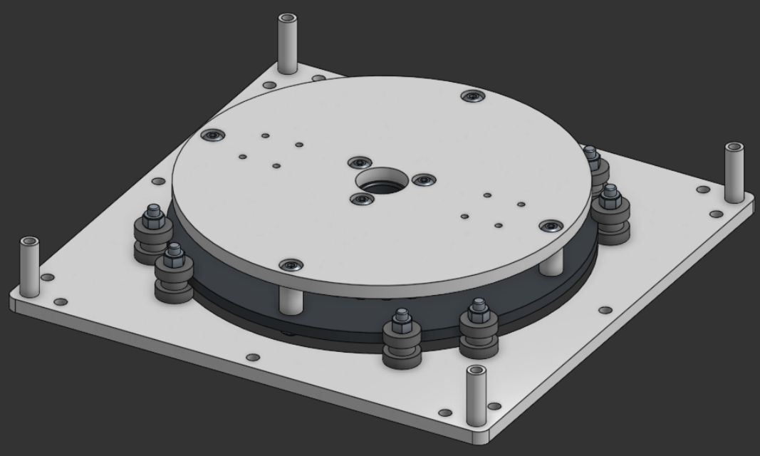
[picture p357: figure]

## Slide 18

Step 9

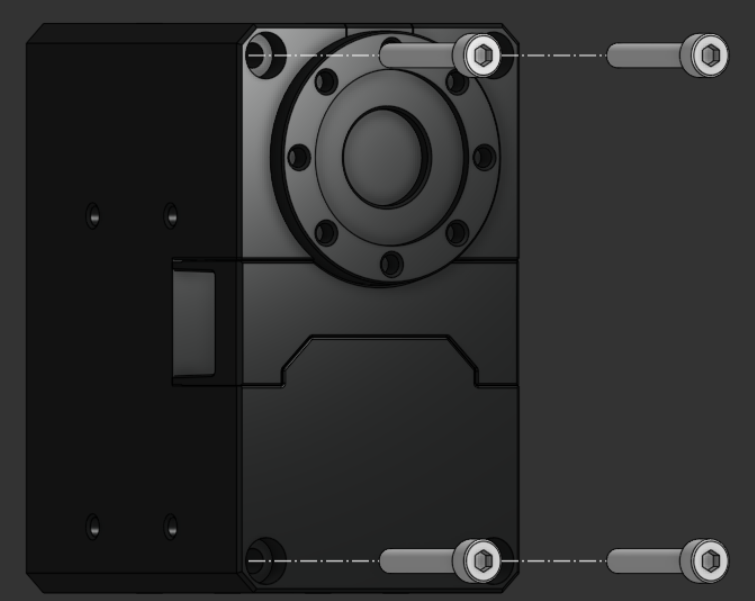
[picture p358: figure]

Parts
-Robotis XM540-W270-T Actuator

Remove the four bolts on the back of the actuator

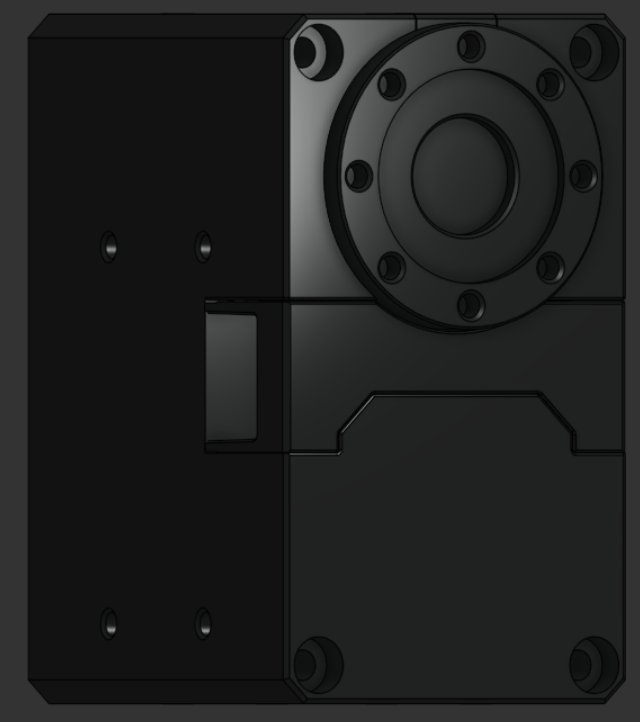
[picture p359: figure]

## Slide 19

Step 10

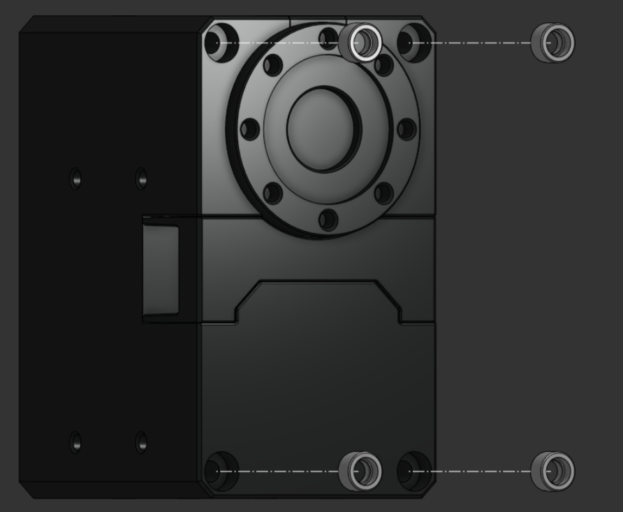
[picture p360: figure]

Parts
-Robotis XM540-W270-T Actuator
-4x Robotis Spacers

Insert four Robotis Spacers into the back of the actuator

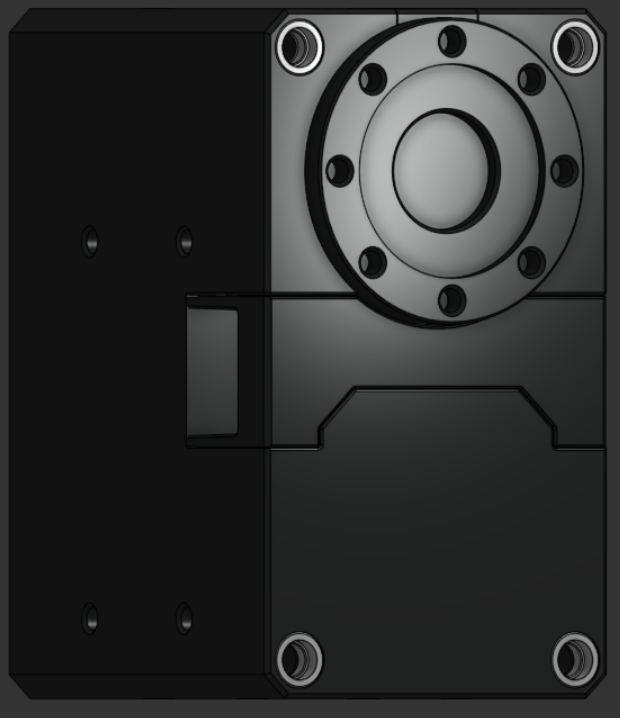
[picture p361: figure]

## Slide 20

Step 11

Bolt the back of the actuator to the Base Plate

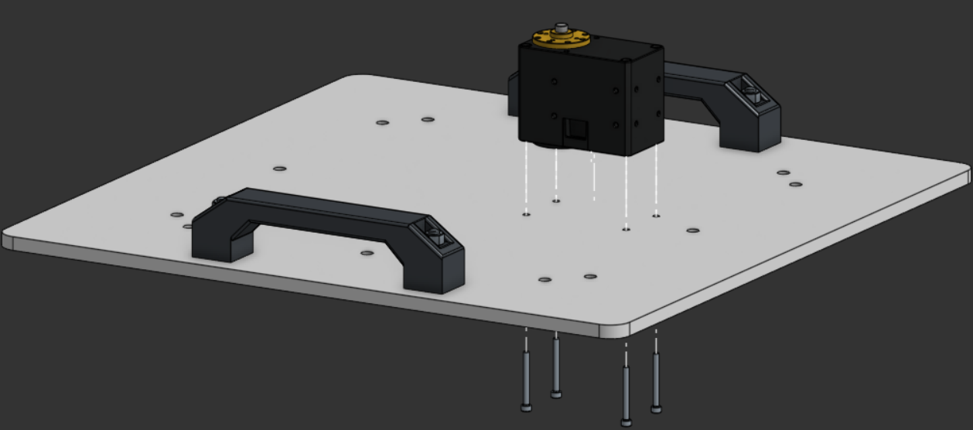
[picture p362: figure]
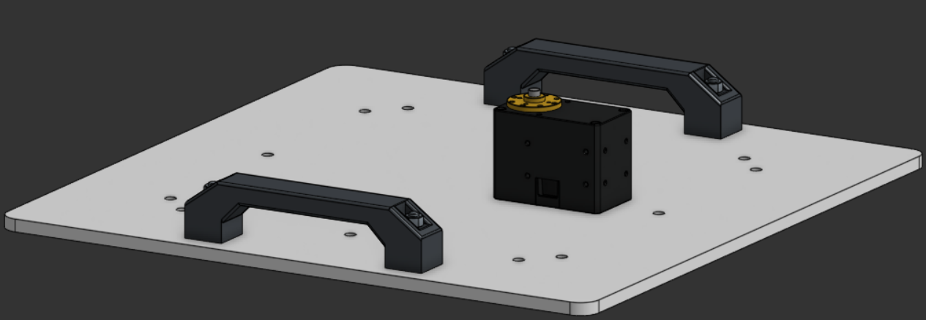
[picture p363: figure]

Parts
-Previous step
-Base Plate (with handles)
-4x M2.5x25mm Socket Head Bolt

## Slide 21

Step 12

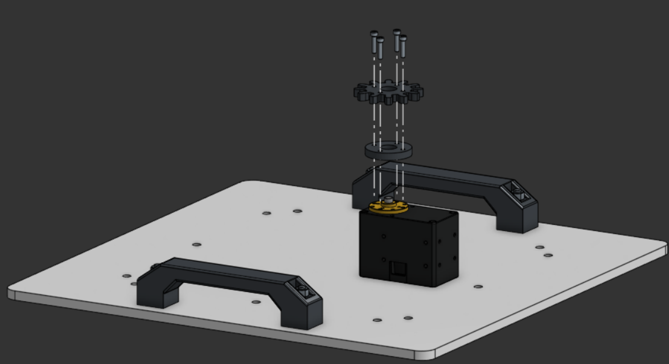
[picture p364: figure]

Bolt the 12T Gear on top of the Gear Spacer to the actuator

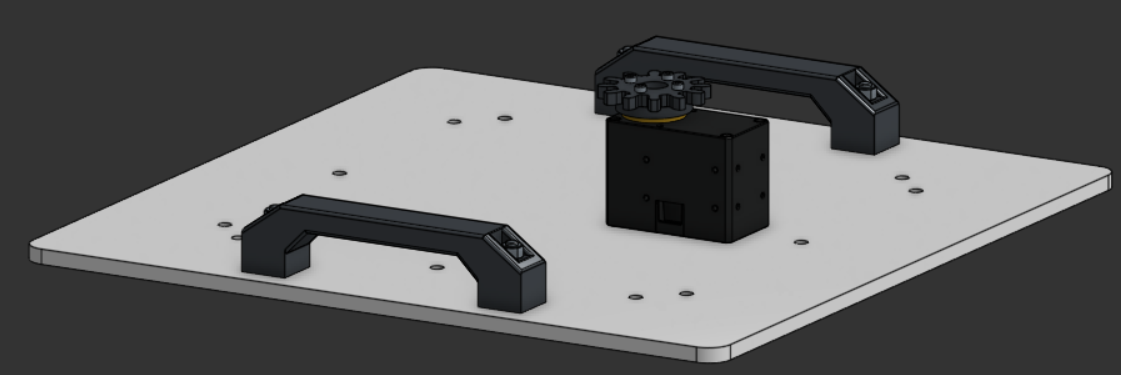
[picture p365: figure]

Parts
-Previous step
-12T Gear
-Gear Spacer

-4x M2.5x12mm Socket Head Bolt

## Slide 22

Step 13

Insert M5x60mm Button Head Bolts through eight corner holes, and place 40mm spacers on top

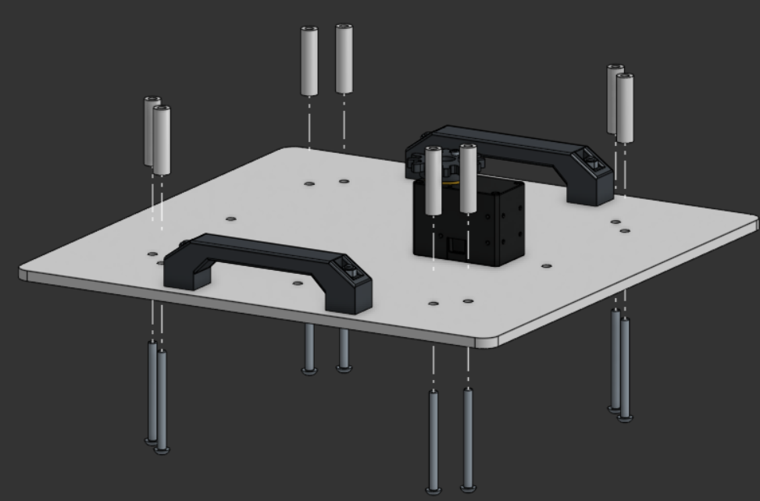
[picture p366: figure]

Parts
-Previous step
-8x M5*60mm Button Head Bolt
-8x 5x10x40mm M5 Threaded Spacers

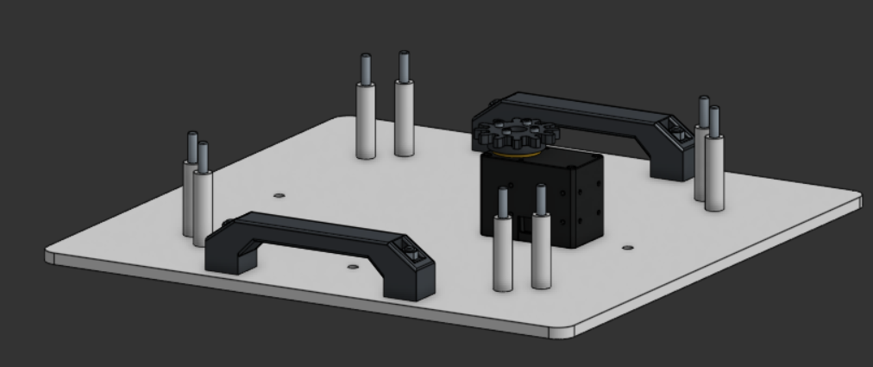
[picture p367: figure]

## Slide 23

Step 14

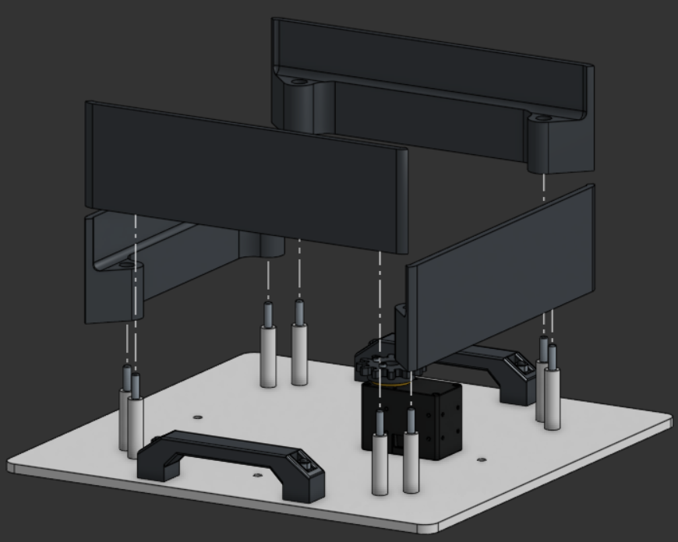
[picture p368: figure]

Parts
-Previous step
-4x Base Wall

Insert Base Walls onto each face of the base

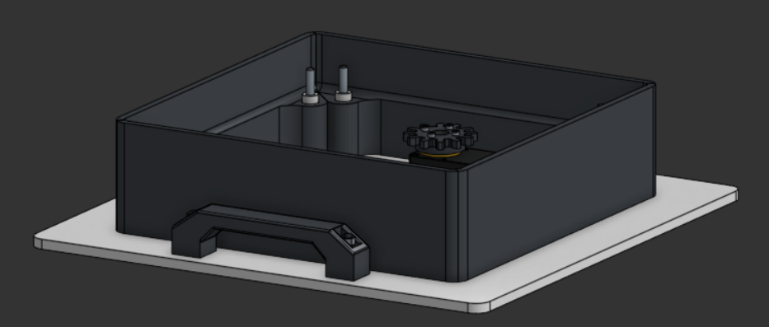
[picture p369: figure]

## Slide 24

Step 15

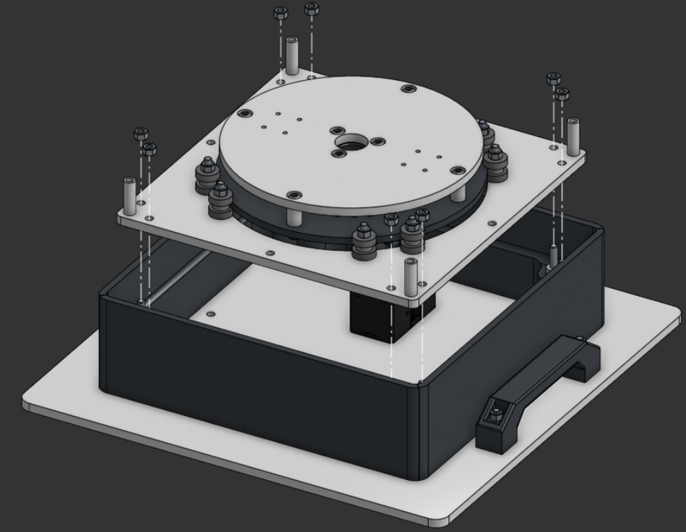
[picture p370: figure]

Parts
-Previous step
-Arm Structure Plate and Arm Base Plate Assembly

Insert the Arm Base Plate Assembly on top of the bolts and attach Nylock nuts

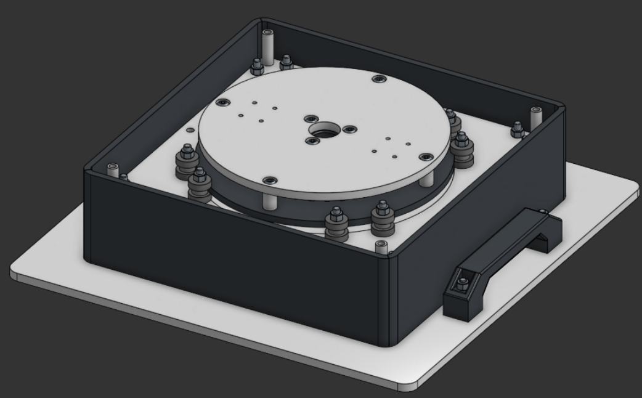
[picture p371: figure]

-8x Nylock Nuts

## Slide 25

Step 16

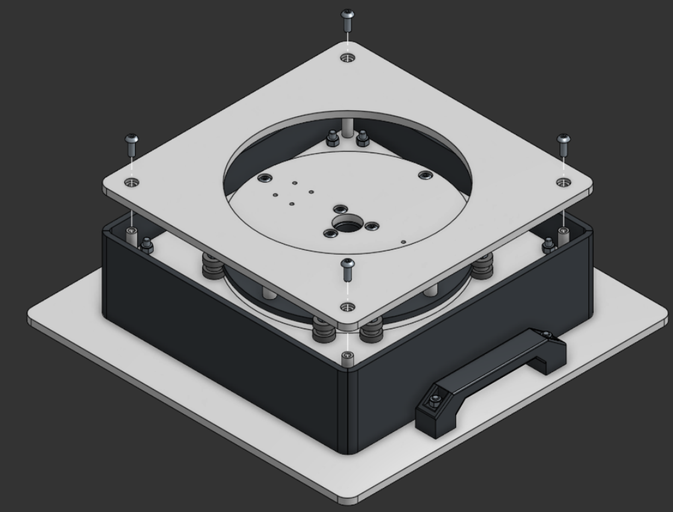
[picture p372: figure]

Parts
-Previous step
-4x M5x14mm Button Head Bolt

Place the Base Top Plate around the Arm Base Plate and bolt each corner

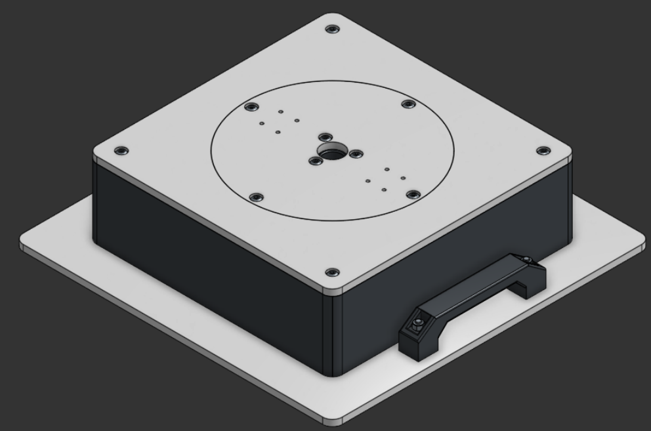
[picture p373: figure]

## Slide 26

Arm Shoulder Assembly Instructions

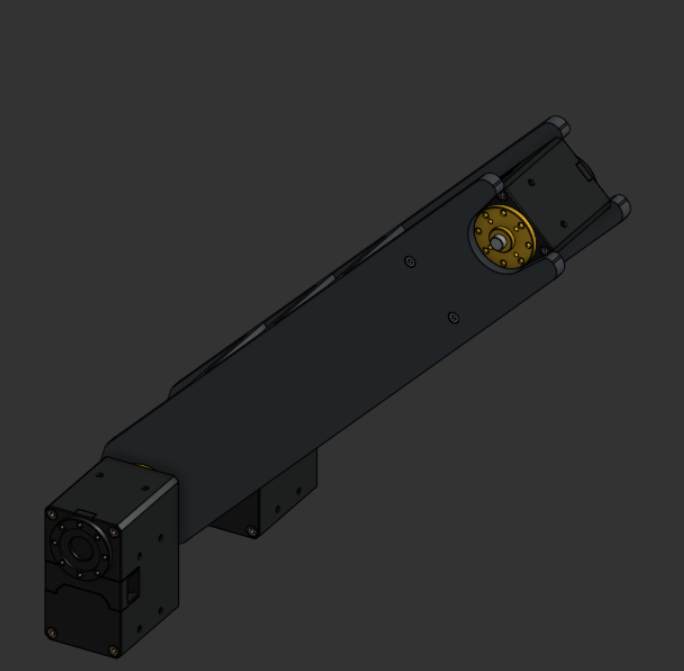
[picture p374: figure]
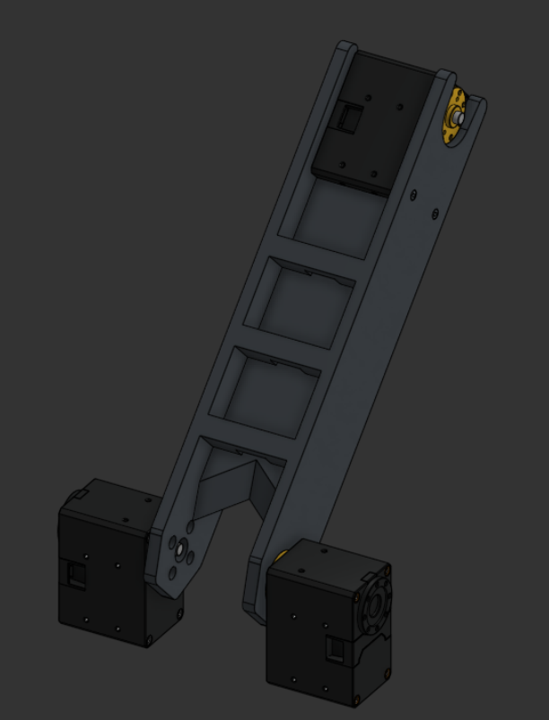
[picture p375: figure]

## Slide 27

Parts

Major Components:
Arm Shoulder Piece
3x Robotis XM540-W270-T Actuator

Minor Components:
8x M2.5x6mm Bolts
4x M2.5x25mm Bolts
4x Robotis Spacers

## Slide 28

Major Components

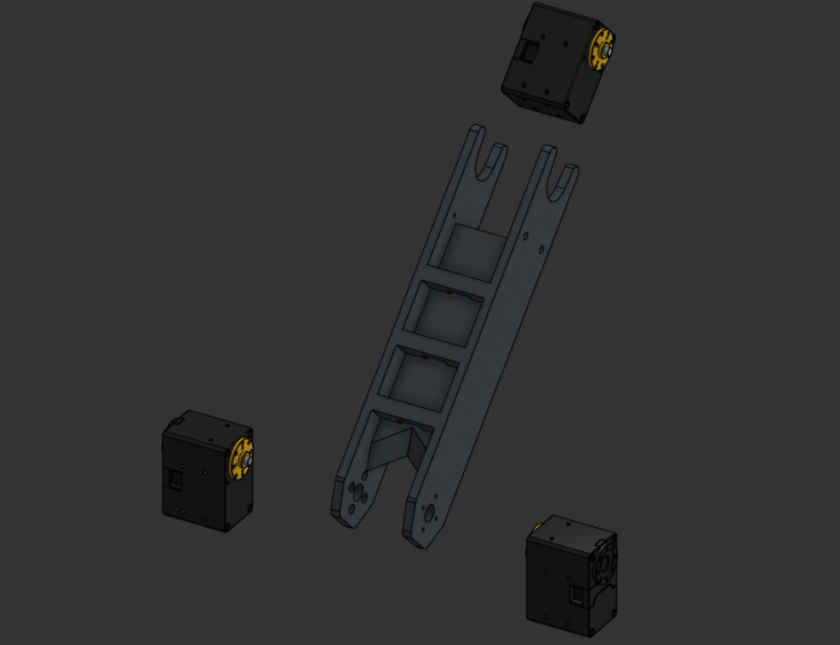
[picture p376: figure]

Arm Shoulder Piece

Robotis XM540-W270-T Motors

## Slide 29

Step 1

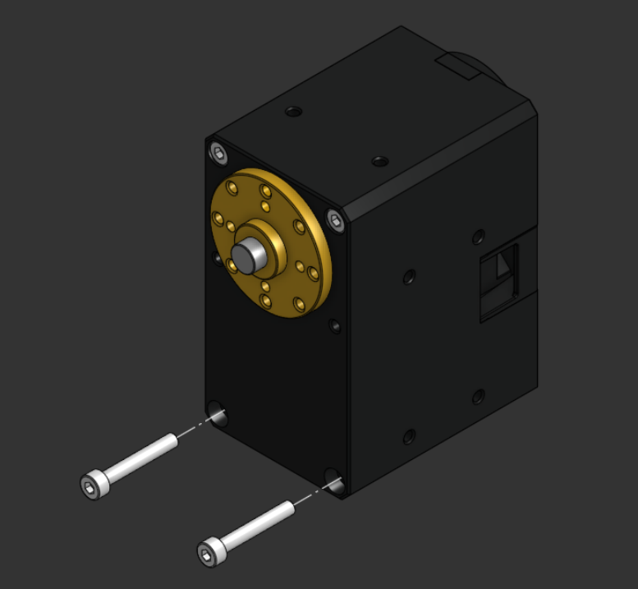
[picture p377: figure]

Parts
-Robotis XM540-W270-T Actuator

Remove the bottom two bolts from both sides of the actuator

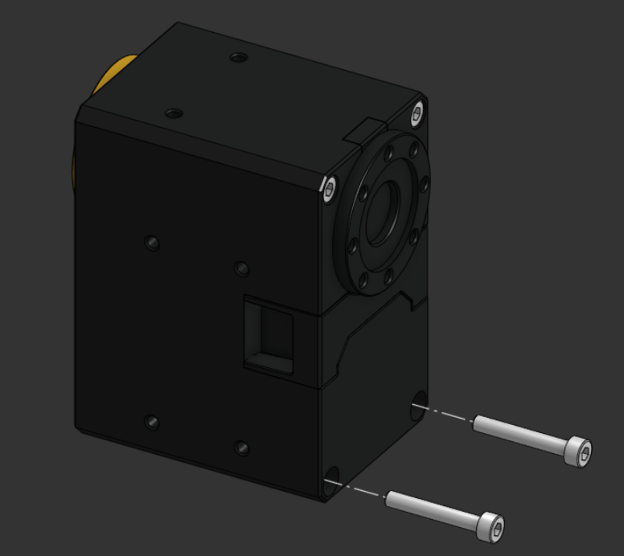
[picture p378: figure]

## Slide 30

Step 2

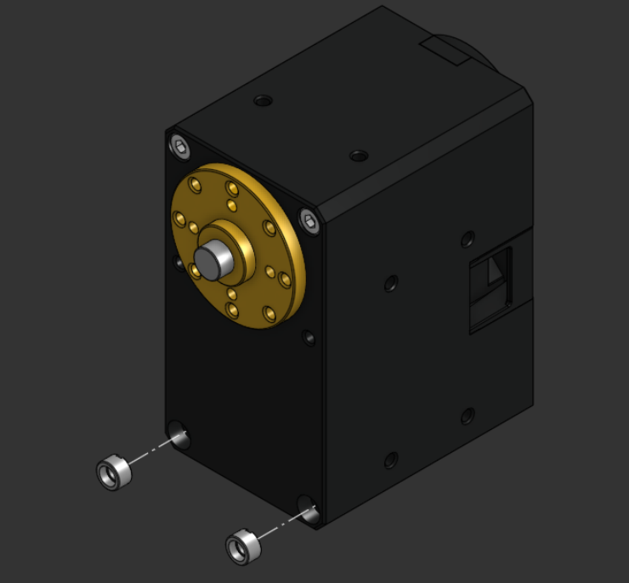
[picture p379: figure]

Parts
-Robotis XM540-W270-T Actuator
-4x Robotis Spacers

Insert spacer rings into the actuator

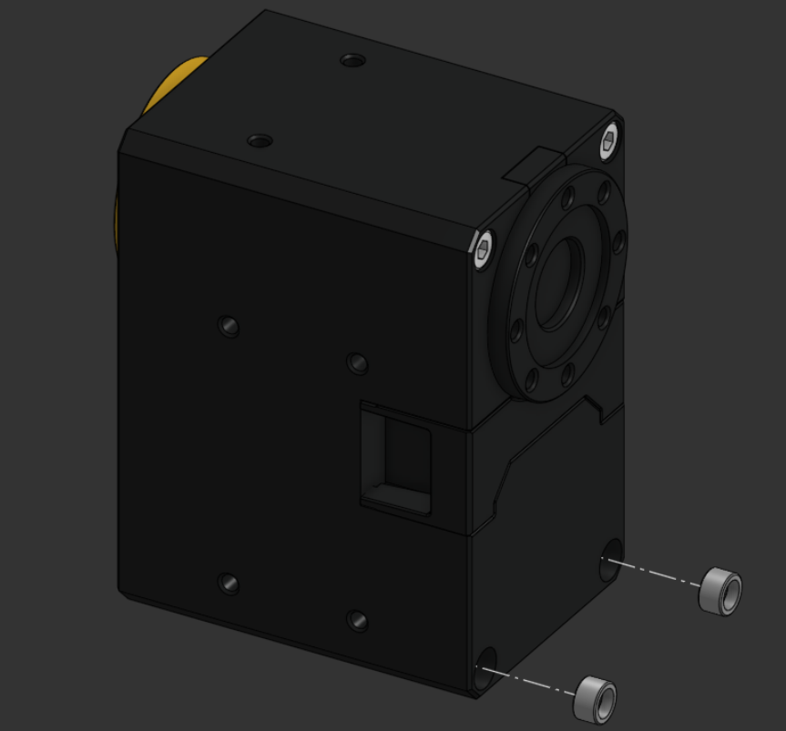
[picture p380: figure]

## Slide 31

Step 3

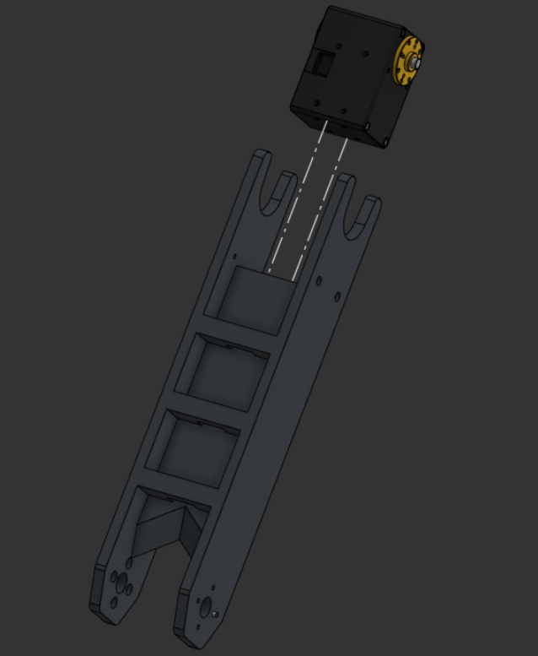
[picture p381: figure]

Parts
-Previous step
-Arm Shoulder Piece

Place the actuator in the top of the shoulder piece

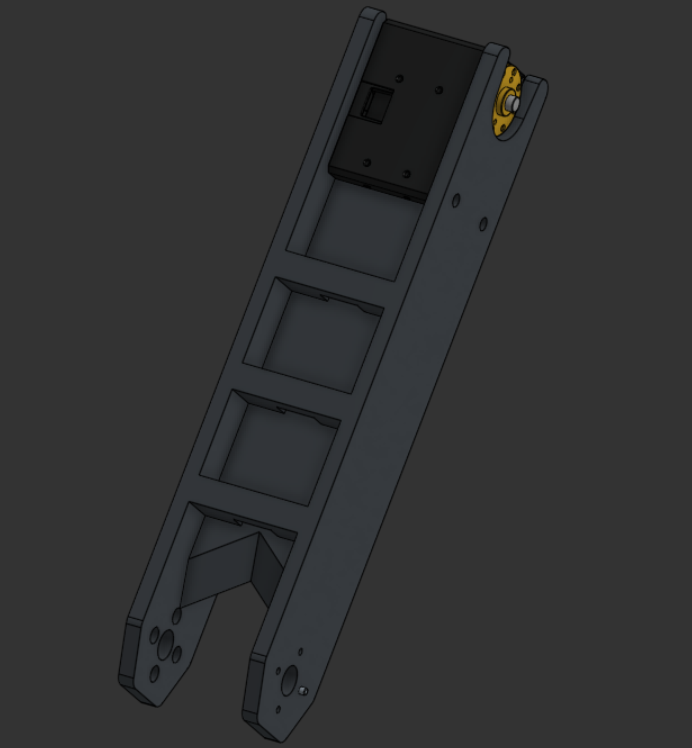
[picture p382: figure]

## Slide 32

Step 4

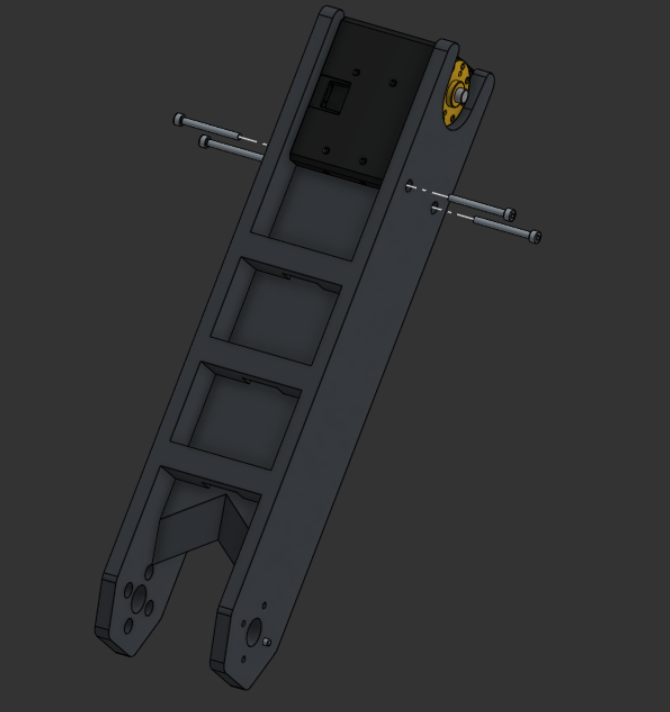
[picture p383: figure]

Parts
-Previous step
-4x M2.5x25mm Socket Head Bolt

Bolt the actuator into the top of the shoulder piece

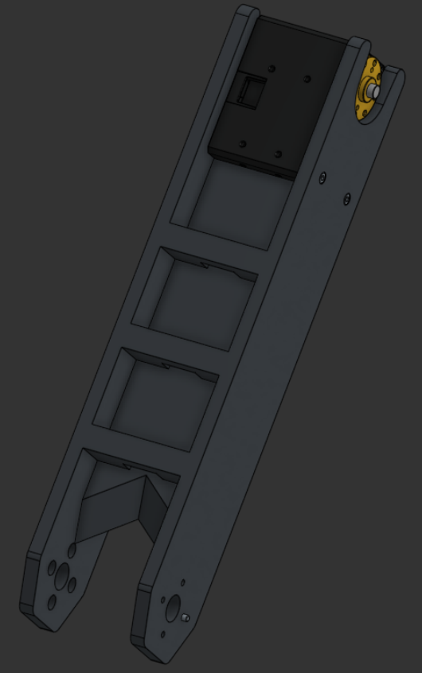
[picture p384: figure]

## Slide 33

Step 5

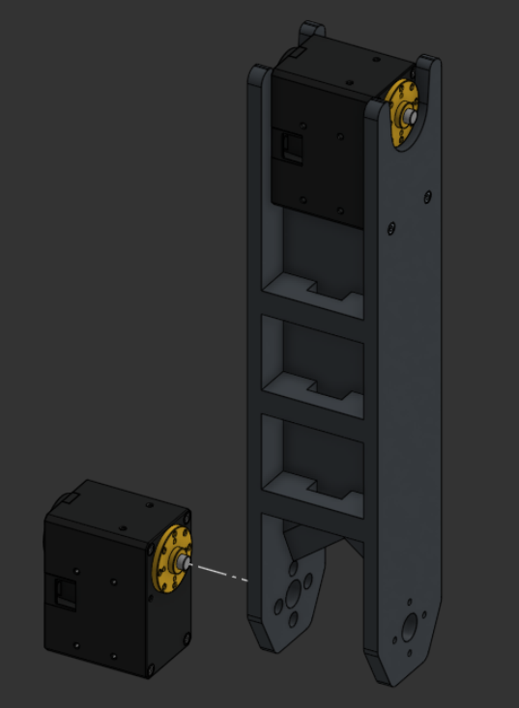
[picture p385: figure]

Parts
-Previous step
-Robotis XM540-W270-T Actuator

Align the actuator with the bottom of the shoulder piece

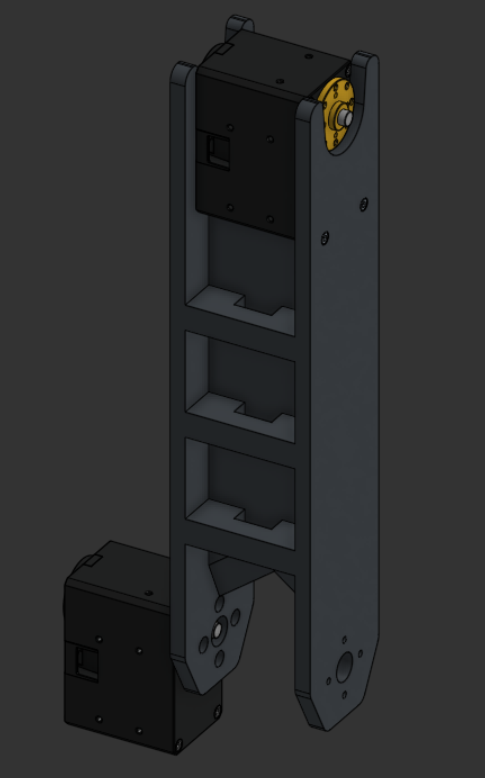
[picture p386: figure]

## Slide 34

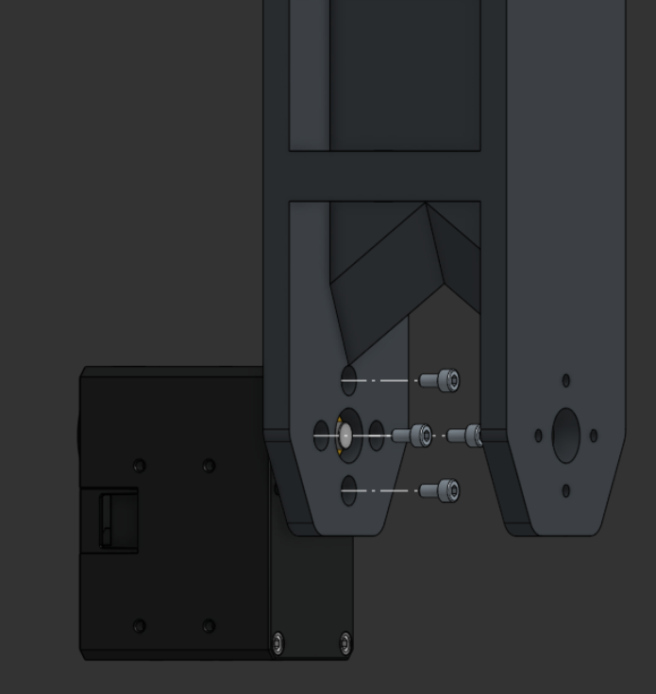
[picture p387: figure]

Step 6

Parts
-Previous step
-4x M2.5x6mm Bolts

Bolt the actuator to the bottom of the shoulder piece

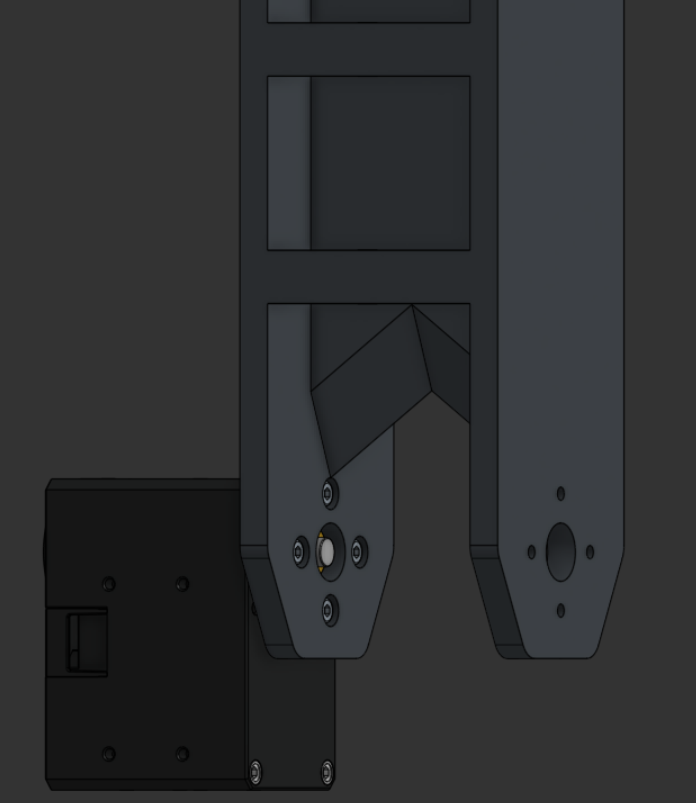
[picture p388: figure]

## Slide 35

Step 7

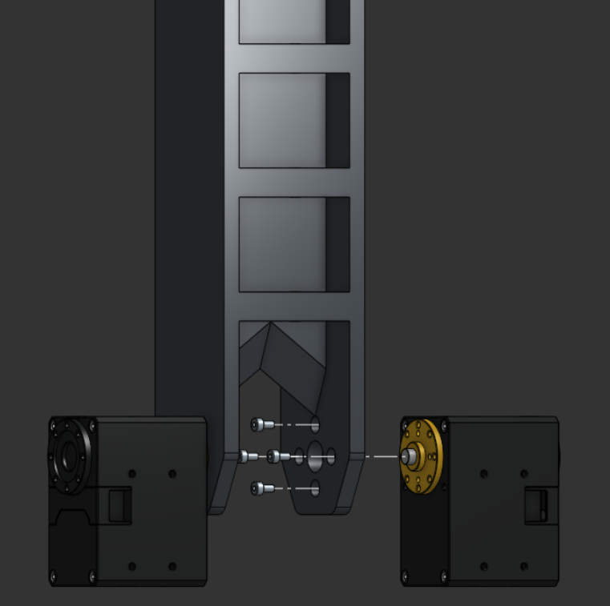
[picture p389: figure]

Parts
-Previous step
-Robotis XM540-W270-T Actuator
-4x M2.5x6mm Bolts

Repeat steps 5-6 for the other actuator

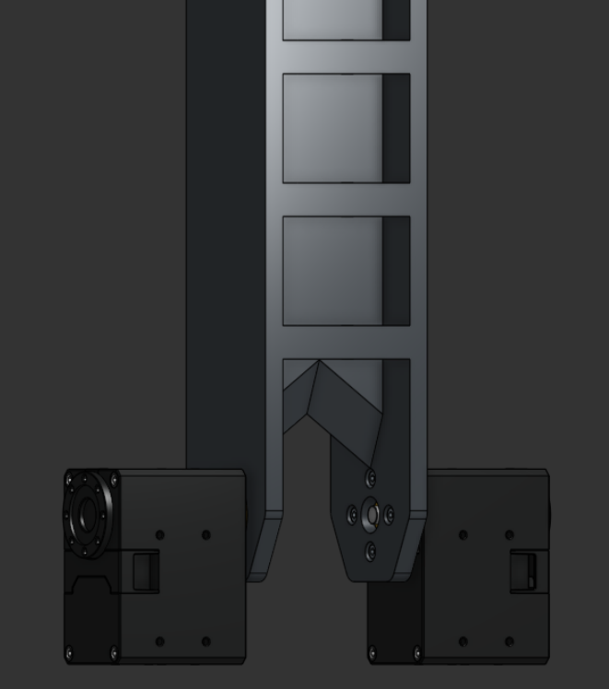
[picture p390: figure]

## Slide 36

Arm Elbow Assembly Instructions

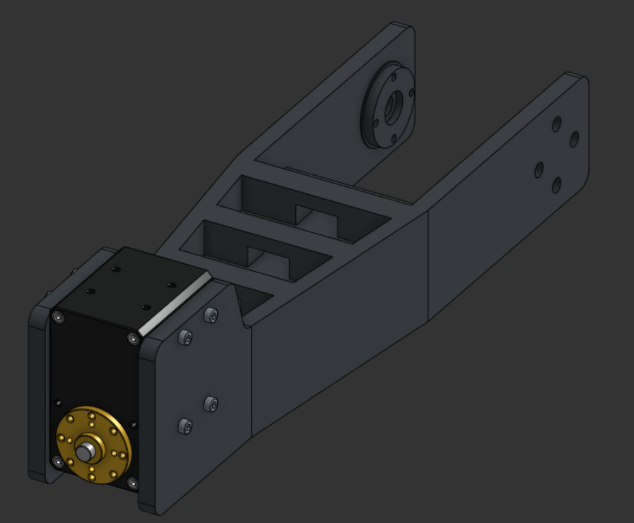
[picture p391: figure]
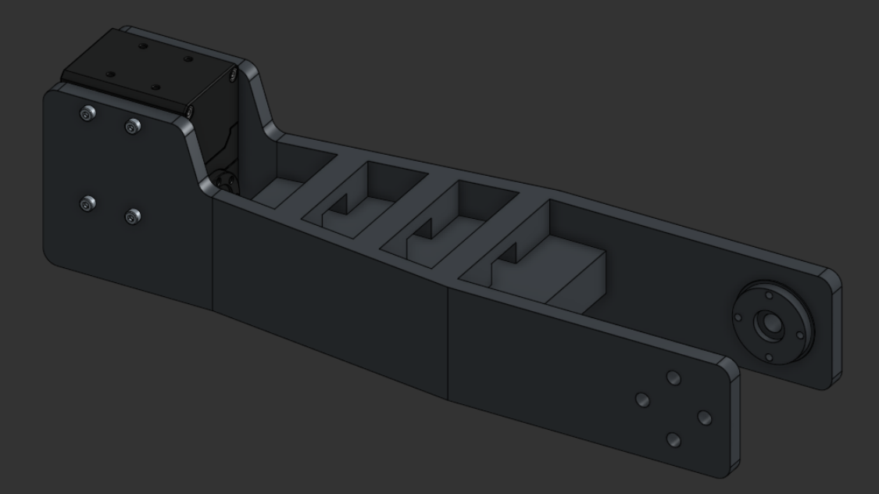
[picture p392: figure]

## Slide 37

Parts

Major Components:
Arm Elbow Piece
1x Robotis XM540-W270-T Actuator

Minor Components:
8x M2.5x8mm Socket Head Bolt

## Slide 38

Major Components

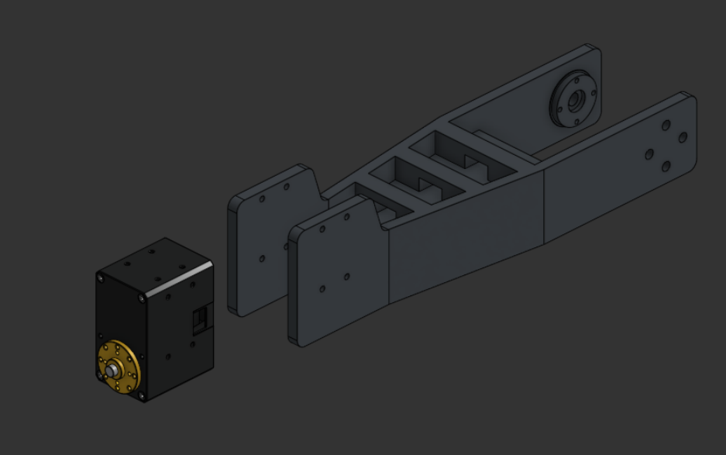
[picture p393: figure]

Robotis XM540-W270-T Actuator

Arm Elbow Piece

## Slide 39

Step 1

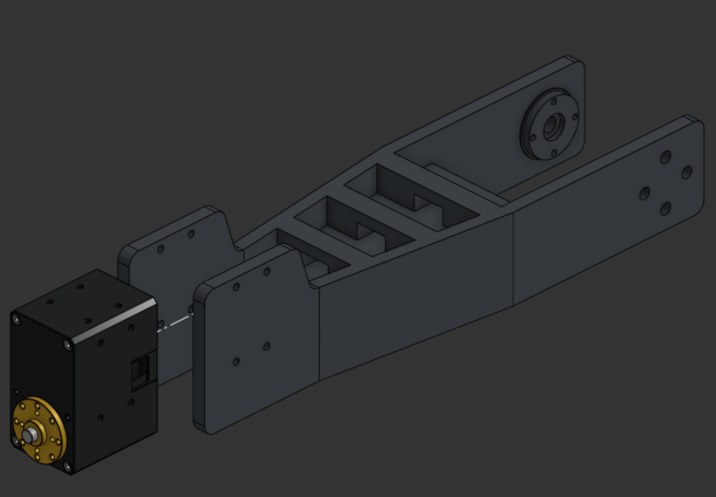
[picture p394: figure]

Parts
-Arm Elbow Piece
-Robotis XM540-W270-T Actuator

Insert the actuator between the ends of the elbow piece

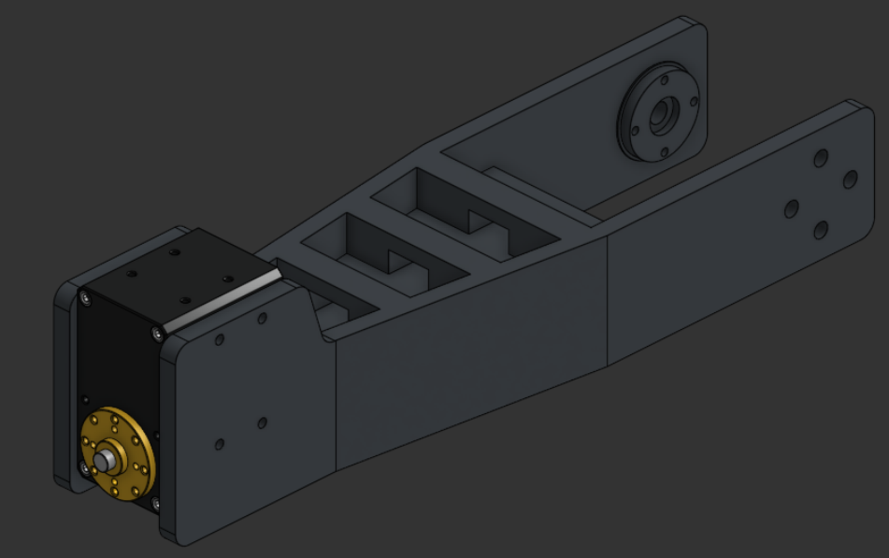
[picture p395: figure]

## Slide 40

Step 2

Bolt the actuator into the ends of the elbow piece

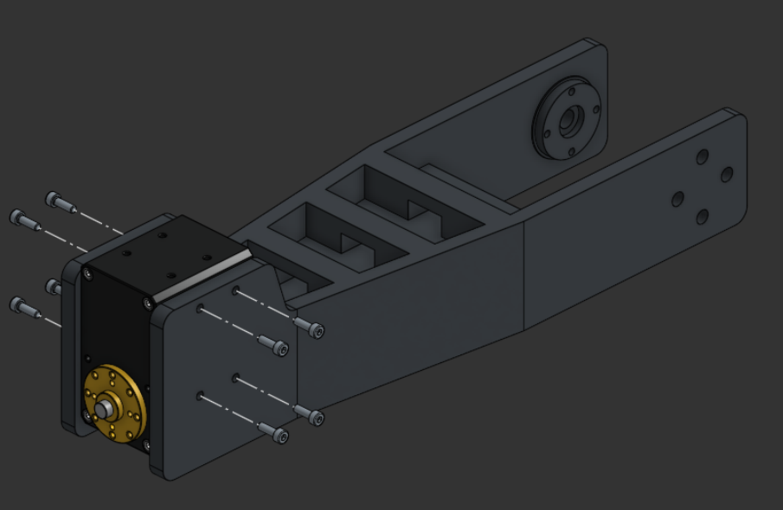
[picture p396: figure]

Parts
-Previous step
-4x M2.5x8mm Socket Head Bolt

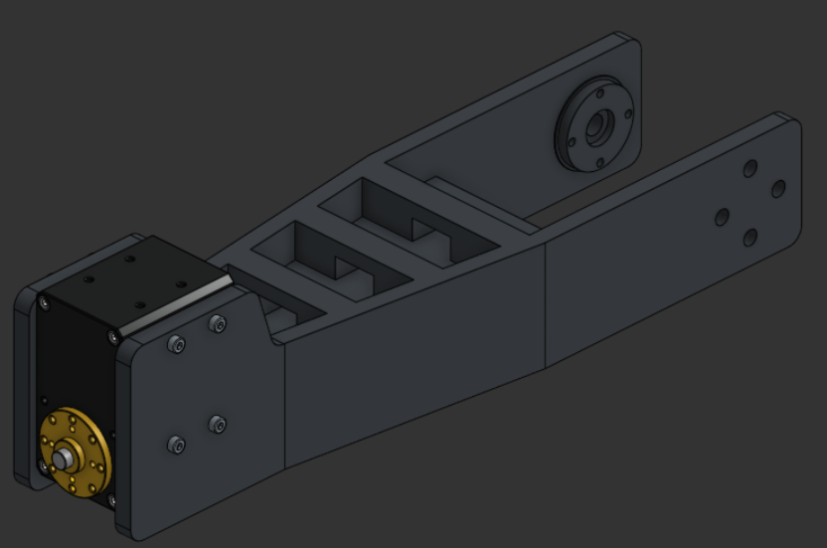
[picture p397: figure]

## Slide 41

Arm Gripper Finger Assembly Instructions

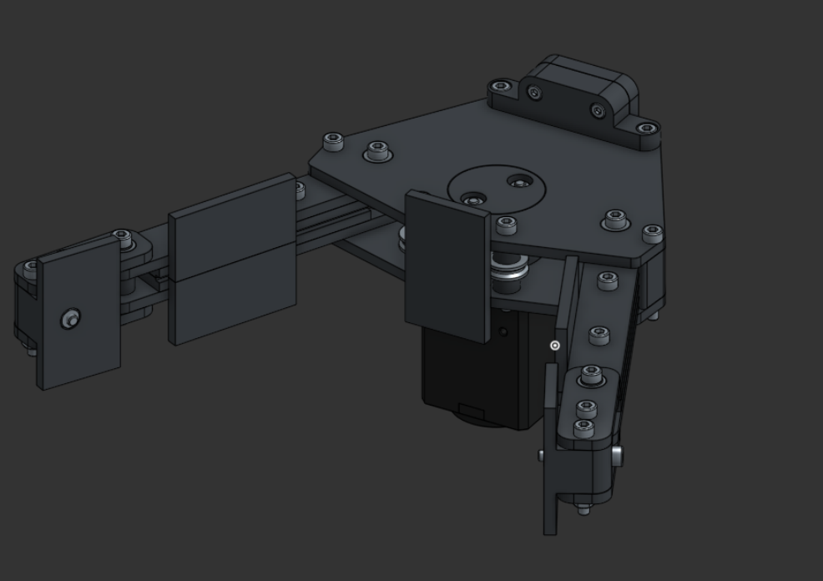
[picture p398: figure]
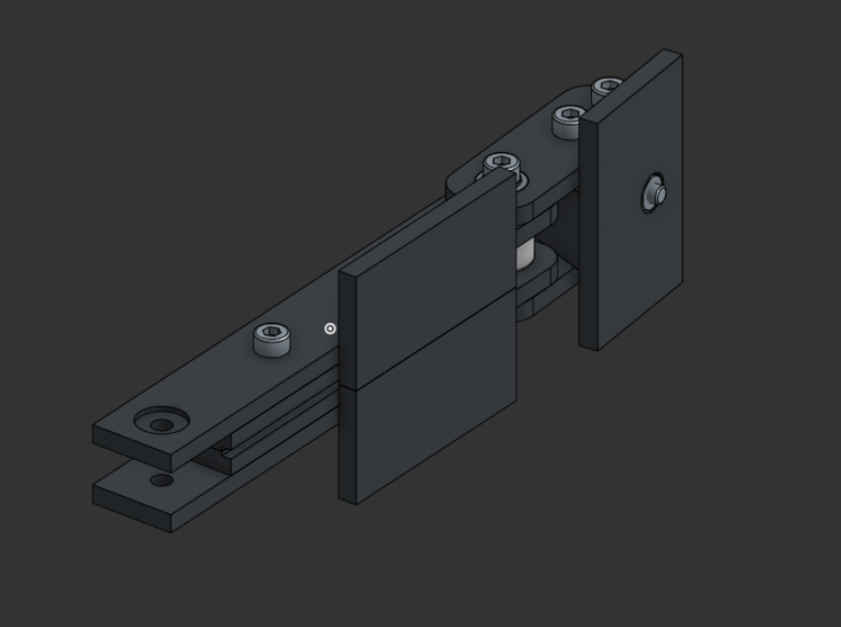
[picture p399: figure]

## Slide 42

Parts

Major Components:
2x Spring
2x Spring Spacer
4x Finger Front Plate
4x Finger Center Plate
2x Front Finger Pad
4x Center Finger Pad (two top pieces, two bottom pieces)

Minor Components:
6x M3x25mm Socket Head Bolt
4x M3x20mm Socket Head Bolt
4x 3x8x4mm Bearing
10x M3 Lock Washer
10x M3 Nut

## Slide 43

Major Components

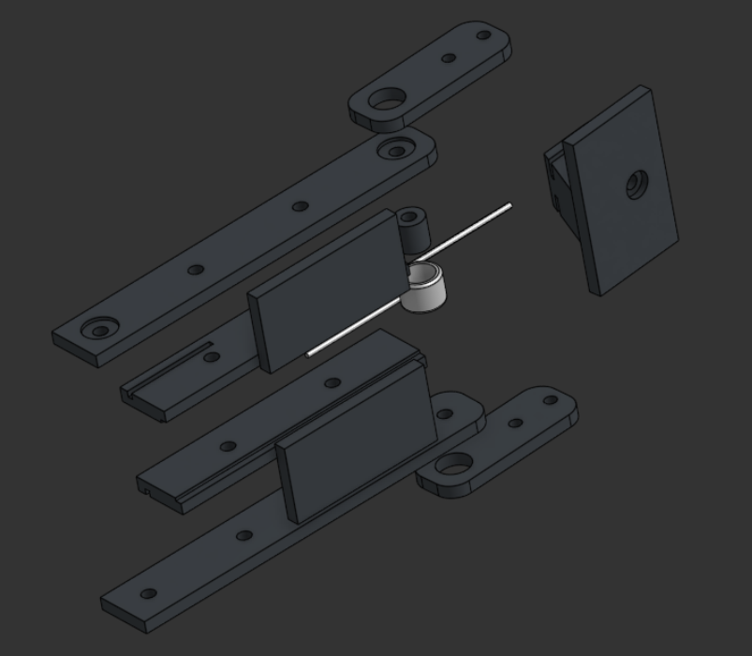
[picture p400: figure]

Front Finger Pad

Finger Front Plate

Finger Center Plate

Spring Spacer

Center Finger Pads

Spring

## Slide 44

Step 1

Bolt the Front Finger Plates to the Front Finger Pad with a lock washer underneath the nut

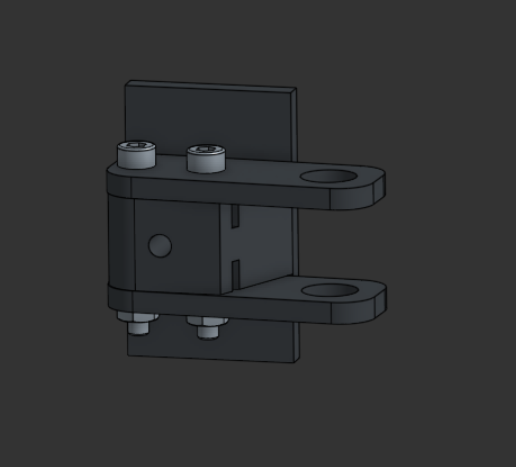
[picture p401: figure]
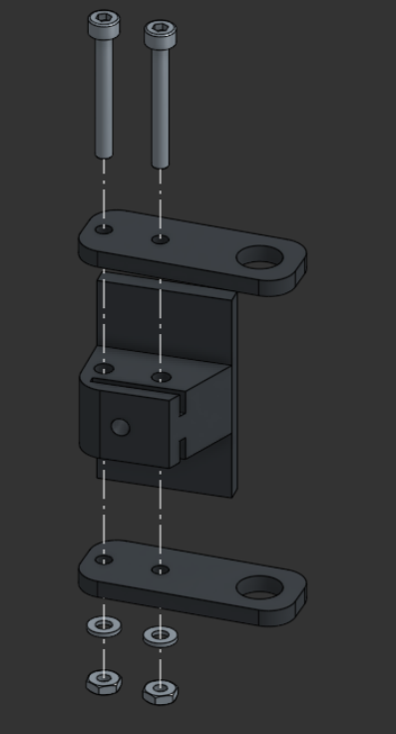
[picture p402: figure]

Parts
-2x Finger Front Plate
-Front Finger Pad
-2x M3x25mm Socket Head Bolt

-2x M3 Lock Washer
-2x M3 Nut

## Slide 45

Step 2

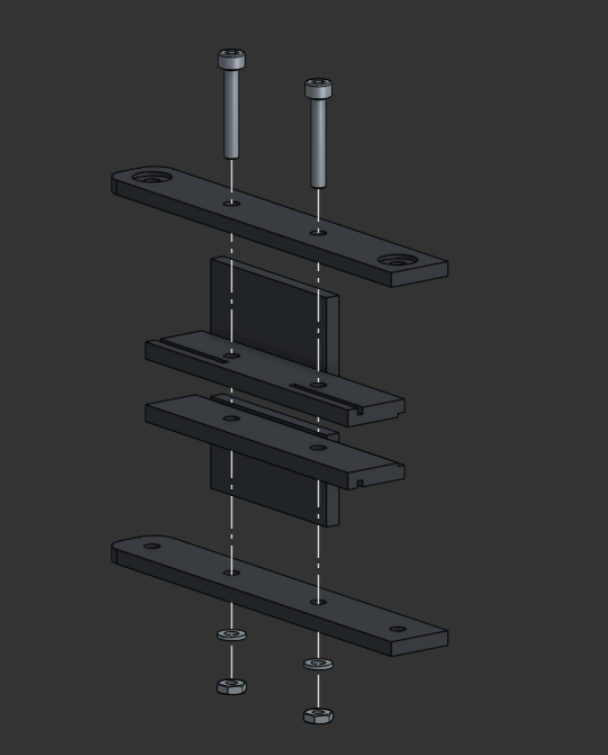
[picture p403: figure]

Parts
-2x Finger Center Plate
-2x Center Finger Pad
-2x M3x20mm Socket Head Bolt

Bolt the Center Finger Plates and Center Finger Pads together with a lock washer underneath the nut

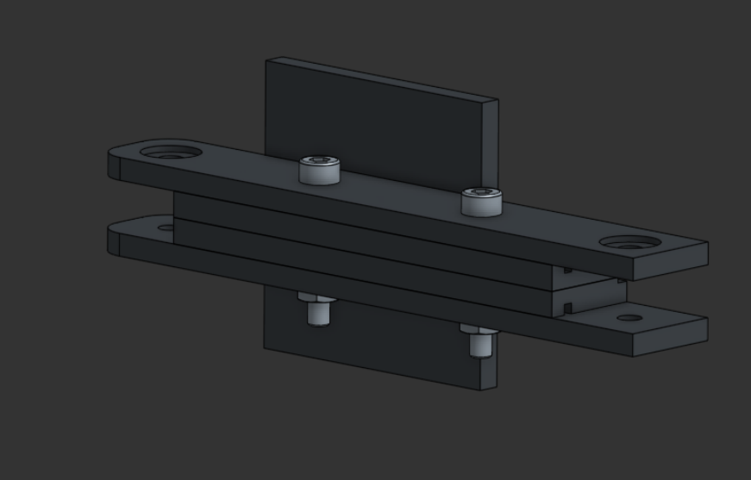
[picture p404: figure]

-2x M3 Lock Washer
-2x M3 Nut

## Slide 46

Step 3

Insert the Spring Spacer into the center of the spring and then align the spring with the end of the Center Finger Plates

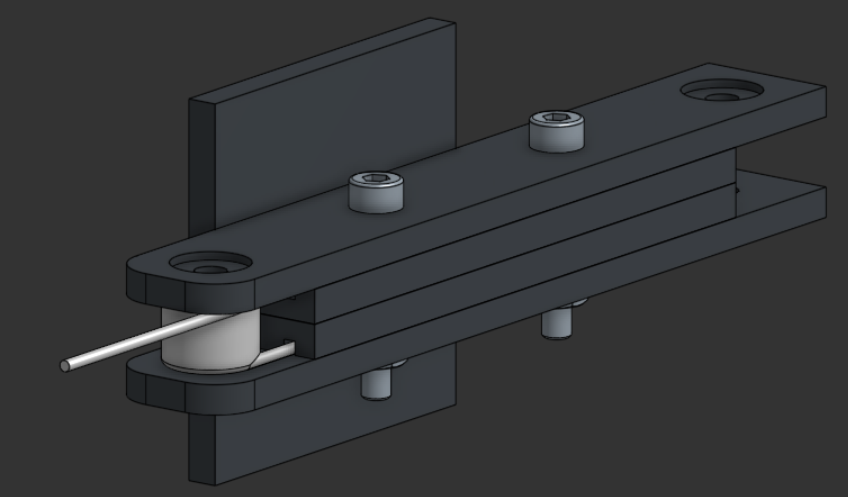
[picture p405: figure]
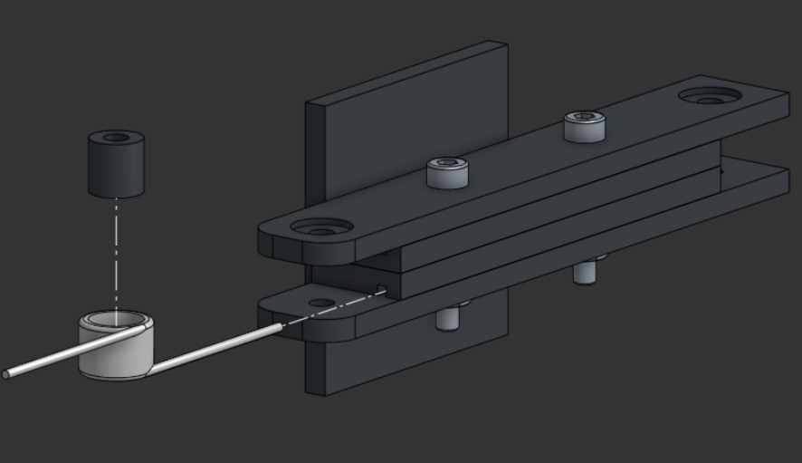
[picture p406: figure]

Parts
-Previous step
-Spring
-Spring Spacer

## Slide 47

Step 4

Align the front section of the finger with the center section

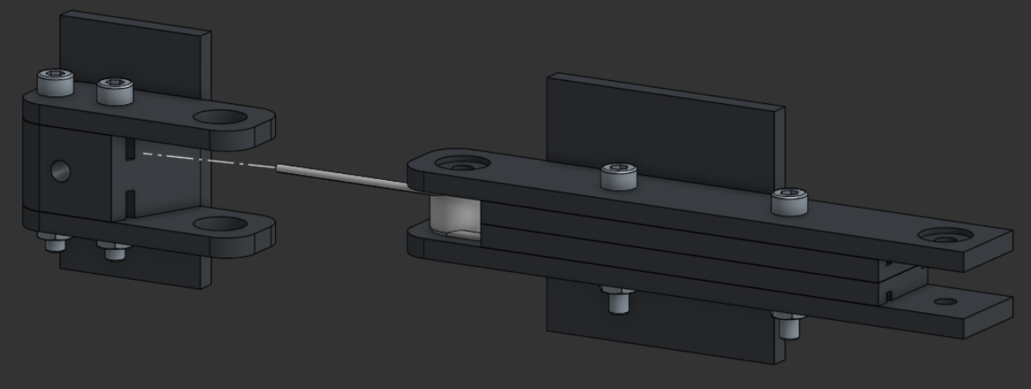
[picture p407: figure]
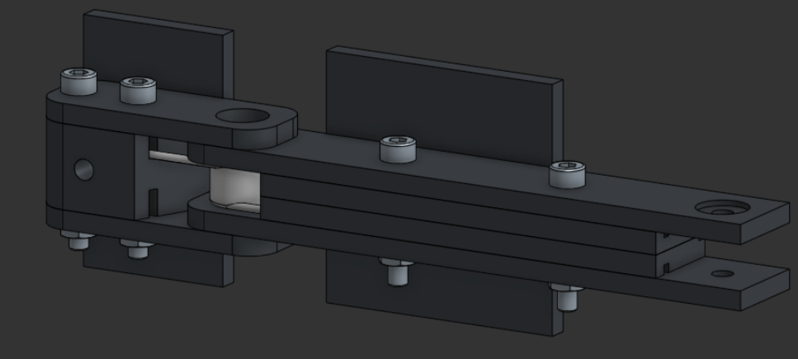
[picture p408: figure]

Parts
-Previous step
-Finger Front Assembly

## Slide 48

Step 5

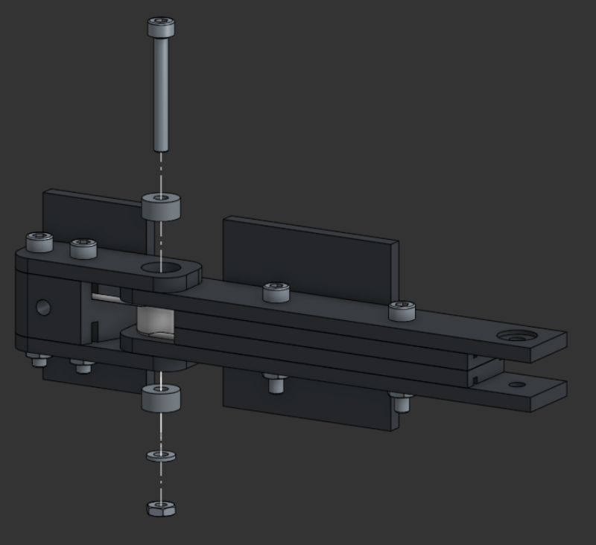
[picture p409: figure]

Parts
-Previous step
-M3x25mm Socket Head Bolt
-2x 3x8x4mm Bearing

Bolt the front and center sections together on top of the bearings with a lock washer underneath the nut

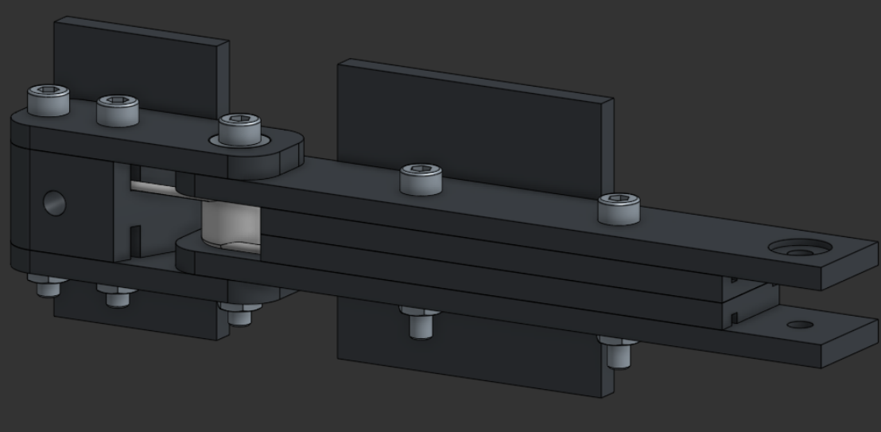
[picture p410: figure]

-M3 Lock Washer
-M3 Nut

## Slide 49

Step 6

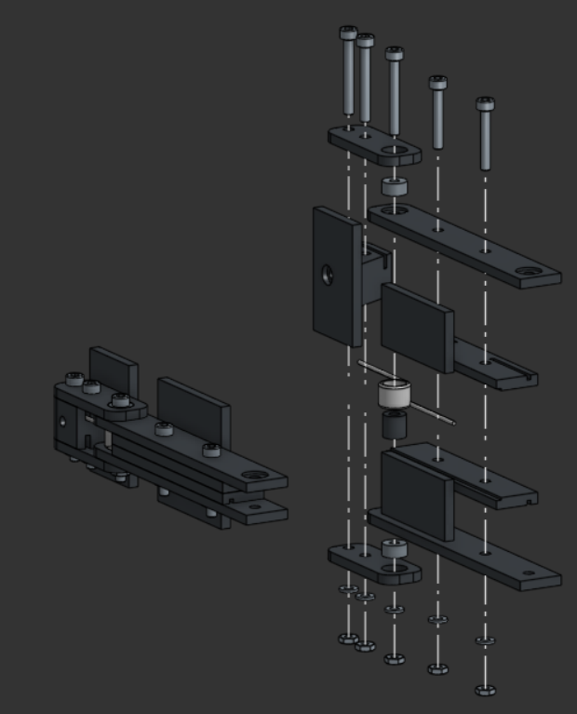
[picture p411: figure]

Parts
-Previous step
-Front Finger Pad
-2x Finger Front Plate

Repeat steps 1-5 for a mirror finger

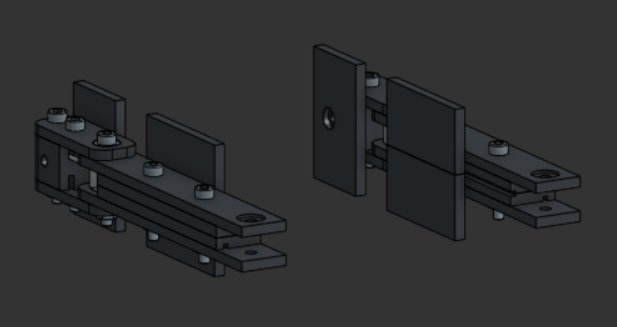
[picture p412: figure]

-2x 3x8x4mm Bearing
-2x M3x20mm Socket Head Bolt
-3x M3x25mm Socket Head Bolt
-2x M3 Lock Washer
-2x M3 Nut

-2x Finger Center Pads
-2x Finger Center Plate
-Spring
-Spring Spacer

## Slide 50

Arm Gripper Coiler Assembly Instructions

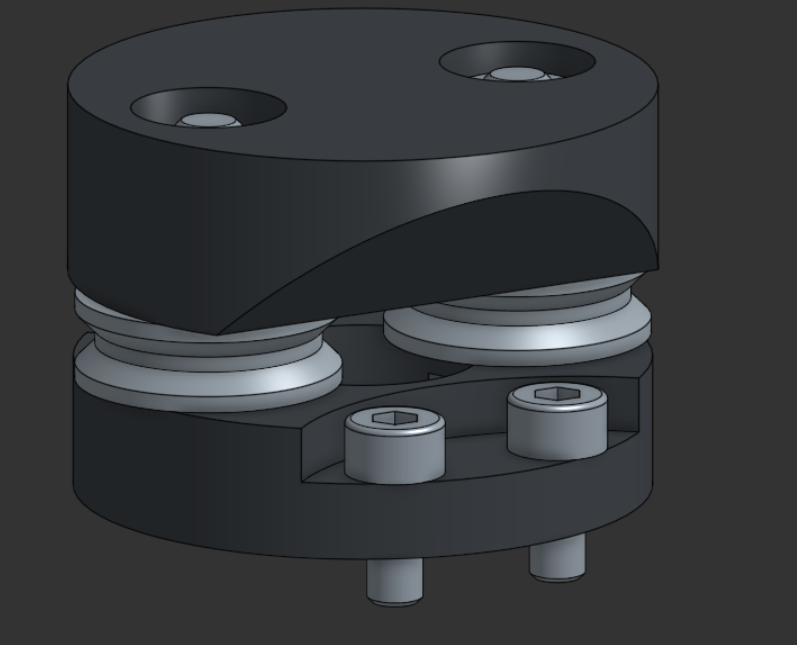
[picture p413: figure]
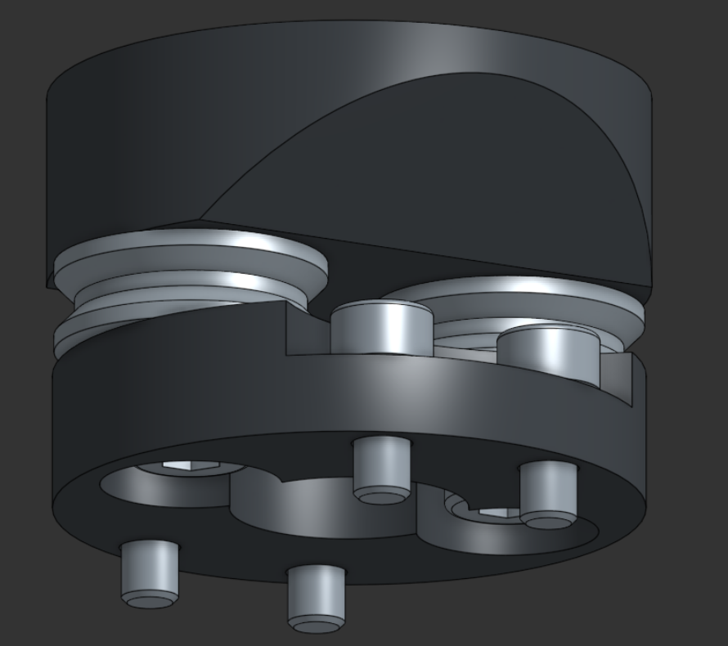
[picture p414: figure]

## Slide 51

Parts

Major Components:
2x Spring
2x Spring Spacer
4x Finger Front Plate
4x Finger Center Plate
2x Front Finger Pad
4x Center Finger Pad (two top pieces, two bottom pieces)

Minor Components:
8x M2.5x8mm Bolt

## Slide 52

Major Components

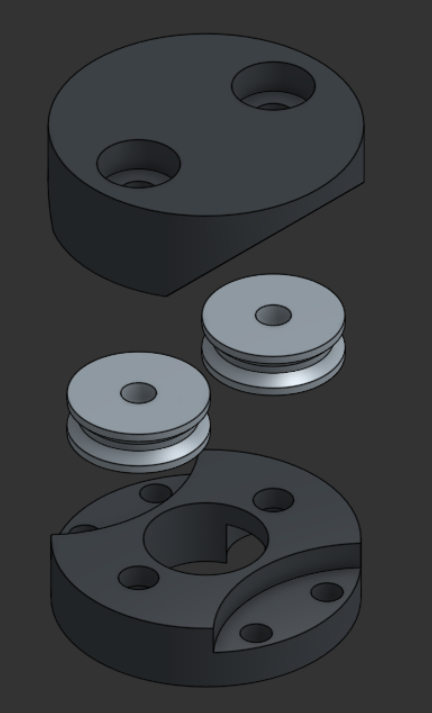
[picture p415: figure]

Coiler Top

Coiler Bottom

Pulleys

## Slide 53

Step 1

Bolt the Coiler Top to the pulleys and Coiler Bottom

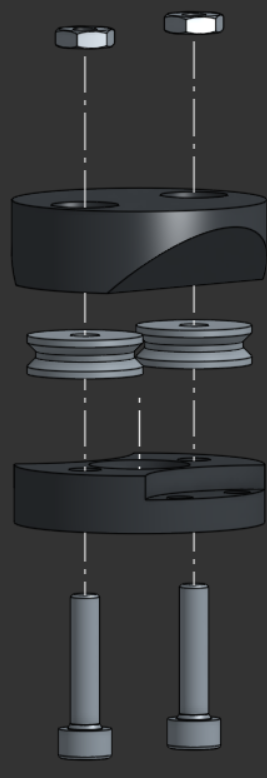
[picture p416: figure]
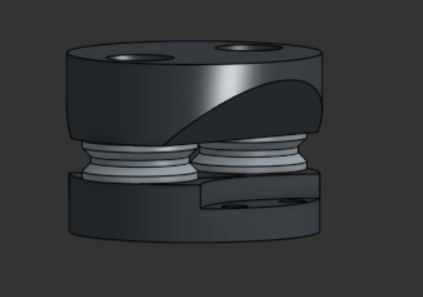
[picture p417: figure]

Parts
-Coiler Top
-Coiler Bottom
-2x Pulley

-2x M3x14mm Socket Head Bolt
-2x M3 Nut

## Slide 54

Step 2

Bolt the Coiler to the horn of the actuator

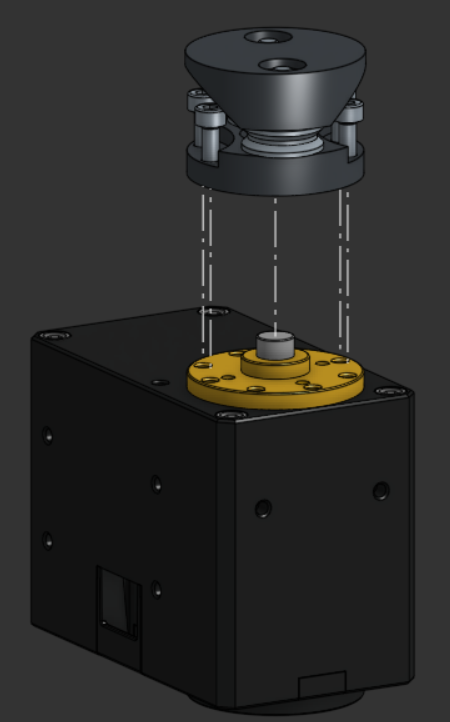
[picture p418: figure]

Parts
-Previous step
-Robotis XM540-W270-T Actuator
-4x M2.5x8mm Socket Head Bolt

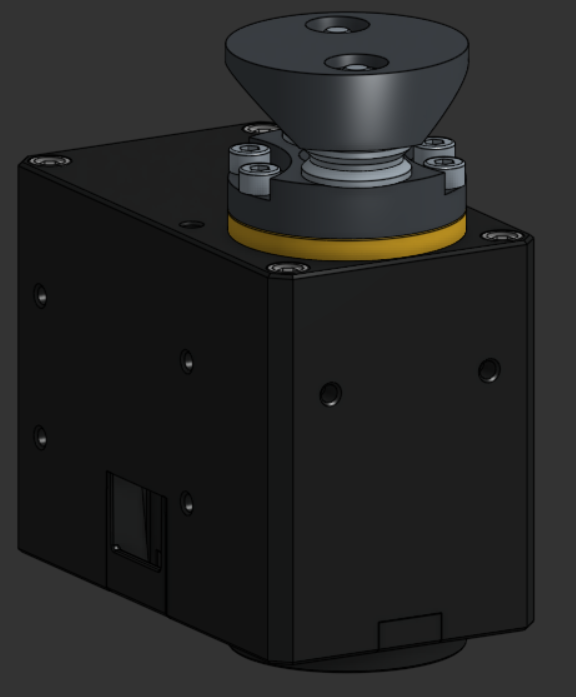
[picture p419: figure]

## Slide 55

Arm Gripper Base Assembly Instructions

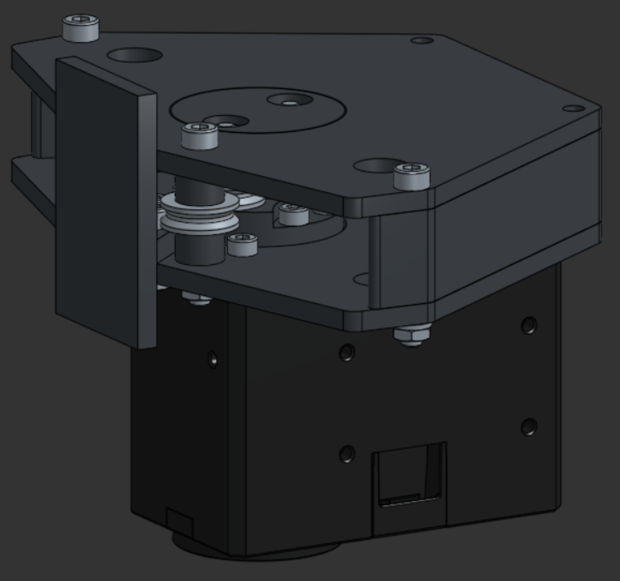
[picture p420: figure]
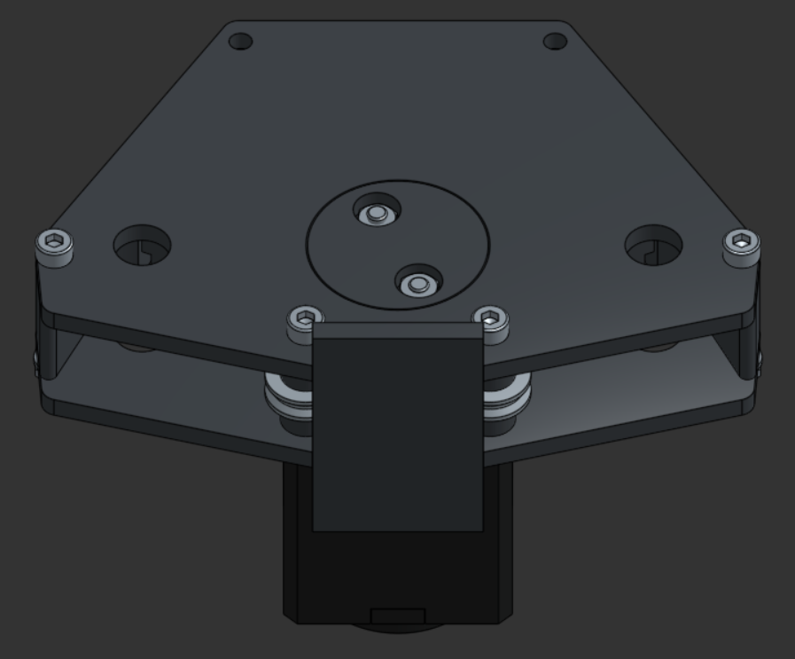
[picture p421: figure]

## Slide 56

Parts

Major Components:
Coiler Assembly
Gripper Base Top Plate
Gripper Base Bottom Plate
Gripper Base Front
2x Gripper Base Side Wall
2x Pulley
2x Pulley Spacer

Minor Components:
2x M3x10mm Socket Head Bolt
4x M3x25mm Socket Head Bolt
6x M3 Lock Washer
6x M3 Nut

## Slide 57

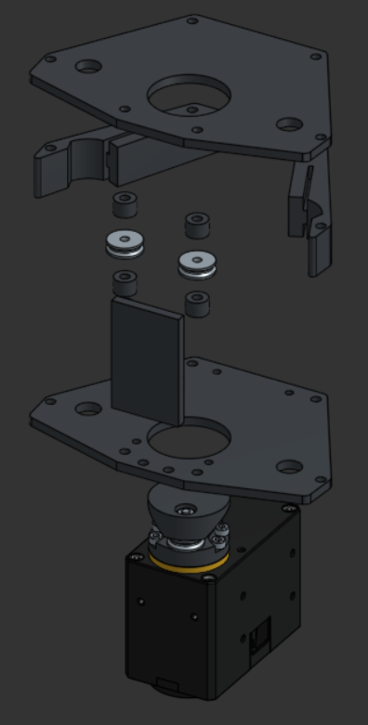
[picture p422: figure]

Major Components

Gripper Base Top Plate

Pulleys

Gripper Base Front

Gripper Base Side Wall

Gripper Base Bottom Plate

Pulley Spacers

Coiler Assembly

## Slide 58

Step 1

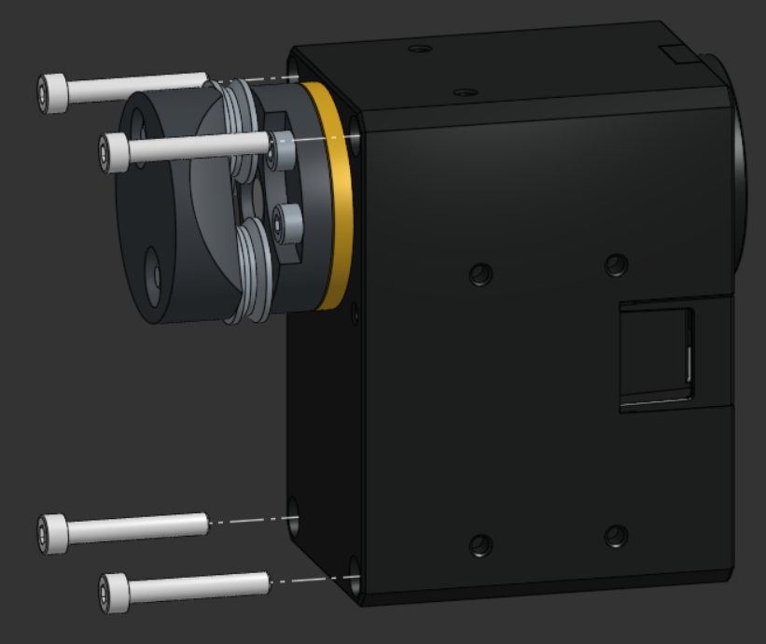
[picture p423: figure]

Parts
-Coiler Assembly

Remove the front four bolts from the actuator

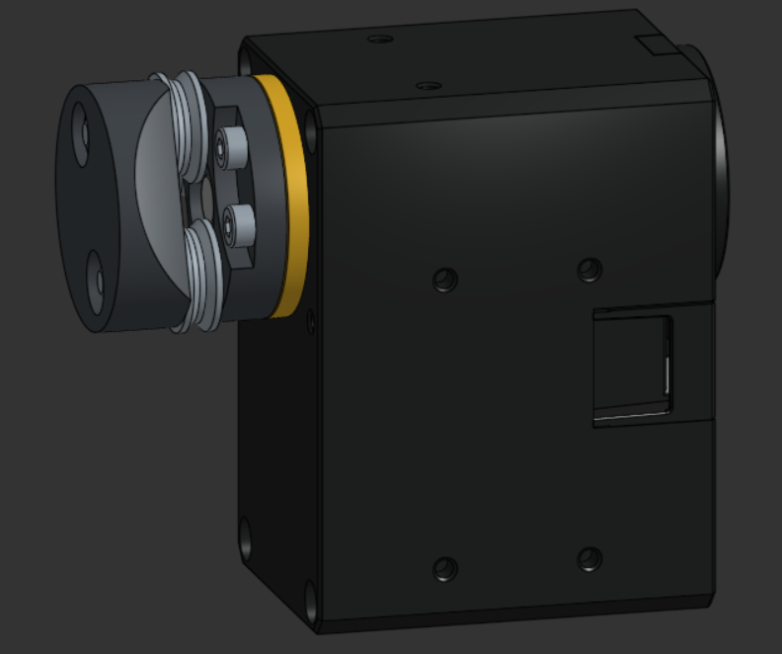
[picture p424: figure]

## Slide 59

Step 2

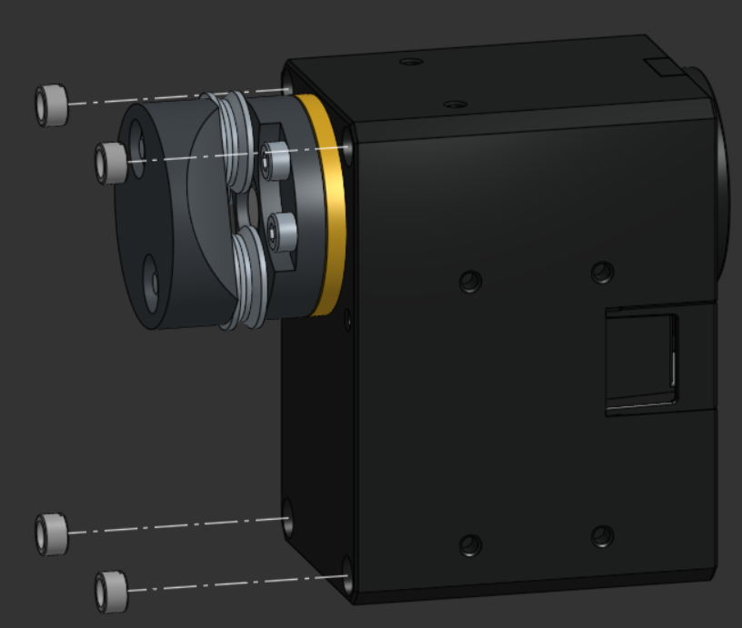
[picture p425: figure]

Parts
-Previous step
-4 Robotis Spacers

Insert Robotis Spacers into the front of the actuator

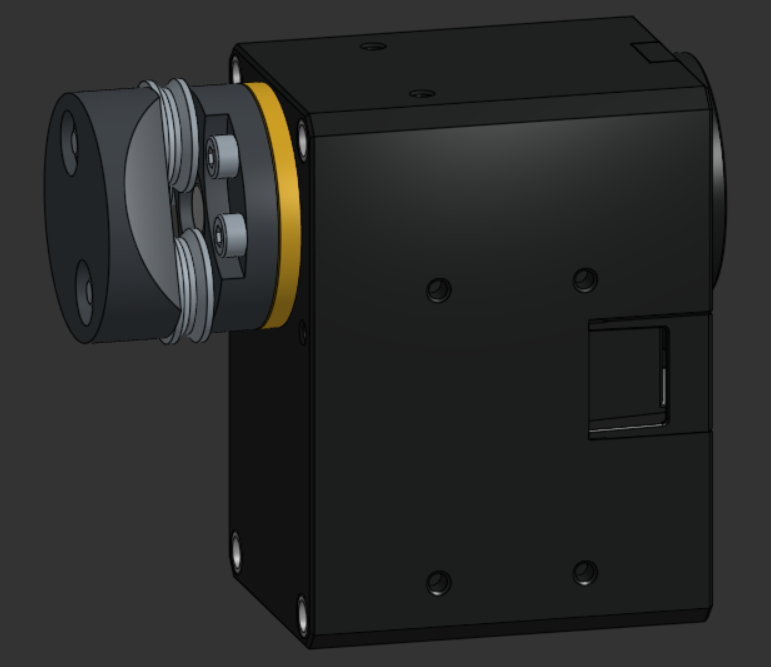
[picture p426: figure]

## Slide 60

Step 3

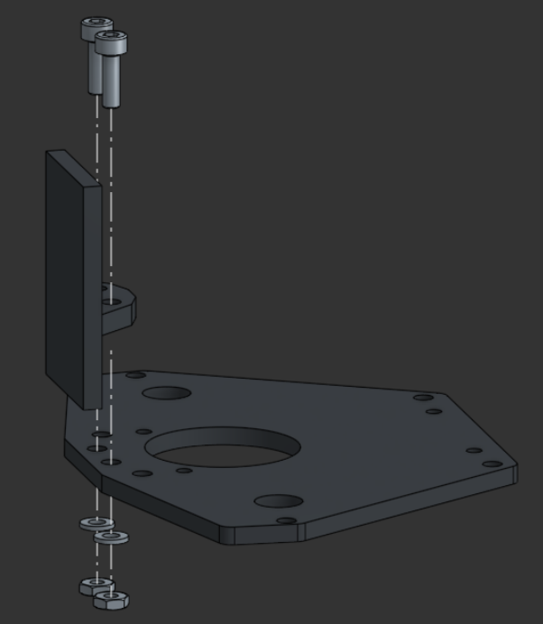
[picture p427: figure]

Parts
-Gripper Base Bottom Plate
-Gripper Base Front
-2x M3x10mm Socket Head Bolt

Bolt the Front Finger Plates to the Front Finger Pad with a lock washer underneath the nut

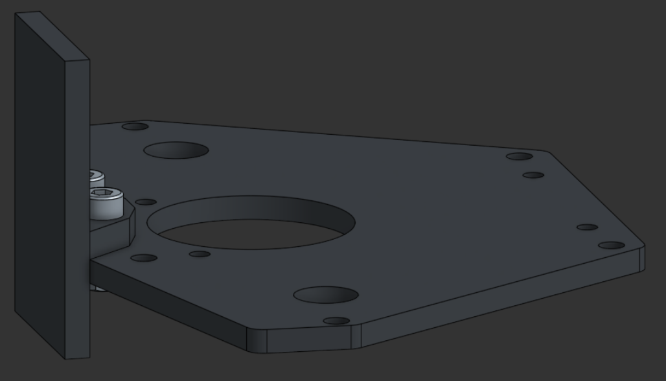
[picture p428: figure]

-2x M3 Lock Washer

## Slide 61

Step 4

Bolt the Gripper Base Bottom Plate to the actuator

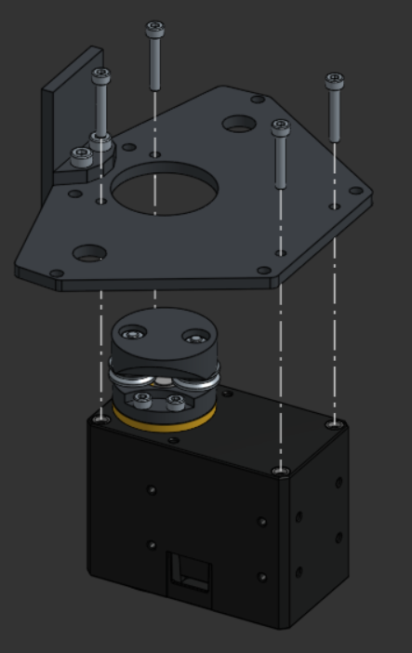
[picture p429: figure]

Parts
-Previous step
-Coiler Assembly with spacers
-4x M2.5x16mm Socket Head Bolt

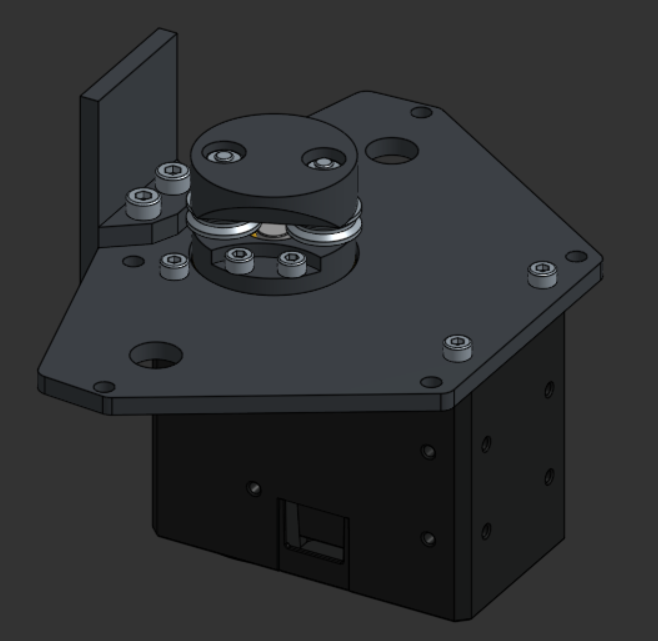
[picture p430: figure]

## Slide 62

Step 5

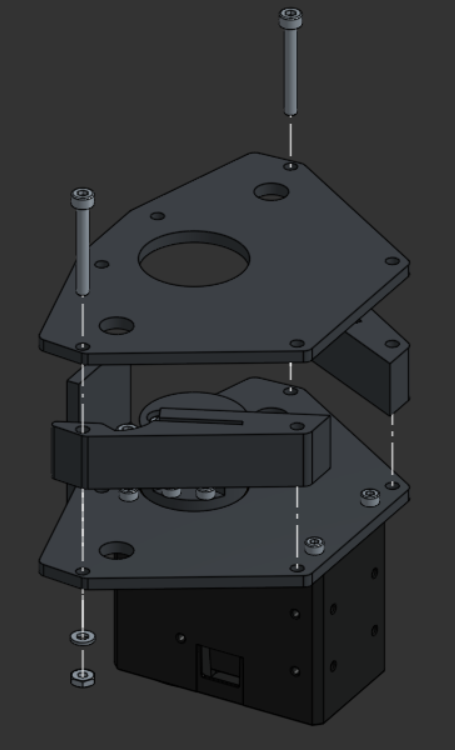
[picture p431: figure]

Parts
-Previous step
-Gripper Base Side Wall
-2x M3x25mm Socket Head Bolt

Bolt the Front Finger Plates to the Front Finger Pad with a lock washer underneath the nut

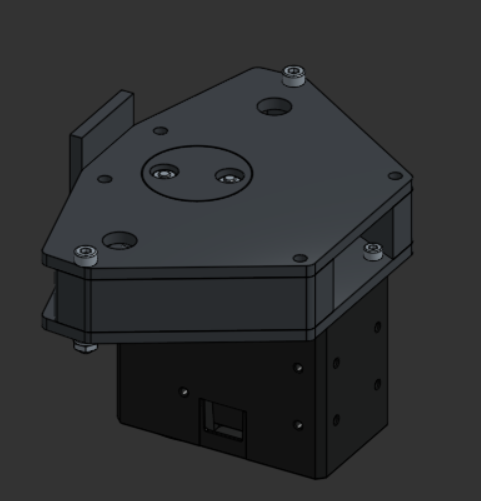
[picture p432: figure]

-2x Lock Washer
-2x M3 Nut

## Slide 63

Step 6

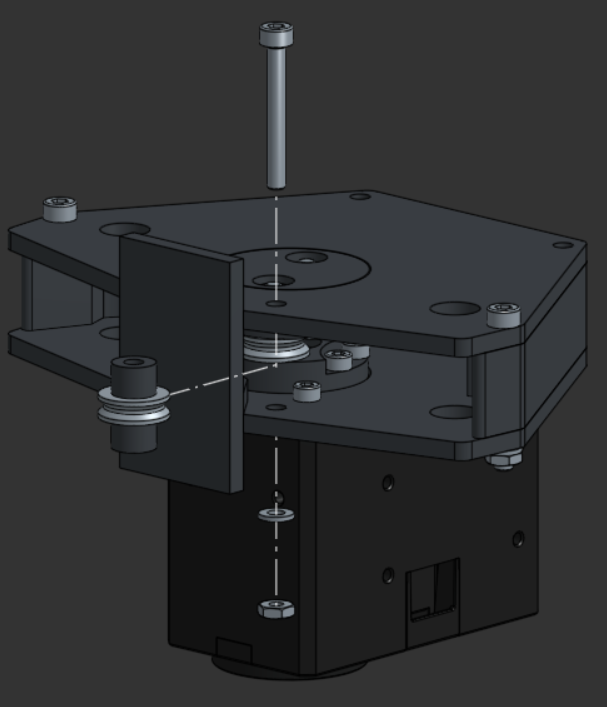
[picture p433: figure]

Parts
-Previous step
-3x12x4mm Pulley
-2x Pulley Spacer

Bolt the pulley and pulley spacers to the front of the Gripper Base

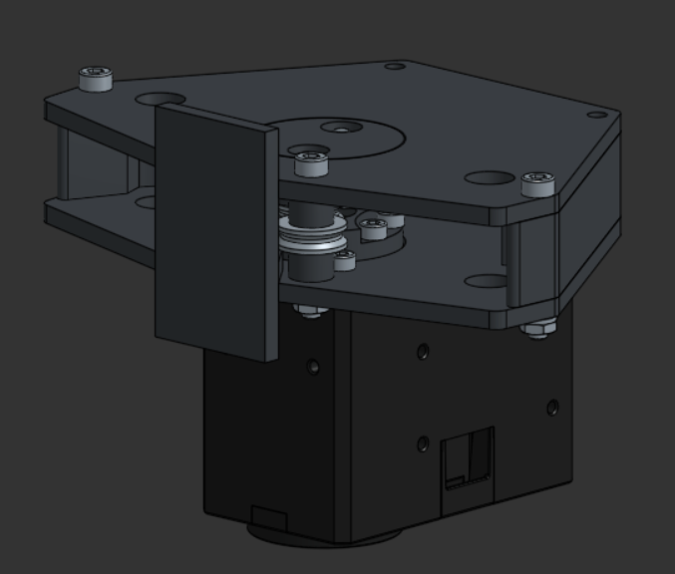
[picture p434: figure]

-M3x25mm Socket Head Bolt
-M3 Lock Washer
-M3 Nut

## Slide 64

Step 7

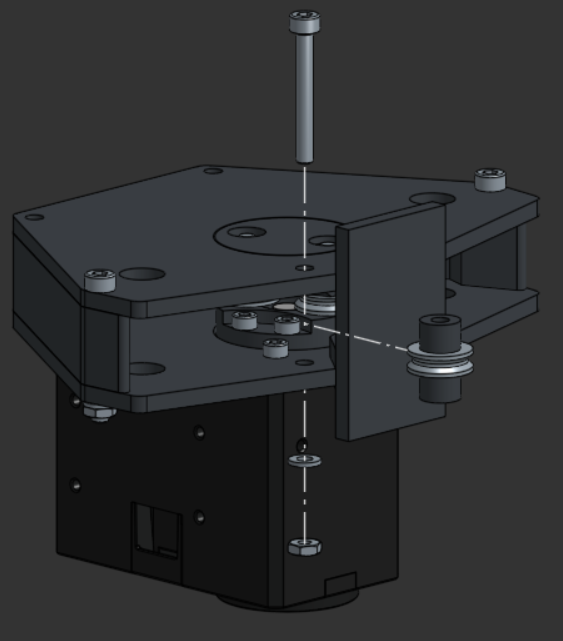
[picture p435: figure]

Parts
-Previous step
-3x12x4mm Pulley
-2x Pulley Spacer

Repeat for the other side

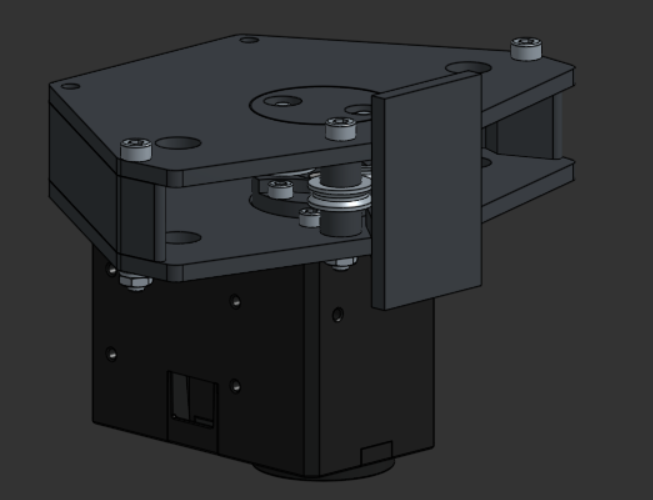
[picture p436: figure]

-M3x25mm Socket Head Bolt
-M3 Lock Washer
-M3 Nut

## Slide 65

Arm Gripper Assembly Instructions

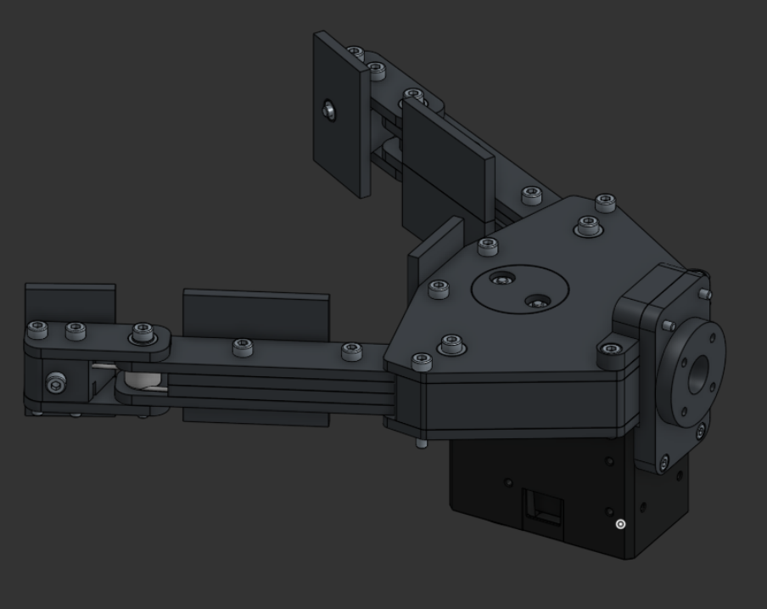
[picture p437: figure]
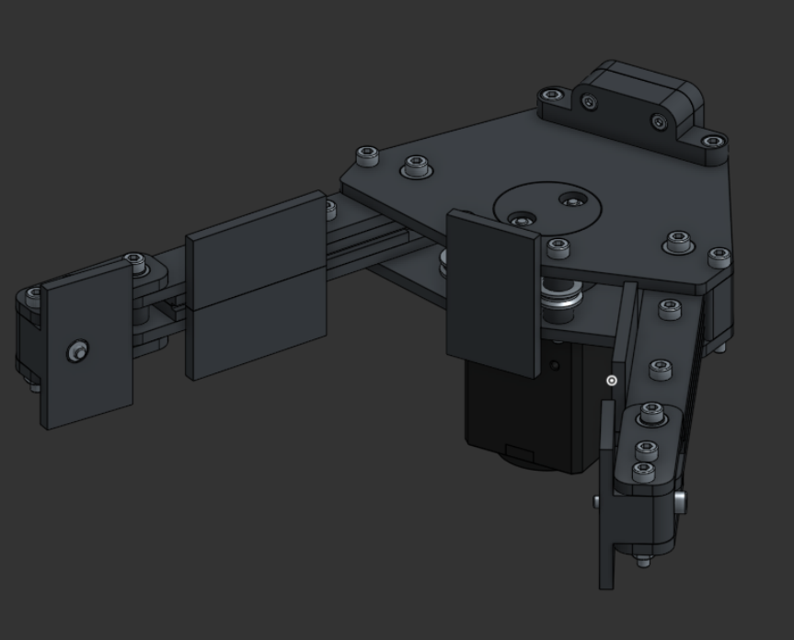
[picture p438: figure]

## Slide 66

Parts

Major Components:
Gripper Base Assembly
2x Gripper Finger Assembly
2x Spring
2x Spring Spacer

Minor Components:
2x M3x25mm Socket Head Bolt
2x M3 Lock Washer
2x M3 Nut

## Slide 67

Major Components

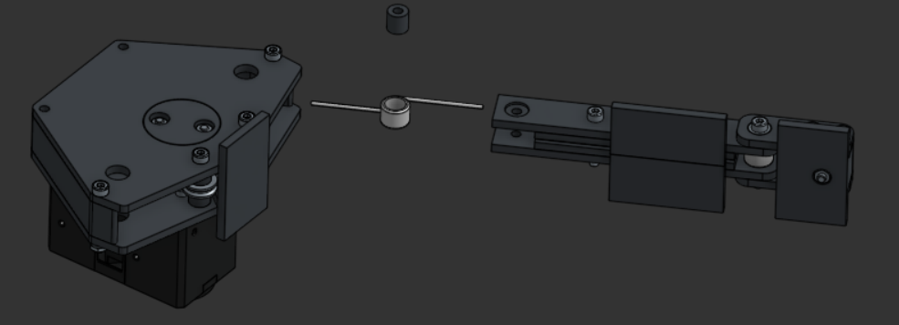
[picture p439: figure]

Spring Spacer

Gripper Base Assembly

Gripper Finger Assembly

Spring

## Slide 68

Step 1

Insert a spring spacer into the spring and align the spring with the end of the finger assembly

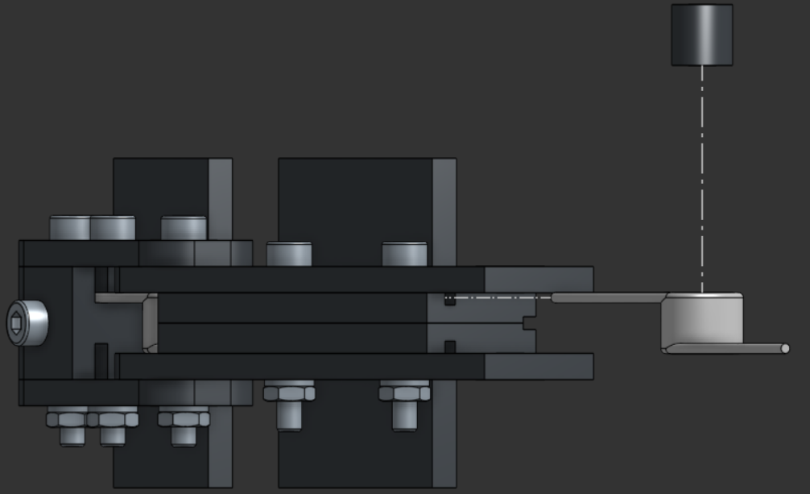
[picture p440: figure]
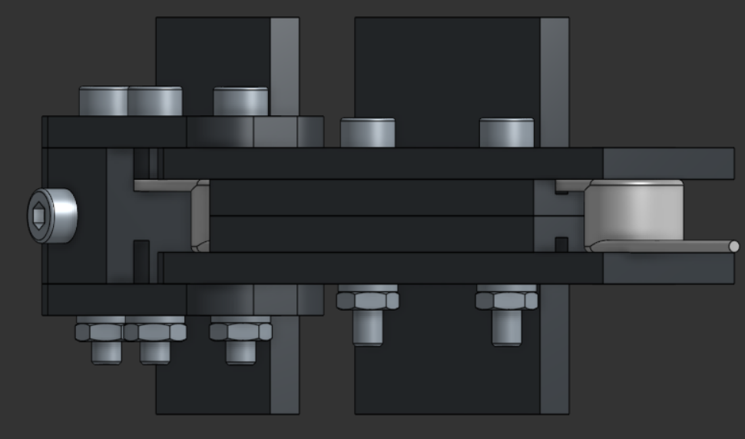
[picture p441: figure]

Parts
-Gripper Finger Assembly
-Spring
-Spring Spacer

## Slide 69

Step 2

Insert the end of the spring into the Gripper Base Side Wall

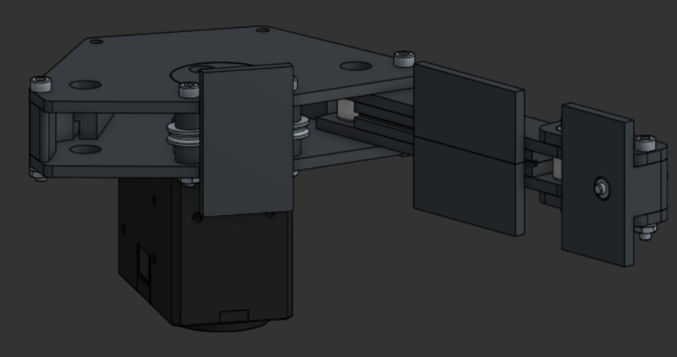
[picture p442: figure]
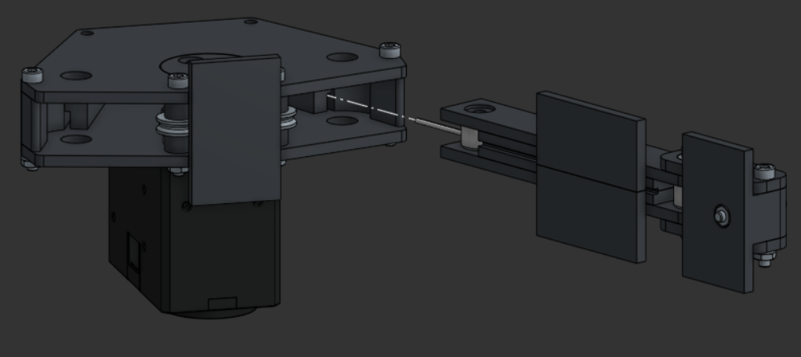
[picture p443: figure]

Parts
-Previous step
-Gripper Base Assembly

## Slide 70

Step 3

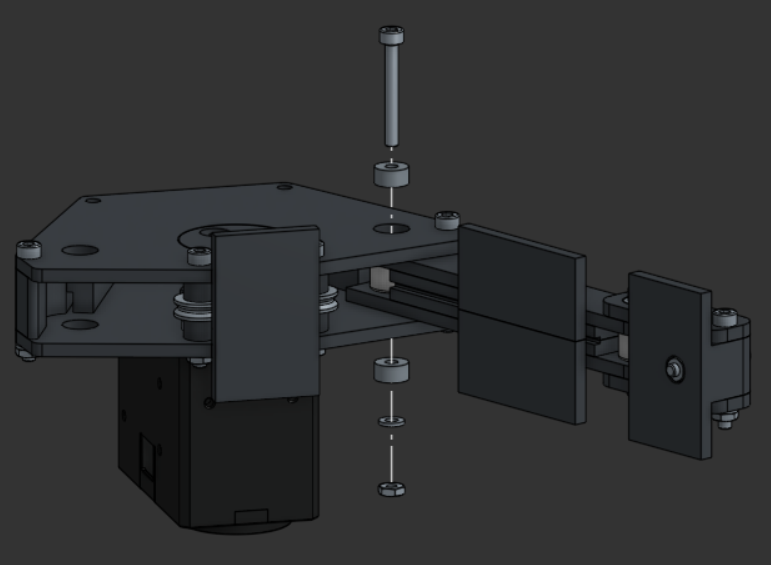
[picture p444: figure]

Parts
-Previous step
-M3x25mm Socket Head Bolt
-2x 3x8x4mm Bearing

Bolt the finger and two bearings to the gripper base with a lock washer and nut underneath

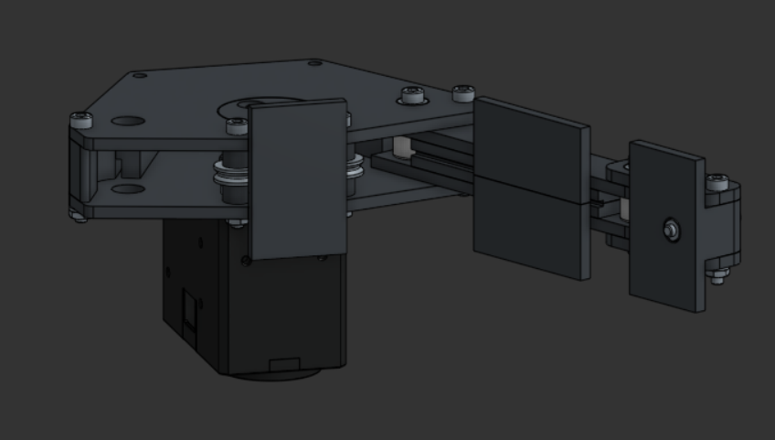
[picture p445: figure]

-M3 Lock Washer
-M3 Nut

## Slide 71

Step 4

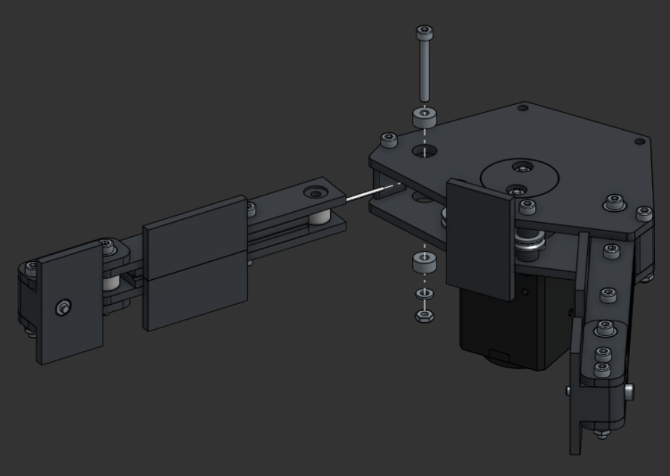
[picture p446: figure]

Repeat steps 1-3 for the other finger

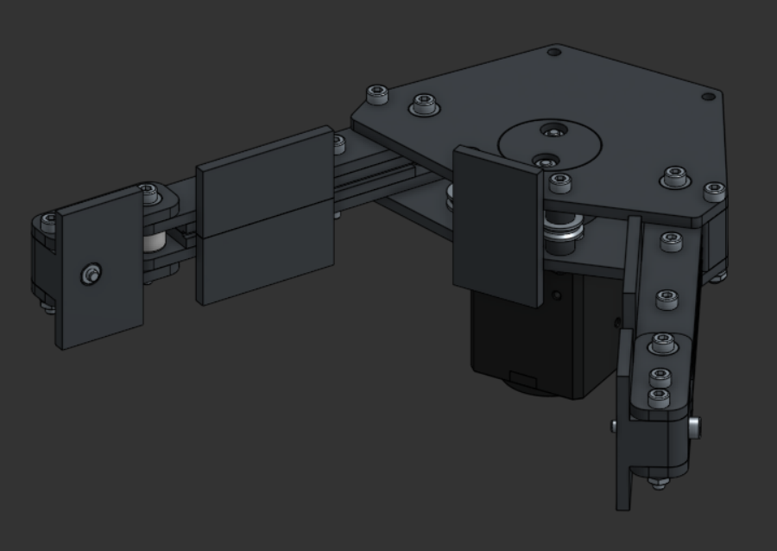
[picture p447: figure]

Parts
-Previous step
-Gripper Finger Assembly
-M3x25mm Socket Head Bolt

-2x 3x8x4mm Bearing
-M3 Lock Washer
-M3 Nut

## Slide 72

Arm Assembly Instructions

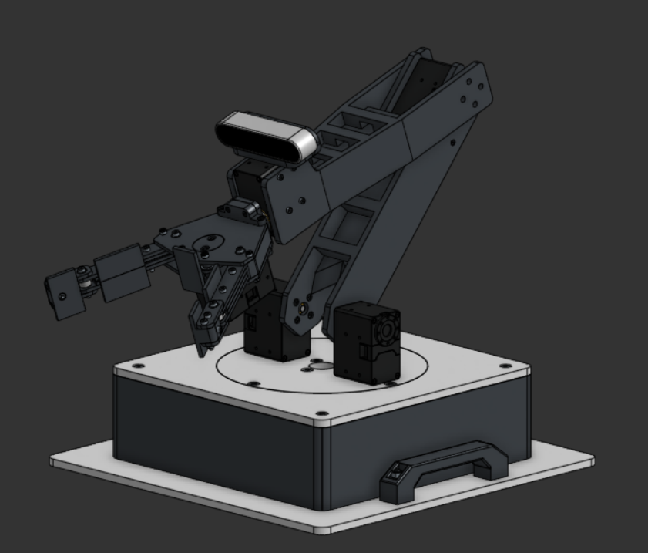
[picture p448: figure]
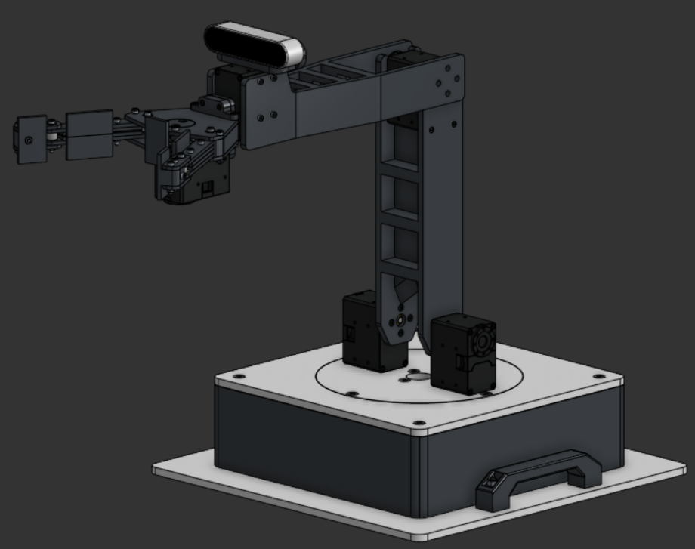
[picture p449: figure]

## Slide 73

Parts

Major Components:
Gripper Assembly
Base Assembly
Shoulder Assembly
Elbow Assembly
Intel Realsense D435i Camera
Camera Mount
Upper Wrist Mount
Center Wrist Mount

Minor Components:
14x M2.5x6mm Socket Head Bolt
10x M2.5x8mm Socket Head Bolt
2x M2.5x14mm Socket Head Bolt
2x M3x25mm Socket Head Bolt
2x M3x10mm Socket Head Bolt
2x M3 Lock Washer
2x M3 Nut
2x M2.5 Lock Washer
2x M2.5 Nut

## Slide 74

Major Components

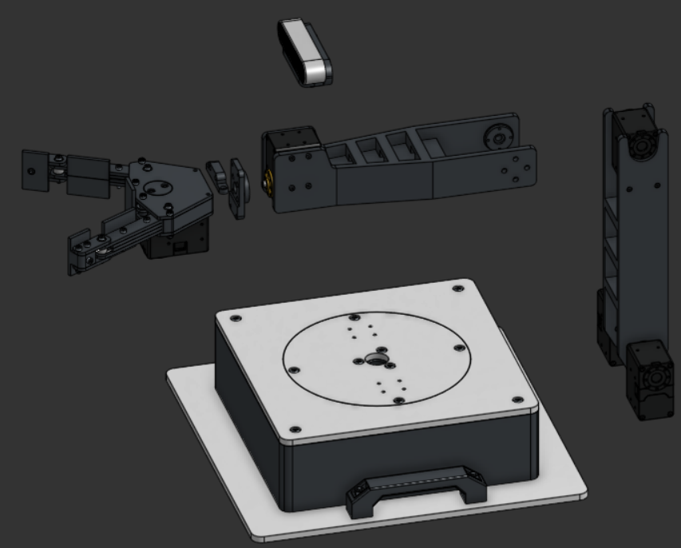
[picture p450: figure]

Camera + Mount

Elbow Assembly

Gripper Assembly + Wrist Mounts

Base Assembly

Shoulder Assembly

## Slide 75

Step 1

Attach the Center Wrist mount to the Elbow Assembly using 4 bolts

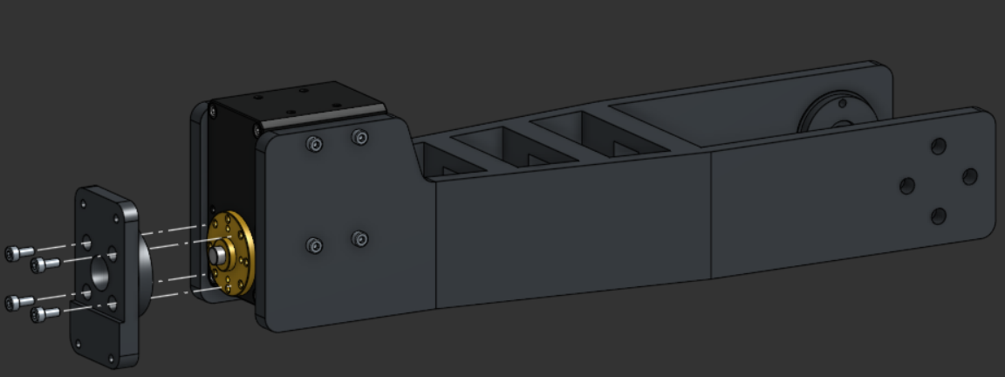
[picture p451: figure]
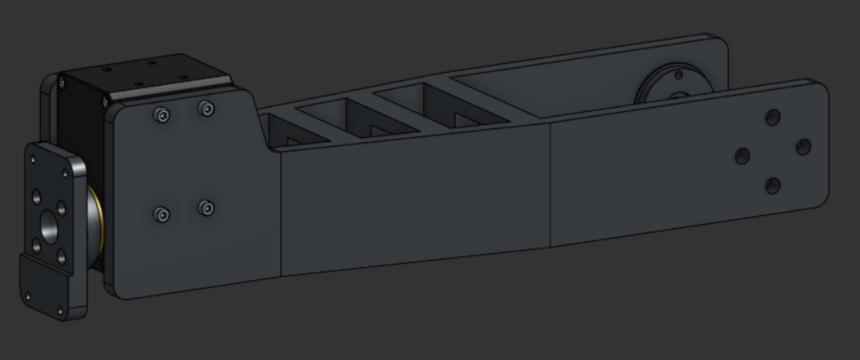
[picture p452: figure]

Parts
-Elbow Assembly
-Center Wrist Mount
-4x M2.5x6mm Socket Head Bolts

## Slide 76

Step 2

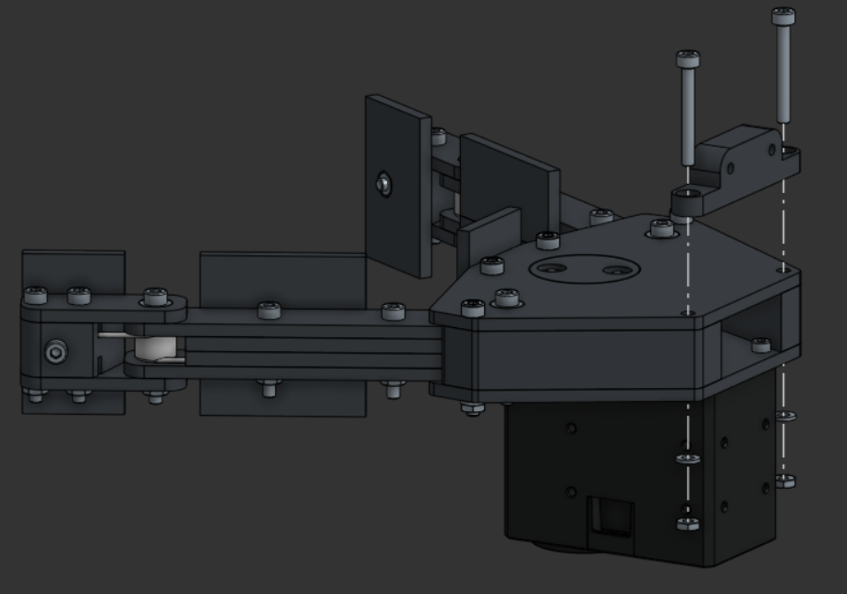
[picture p453: figure]

Parts
-Top Wrist Mount
-Gripper Assembly
-2x M3x25mm Socket Head Bolts

Bolt the Upper Wrist Mount to the Gripper Assembly

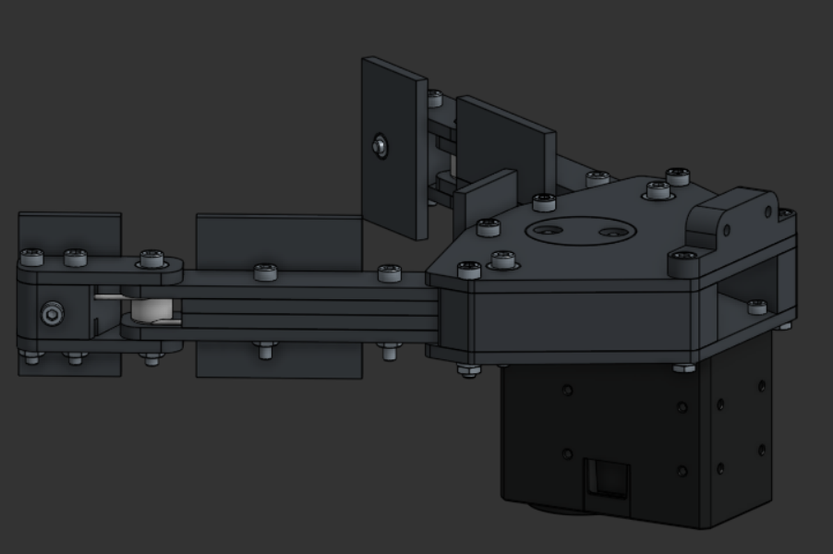
[picture p454: figure]

-2x M3 Lock Washer
-2x M3 Nut

## Slide 77

Step 3

Bolt the Upper Wrist Mount to the Center Wrist Mount

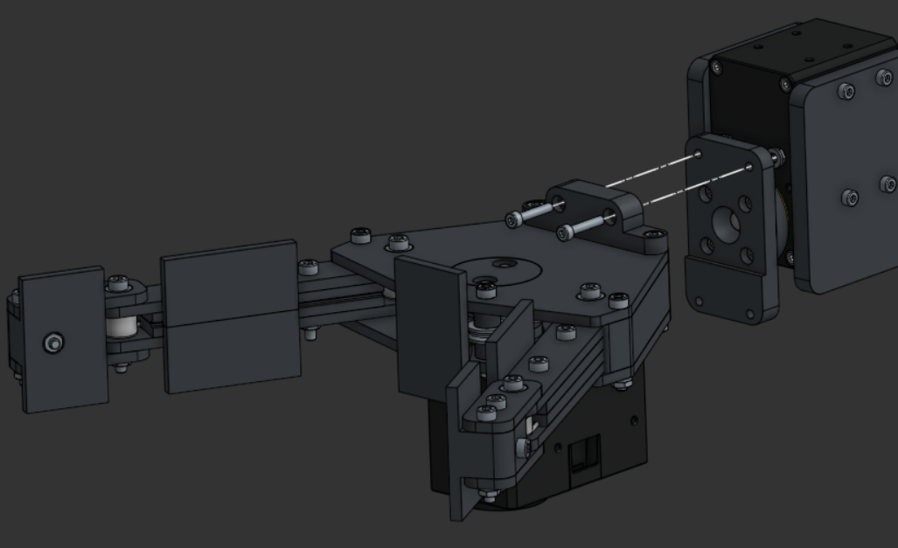
[picture p455: figure]
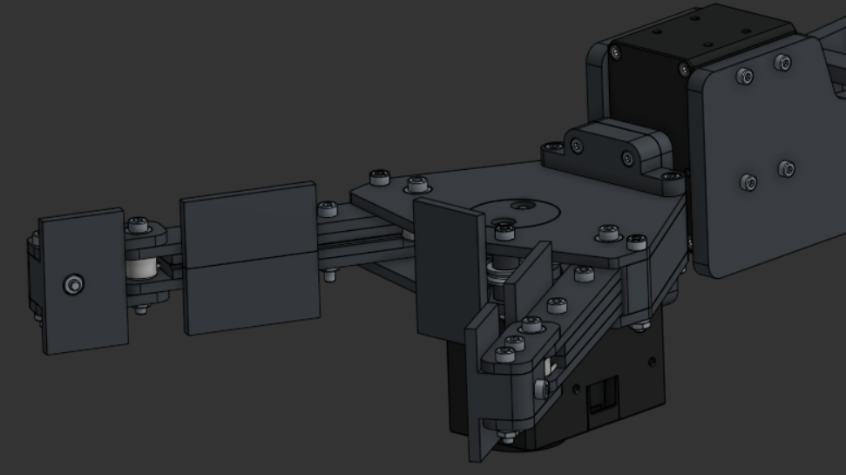
[picture p456: figure]

Parts
-Previous step
-2x M2.5x14mm Socket Head Bolt
-2x M2.5 Lock Washer

-2x M2.5 Nut

## Slide 78

Step 4

Bolt the bottom of the Center Wrist Mount to the gripper actuator

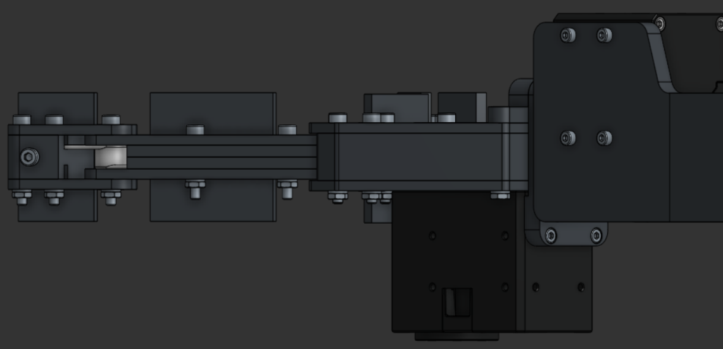
[picture p457: figure]
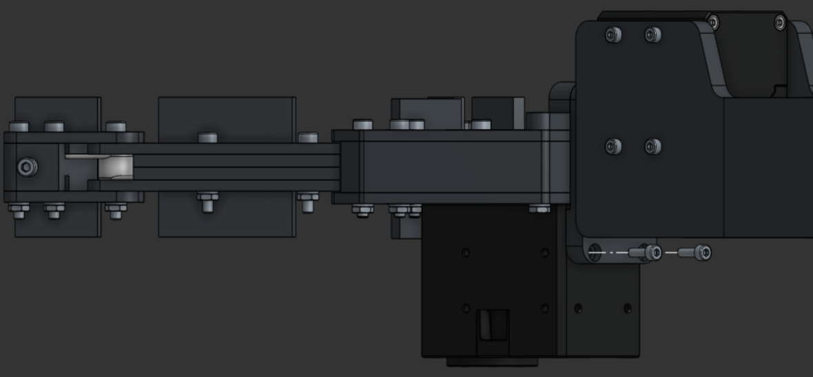
[picture p458: figure]

Parts
-Previous step
-2x M2.5x8mm Socket Head Bolt

## Slide 79

Step 5

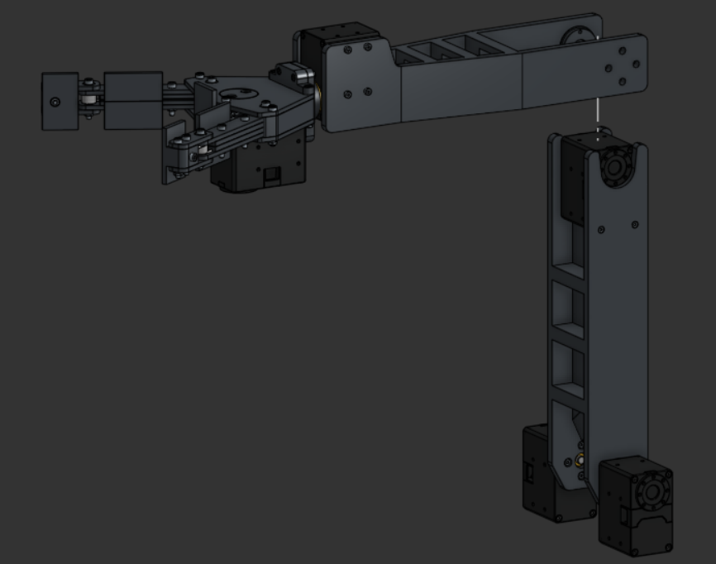
[picture p459: figure]

Parts
-Previous step
-Shoulder Assembly

Align the Elbow Assembly with the Shoulder Assembly

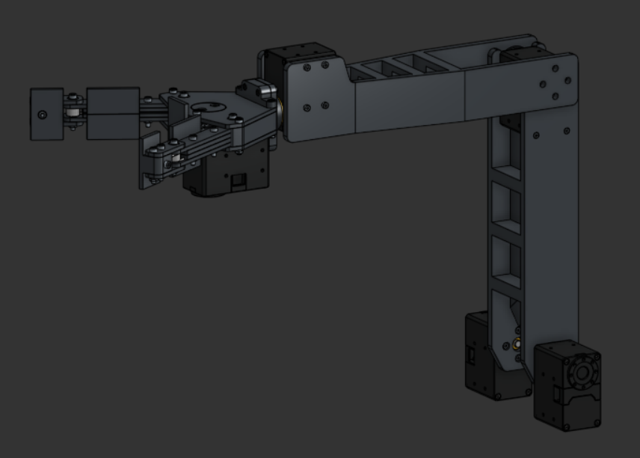
[picture p460: figure]

## Slide 80

Step 6

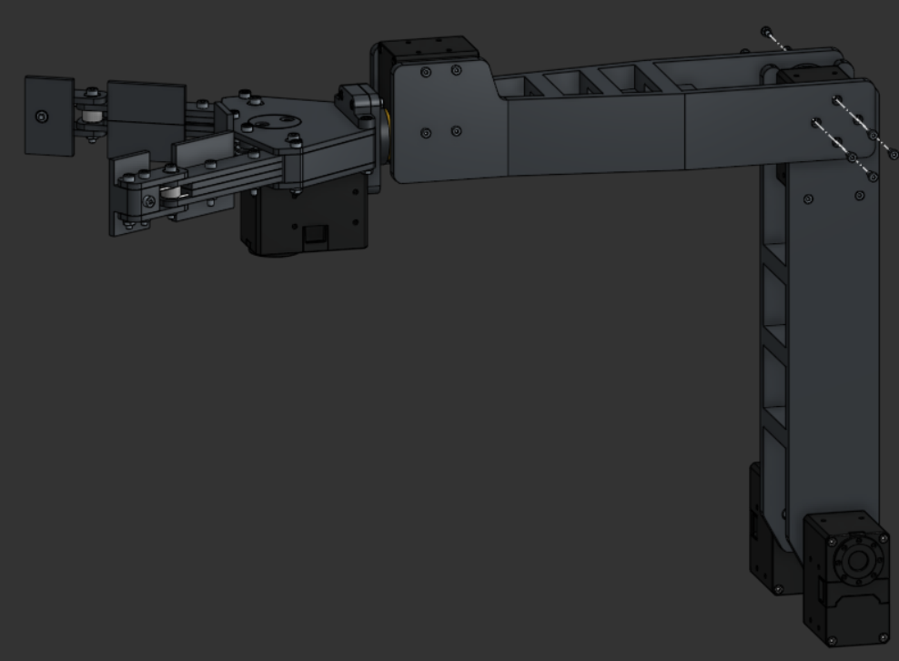
[picture p461: figure]

Parts
-Previous step
-8x M2.5x6mm Socket Head Bolt

Bolt the Elbow Assembly to the Shoulder Assembly

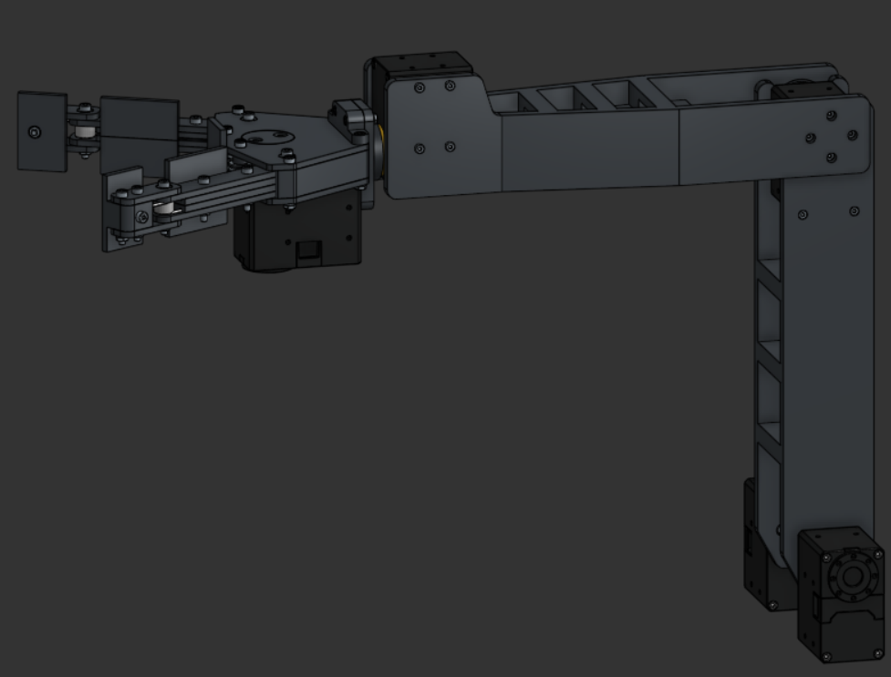
[picture p462: figure]

## Slide 81

Step 7

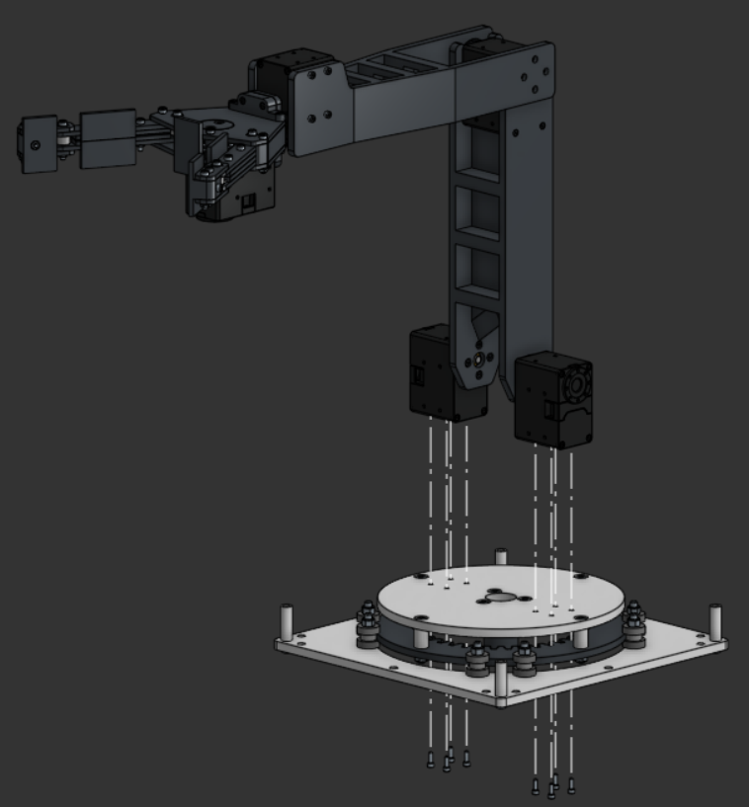
[picture p463: figure]

Parts
-Previous step
-Arm Base Assembly
-8x M2.5x8mm Socket Head Bolt

Bolt the Shoulder Assembly to the Arm Base Assembly

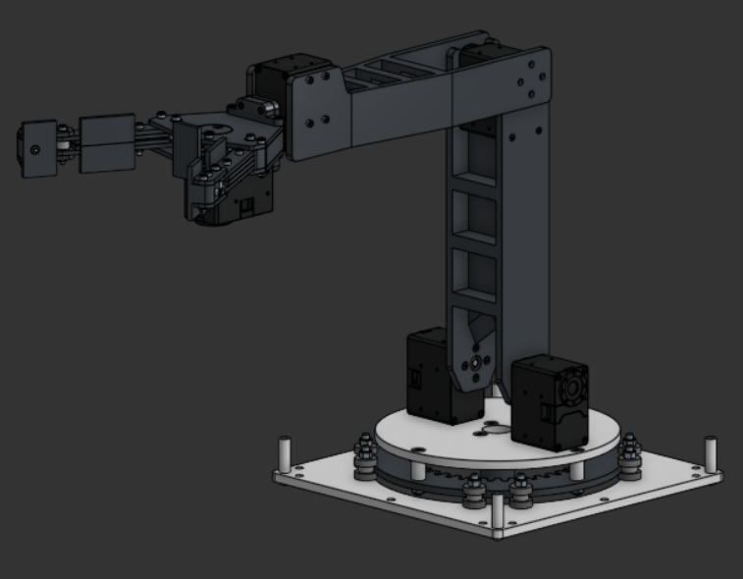
[picture p464: figure]

## Slide 82

Step 8

Bolt the Camera Mount to the back two holes of the elbow actuator

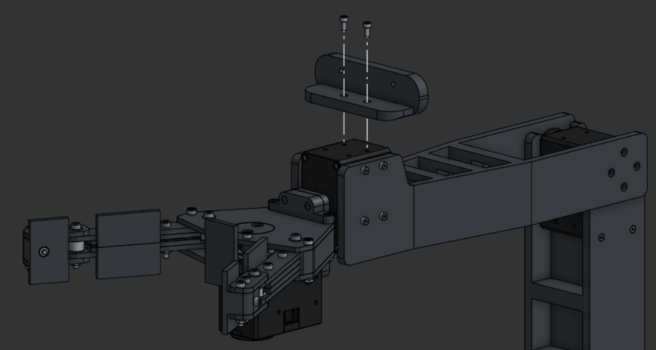
[picture p465: figure]
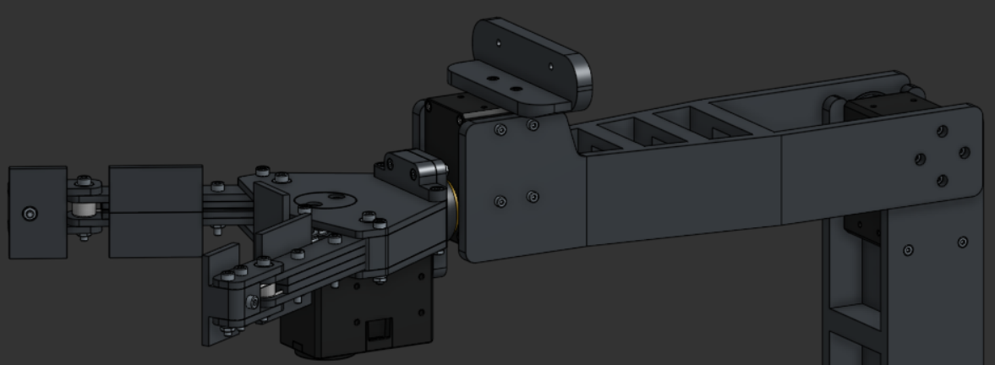
[picture p466: figure]

Parts
-Previous step
-Camera Mount
-2x M2.5x6mm Socket Head Bolt

## Slide 83

Step 9

Bolt the camera to the Camera Wrist Mount

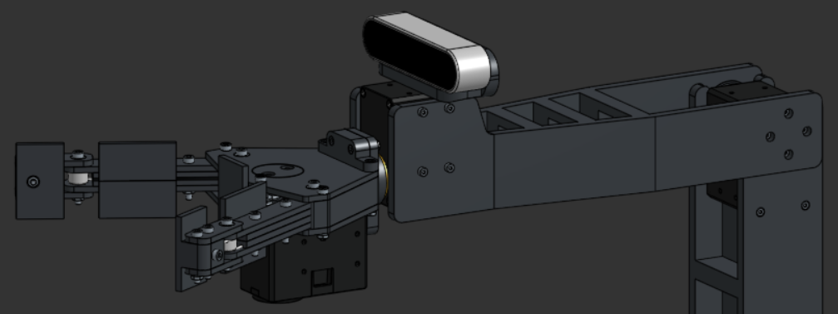
[picture p467: figure]
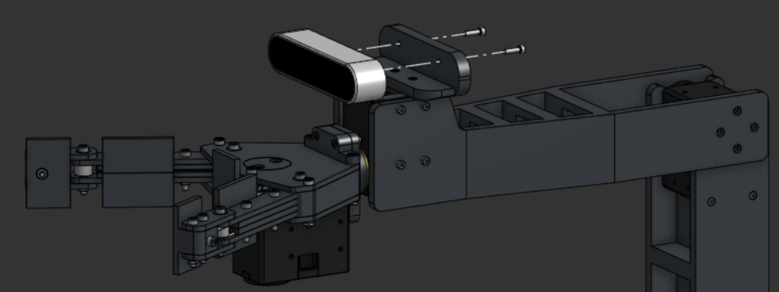
[picture p468: figure]

Parts
-Previous step
-Intel Realsense D435i Camera
-2x M3x10mm Socket Head Bolt
