balu-lab/cabs-PETFAB-Hammer-Joshua/User Manuals/README.md

# User Manuals

Datasheets for the Robotis Dynamixel XM540-W270-T and Intel RealSense D435i go here.
