balu-lab/cabs-PETFAB-Hammer-Joshua/(commit log)

2026-10-15 Add interactive 3D model section to README
    Added a section for an interactive 3D model exploring forward kinematics.
2026-10-15 Remove image link from README.md
    Removed the image link for the arm forward kinematics in Desmos.
2026-10-15 Reorganize repo and update READMEs
    - Move everything from PETFAB-Armadillo/ to the repo root so the main
    README's paths work; keep one README and one requirements.txt
    - Fix stale info in the main README (Lessons 1-5 included, BOM available,
    machined aluminum plates), add an actuator ID setup step, and list every
    script in Code/
    - Add READMEs for the Curriculum folder, Lessons 1-5 and the BOM, keeping
    the Desmos links in Lessons 3 and 4
    - Remove the duplicate assembly PDF in Lesson 2 and the Lesson 5 code zip
    (same scripts as Code/); lesson READMEs link to the originals instead
    - Drop "Updated_" and "(1)" from filenames and name lesson plans
    consistently ("Lesson Plan N - Title")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
2026-10-16 Assembly instructions: white backgrounds
    Replace the dark gray slides with white ones in the PowerPoint and PDF.
    The gray backgrounds baked into every CAD image are whitened too, the
    green text is darkened one shade so it stays readable on white, and the
    text on slides 34, 35 and 62 no longer sits under the images.
    Claude-Session: https://claude.ai/code/session_01PhX7iZ5z4ge4VQYuYbMAnE
2026-10-16 Add photo gallery, drop Lessons 11-12
    - Add a Photos/ gallery: stills of the built arm and prototypes, CAD
    renders, the exploded view, and the YOLOv8 detection screenshot
    - Add a Gallery section to the main README and the Desmos screenshot to
    the Lesson 3 README
    - Remove Lessons 11 and 12 (and the capstone challenge) from both READMEs
    and the course overview; the course is now 10 lessons
    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
2026-10-16 Tidy the photo layout and give the main image a white background
    - Rebuild every photo and render as an even 3:2 tile on white, with each
    CAD view on its own tile and the exploded view without its slide title
    - Lay out the Photos page and the main README gallery two images per row
    with a caption under each pair, replacing the uneven tables
    - Replace the main README's first image with a white-background version,
    stored in Photos/ instead of as an attachment
    - Add a depth-map image next to the object-detection screenshot
    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
2026-10-19 Update README with video links for arm demos
    Added links to video assets for various arm prototypes, enhancing documentation.
2026-10-29 Update Lesson 5 to the new code lesson
    Replace the old Lesson 5 scripts (DH matrices with NumPy, screw theory)
    with the new step-by-step Python files: arm_starter.py, arm.py,
    reach_sweep.py, reach_plot.py and ticks_demo.py. Rewrite the Lesson 5
    README to match the new lesson, and update the code tables in the main
    README and the Lesson 5 row in the curriculum README.
    Claude-Session: https://claude.ai/code/session_01MLFYEPar84CHHqK75rMbXG
2026-10-29 Update the Lesson 4 and 5 course descriptions
    Describe Lesson 4 as forward kinematics with vectors and the DH angle
    convention (no matrices) and Lesson 5 as coding forward kinematics one
    function at a time, in both the Curriculum README and the course
    overview document.
    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
2026-10-29 Replace the Lesson 6 and 7 plans and slides with the new versions
    Remove the old Lesson 6 and 7 PDFs and add the new lesson plans (PDF
    and Word) and slides (PDF and PowerPoint). Write READMEs for both
    lessons, add the Lesson 6 inverse kinematics Desmos graph with a
    screenshot, link Lessons 6 and 7 from the course tables, and mark
    Lessons 1-7 as ready.
    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
2026-10-29 Add Lessons 9 and 10 and swap their order
    Lesson 9 is now AI Object Detection and Lesson 10 is Stereoscopic
    Camera, so detection finds the target and stereo adds the distance.
    - Lesson 9 and 10 folders: lesson plans (PDF and Word), slides (PDF and
    PowerPoint) and READMEs
    - Code: the Lesson 9 detection helper and pipeline script, and the
    Lesson 10 stereo helper, depth check, calibration and target scripts.
    disparity_map now searches up to 160 px, so it sees down to ~263 mm
    - Course tables in both READMEs and the Overview docx list the new
    order and link the two lessons
    Claude-Session: https://claude.ai/code/session_01MLFYEPar84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
2026-10-29 Add Lesson 8: Code Implementation of IK
    Add the Lesson 8 lesson plan and slides (35 slides), a README, and the
    code (ik_starter.py, ik.py, check_ik.py, jacobian_preview.py). Mark
    Lesson 8 as included in the course tables, link it from Lessons 7 and 9,
    and update its row in the course overview. Point the README, BOM and CAD
    pages at the CAD folder now that the 3D Printing Files folder is gone.
2026-11-03 Change image source for robotic arm in README
    Updated image source in README to a local file.
2026-11-03 Change robotic arm image in README
    Updated image source for the robotic arm in README.
